TheSchilk/psMCU/README.md

# psMCU
### Philipp Schilk, 2020-2021

An 8-bit, 1MHz processor built from individual logic gates, featuring a
custom ISA and assembler.
