TheSchilk/psMCU/DevUtils/SyntaxHighlighting/Notepad++/INSTALLATION.md

# Installation
In Notepad++: Language->Define your own language...->Import
