TheSchilk/psMCU/DevUtils/SyntaxHighlighting/vim/INSTALLATION.md

# Installation
Place 'psasm.vim' from syntax/ in ~/.vim/syntax/
Place 'psasm.vim' from ftdetect/ in ~/.vim/ftdetect
