TheSchilk/psMCU/Doc/InstructionSet.ods

Mnm. | Brief | 15 | 14 | 13 | 12 | 11 | 10 | 9 | 8 | 7 | 6 | 5 | 4 | 3 | 2 | 1 | 0
JMP | Jump to PC + Offset | 1 | 1 | Adr Ofs.
CALL | Jump PC + Offset and push return to stack | 1 | 0 | Adr Ofs.
IFS | If bit set in memory (else skip) | 0 | 1 | 1 | 1 | Bit |  |  | Adr
IFR | If bit reset in memory (else skip) | 0 | 1 | 1 | 0 | Bit |  |  | Adr
LDA | Load from memory adr to A | 0 | 1 | 0 | 1 | 1 | 1 | 1 | Adr
LDB | Load from memory adr to B | 0 | 1 | 0 | 1 | 1 | 1 | 0 | Adr
LDO | Load from memory adr + B to A | 0 | 1 | 0 | 1 | 1 | 0 | 1 | Adr
SVA | Save A to memory adr | 0 | 1 | 0 | 1 | 1 | 0 | 0 | Adr
SVB | Save B to memory adr | 0 | 1 | 0 | 1 | 0 | 1 | 1 | Adr
SVO | Save A to memory adr + B | 0 | 1 | 0 | 1 | 0 | 1 | 0 | Adr
GROW | Grow stack | 0 | 1 | 0 | 1 | 0 | 0 | 1 | Adr
SHRINK | Shrink stack | 0 | 1 | 0 | 1 | 0 | 0 | 0 | Adr
STLA | Load to A from stack with offset | 0 | 1 | 0 | 0 | 1 | 1 | 1 | Adr
STLB | Load to B from stack with offset | 0 | 1 | 0 | 0 | 1 | 1 | 0 | Adr
STLO | Load to A from stack with offset + B | 0 | 1 | 0 | 0 | 1 | 0 | 1 | Adr
STSA | Save A to stack with offset | 0 | 1 | 0 | 0 | 1 | 0 | 0 | Adr
STSB | Save B to stack with offset | 0 | 1 | 0 | 0 | 0 | 1 | 1 | Adr
STSO | Save A to stack with offset + B | 0 | 1 | 0 | 0 | 0 | 1 | 0 | Adr
SHFTL(L) | Shift A left by B/literal | 0 | 1 | 0 | 0 | 0 | 0 | 1 | L | Data
SHFTL(L)C | Shift A left by B/literal with carry | 0 | 1 | 0 | 0 | 0 | 0 | 0 | L | Data
SHFTR(L) | Shift A right by B/literal | 0 | 0 | 1 | 1 | 1 | 1 | 1 | L | Data
SHFTR(L)C | Shift A right by B/literal with carry | 0 | 0 | 1 | 1 | 1 | 1 | 0 | L | Data
ADD(L) | Add B/literal to A | 0 | 0 | 1 | 1 | 1 | 0 | 1 | L | Data
ADD(L)C | Add B/literal to A with carry | 0 | 0 | 1 | 1 | 1 | 0 | 0 | L | Data
AND(L) | AND B/literal to A | 0 | 0 | 1 | 1 | 0 | 1 | 1 | L | Data
OR(L) | OR B/literal to A | 0 | 0 | 1 | 1 | 0 | 1 | 0 | L | Data
XOR(L) | XOR B/literal to A | 0 | 0 | 1 | 1 | 0 | 0 | 1 | L | Data
ADDLA | Add literal to A | 0 | 0 | 1 | 1 | 0 | 0 | 0 | 1 | Data
ADDLAC | Add literal to A with carry | 0 | 0 | 1 | 1 | 0 | 0 | 0 | 0 | Data
ADDLB | Add literal to B | 0 | 0 | 1 | 0 | 1 | 1 | 1 | 1 | Data
ADDLBC | Add literal to B with carry | 0 | 0 | 1 | 0 | 1 | 1 | 1 | 0 | Data
SUB | Subtract B from A | 0 | 0 | 1 | 0 | 1 | 1 | 0 | 1 | Data
SUBC | Subtract B from A with carry | 0 | 0 | 1 | 0 | 1 | 1 | 0 | 0 | Data
LITA | Load literal to A | 0 | 0 | 1 | 0 | 1 | 0 | 1 | 1 | Data
LITB | Load literal to B | 0 | 0 | 1 | 0 | 1 | 0 | 1 | 0 | Data
DATA5 | Load 5 data bytes to stack | 0 | 0 | 1 | 0 | 1 | 0 | 0 | 1 | Data
DATA4 | Load 4 data bytes to stack | 0 | 0 | 1 | 0 | 1 | 0 | 0 | Adr
GROWO | Grow stack by Adr + B | 0 | 0 | 1 | 0 | 0 | 1 | 1 | Adr
SHRINKO | Shrink stack by Adr + B | 0 | 0 | 1 | 0 | 0 | 1 | 0 | Adr
(Unused: NOP) |  | 0 | 0 | 1 | 0 | 0 | 0 | 1 | 1 | x | x | x | x | x | x | x | x
MULT | Calculate A*B, store in A (LSB) and B (MSB) | 0 | 0 | 1 | 0 | 0 | 0 | 1 | 0 | x | x | x | x | x | x | x | x
COMPA | Two's complement A | 0 | 0 | 1 | 0 | 0 | 0 | 0 | 1 | x | x | x | x | x | x | x | x
COMPAC | Two's complement A with carry | 0 | 0 | 1 | 0 | 0 | 0 | 0 | 0 | x | x | x | x | x | x | x | x
IFSA | If bit set in A (else skip) | 0 | 0 | 0 | 1 | Bit |  |  | 1 | x | x | x | x | x | x | x | x
IFRA | If bit reset in A (else skip) | 0 | 0 | 0 | 1 | Bit |  |  | 0 | x | x | x | x | x | x | x | x
COMPB | Two's complement B | 0 | 0 | 0 | 0 | 1 | 1 | 1 | 1 | x | x | x | x | x | x | x | x
COMPBC | Two's complement B with carry | 0 | 0 | 0 | 0 | 1 | 1 | 1 | 0 | x | x | x | x | x | x | x | x
NOTA | Invert A | 0 | 0 | 0 | 0 | 1 | 1 | 0 | 1 | x | x | x | x | x | x | x | x
NOTB | Invert B | 0 | 0 | 0 | 0 | 1 | 1 | 0 | 0 | x | x | x | x | x | x | x | x
POPA | Pop from stack to A | 0 | 0 | 0 | 0 | 1 | 0 | 1 | 1 | x | x | x | x | x | x | x | x
POPB | Pop from stack to B | 0 | 0 | 0 | 0 | 1 | 0 | 1 | 0 | x | x | x | x | x | x | x | x
PUSHA | Push A to stack | 0 | 0 | 0 | 0 | 1 | 0 | 0 | 1 | x | x | x | x | x | x | x | x
PUSHB | Push B to stack | 0 | 0 | 0 | 0 | 1 | 0 | 0 | 0 | x | x | x | x | x | x | x | x
SWP | Swap A and B | 0 | 0 | 0 | 0 | 0 | 1 | 1 | 1 | x | x | x | x | x | x | x | x
CPYA | Copy A to B | 0 | 0 | 0 | 0 | 0 | 1 | 1 | 0 | x | x | x | x | x | x | x | x
CPYB | Copy B to A | 0 | 0 | 0 | 0 | 0 | 1 | 0 | 1 | x | x | x | x | x | x | x | x
INTRPT | Trigger an interrupt | 0 | 0 | 0 | 0 | 0 | 1 | 0 | 0 | x | x | x | x | x | x | x | x
RTRNI | Return from interrupt | 0 | 0 | 0 | 0 | 0 | 0 | 1 | 1 | x | x | x | x | x | x | x | x
RTRN | Return from call | 0 | 0 | 0 | 0 | 0 | 0 | 1 | 0 | x | x | x | x | x | x | x | x
HALT | Halt exectuion | 0 | 0 | 0 | 0 | 0 | 0 | 0 | 1 | x | x | x | x | x | x | x | x
NOP | No operation | 0 | 0 | 0 | 0 | 0 | 0 | 0 | 0 | x | x | x | x | x | x | x | x
Fixed Connections:
ROM Adr. Offset |  |  |  | Adr
RAM Adr |  |  |  |  |  |  |  |  | Adr
Literal |  |  |  |  |  |  |  |  |  | Data
ROM Data |  | Data |  |  |  |  |  |  |  | Data
Conditional |  |  |  |  |  | Bit
