TheSchilk/psMCU/ECAD/periph_8x8leds/schematic_periph_8x8leds.pdf

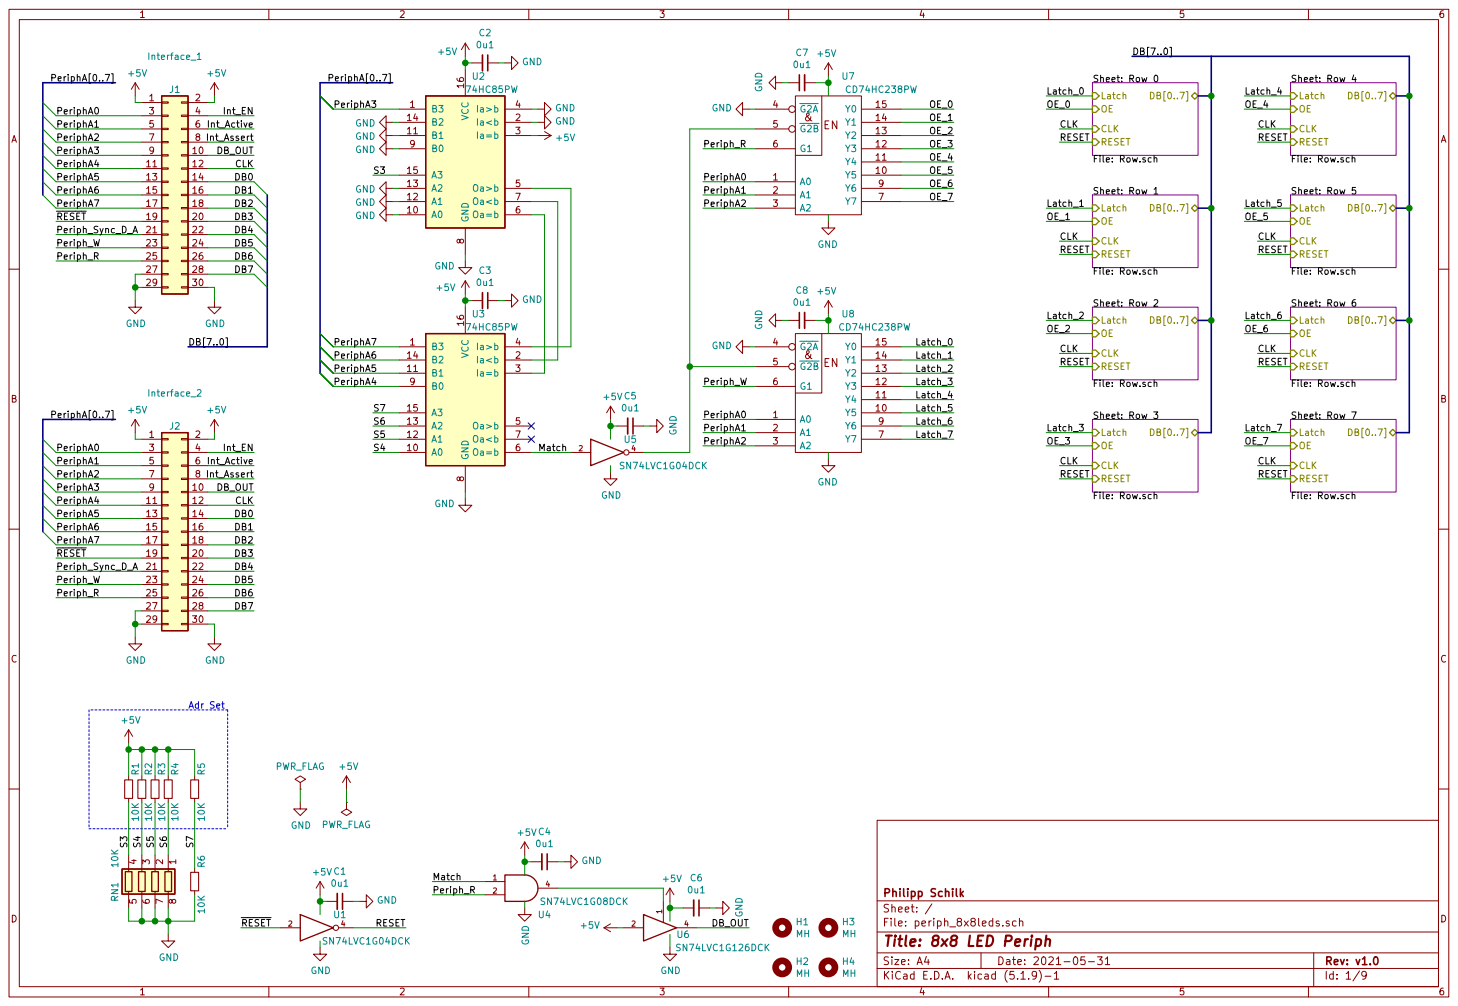
[picture p1: page 1]

Sheet: Row 0 File: Row.sch OE

Sheet: Row 4 File: Row.sch OE

Sheet: Row 1 File: Row.sch OE

Sheet: Row 5 File: Row.sch OE

Sheet: Row 2 File: Row.sch OE

Sheet: Row 6 File: Row.sch OE

Sheet: Row 3 File: Row.sch OE

Sheet: Row 7 File: Row.sch OE

File: periph_8x8leds.sch Sheet: / Philipp Schilk

Id: 1/9 Title: 8x8 LED Periph

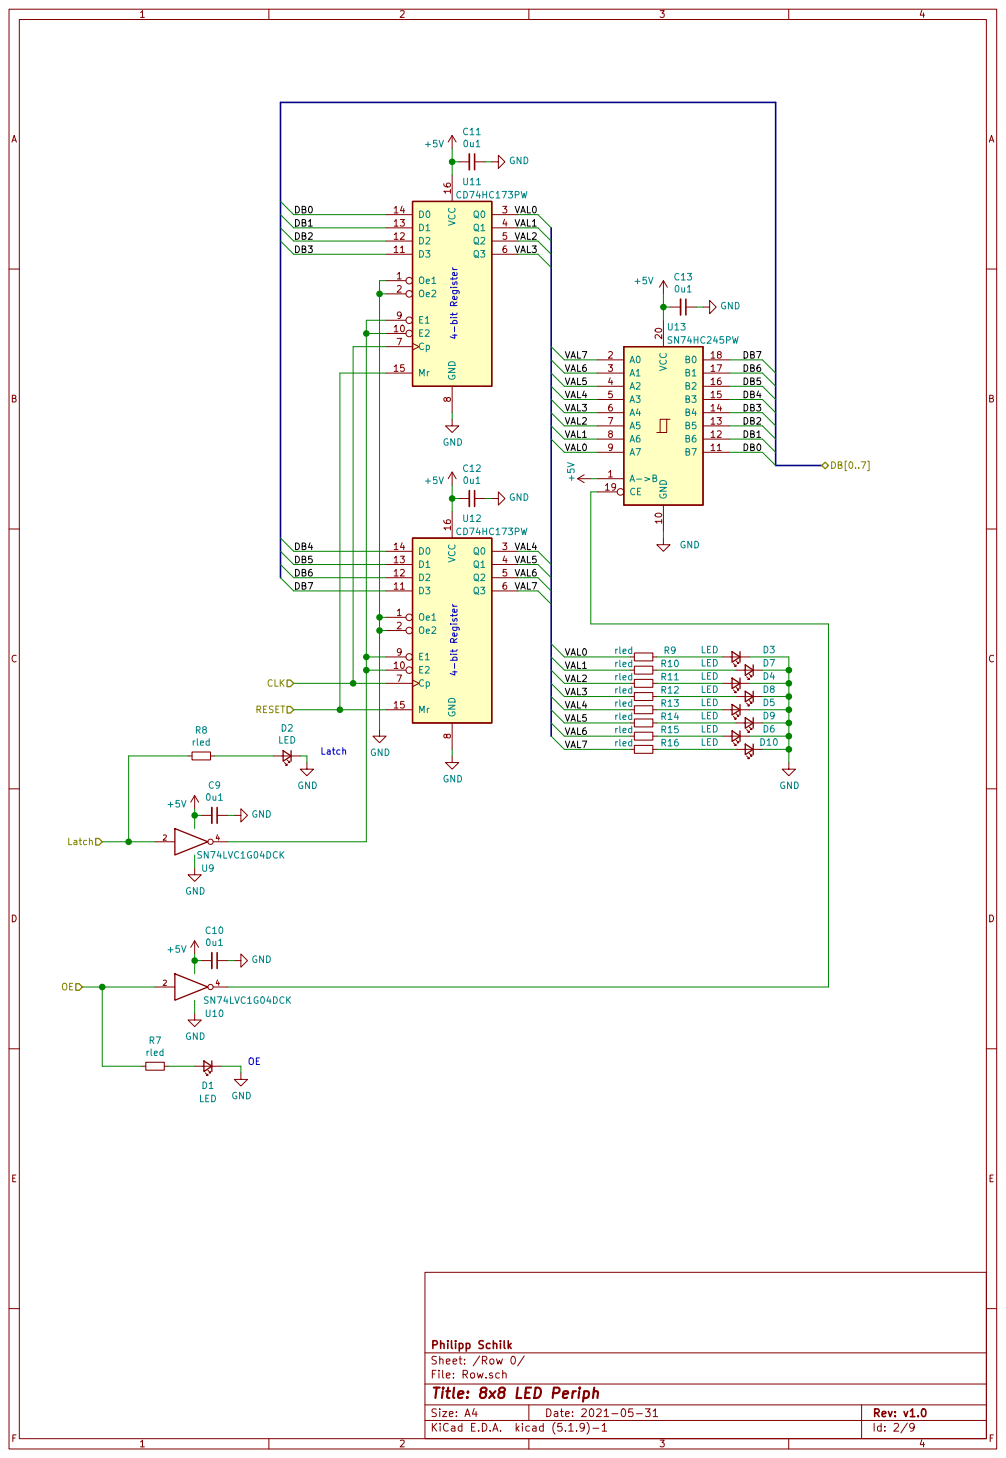
[picture p2: page 2]

File: Row.sch Sheet: /Row 0/ Philipp Schilk

Id: 2/9 Title: 8x8 LED Periph

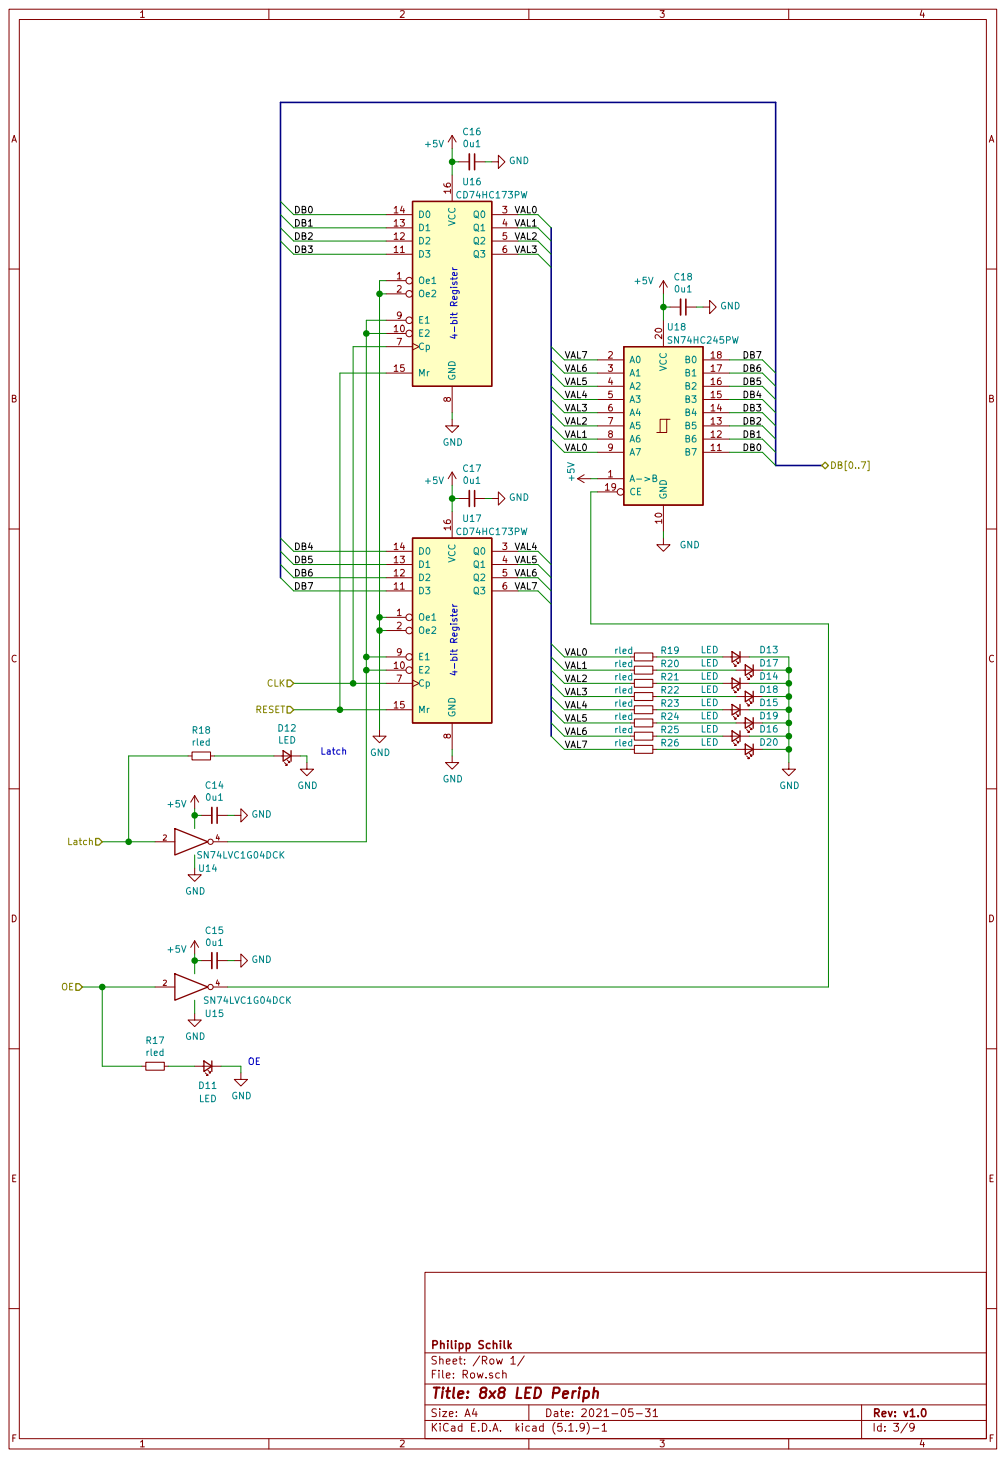
[picture p3: page 3]

File: Row.sch Sheet: /Row 1/ Philipp Schilk

Id: 3/9 Title: 8x8 LED Periph

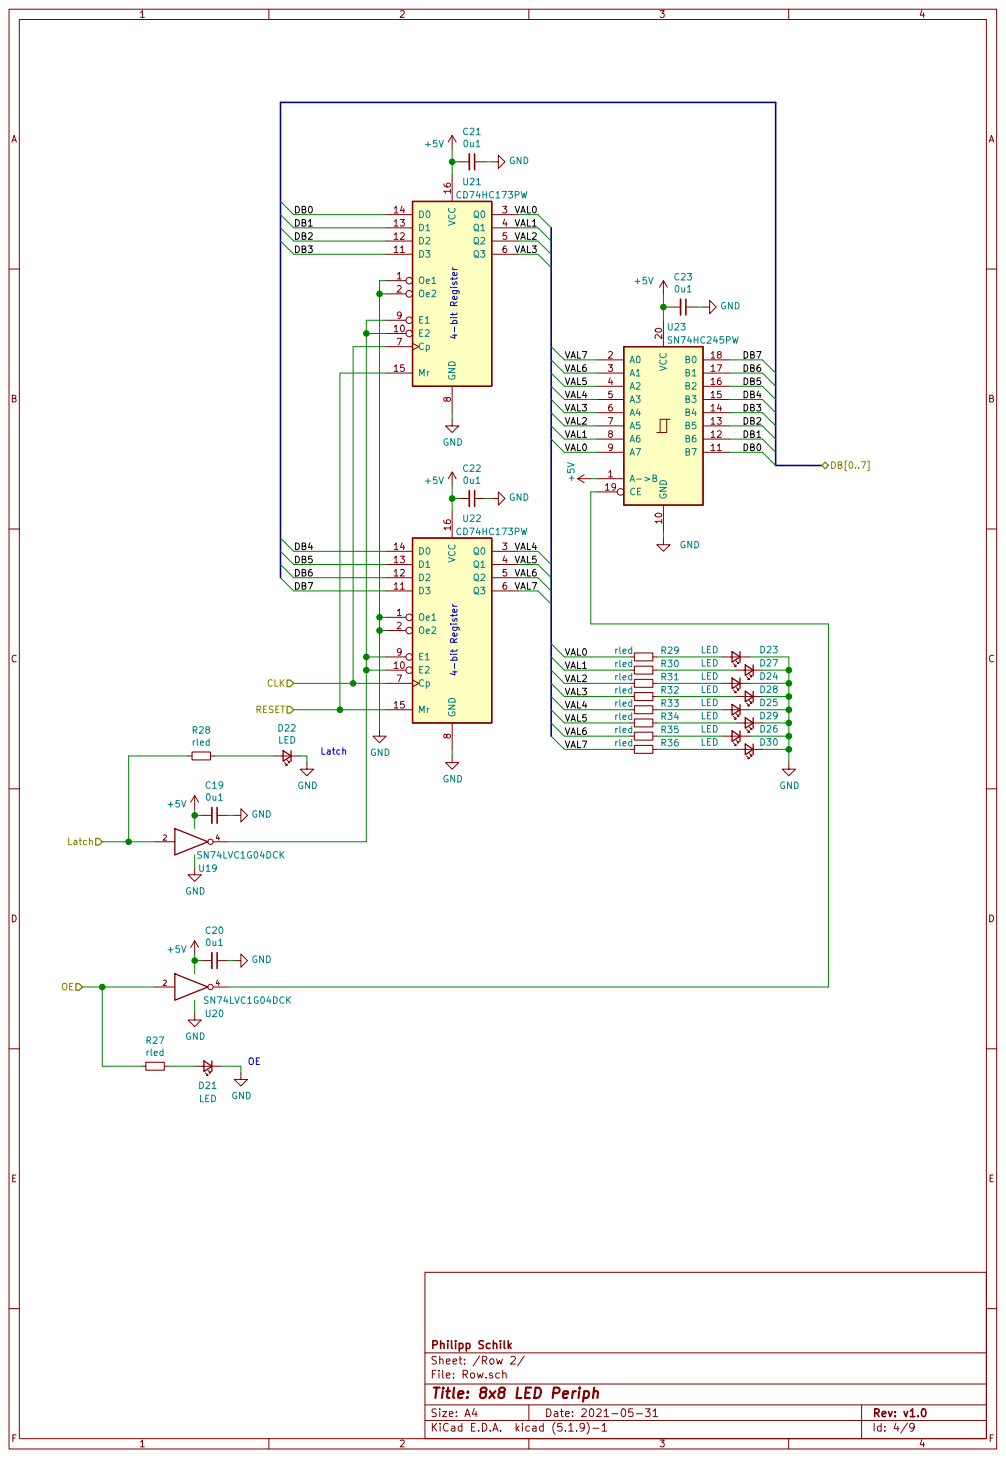
[picture p4: page 4]

File: Row.sch Sheet: /Row 2/ Philipp Schilk

Id: 4/9 Title: 8x8 LED Periph

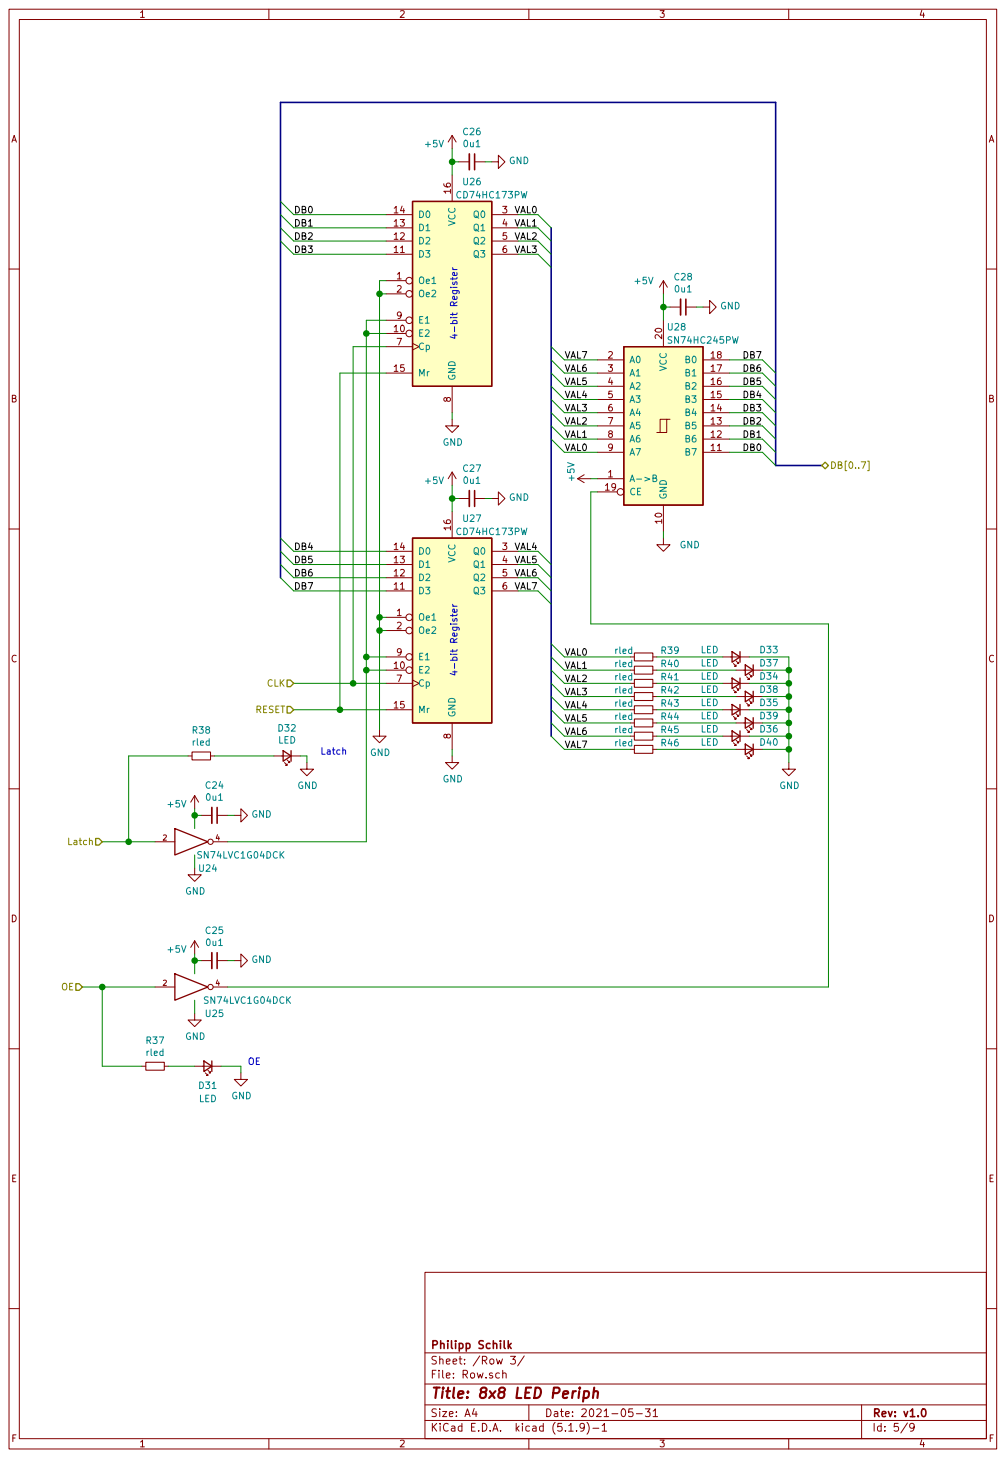
[picture p5: page 5]

File: Row.sch Sheet: /Row 3/ Philipp Schilk

Id: 5/9 Title: 8x8 LED Periph

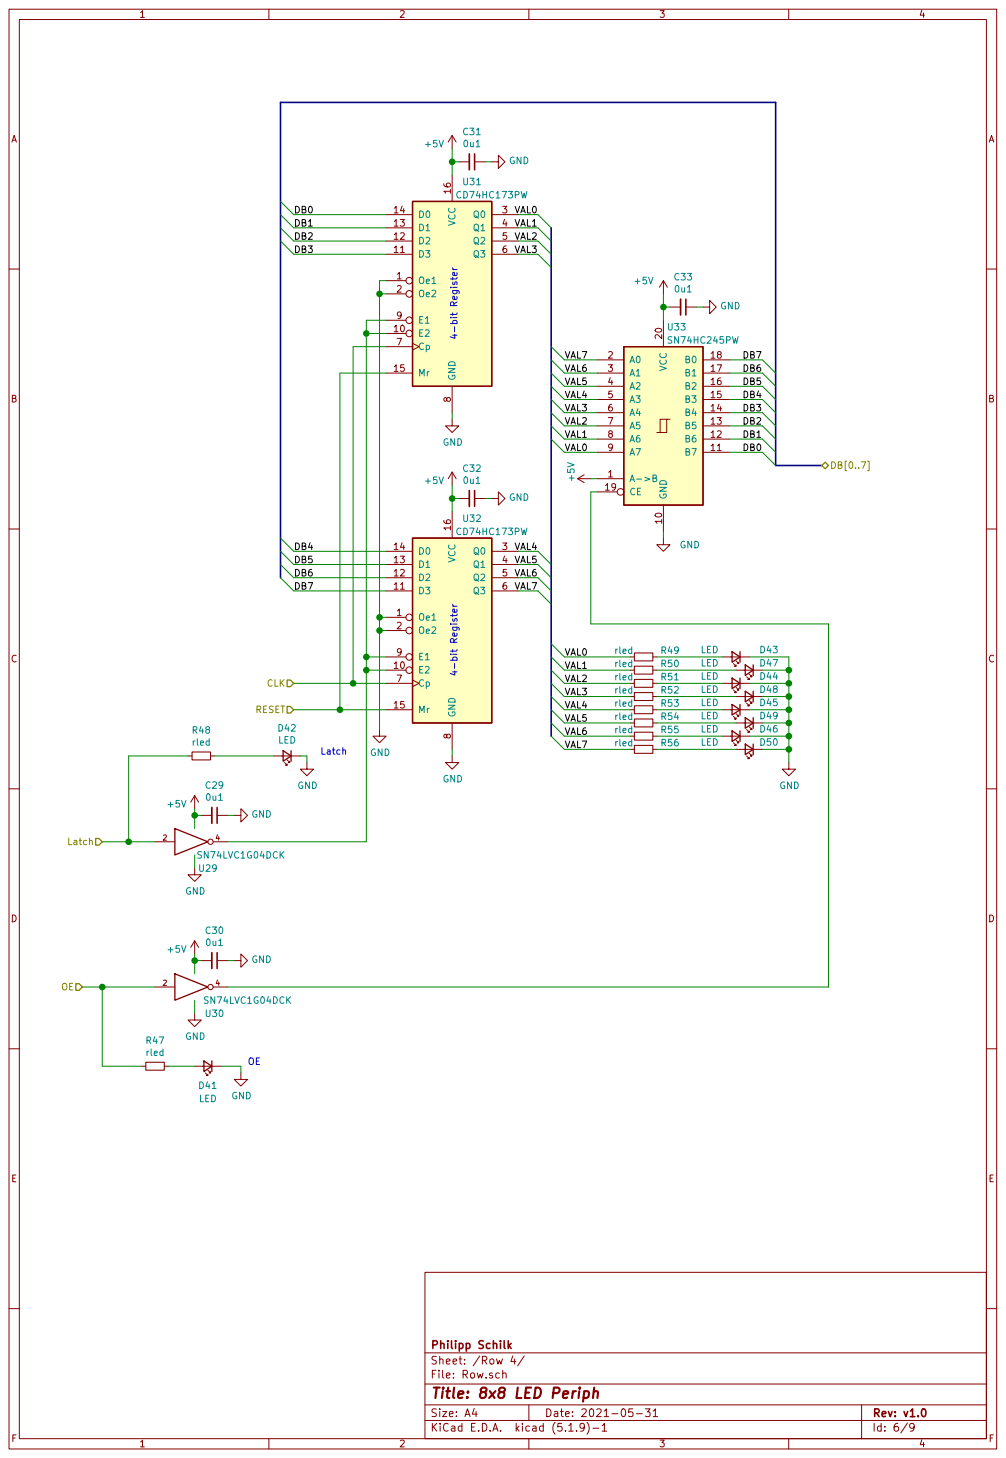
[picture p6: page 6]

File: Row.sch Sheet: /Row 4/ Philipp Schilk

Id: 6/9 Title: 8x8 LED Periph

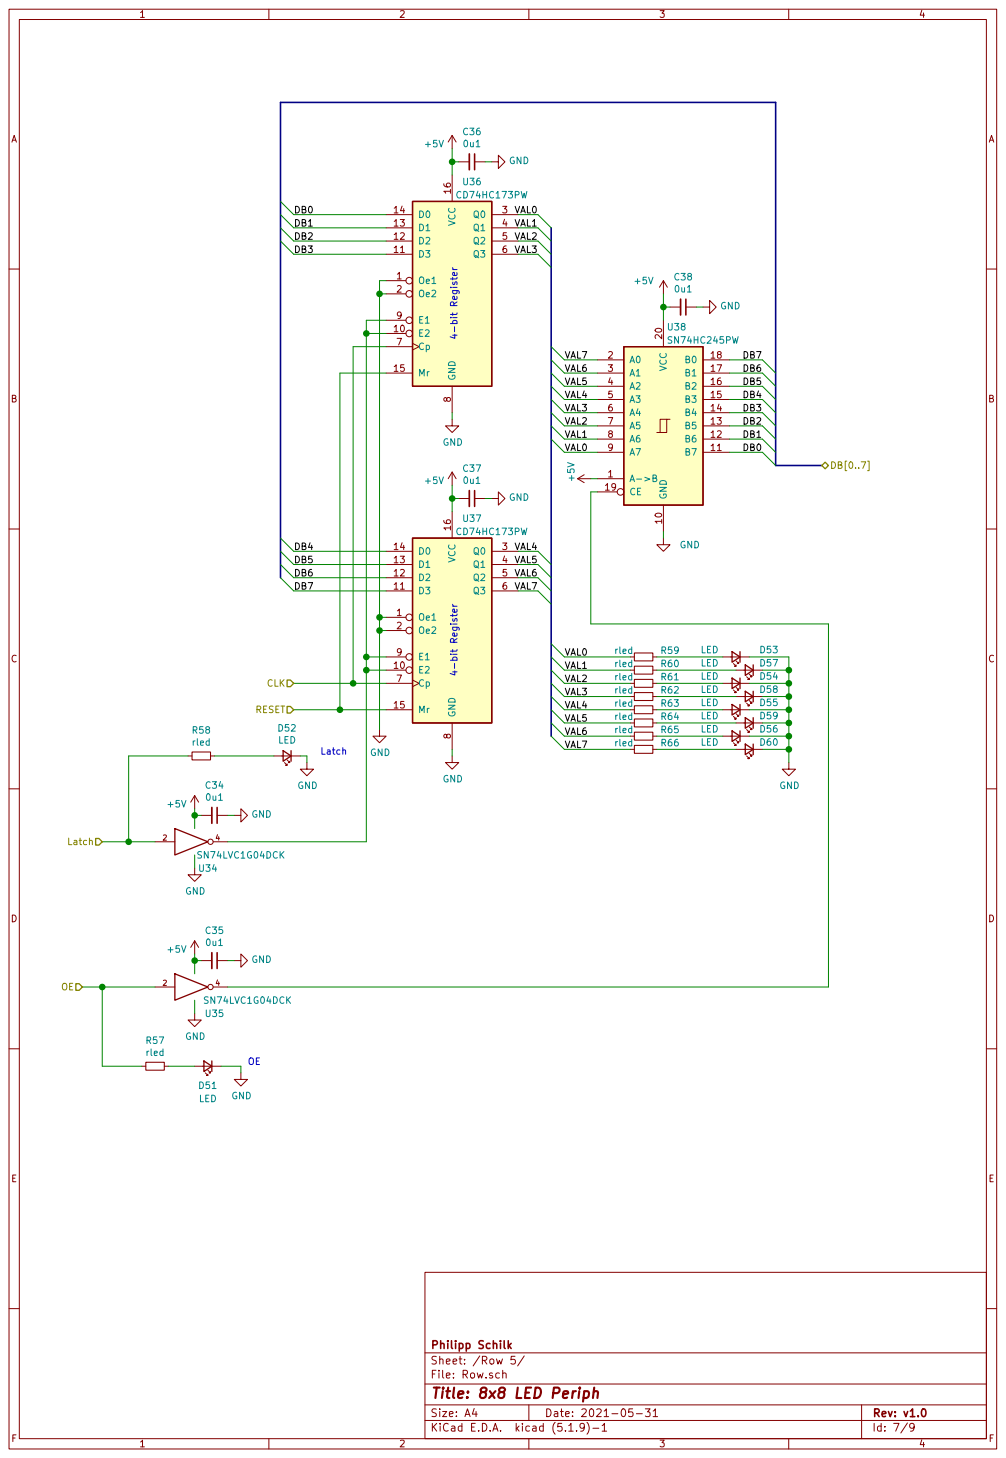
[picture p7: page 7]

File: Row.sch Sheet: /Row 5/ Philipp Schilk

Id: 7/9 Title: 8x8 LED Periph

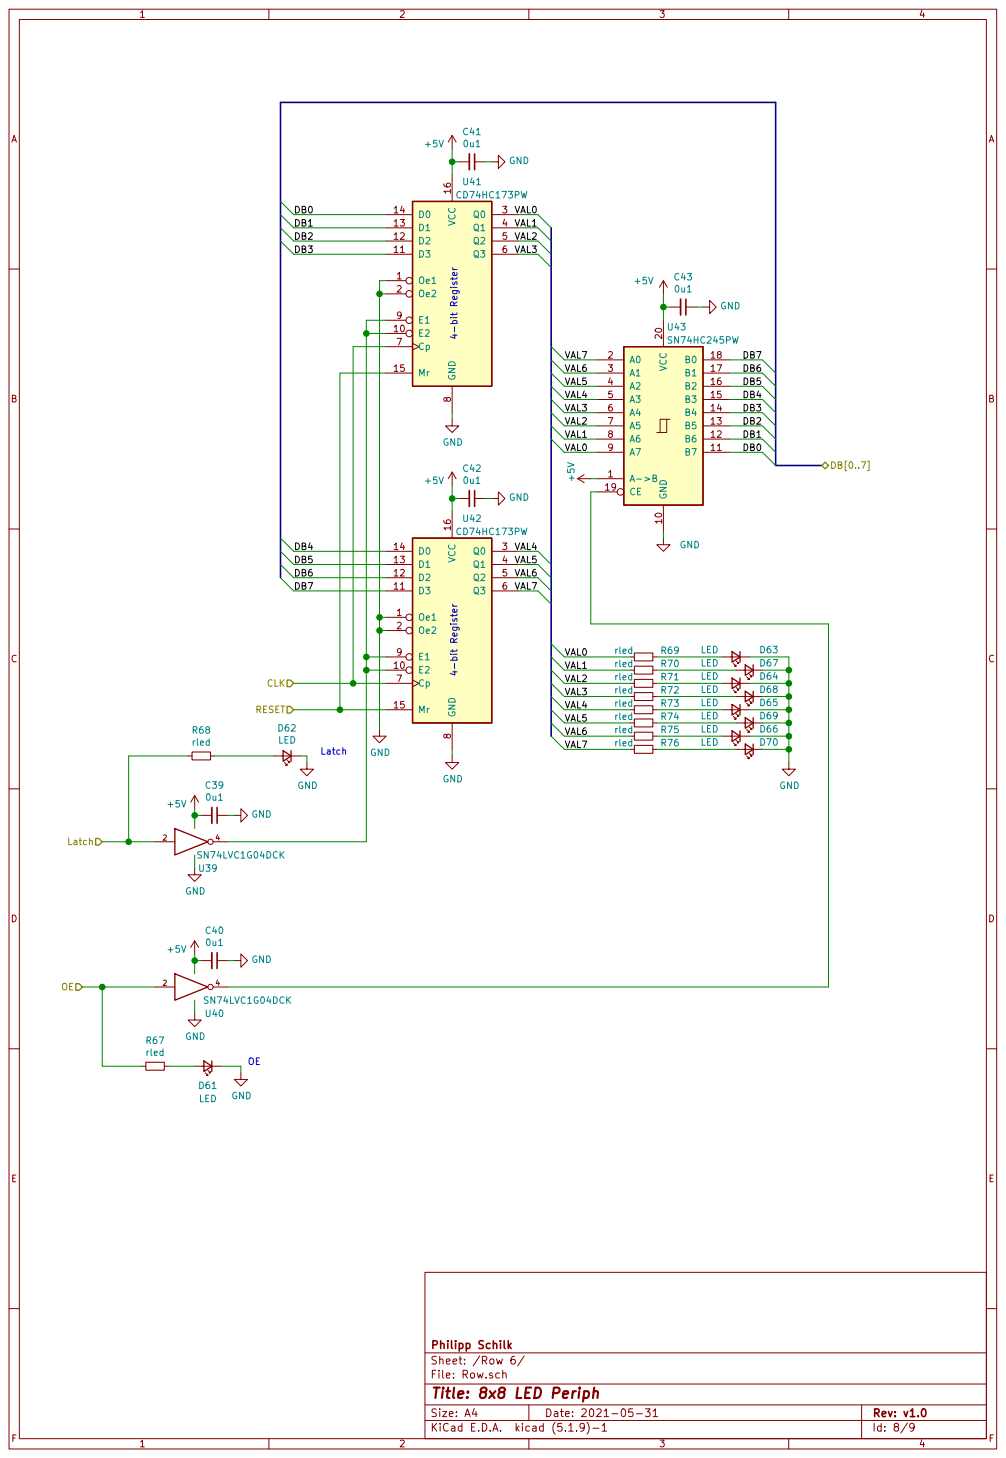
[picture p8: page 8]

File: Row.sch Sheet: /Row 6/ Philipp Schilk

Id: 8/9 Title: 8x8 LED Periph

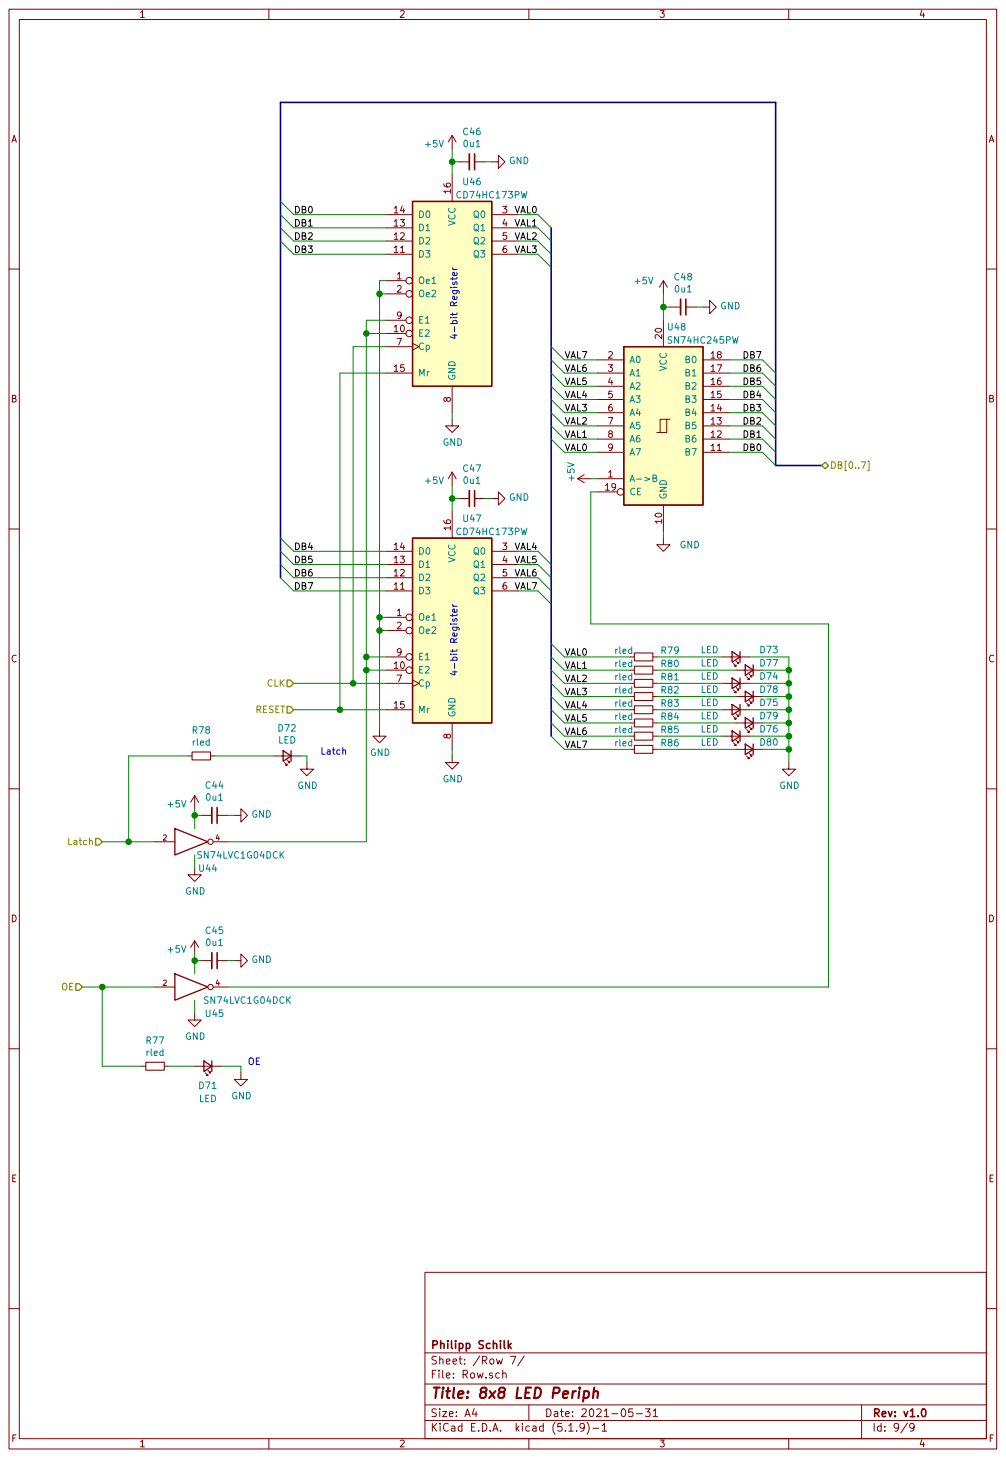
[picture p9: page 9]

File: Row.sch Sheet: /Row 7/ Philipp Schilk

Id: 9/9 Title: 8x8 LED Periph
