TheSchilk/psMCU/ECAD/Programmer/schematic_Programmer.pdf

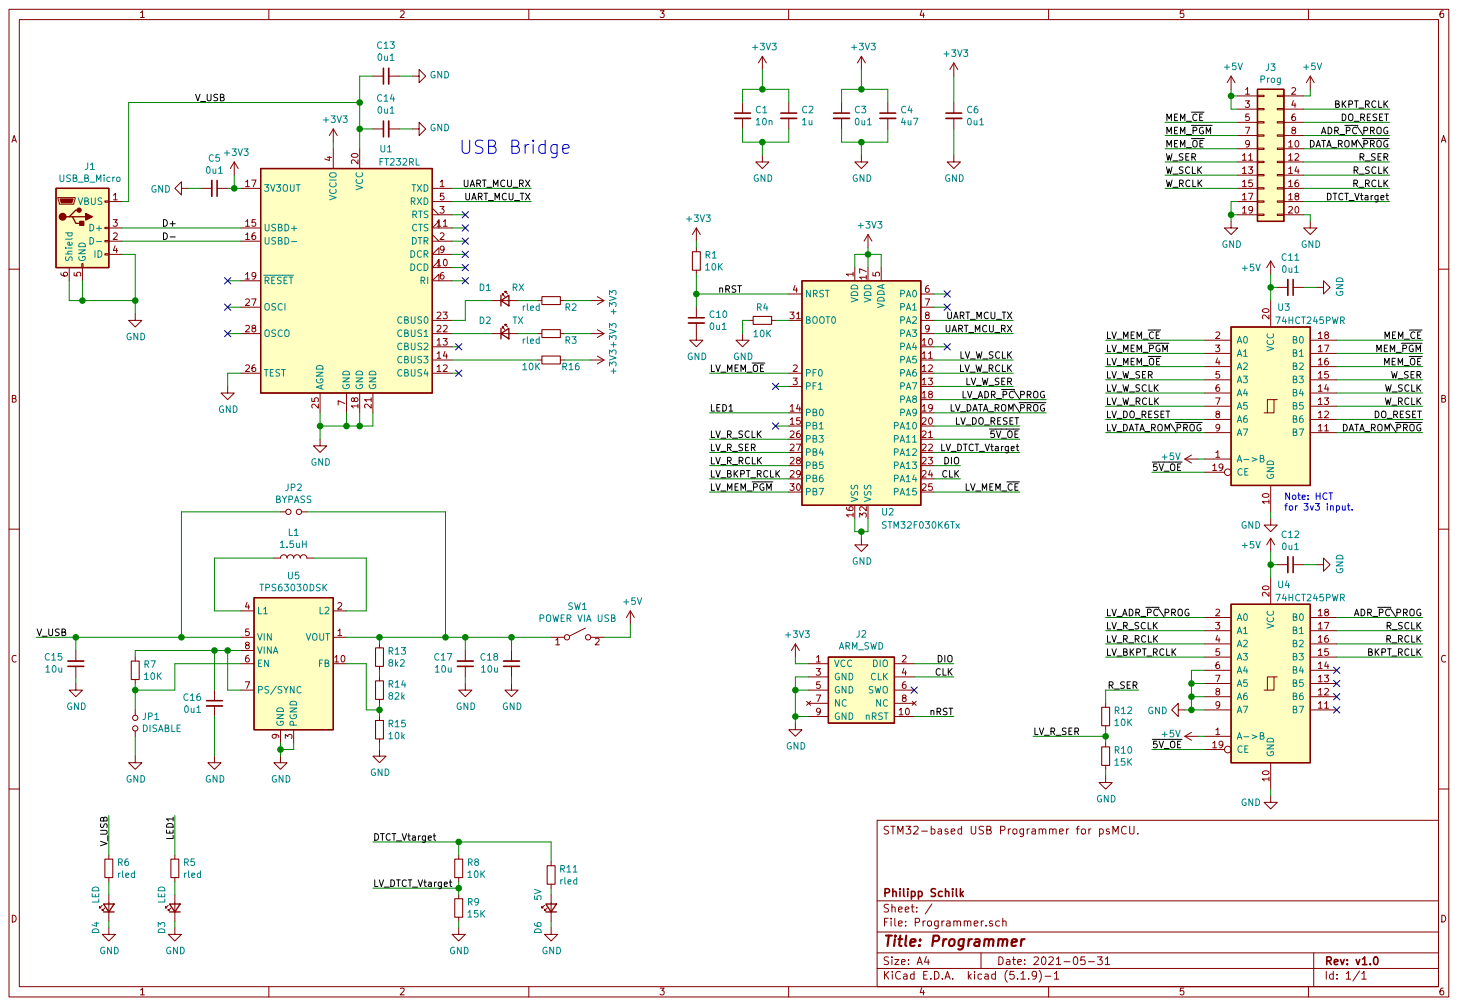
[picture p10: page 1]

1 PA4 10 PA5 11 PA6 12 PA7 13 PB0 14 PB1 15 VSS 16 VDD 17 PA8 18 PA9 19 PF0 2 PA10 20 PA11 21 PA12 22 PA13 23 PA14 24 PA15 25 PB3 26 PB4 27 PB5 28 PB6 29 PF1 3 PB7 30 BOOT0 31 VSS 32 NRST 4 VDDA
CLK UART_MCU_TX UART_MCU_RX

STM32-based USB Programmer for psMCU.

File: Programmer.sch Sheet: / Philipp Schilk
