TheSchilk/psMCU/ECAD/psMCU/schematic_psMCU.pdf

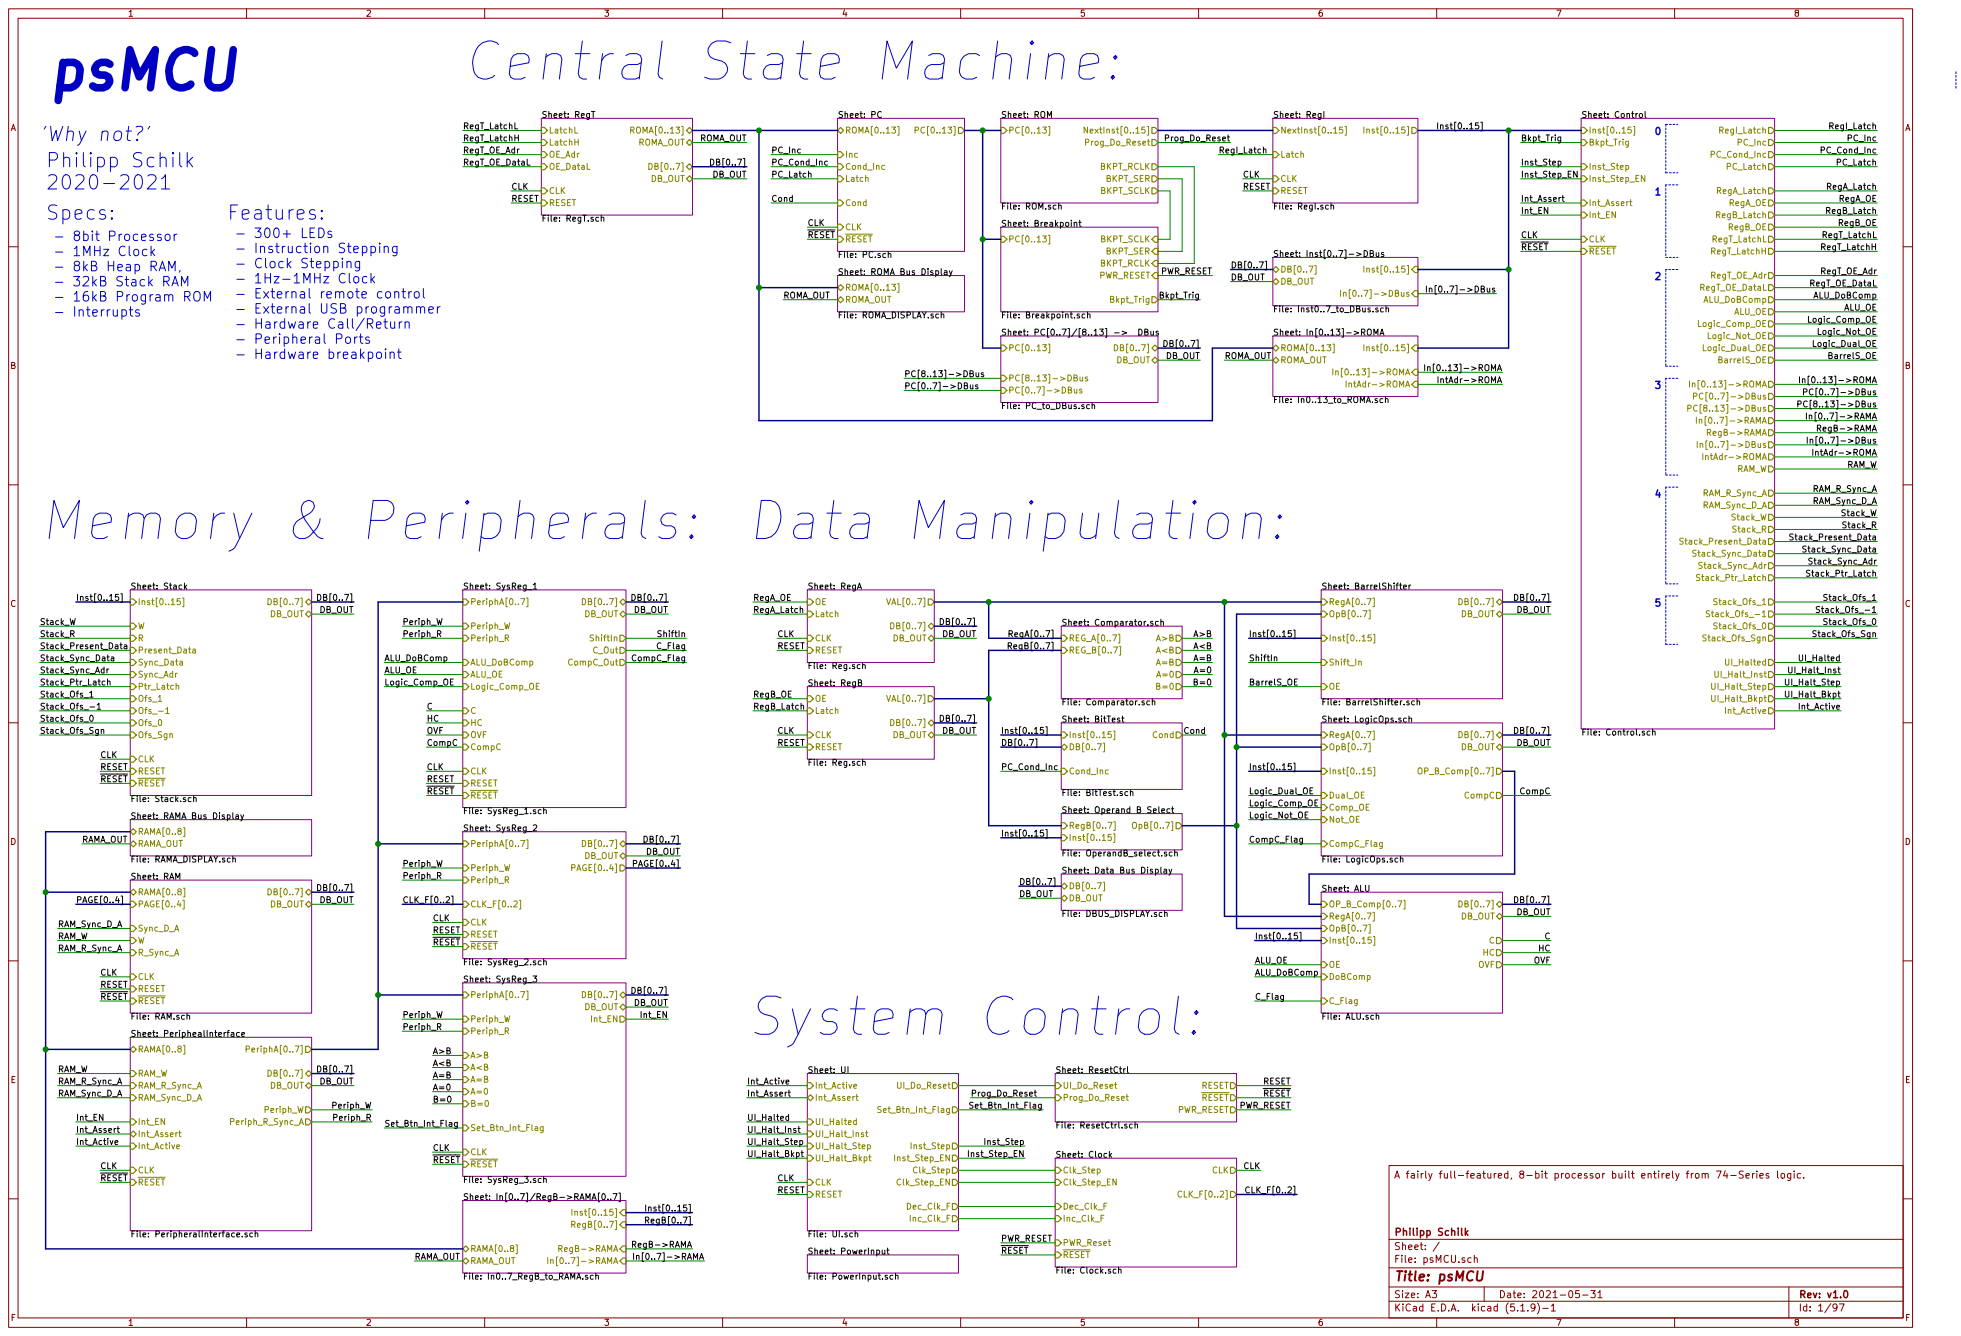
[picture p11: page 1]

Sheet: ROMA Bus Display File: ROMA_DISPLAY.sch ROMA_OUT ROMA[0..13]

File: Breakpoint.sch
Sheet: PC[0..7]/[8..13] -> DBus File: PC_to_DBus.sch PC[0..7]->DBus

PAGE[0..4] RESET PeriphA[0..7] Sheet: RAM

CompC_Flag Sheet: UI File: UI.sch RESET CLK

Inst[0..15]
File: OperandB_select.sch
Sheet: Data Bus Display File: DBUS_DISPLAY.sch DB_OUT DB[0..7]

A fairly full-featured, 8-bit processor built entirely from 74-Series logic.

Sheet: In[0..7]/RegB->RAMA[0..7]

File: psMCU.sch Sheet: / Philipp Schilk

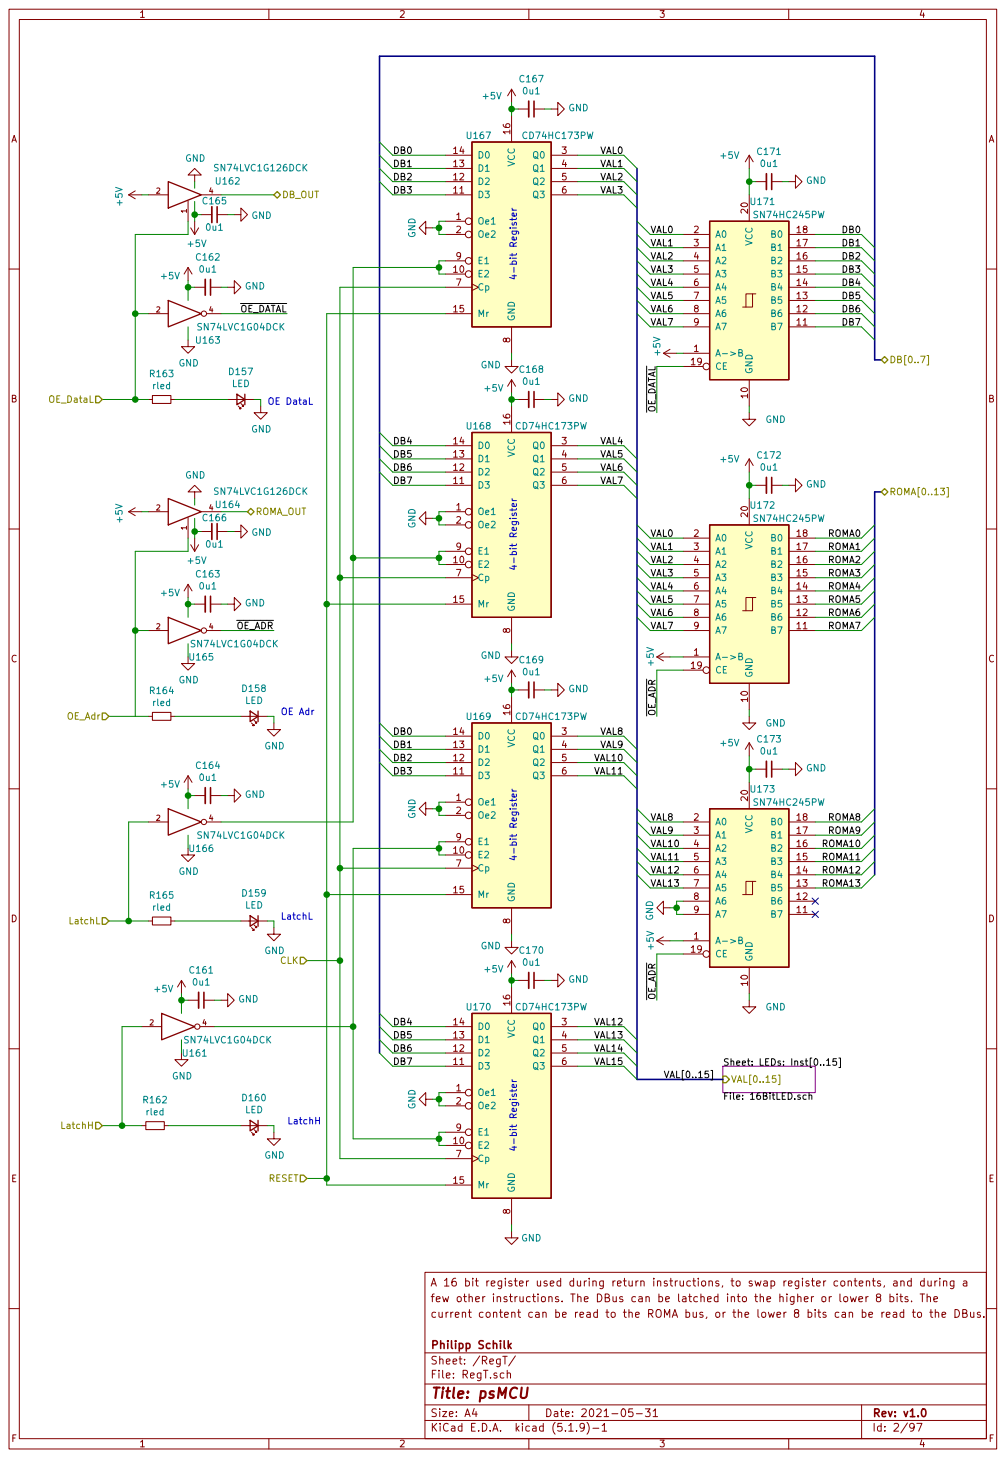
[picture p12: page 2]

Sheet: LEDs: Inst[0..15] File: 16BitLED.sch VAL[0..15] GND

A 16 bit register used during return instructions, to swap register contents, and during a
few other instructions. The DBus can be latched into the higher or lower 8 bits. The
current content can be read to the ROMA bus, or the lower 8 bits can be read to the DBus.

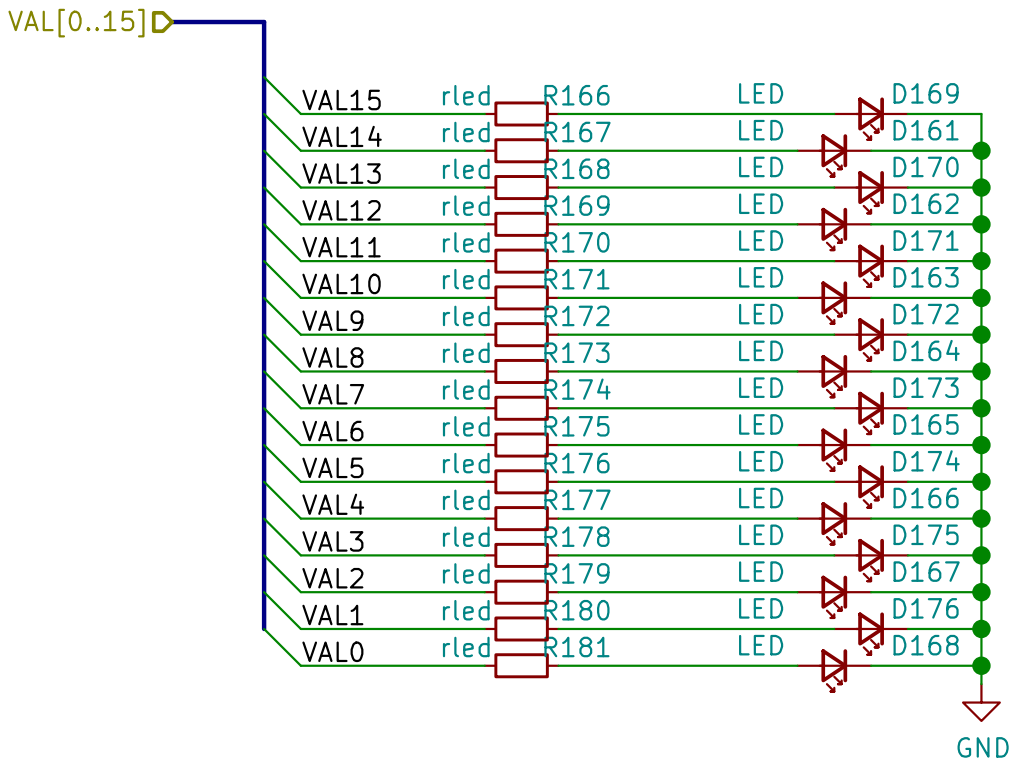
[picture p13: page 3]

Philipp Schilk
File: 16BitLED.sch Sheet: /RegT/LEDs: Inst[0..15]/
Id: 3/97 Title: psMCU

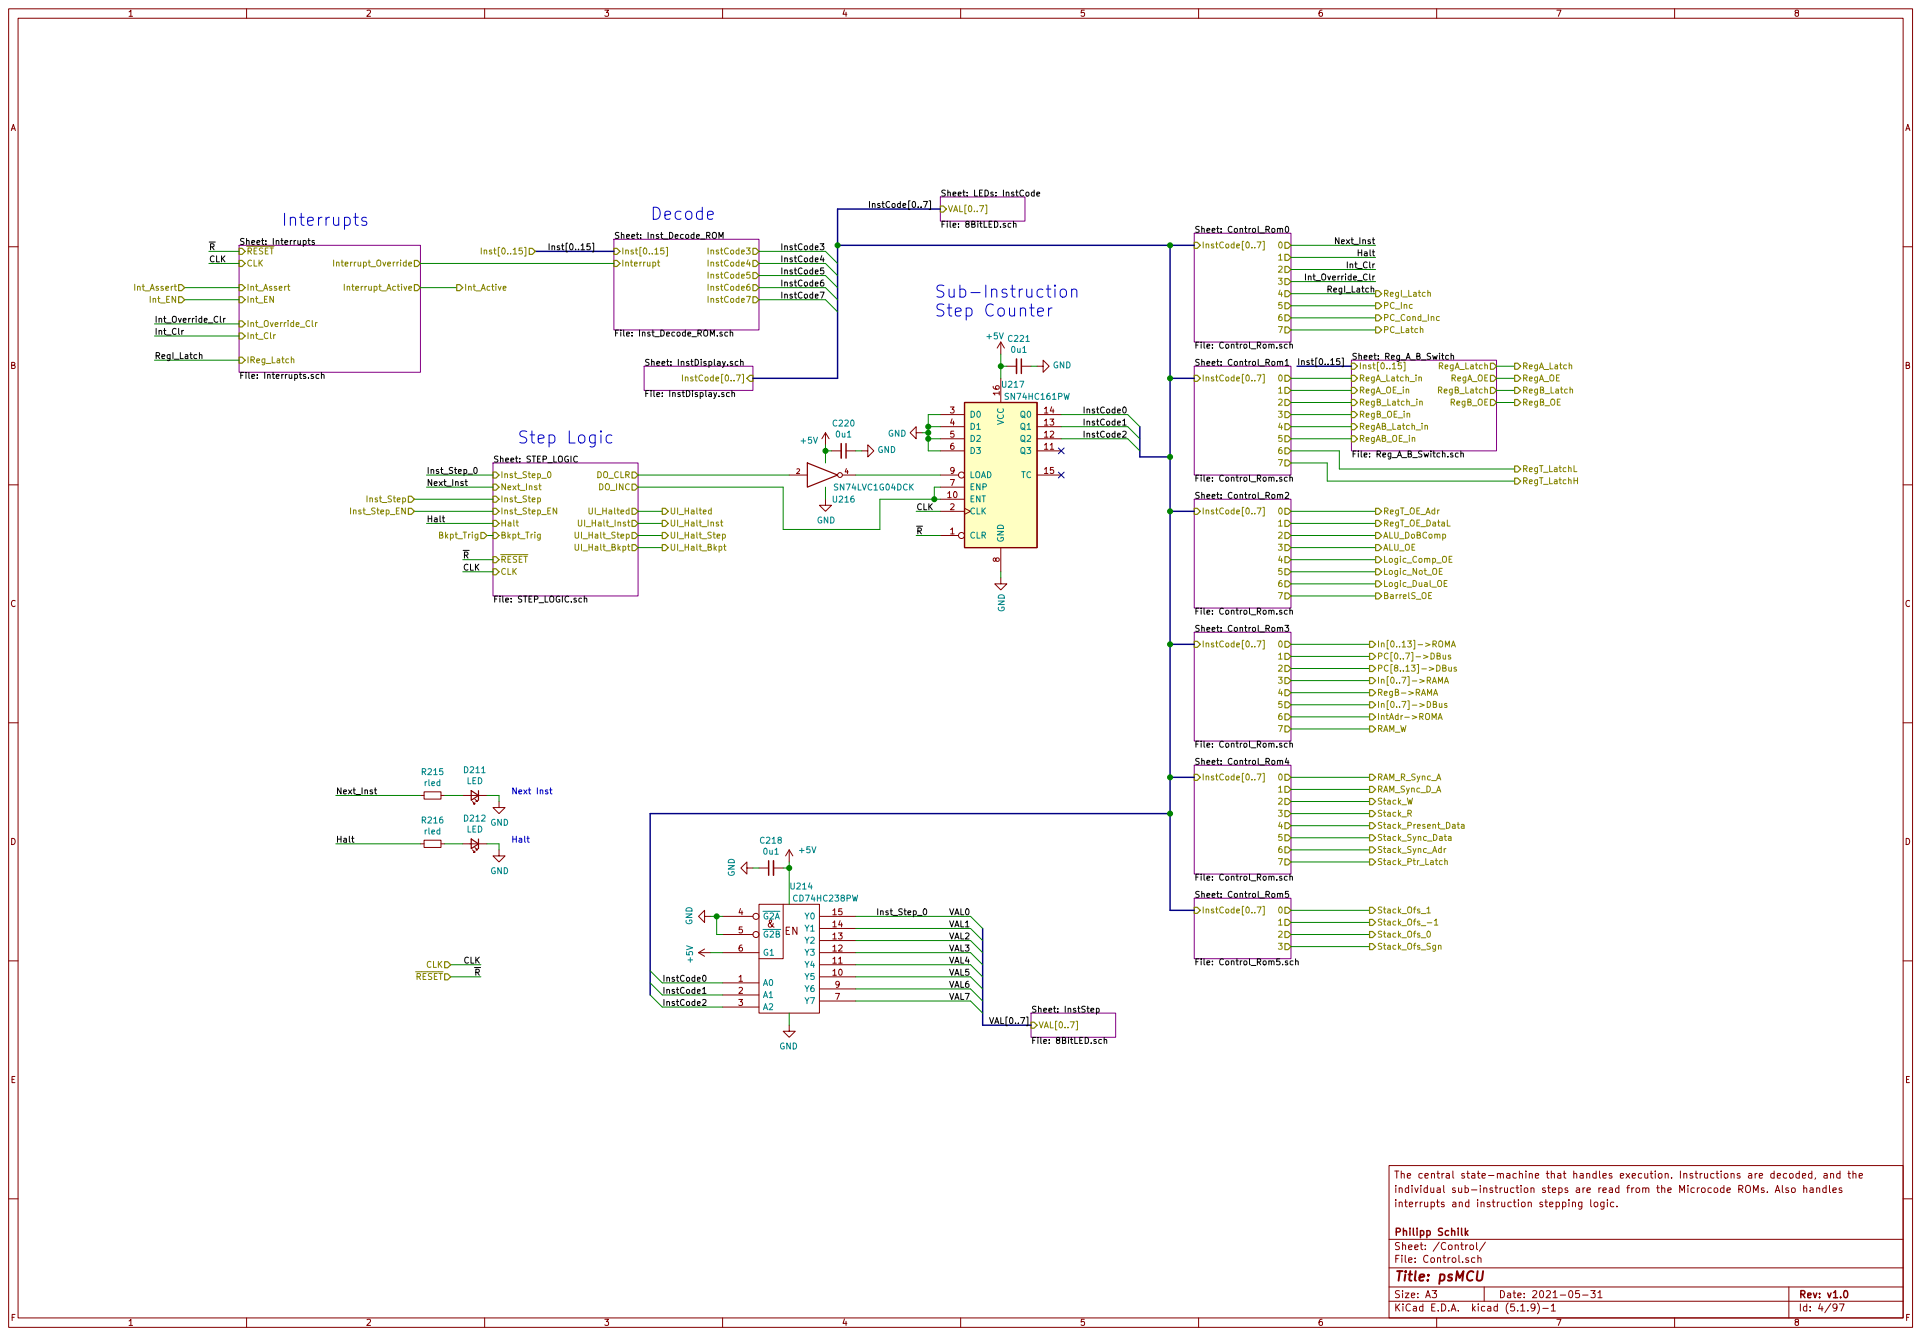
[picture p14: page 4]

In[0..13]->ROMA
PC[0..7]->DBus
PC[8..13]->DBus
In[0..7]->RAMA
IntAdr->ROMA RegB->RAMA
In[0..7]->DBus

Sheet: InstStep File: 8BitLED.sch VAL[0..7]

The central state-machine that handles execution. Instructions are decoded, and the
individual sub-instruction steps are read from the Microcode ROMs. Also handles
interrupts and instruction stepping logic.

File: Control.sch Sheet: /Control/ Philipp Schilk

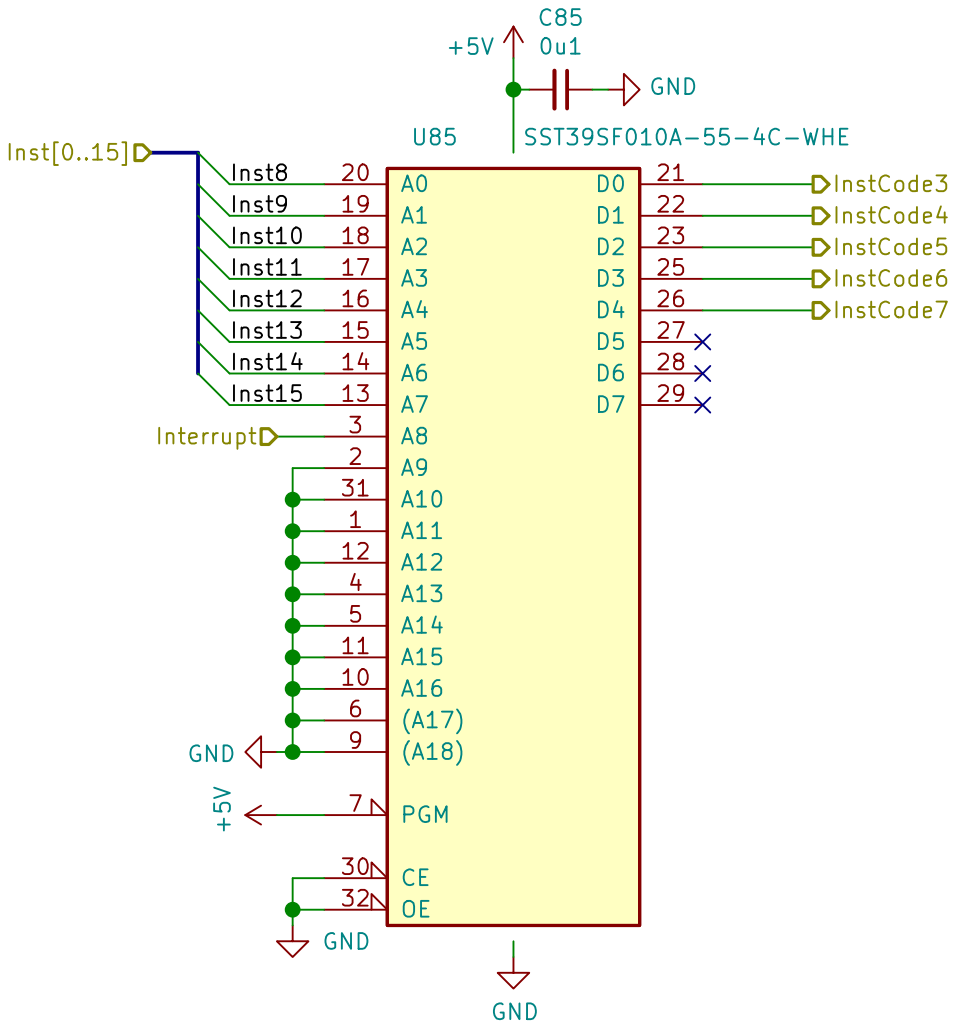
[picture p15: page 5]

Decodes the MSBs of an instruction into the actual instruction code for microcode lookup.

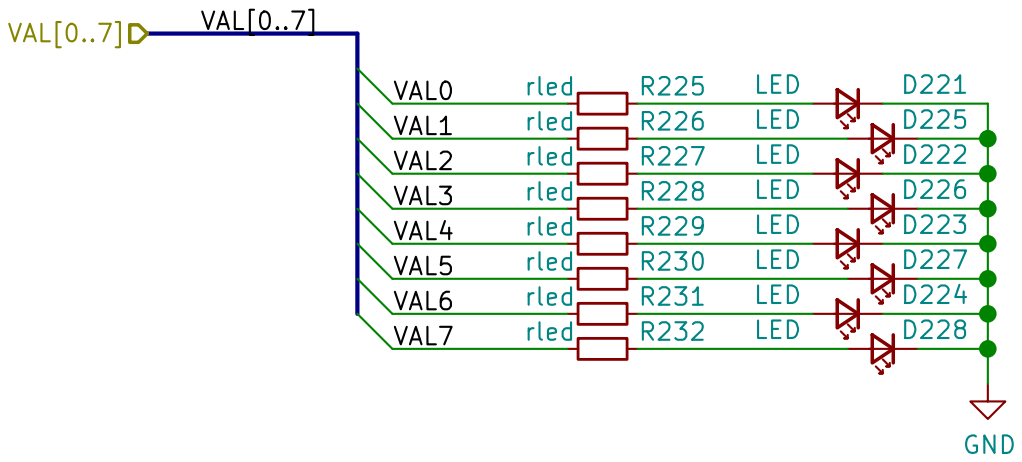
[picture p16: page 6]

File: 8BitLED.sch Sheet: /Control/LEDs: InstCode/ Philipp Schilk

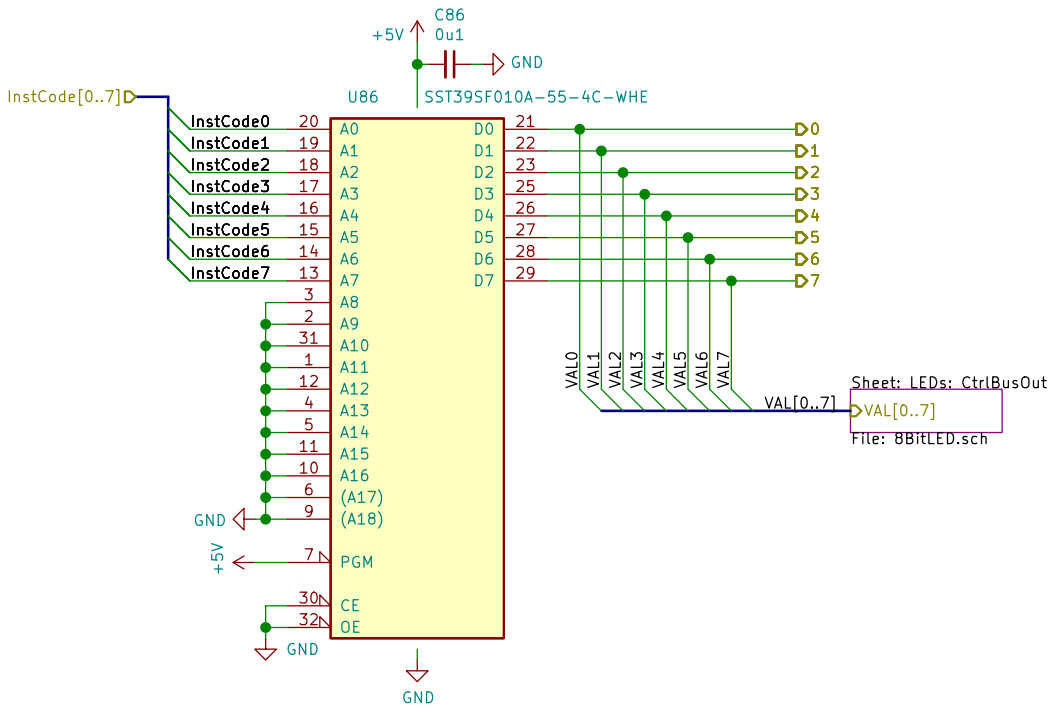
[picture p17: page 7]

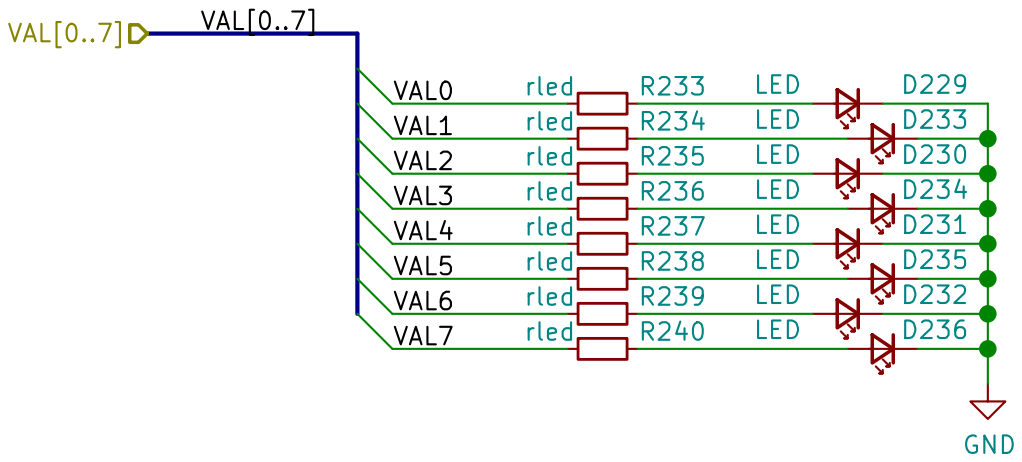
[picture p18: page 8]

Philipp Schilk
File: 8BitLED.sch Sheet: /Control/Control_Rom0/LEDs: CtrlBusOut/
Id: 8/97 Title: psMCU

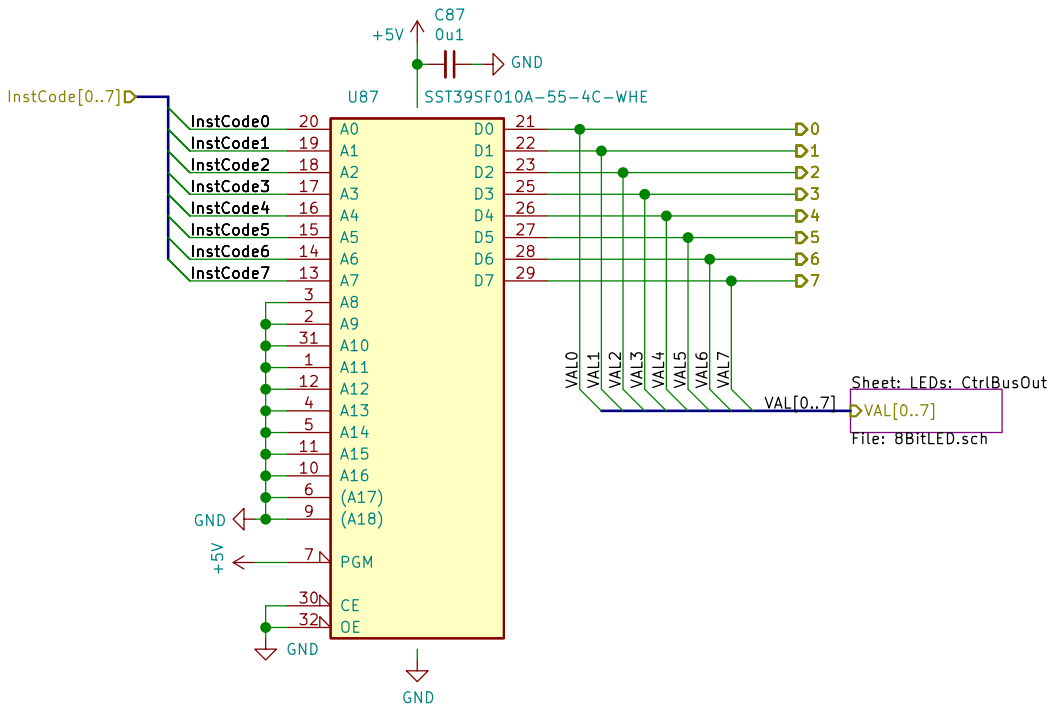
[picture p19: page 9]

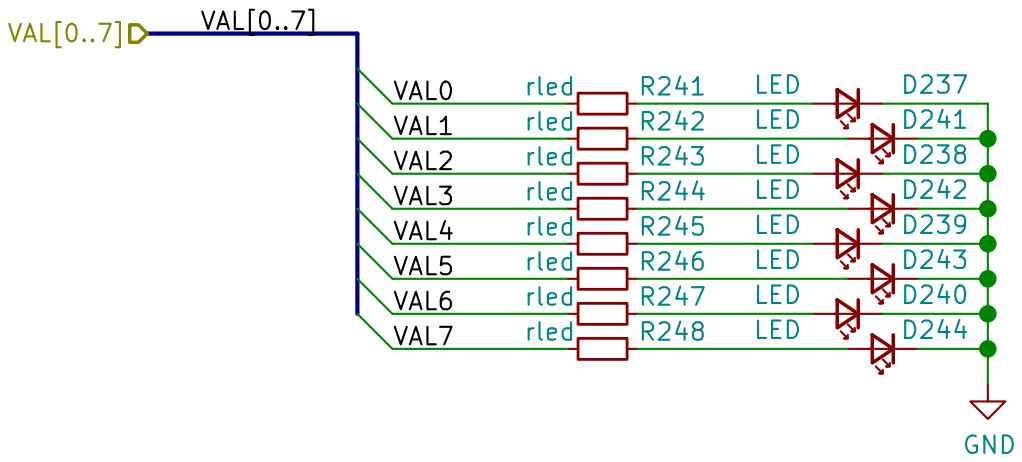
[picture p20: page 10]

Philipp Schilk
File: 8BitLED.sch Sheet: /Control/Control_Rom1/LEDs: CtrlBusOut/
Id: 10/97 Title: psMCU

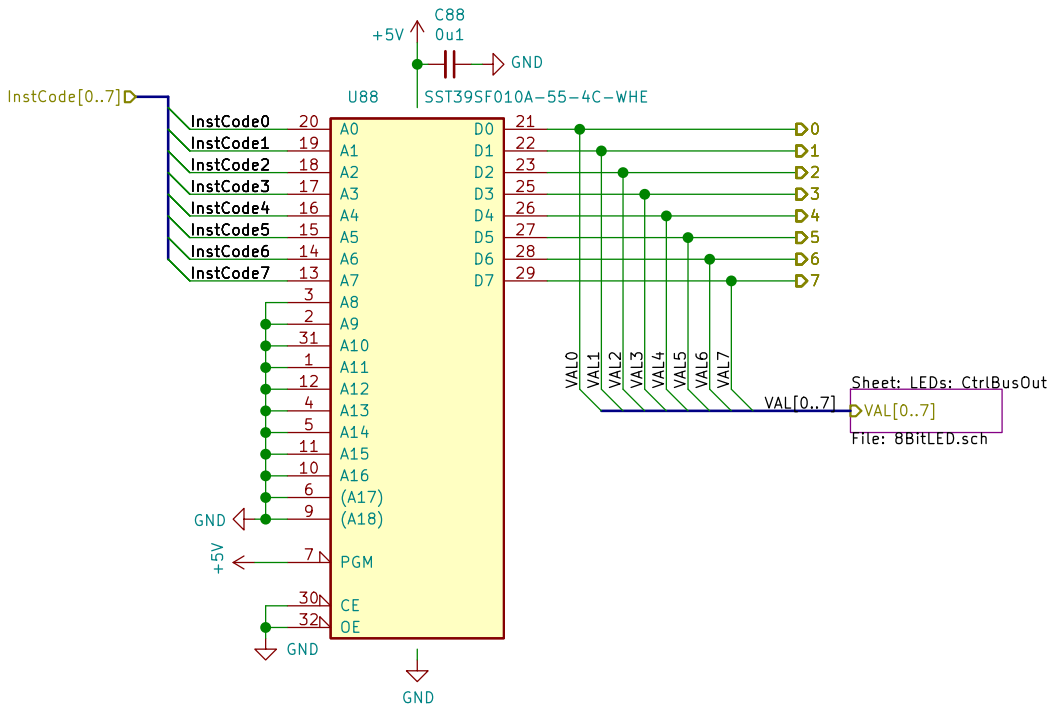
[picture p21: page 11]

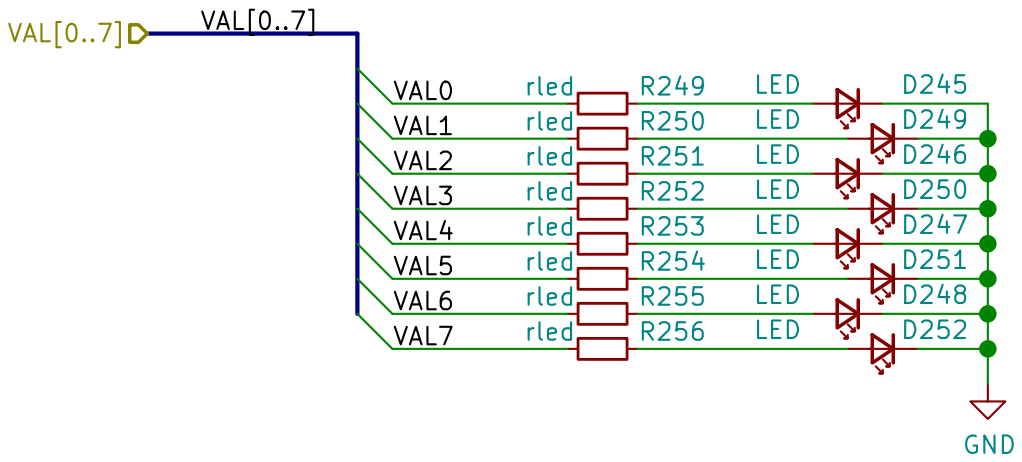
[picture p22: page 12]

Philipp Schilk
File: 8BitLED.sch Sheet: /Control/Control_Rom3/LEDs: CtrlBusOut/
Id: 12/97 Title: psMCU

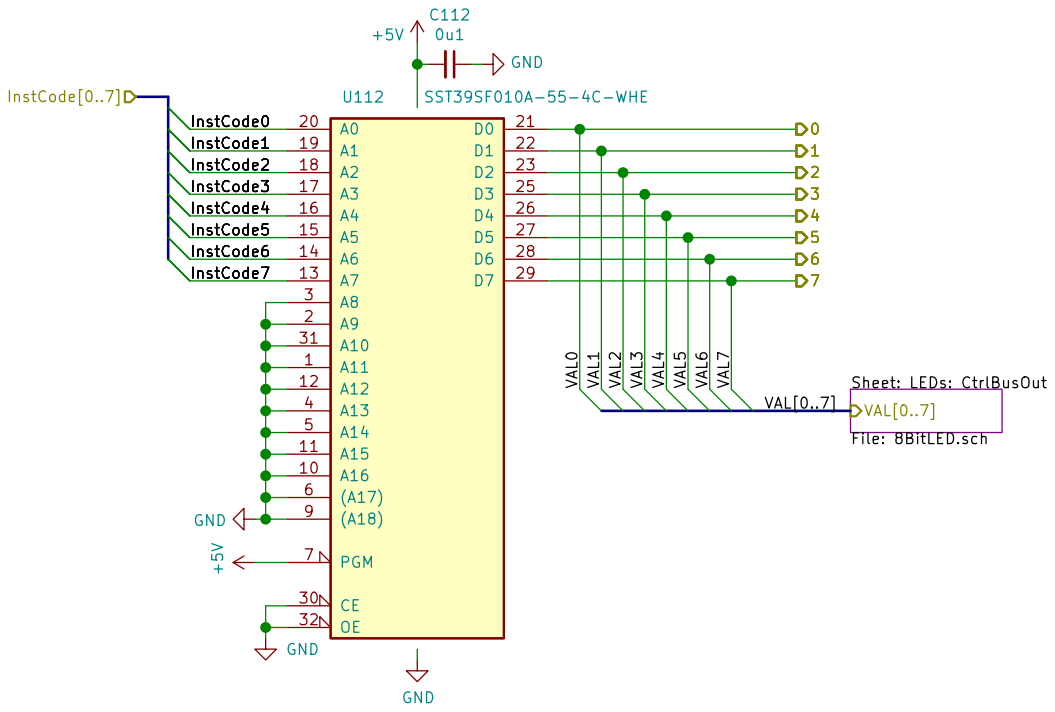
[picture p23: page 13]

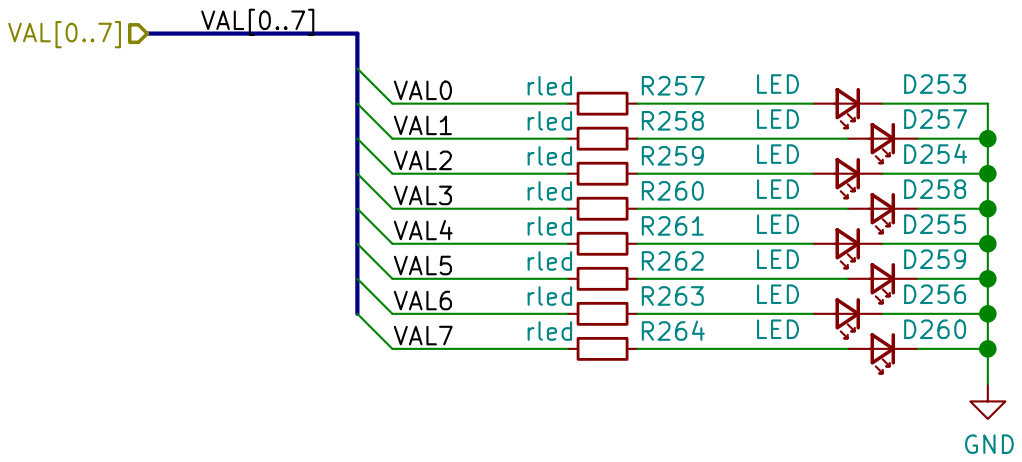
[picture p24: page 14]

Philipp Schilk
File: 8BitLED.sch Sheet: /Control/Control_Rom4/LEDs: CtrlBusOut/
Id: 14/97 Title: psMCU

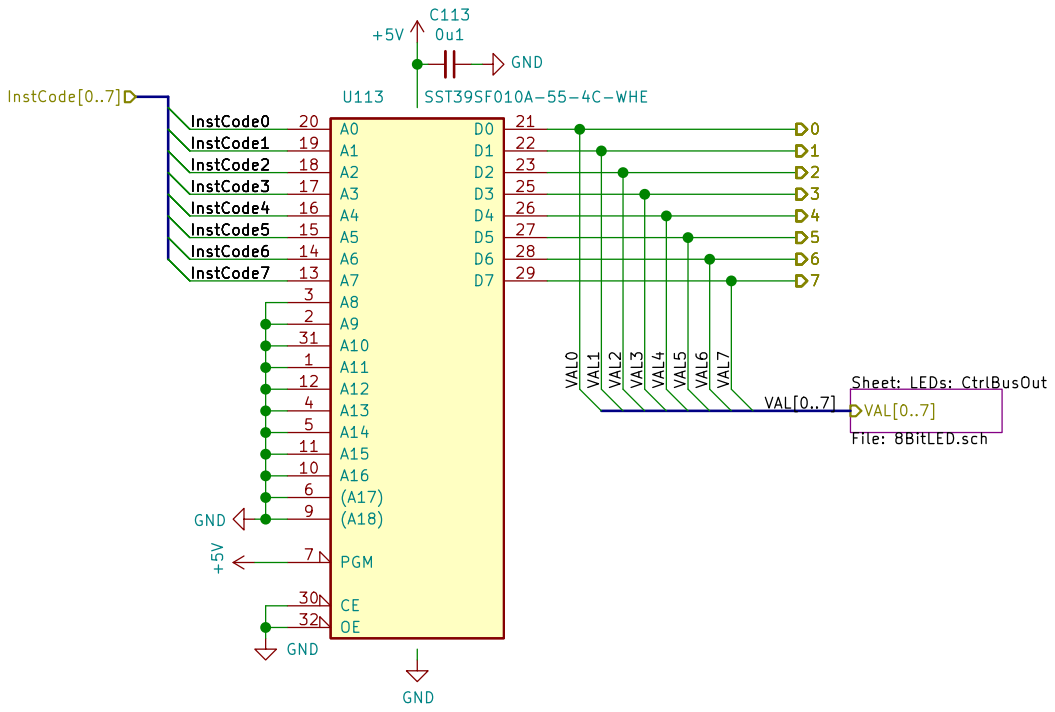
[picture p25: page 15]

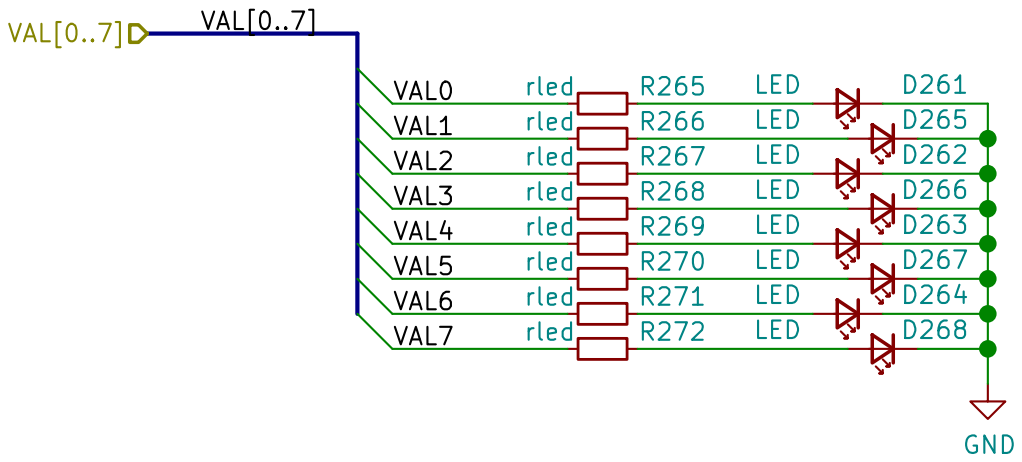
[picture p26: page 16]

Philipp Schilk
File: 8BitLED.sch Sheet: /Control/Control_Rom2/LEDs: CtrlBusOut/
Id: 16/97 Title: psMCU

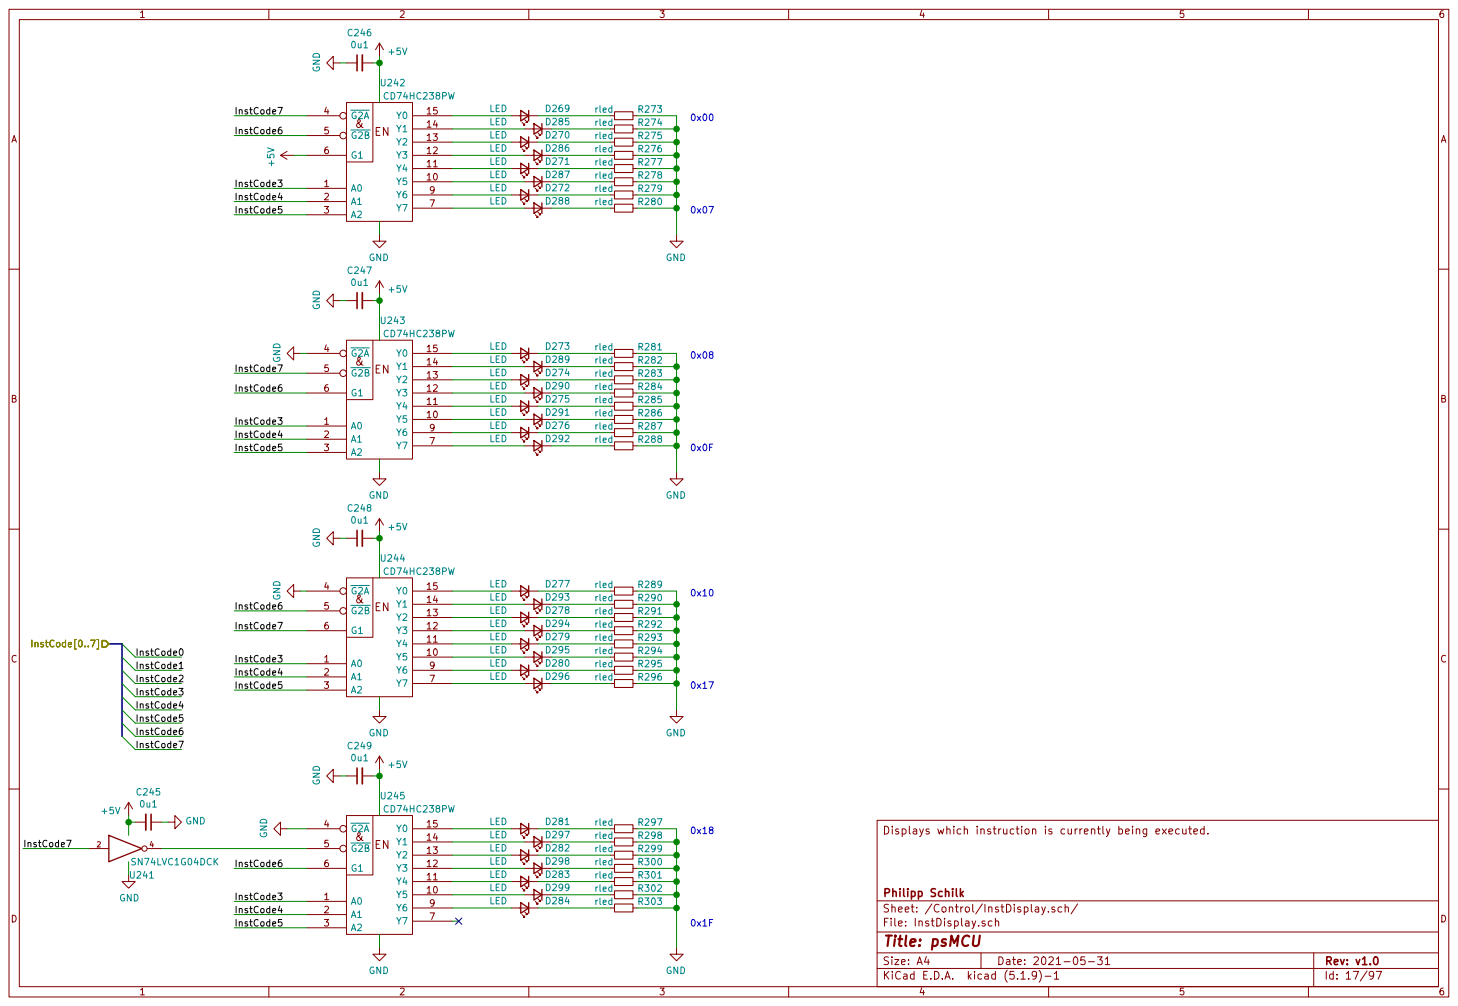
[picture p27: page 17]

Philipp Schilk
Sheet: /Control/InstDisplay.sch/
File: InstDisplay.sch
Id: 17/97 Title: psMCU

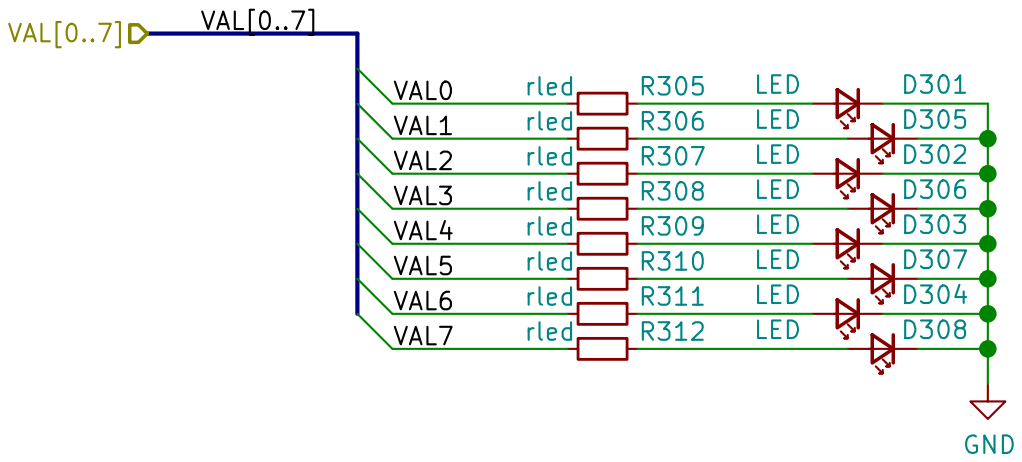
[picture p28: page 18]

Philipp Schilk
File: 8BitLED.sch Sheet: /Control/InstStep/
Id: 18/97 Title: psMCU

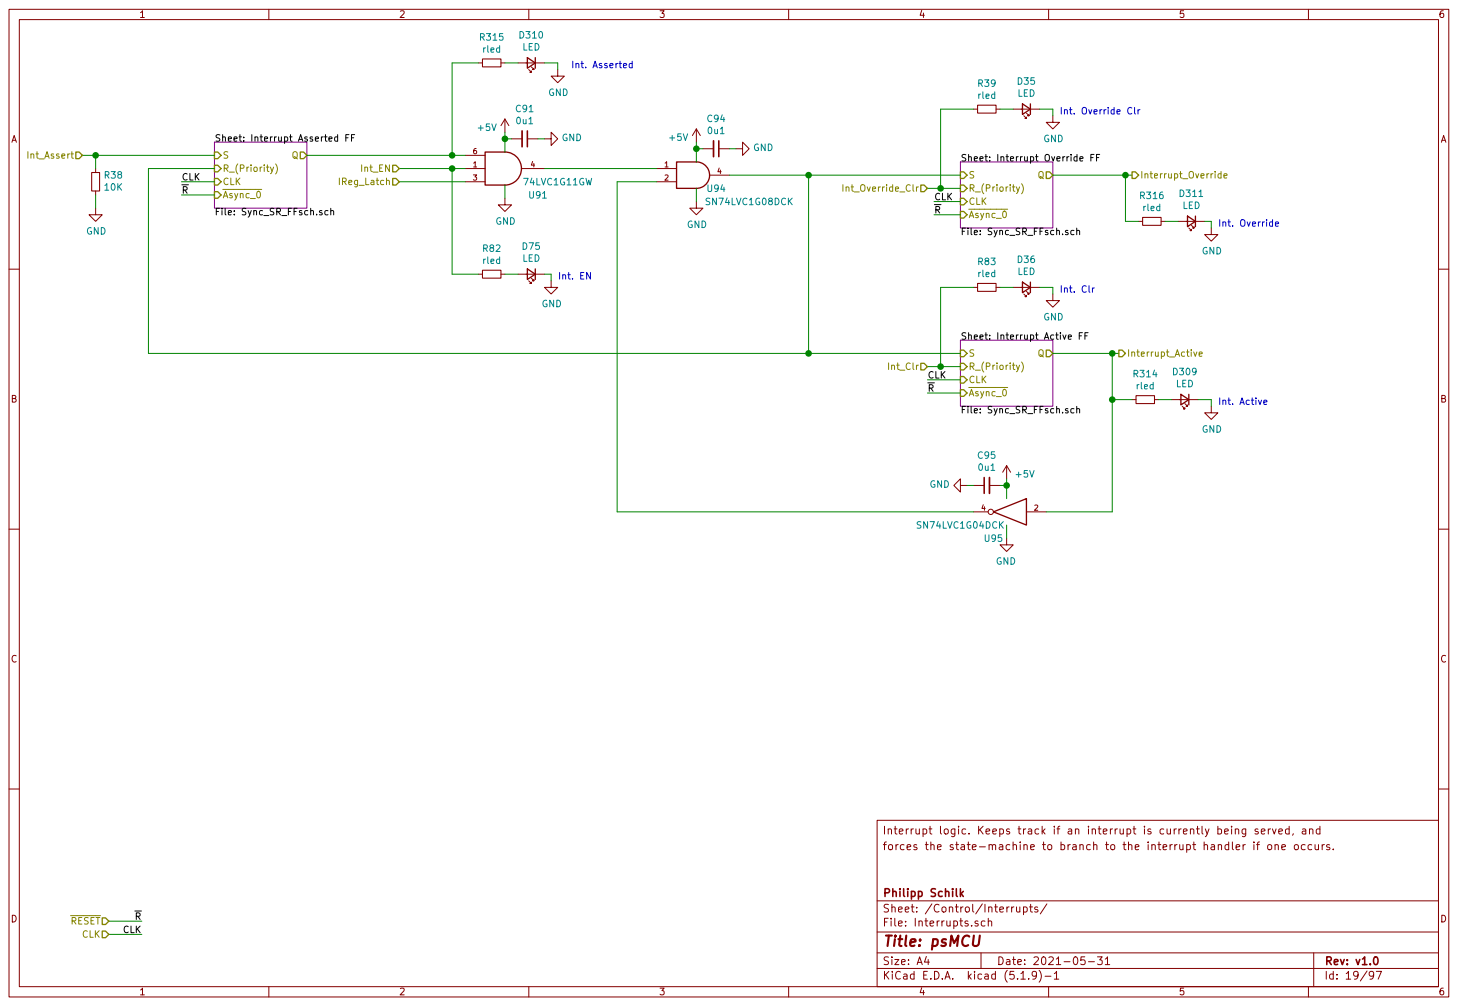
[picture p29: page 19]

Sheet: Interrupt Asserted FF

Sheet: Interrupt Override FF

Sheet: Interrupt Active FF

Interrupt logic. Keeps track if an interrupt is currently being served, and
forces the state-machine to branch to the interrupt handler if one occurs.

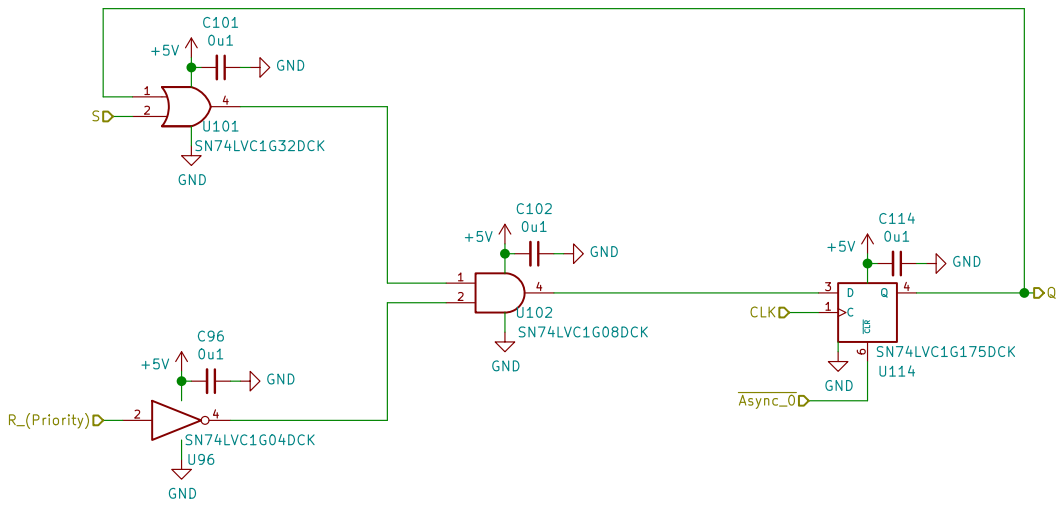
[picture p30: page 20]

A synchronous RS Flip Flop with async. clear. The reset line has priority: If both R & S
are asserted on a rising clock edge, the Flip Flop will be cleared.

Philipp Schilk
Sheet: /Control/Interrupts/Interrupt Asserted FF/
File: Sync_SR_FFsch.sch
Id: 20/97 Title: psMCU

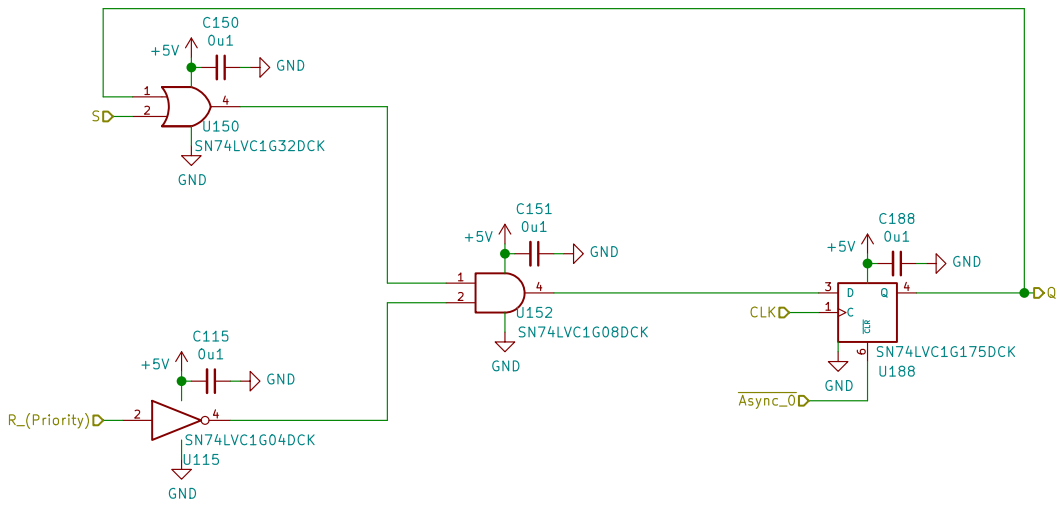
[picture p31: page 21]
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

Philipp Schilk
Sheet: /Control/Interrupts/Interrupt Override FF/
File: Sync_SR_FFsch.sch
Id: 21/97 Title: psMCU

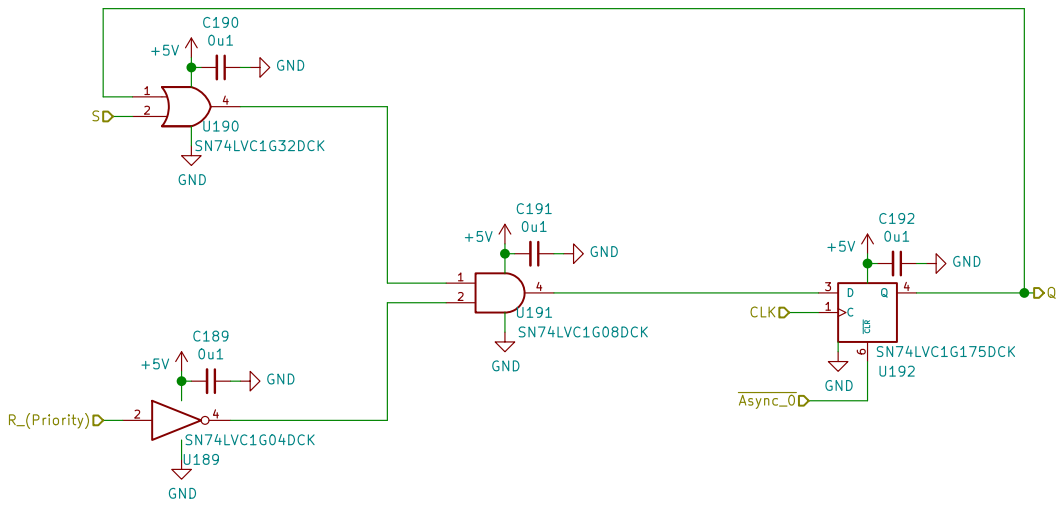
[picture p32: page 22]
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

Philipp Schilk
Sheet: /Control/Interrupts/Interrupt Active FF/
File: Sync_SR_FFsch.sch
Id: 22/97 Title: psMCU

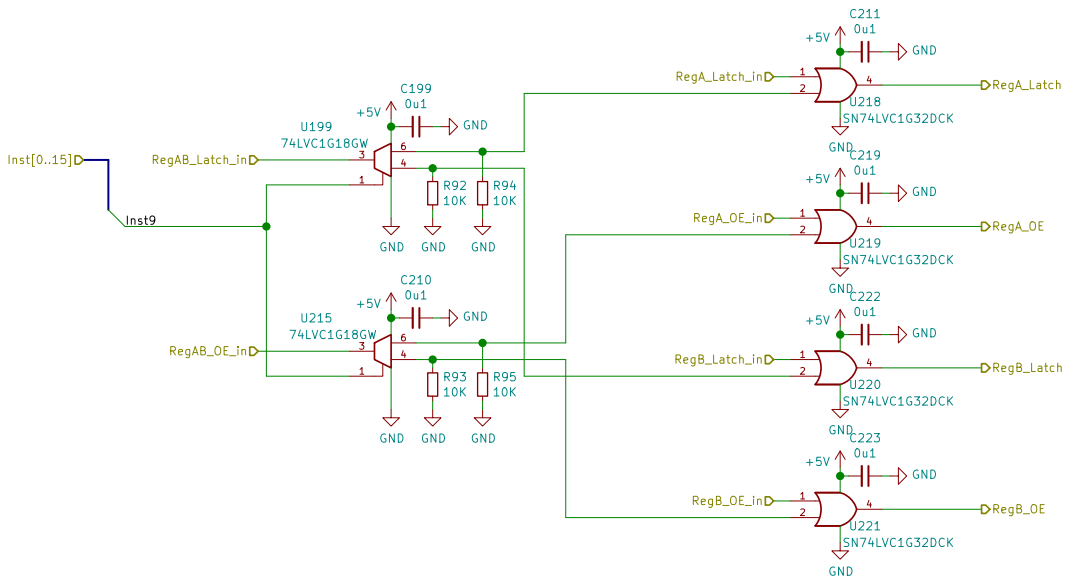
[picture p33: page 23]

Reroutes Latch/OE signals depending on which register instruciton selects. GND GND

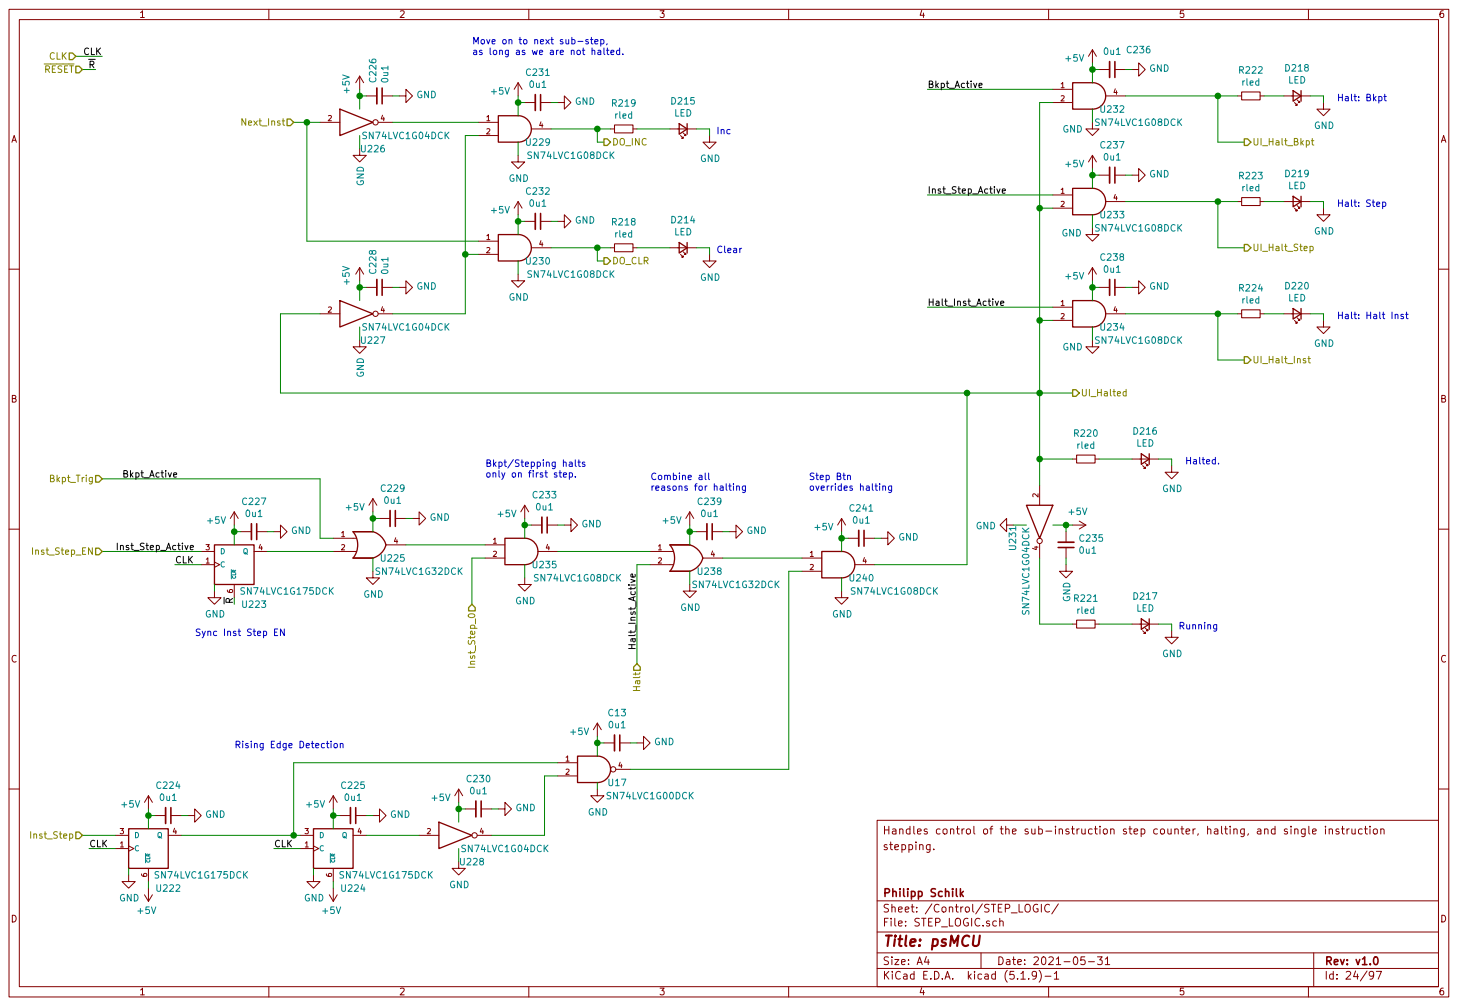
[picture p34: page 24]

Inc Move on to next sub-step,
as long as we are not halted.
+5VGND
GND

Halt: Step Halt: Halt Inst Combine all reasons for halting

Handles control of the sub-instruction step counter, halting, and single instruction
stepping.

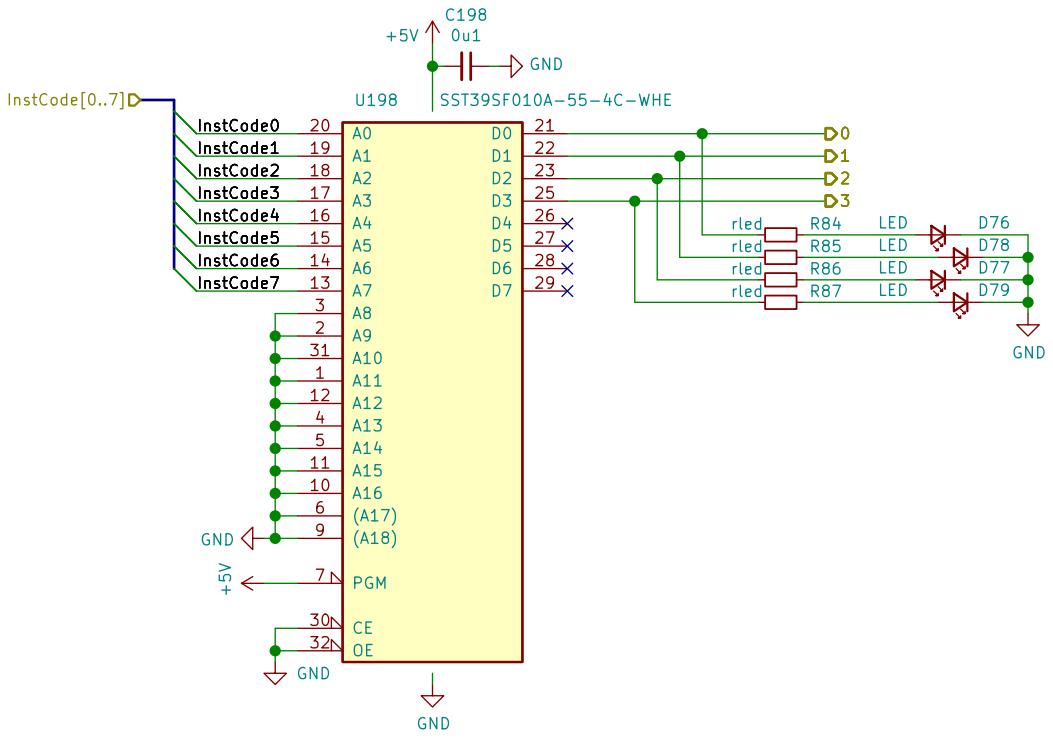
[picture p35: page 25]

Microcode ROM, stores control signals needed for each sub-step of each instruction. GND

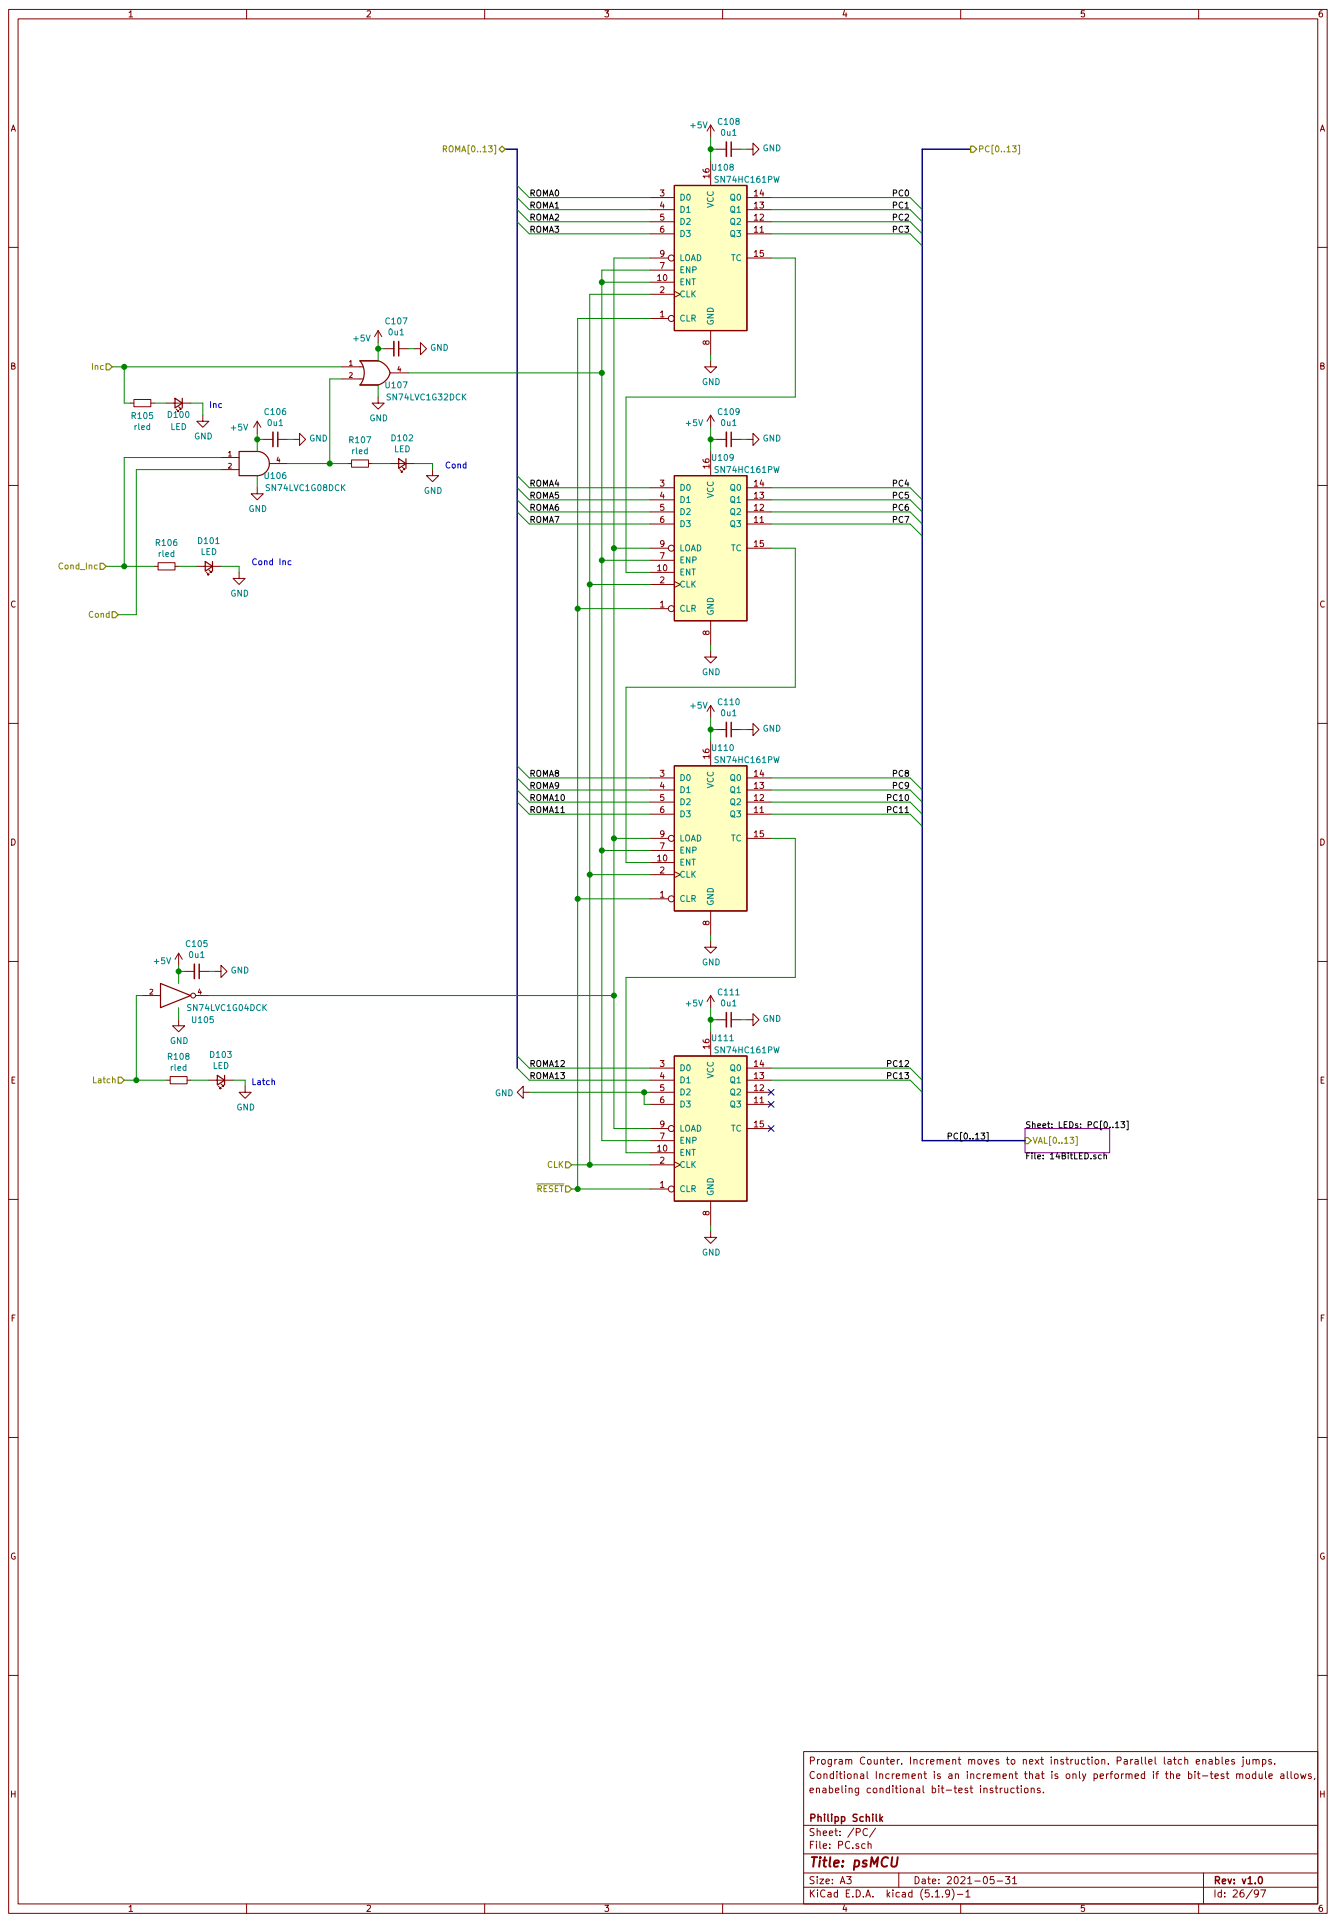
[picture p36: page 26]

Sheet: LEDs: PC[0..13] File: 14BitLED.sch VAL[0..13]

Program Counter. Increment moves to next instruction. Parallel latch enables jumps.
Conditional Increment is an increment that is only performed if the bit-test module allows,
enabeling conditional bit-test instructions.

File: PC.sch Sheet: /PC/ Philipp Schilk

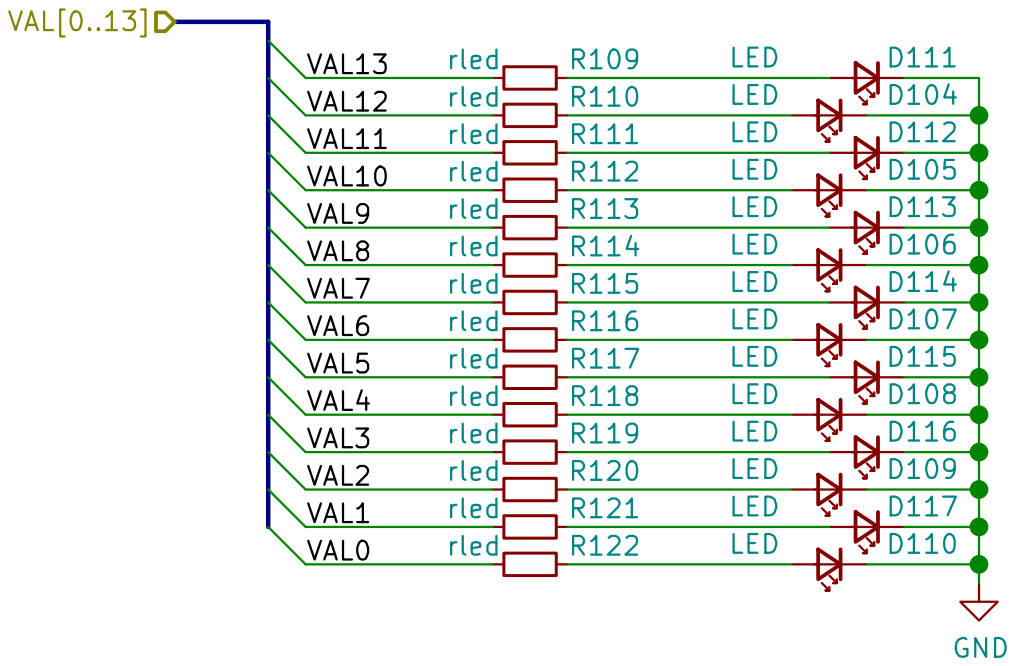
[picture p37: page 27]

Philipp Schilk
File: 14BitLED.sch Sheet: /PC/LEDs: PC[0..13]/
Id: 27/97 Title: psMCU

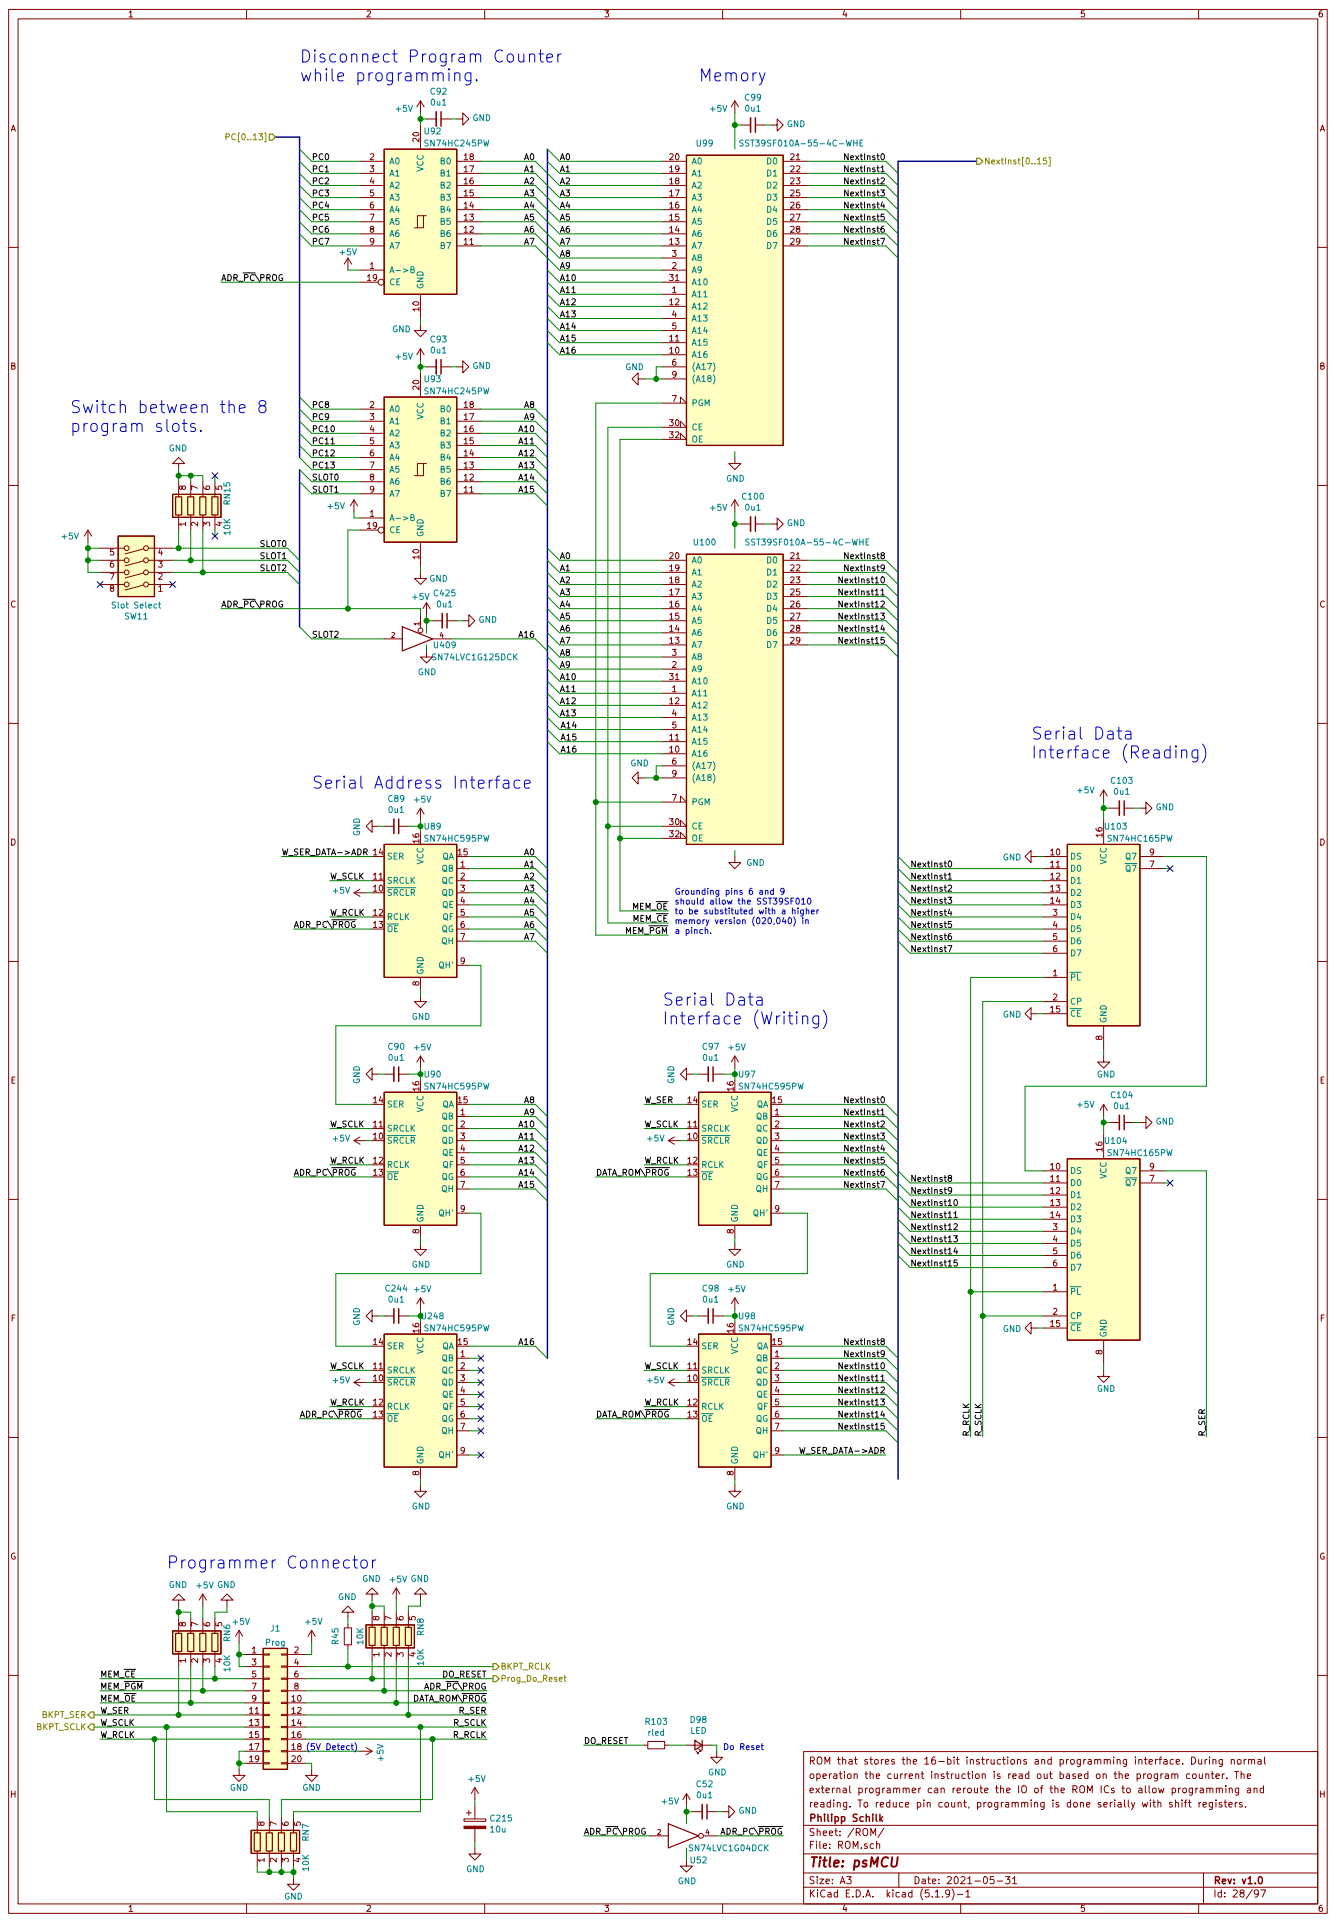
[picture p38: page 28]

W_SER_DATA->ADR Serial Address Interface

Grounding pins 6 and 9 should allow the SST39SF010

to be substituted with a higher
memory version (020,040) in
a pinch.

8 QH' 9 U98 SN74HC595PW GND QB 1 SRCLR 10 SRCLK 11 RCLK 12 OE 13 SER 14 QA 15 VCC 16 QC 2 QD 3 QE 4 QF 5 QG 6 QH 7 GND

ROM that stores the 16-bit instructions and programming interface. During normal GND

9 | | 10
11 | | | 12

15 | | 16
17 | | 18 (5V Detect)

operation the current instruction is read out based on the program counter. The
external programmer can reroute the IO of the ROM ICs to allow programming and
reading. To reduce pin count, programming is done serially with shift registers.
File: ROM.sch Sheet: /ROM/ Philipp Schilk

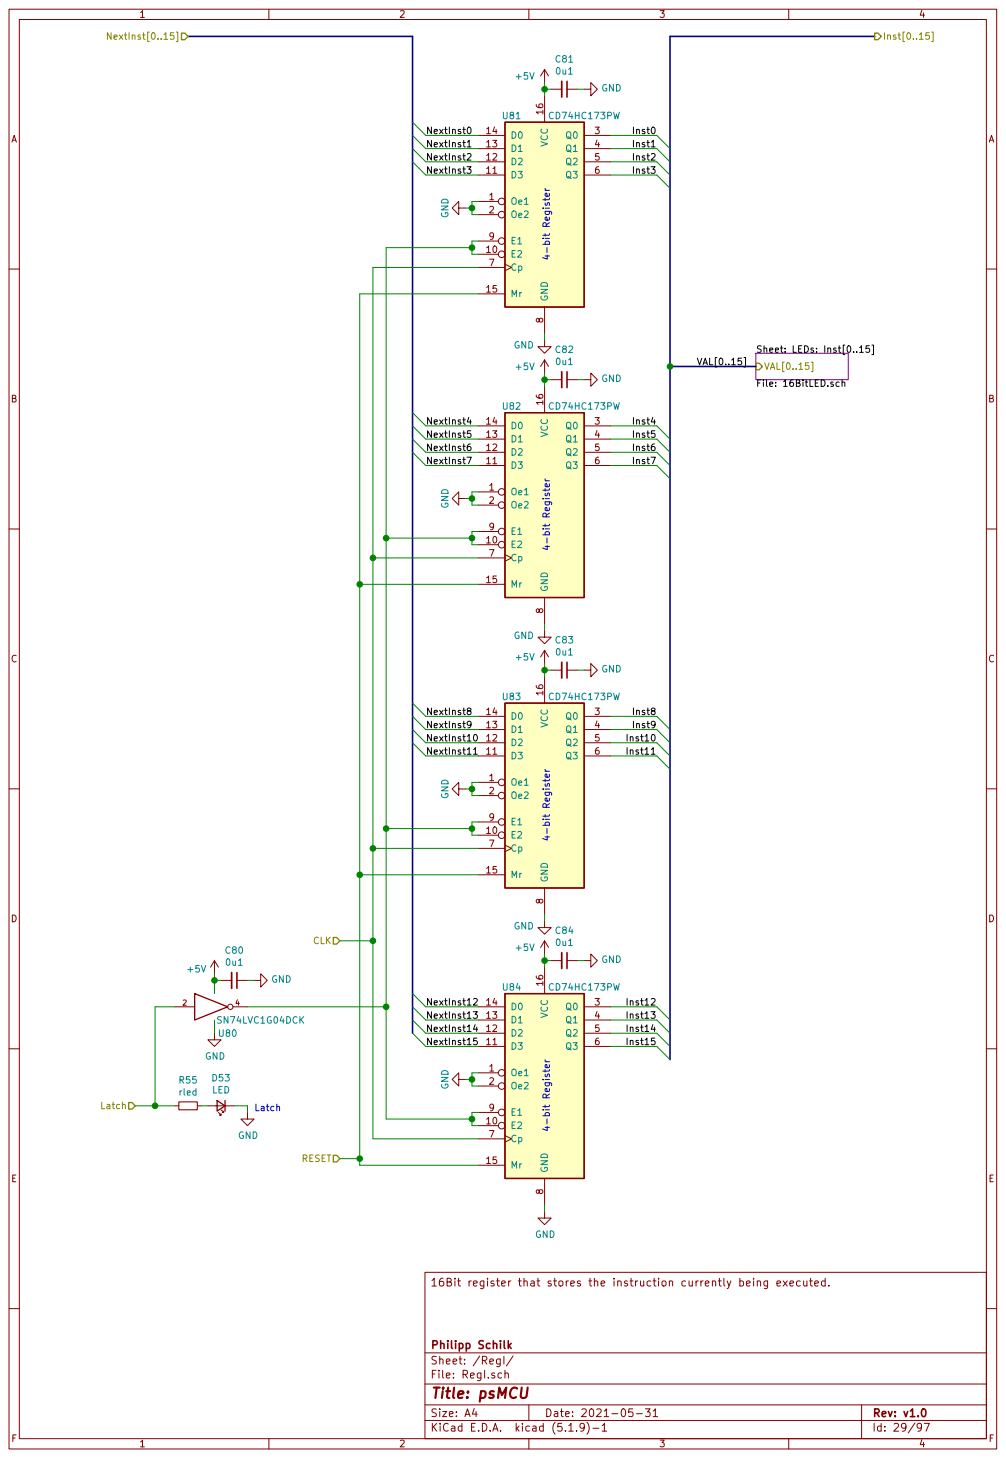
[picture p39: page 29]

Sheet: LEDs: Inst[0..15] File: 16BitLED.sch VAL[0..15] GND

16Bit register that stores the instruction currently being executed.

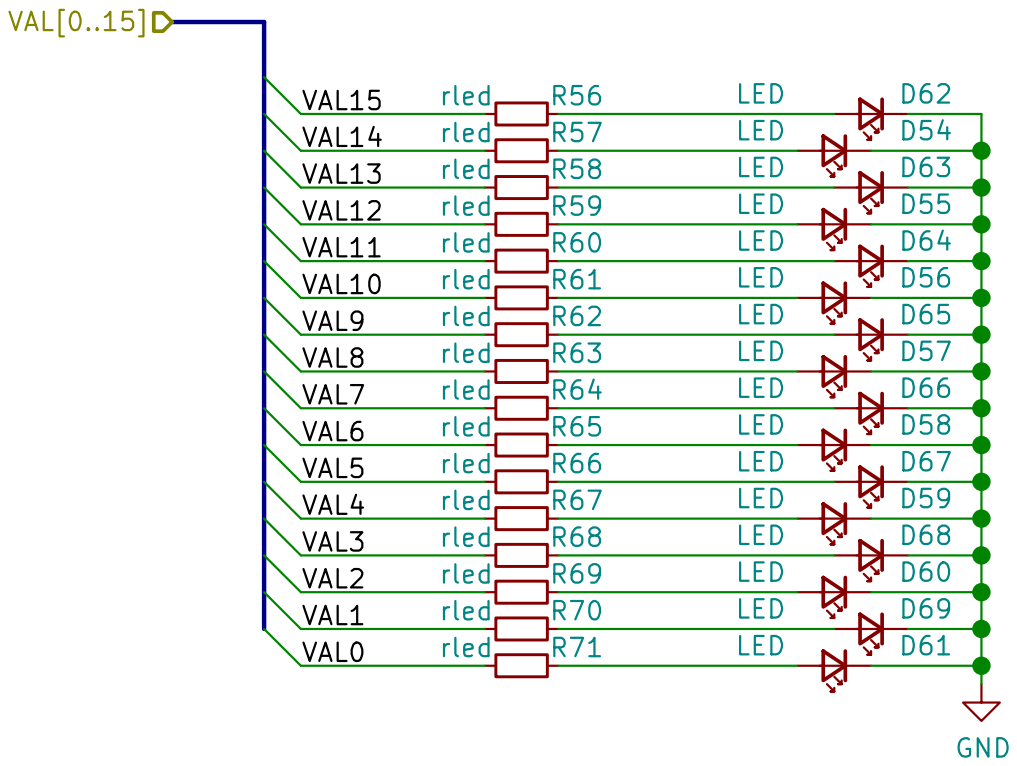
[picture p40: page 30]

Philipp Schilk
File: 16BitLED.sch Sheet: /RegI/LEDs: Inst[0..15]/
Id: 30/97 Title: psMCU

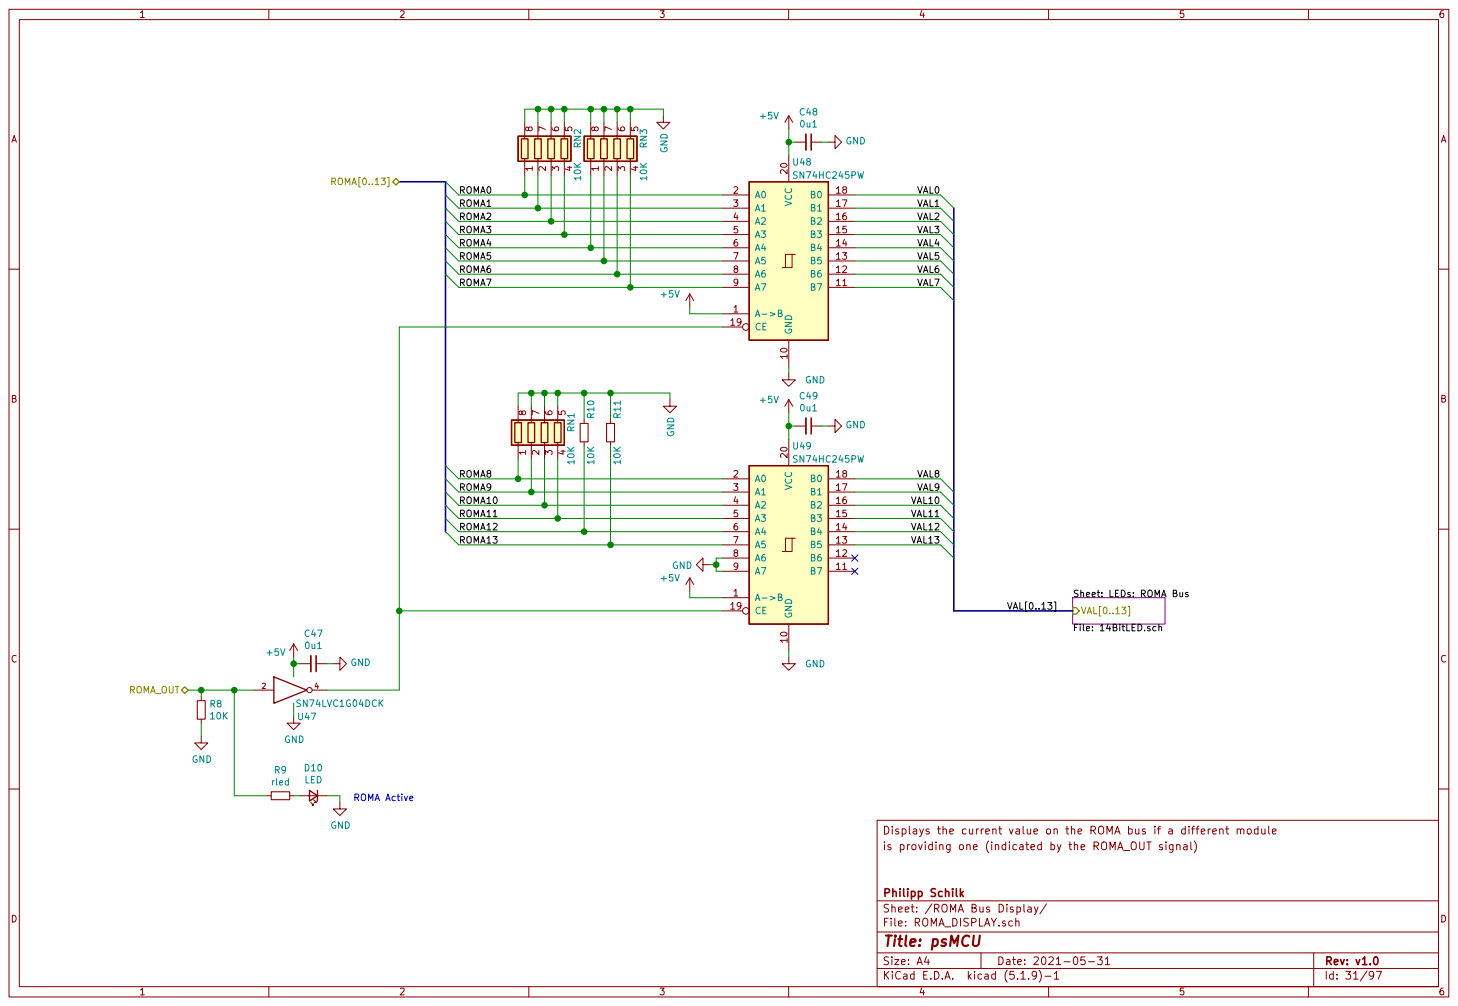
[picture p41: page 31]

Displays the current value on the ROMA bus if a different module Sheet: LEDs: ROMA Bus File: 14BitLED.sch VAL[0..13] GND GND

is providing one (indicated by the ROMA_OUT signal)

Philipp Schilk
Sheet: /ROMA Bus Display/
File: ROMA_DISPLAY.sch
Id: 31/97 Title: psMCU

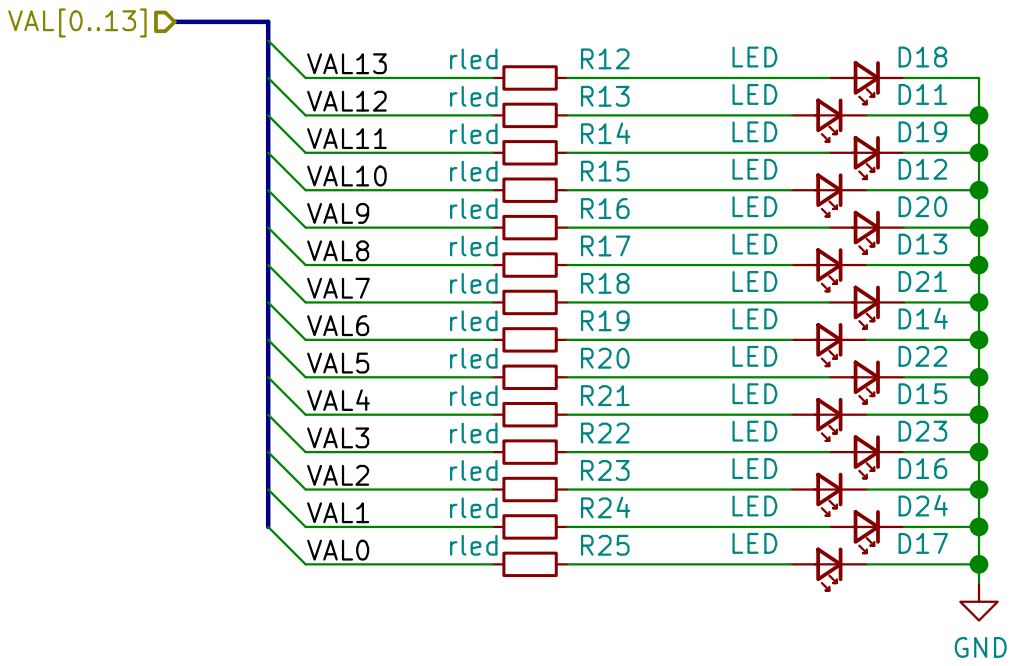
[picture p42: page 32]

Philipp Schilk
File: 14BitLED.sch Sheet: /ROMA Bus Display/LEDs: ROMA Bus/
Id: 32/97 Title: psMCU

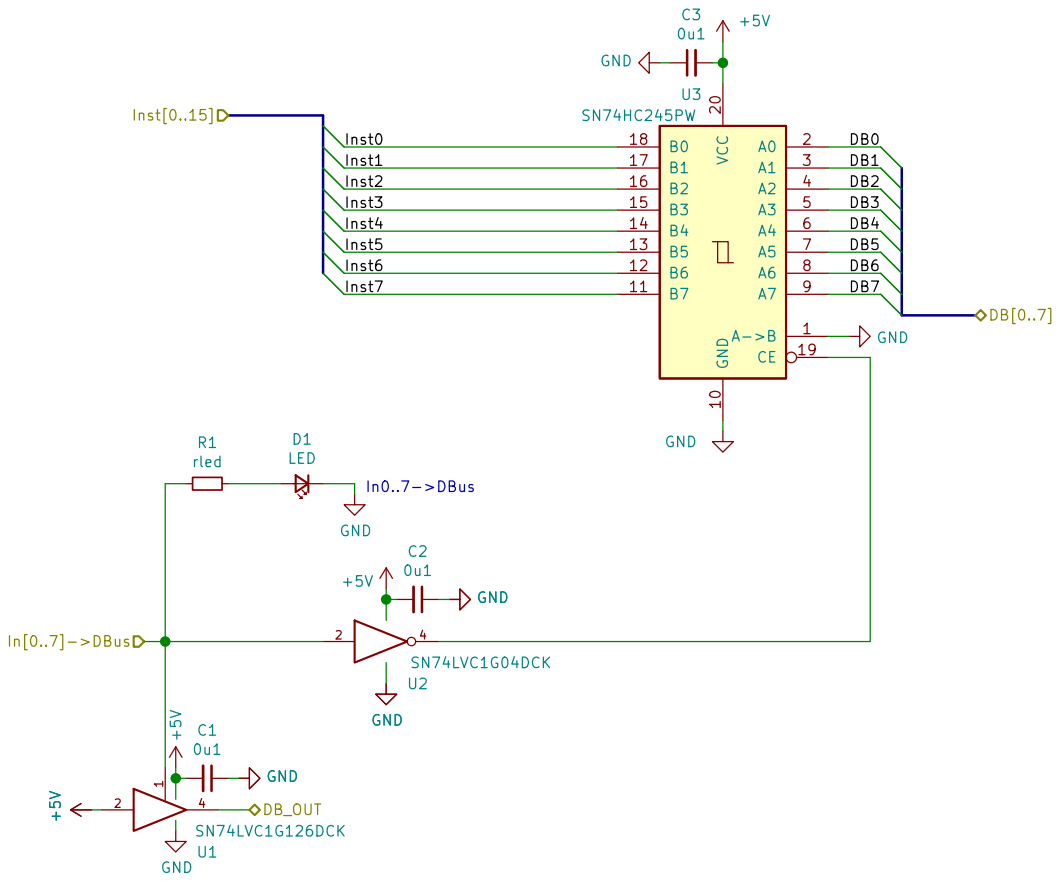
[picture p43: page 33]

In0..7->DBus
0u1 GND
Puts the lowest byte of the current instruction onto the DBus. Used to load literals into GND GND

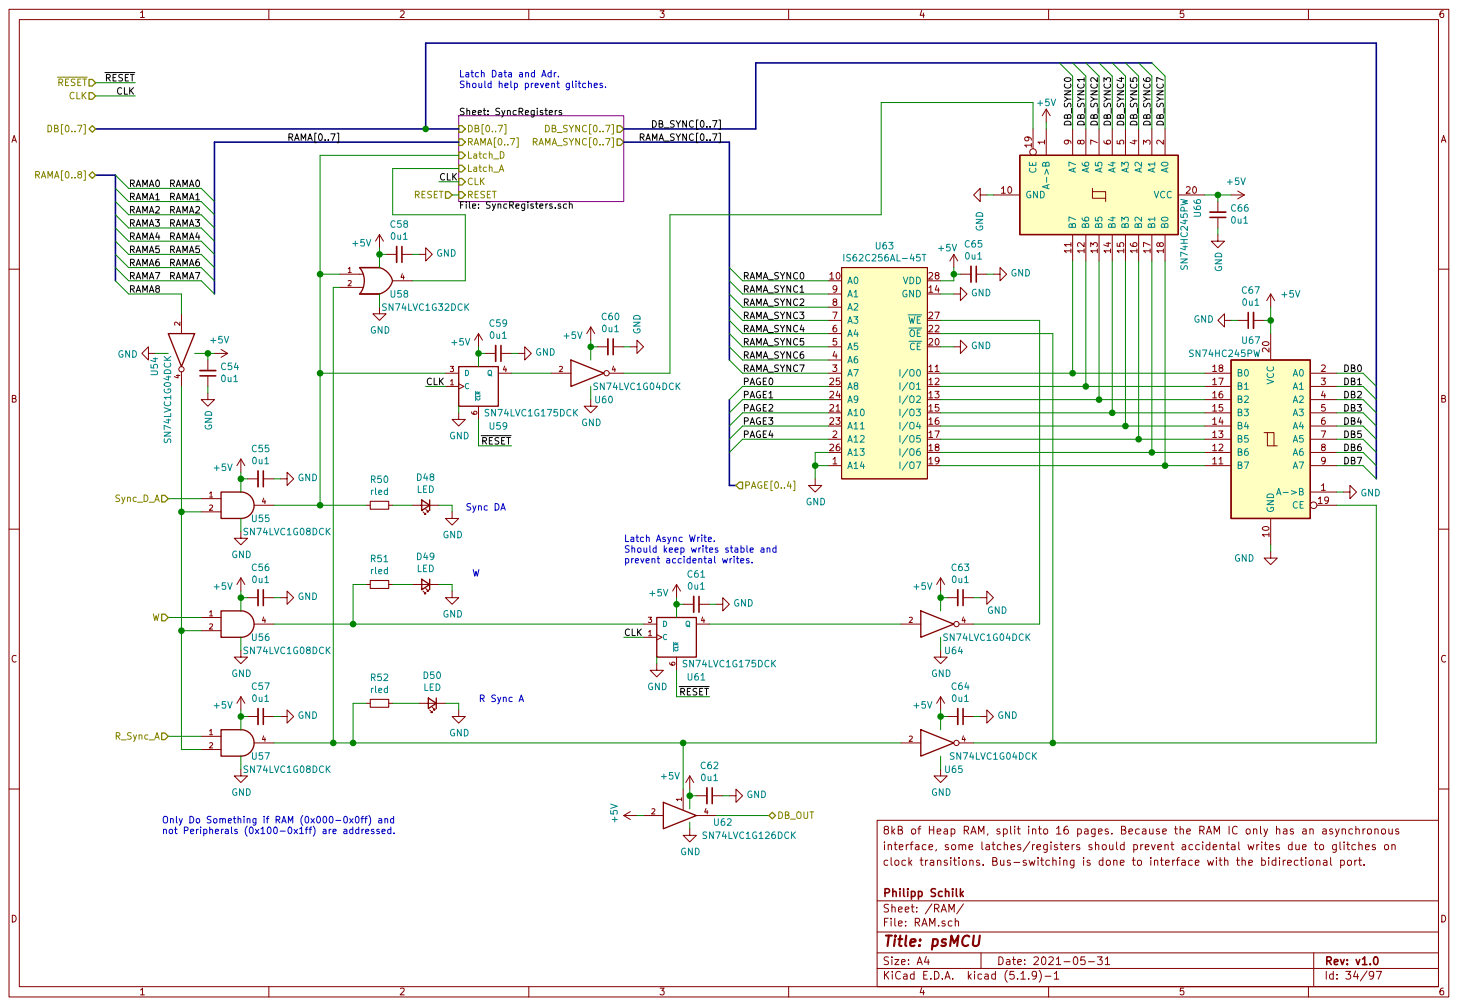
[picture p44: page 34]

Latch Data and Adr. Should help prevent glitches.

Latch Async Write.
Should keep writes stable and
prevent accidental writes.

Only Do Something if RAM (0x000-0x0ff) and

8kB of Heap RAM, split into 16 pages. Because the RAM IC only has an asynchronous
interface, some latches/registers should prevent accidental writes due to glitches on
clock transitions. Bus-switching is done to interface with the bidirectional port.

File: RAM.sch Sheet: /RAM/ Philipp Schilk

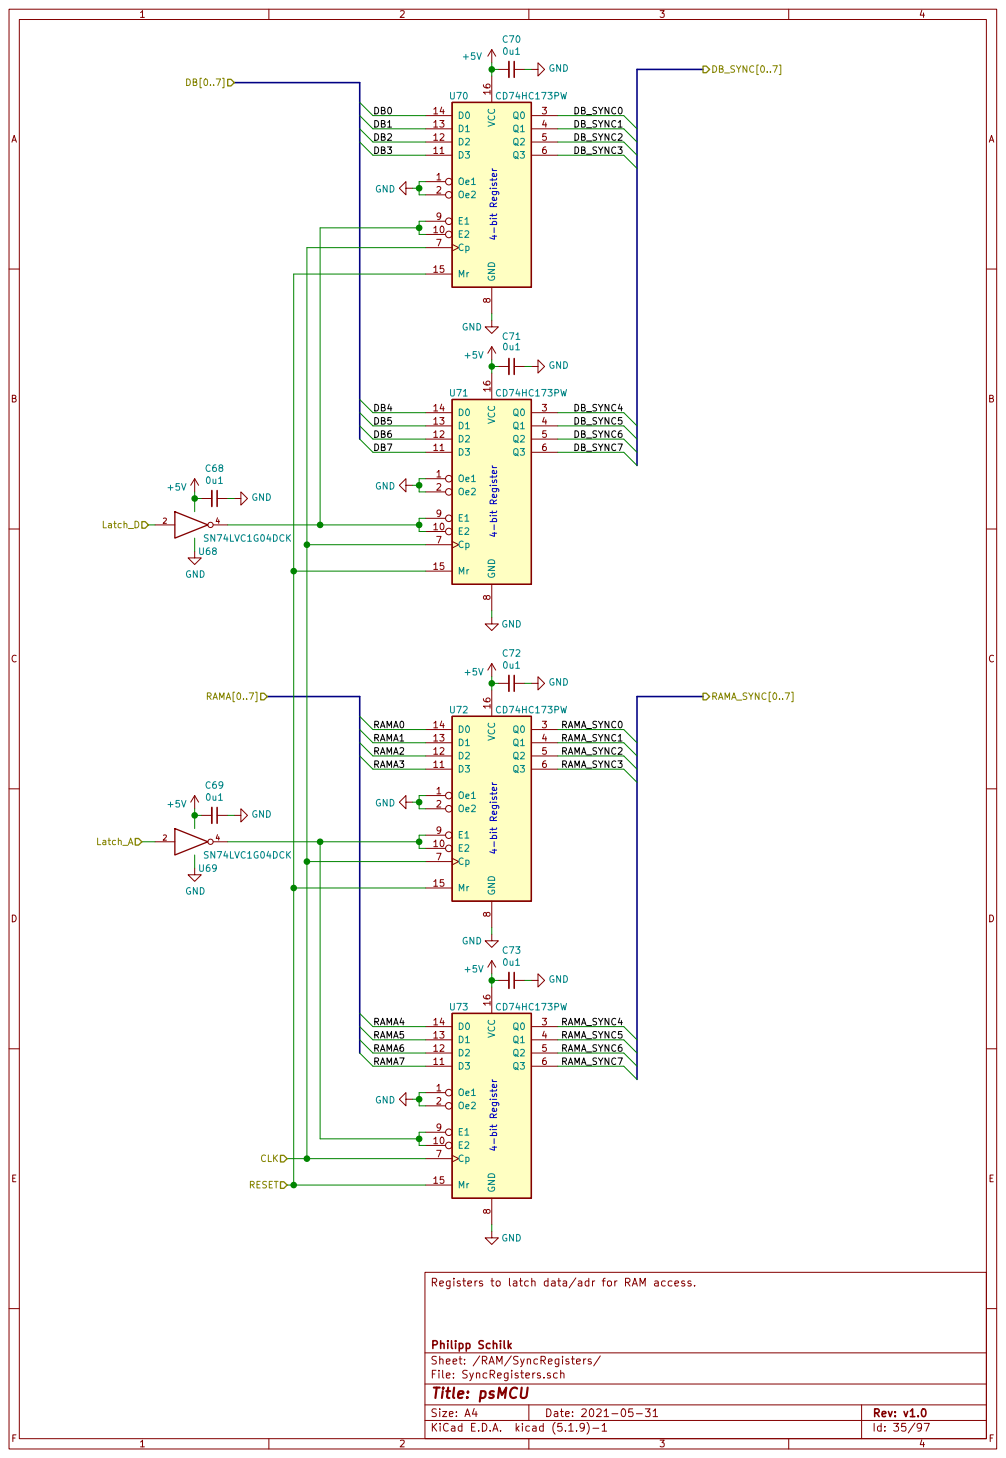
[picture p45: page 35]

DB_SYNC0 DB_SYNC3 DB_SYNC4 DB_SYNC2 DB_SYNC5 DB_SYNC6 DB_SYNC7 RAMA_SYNC0 RAMA_SYNC1 RAMA_SYNC2 RAMA_SYNC3 RAMA_SYNC4 RAMA_SYNC5 4-bit Register 4-bit Register 4-bit Register 4-bit Register

Registers to latch data/adr for RAM access. GND GND GND
RAMA[0..7]

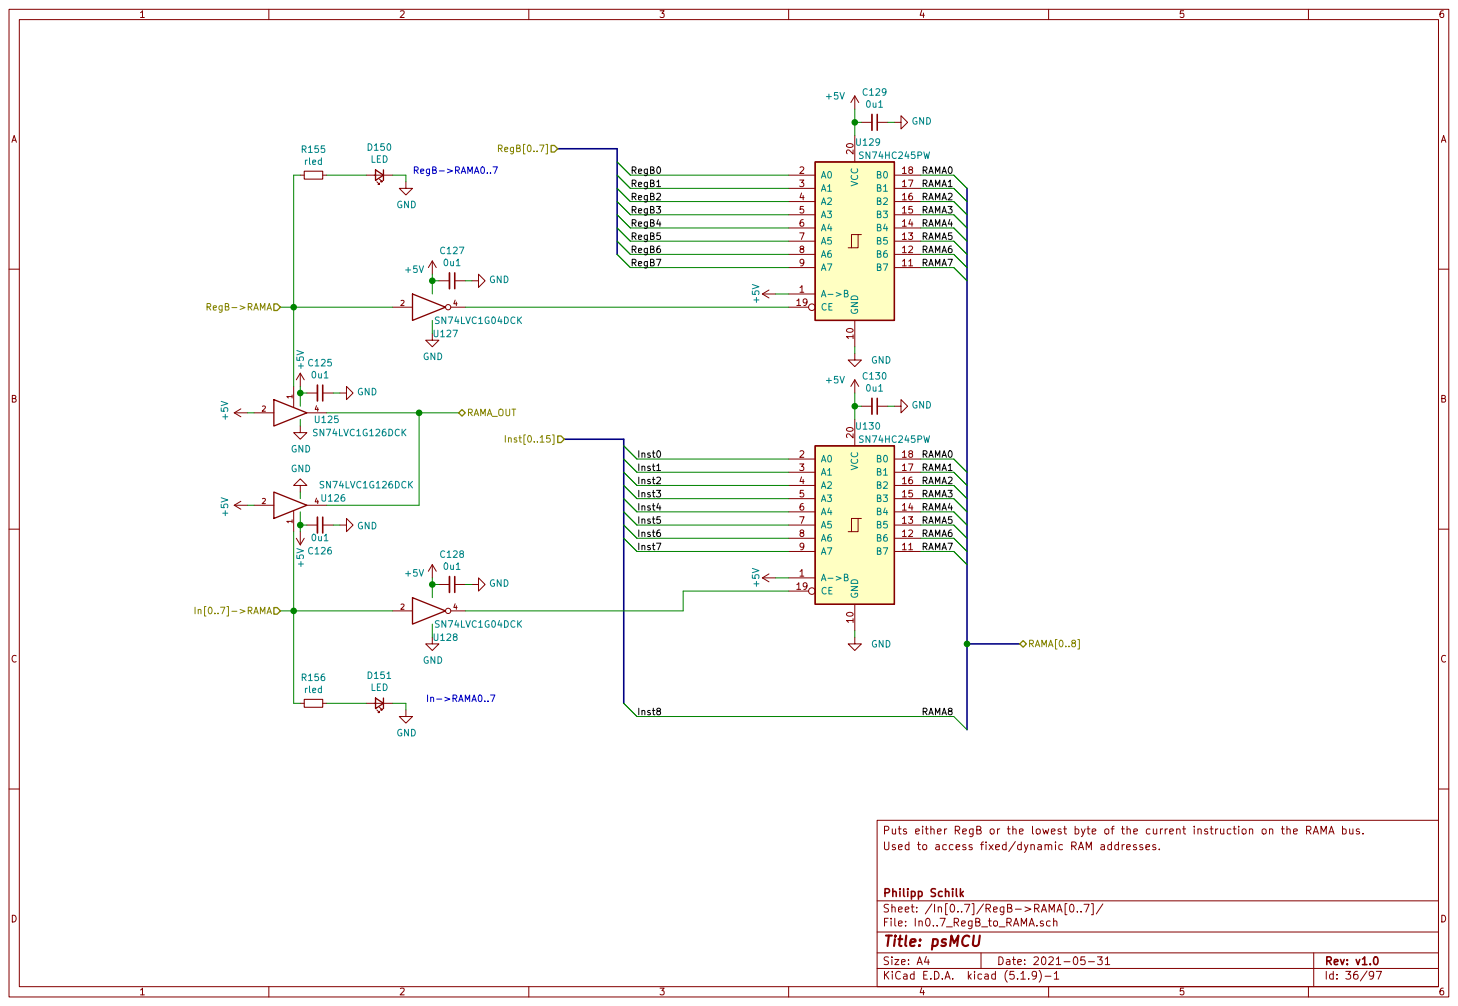
[picture p46: page 36]

Puts either RegB or the lowest byte of the current instruction on the RAMA bus. GND

Used to access fixed/dynamic RAM addresses.

Philipp Schilk
Sheet: /In[0..7]/RegB->RAMA[0..7]/
File: In0..7_RegB_to_RAMA.sch
Id: 36/97 Title: psMCU

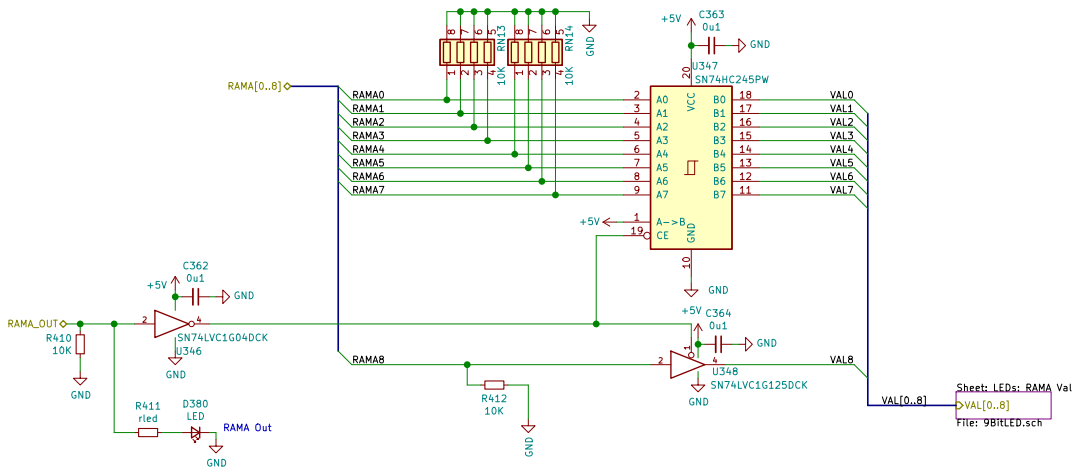
[picture p47: page 37]

Displays the current value on the RAMA bus if a different module is providing one Sheet: LEDs: RAMA Val File: 9BitLED.sch VAL[0..8]

(indicated by the RAMA_OUT signal)

Philipp Schilk
Sheet: /RAMA Bus Display/
File: RAMA_DISPLAY.sch
Id: 37/97 Title: psMCU

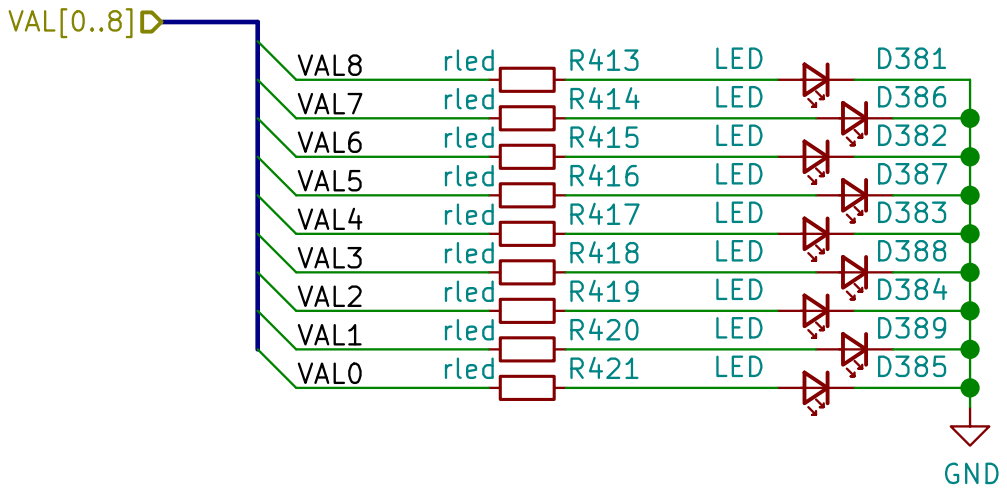
[picture p48: page 38]

Philipp Schilk
File: 9BitLED.sch Sheet: /RAMA Bus Display/LEDs: RAMA Val/
Id: 38/97 Title: psMCU

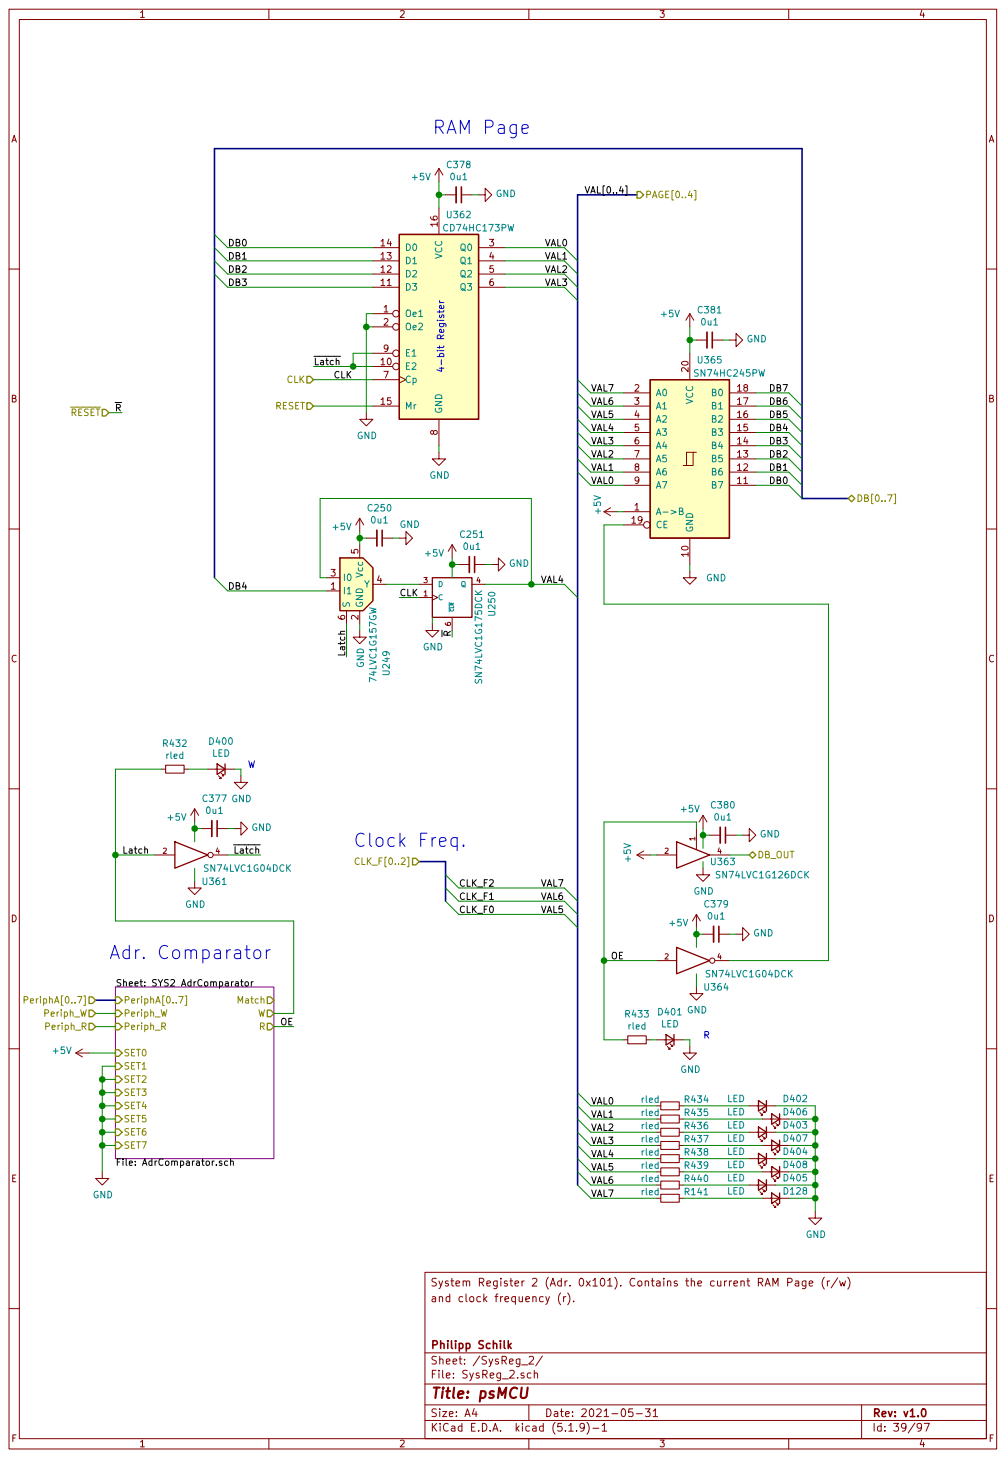
[picture p49: page 39]

System Register 2 (Adr. 0x101). Contains the current RAM Page (r/w)
and clock frequency (r).

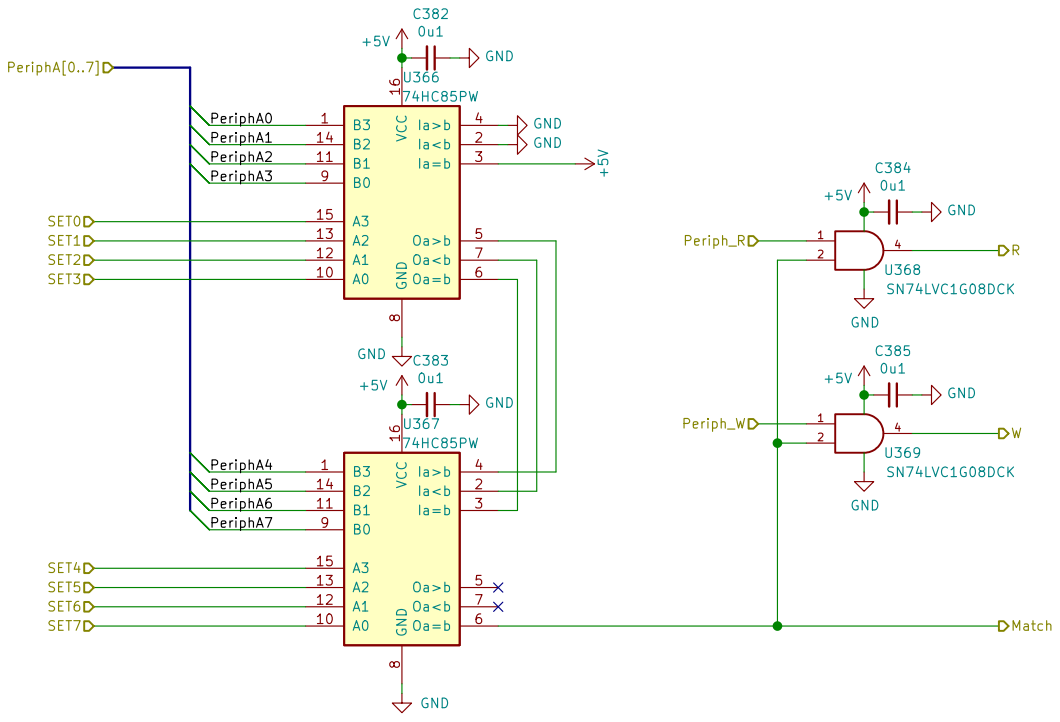
[picture p50: page 40]

An adr. comparator. Used to check if the address currently on the RAMA bus corresponds
to a specific address.

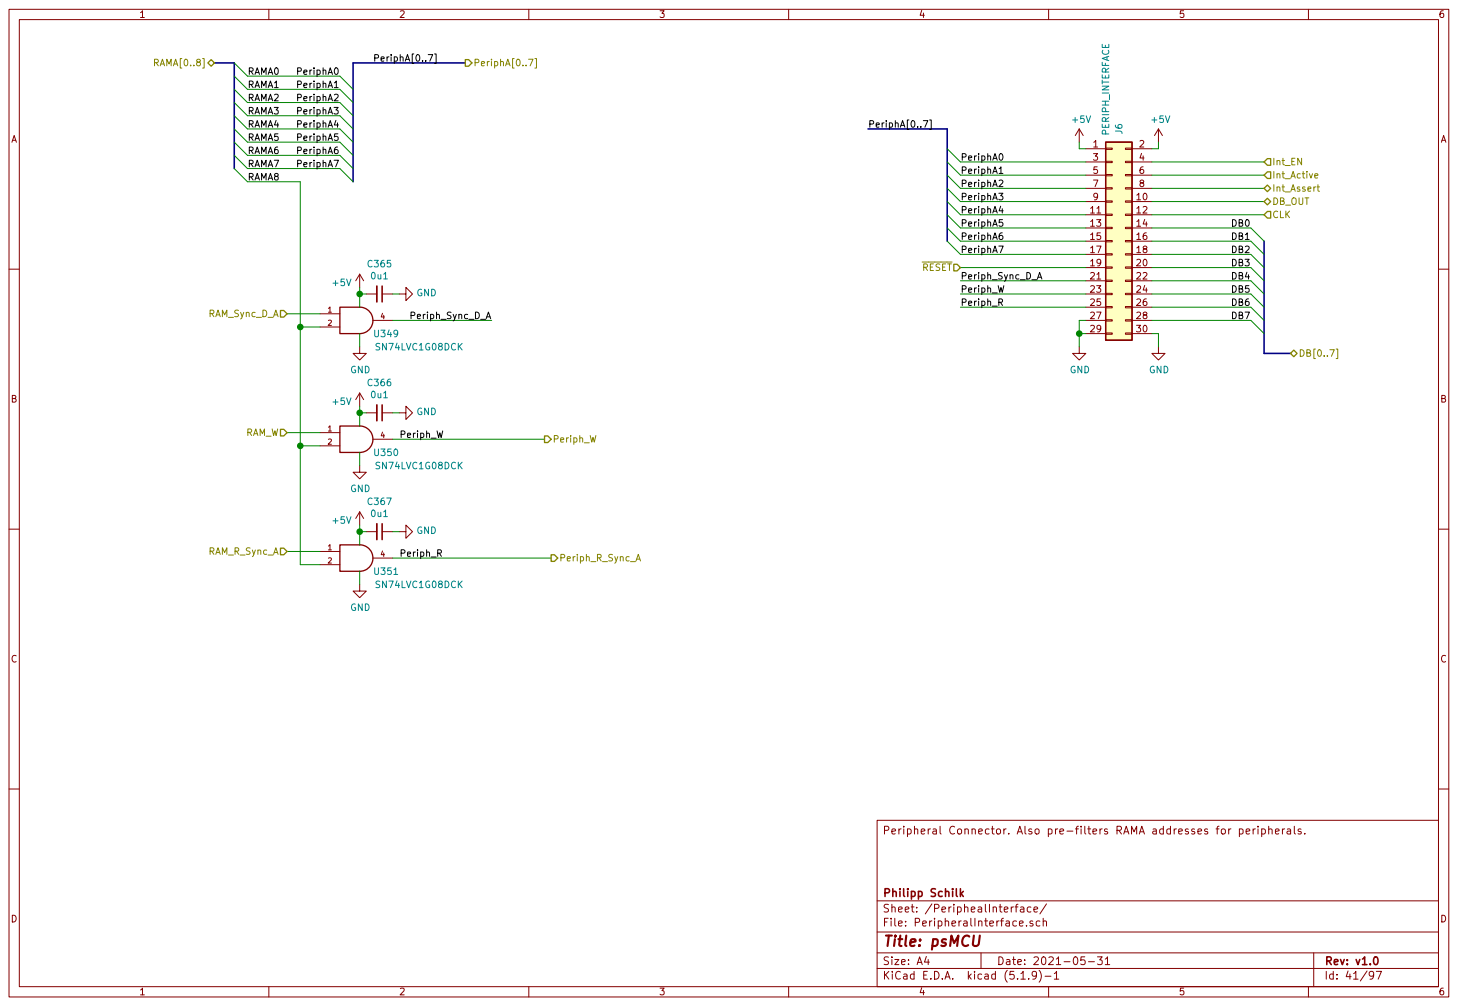
[picture p51: page 41]

Peripheral Connector. Also pre-filters RAMA addresses for peripherals.

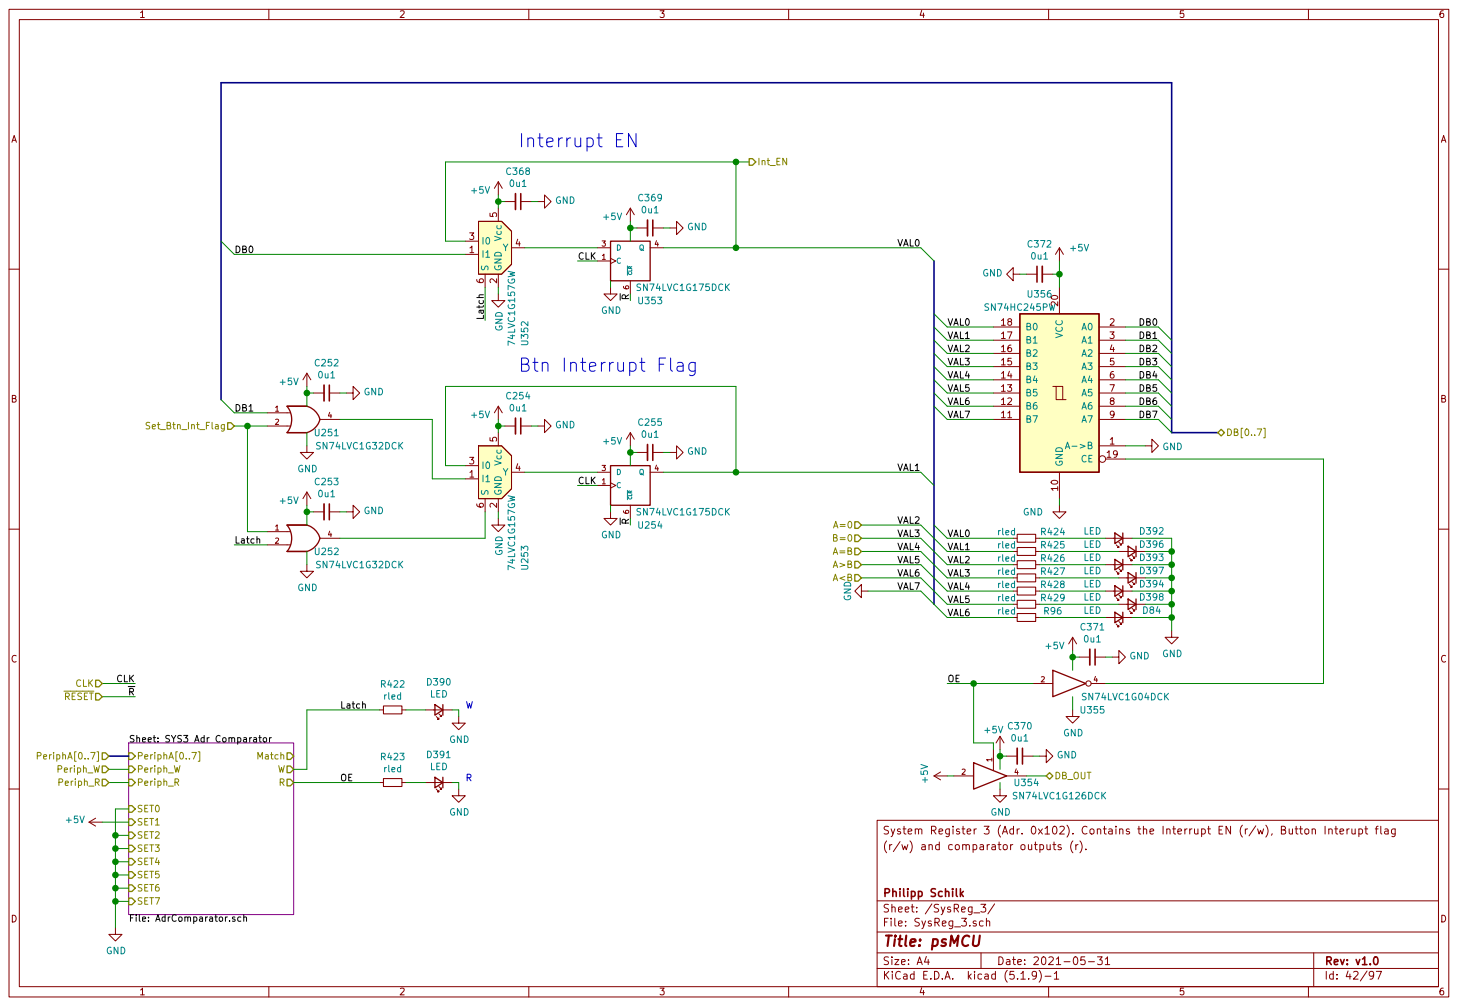
[picture p52: page 42]

System Register 3 (Adr. 0x102). Contains the Interrupt EN (r/w), Button Interupt flag
(r/w) and comparator outputs (r).

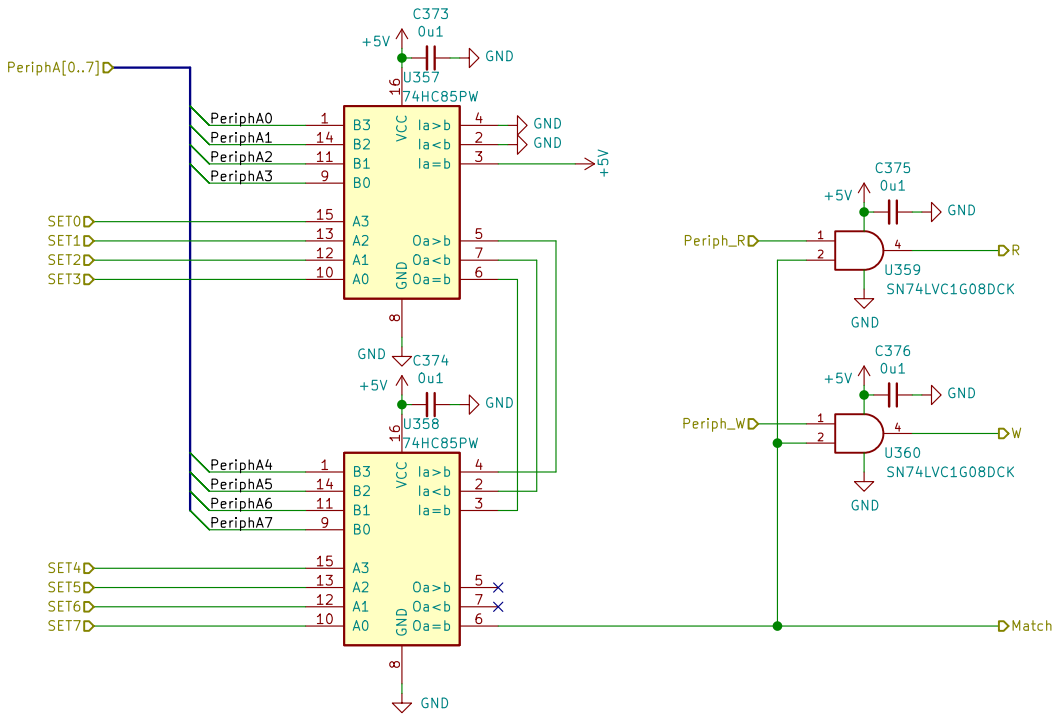
[picture p53: page 43]
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

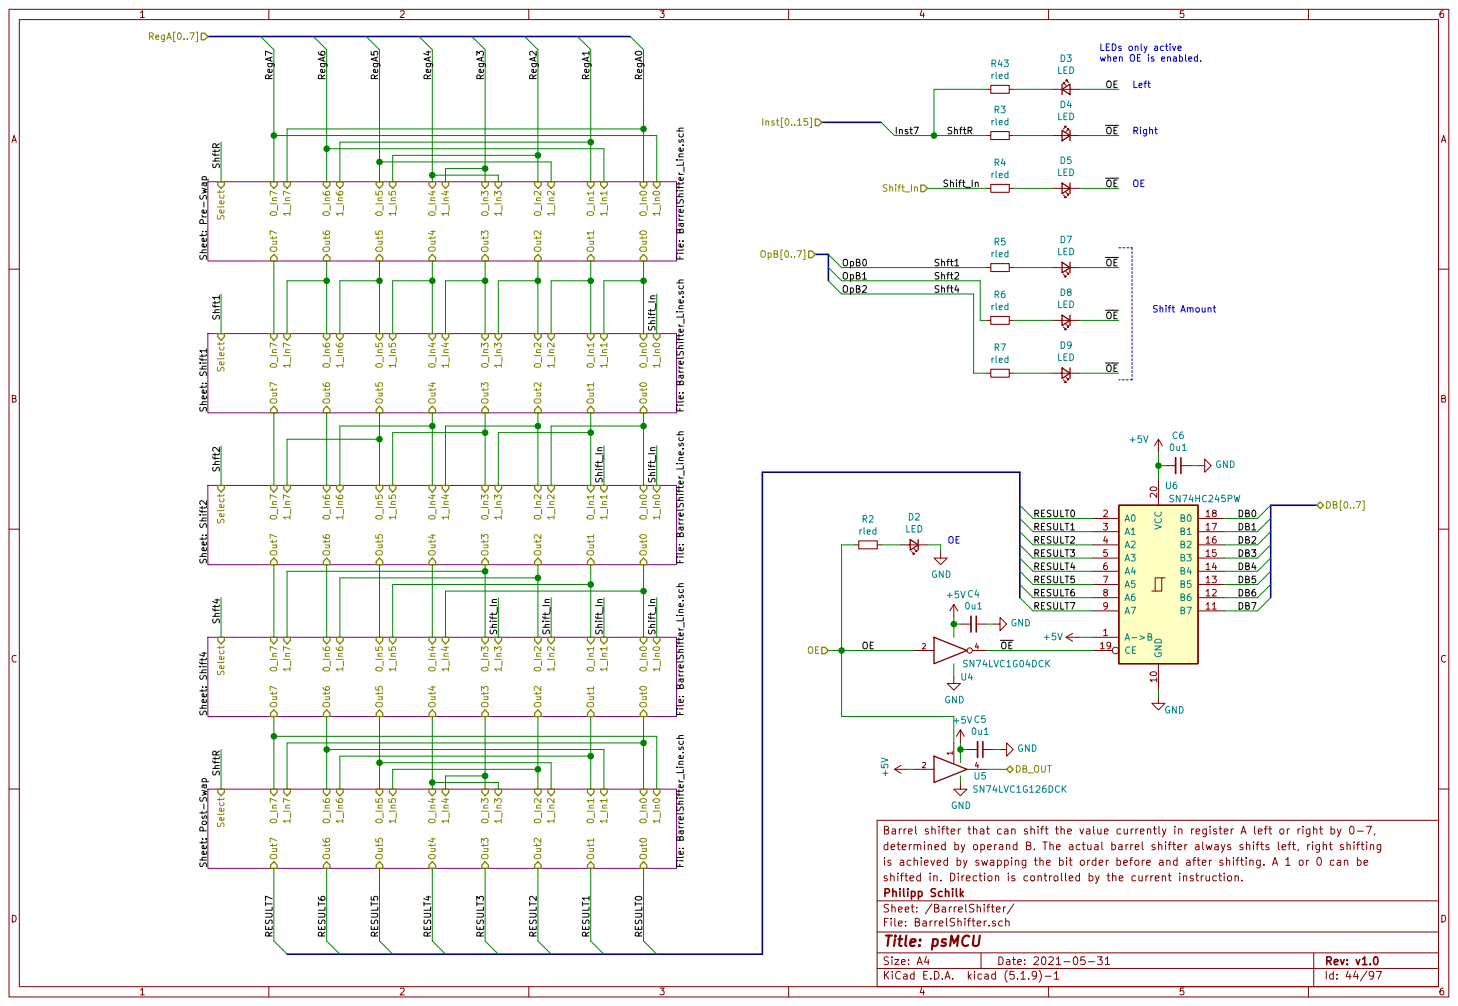
[picture p54: page 44]

determined by operand B. The actual barrel shifter always shifts left, right shifting
is achieved by swapping the bit order before and after shifting. A 1 or 0 can be
shifted in. Direction is controlled by the current instruction.
File: BarrelShifter.sch Sheet: /BarrelShifter/ Philipp Schilk

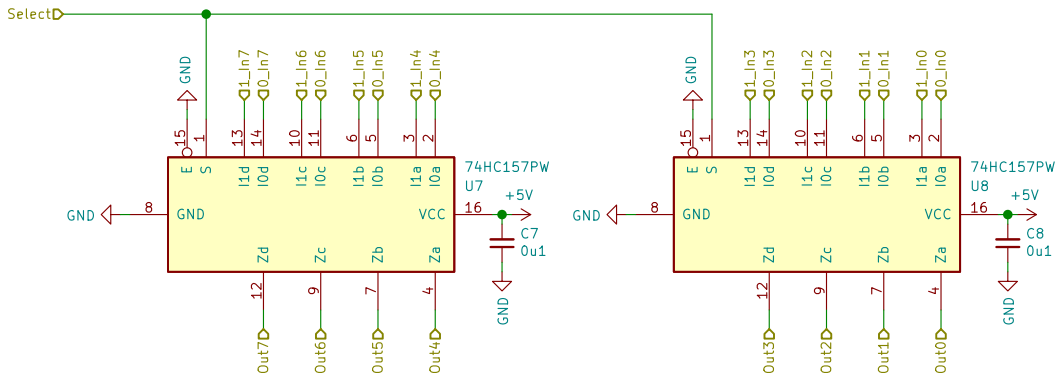
[picture p55: page 45]

A line of 8 2in-1out multiplexers used multiple times in the barrel shifter.

File: BarrelShifter_Line.sch Sheet: /BarrelShifter/Shift2/ Philipp Schilk

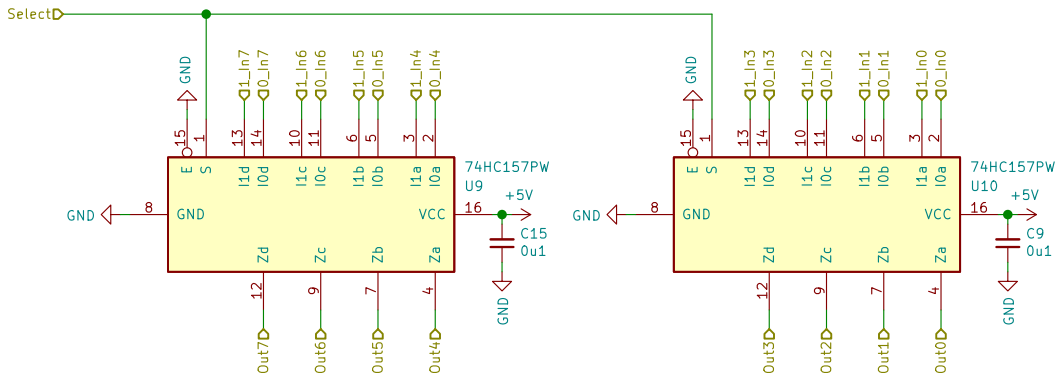
[picture p56: page 46]

A line of 8 2in-1out multiplexers used multiple times in the barrel shifter.

File: BarrelShifter_Line.sch Sheet: /BarrelShifter/Shift4/ Philipp Schilk

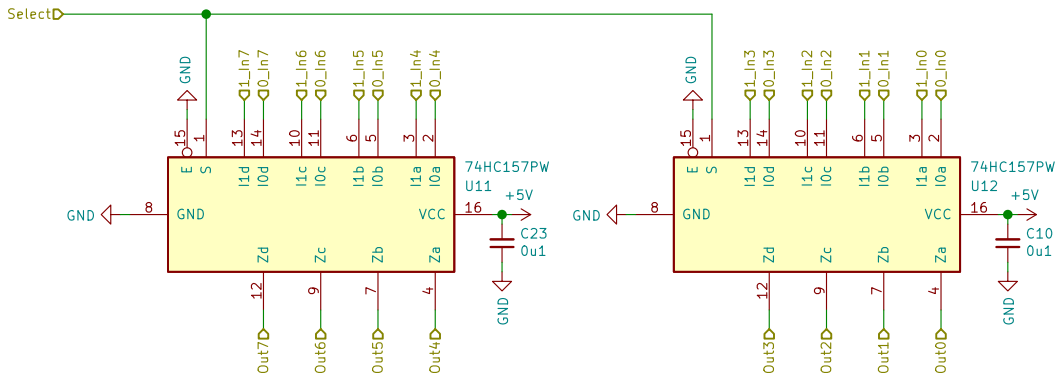
[picture p57: page 47]

A line of 8 2in-1out multiplexers used multiple times in the barrel shifter.

Philipp Schilk
Sheet: /BarrelShifter/Post-Swap/
File: BarrelShifter_Line.sch
Id: 47/97 Title: psMCU

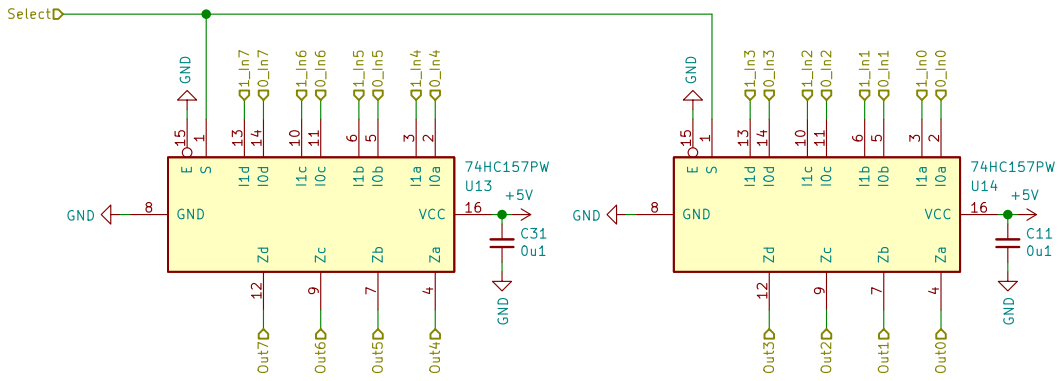
[picture p58: page 48]

A line of 8 2in-1out multiplexers used multiple times in the barrel shifter.

Philipp Schilk
Sheet: /BarrelShifter/Pre-Swap/
File: BarrelShifter_Line.sch
Id: 48/97 Title: psMCU

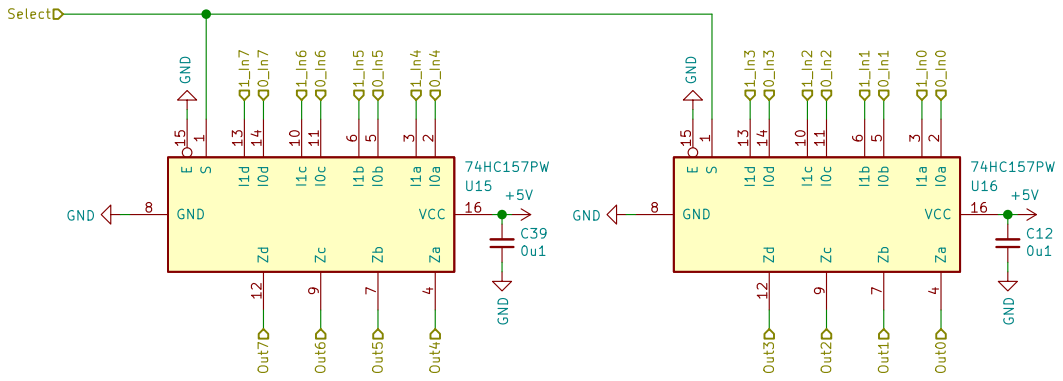
[picture p59: page 49]

A line of 8 2in-1out multiplexers used multiple times in the barrel shifter.

File: BarrelShifter_Line.sch Sheet: /BarrelShifter/Shift1/ Philipp Schilk

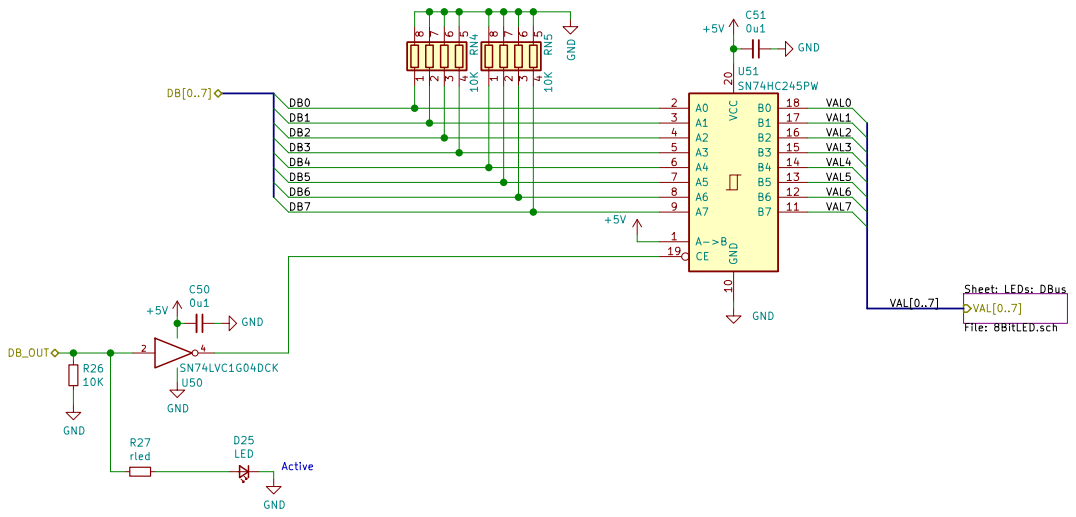
[picture p60: page 50]

Displays the current value on the DBus if a different module is providing one (indicated Sheet: LEDs: DBus File: 8BitLED.sch VAL[0..7] GND

Philipp Schilk
Sheet: /Data Bus Display/
File: DBUS_DISPLAY.sch
Id: 50/97 Title: psMCU

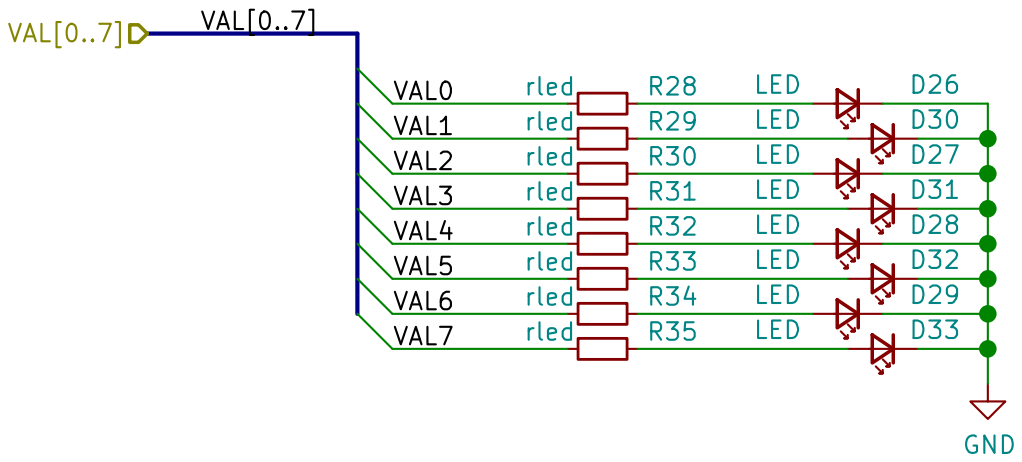
[picture p61: page 51]

Philipp Schilk
File: 8BitLED.sch Sheet: /Data Bus Display/LEDs: DBus /
Id: 51/97 Title: psMCU

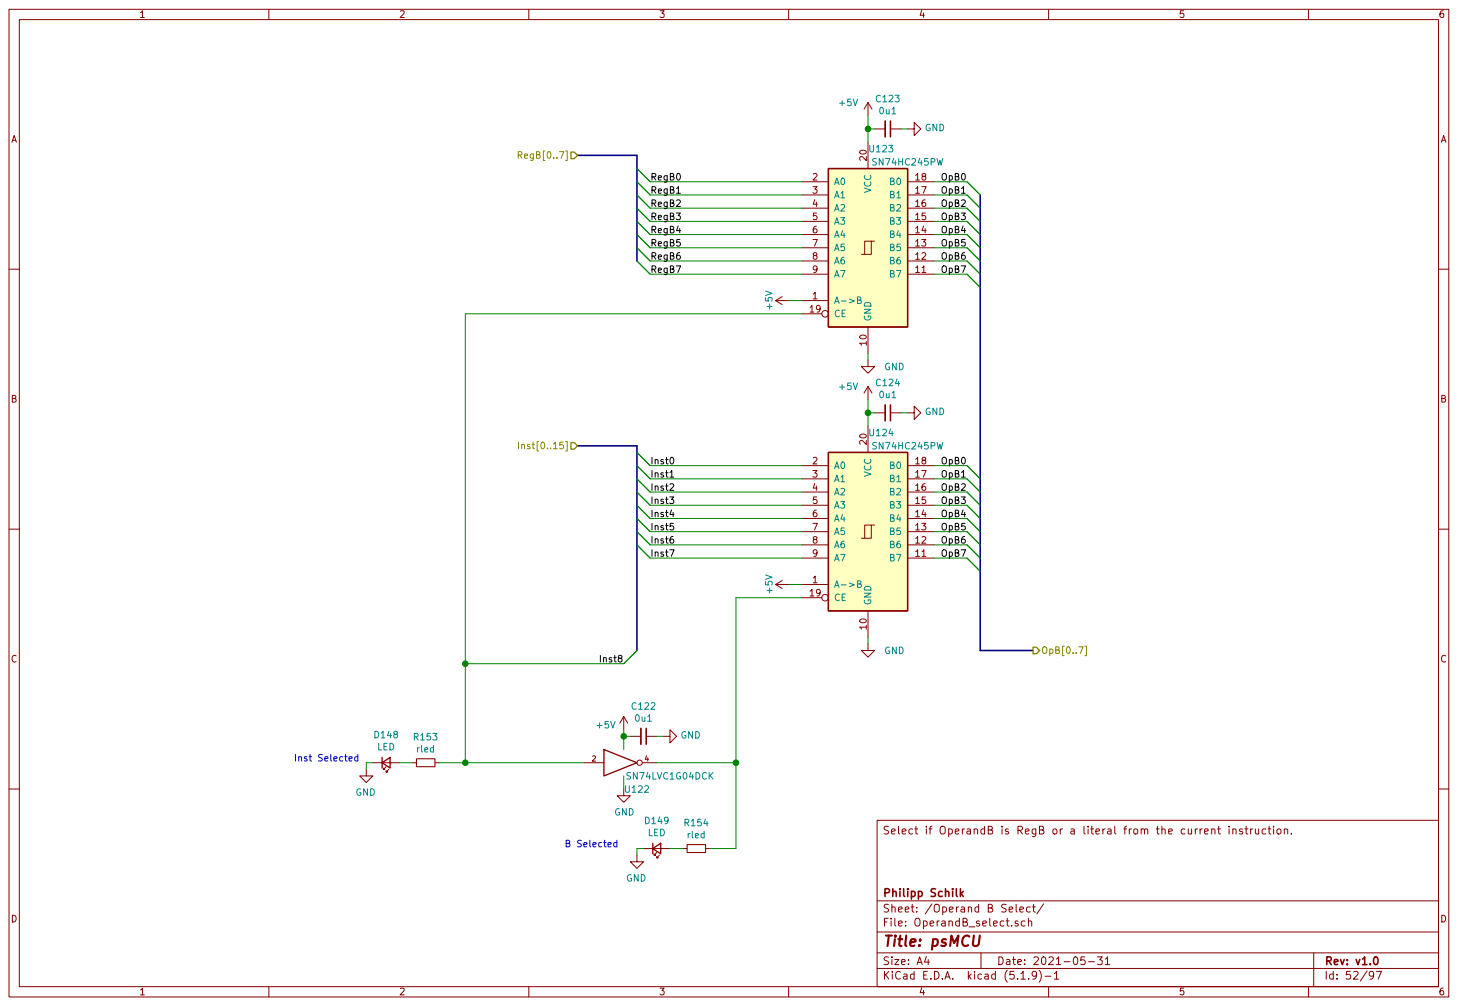
[picture p62: page 52]

Select if OperandB is RegB or a literal from the current instruction. GND

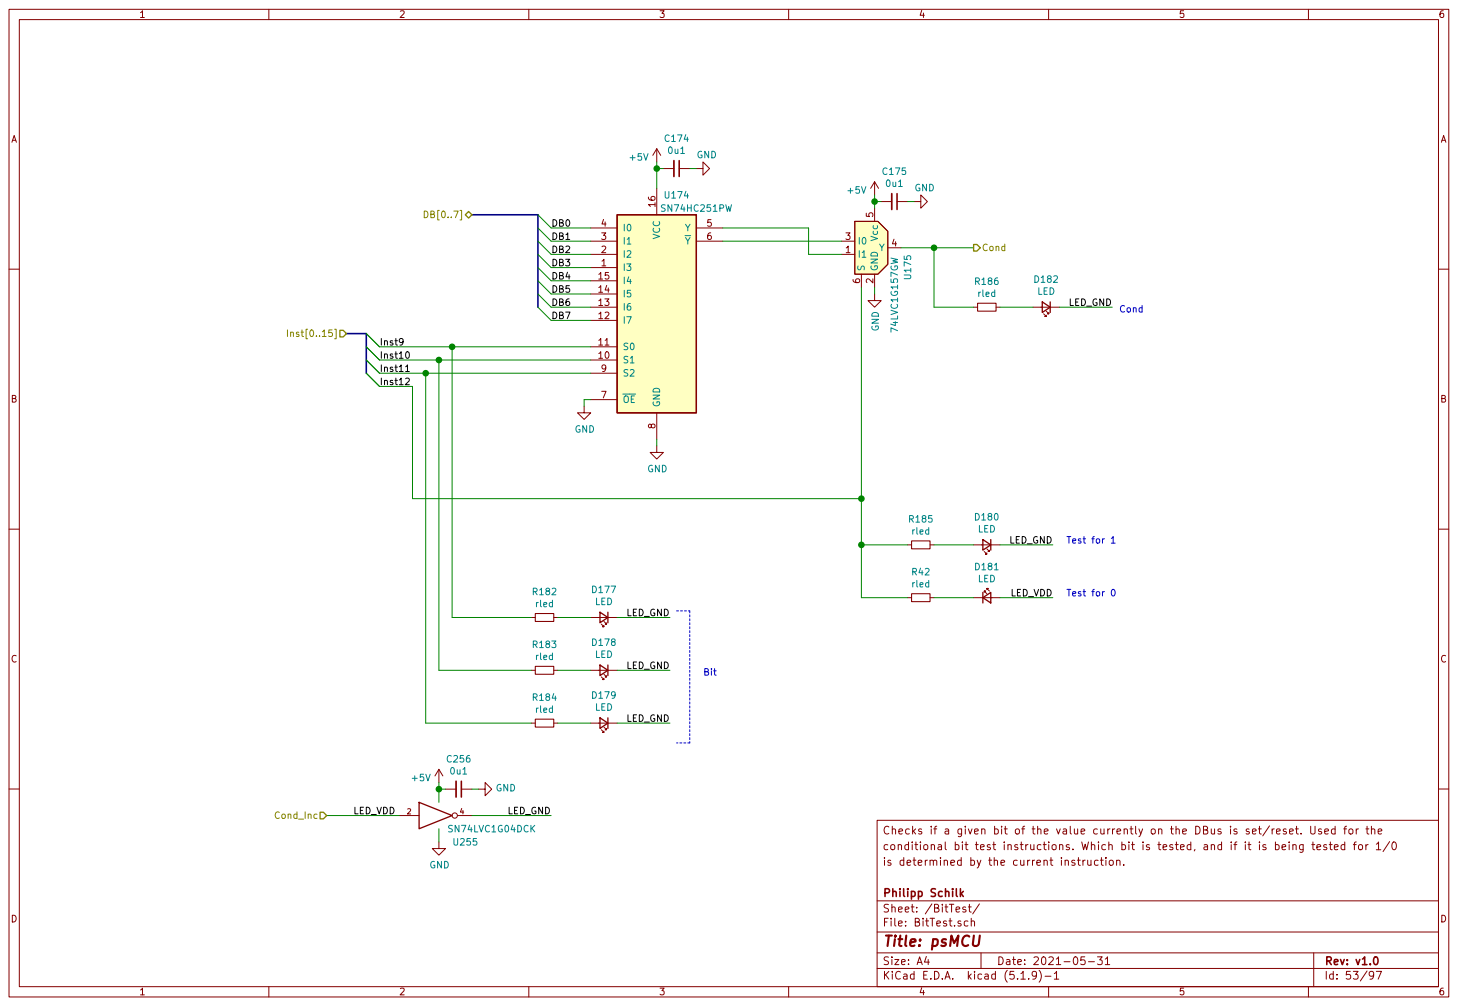
[picture p63: page 53]

Checks if a given bit of the value currently on the DBus is set/reset. Used for the GND

conditional bit test instructions. Which bit is tested, and if it is being tested for 1/0
is determined by the current instruction.

File: BitTest.sch Sheet: /BitTest/ Philipp Schilk

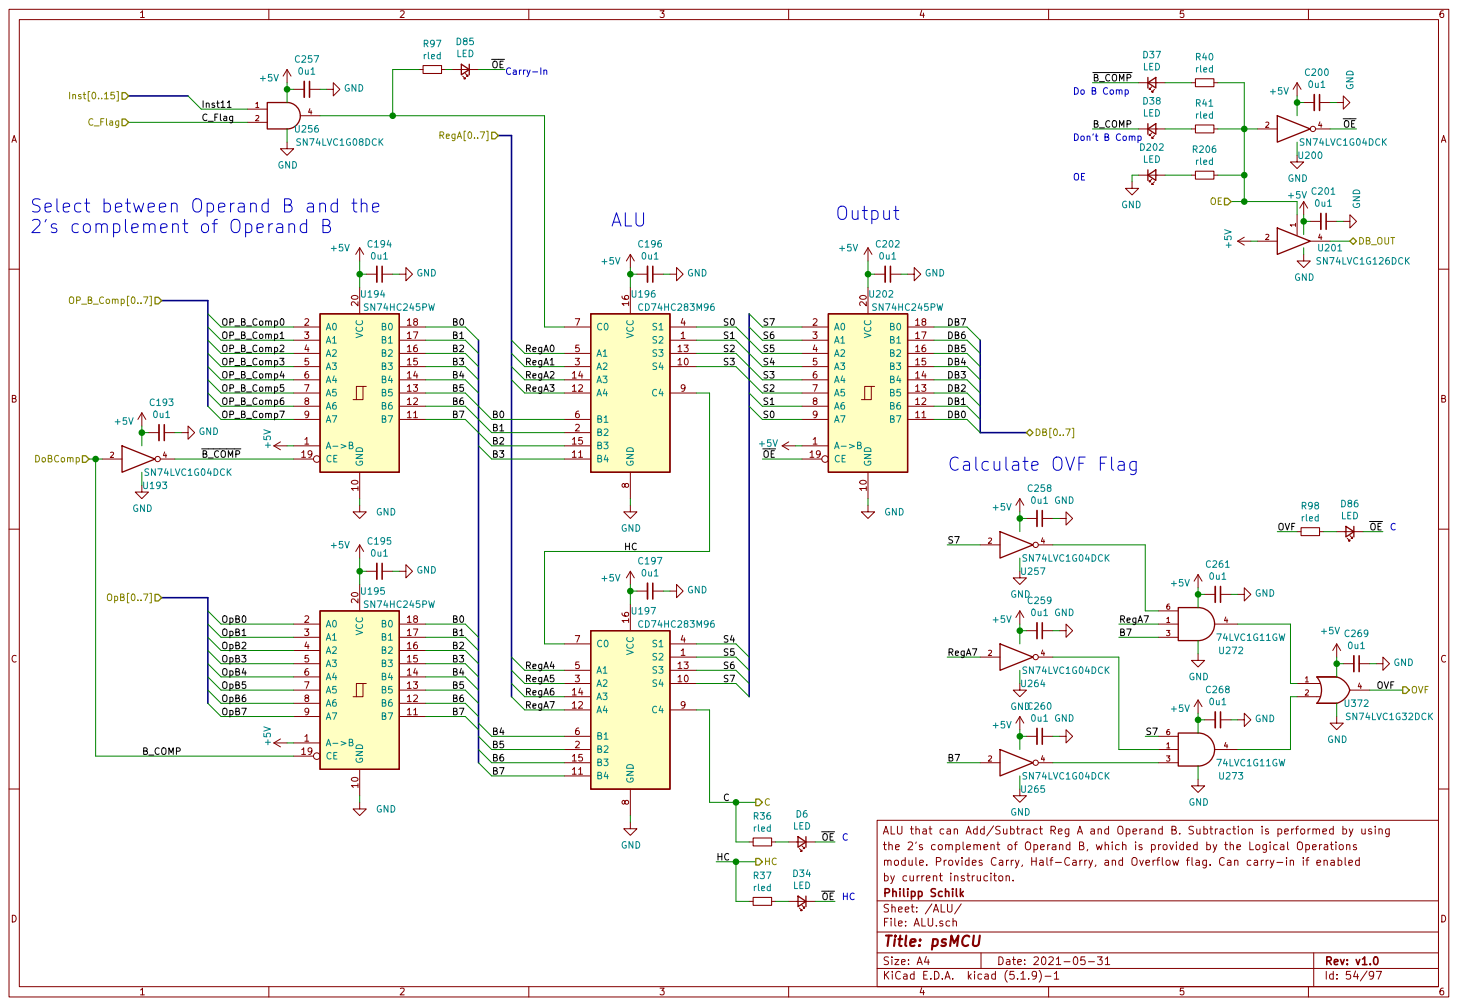
[picture p64: page 54]

Select between Operand B and the

ALU that can Add/Subtract Reg A and Operand B. Subtraction is performed by using
the 2's complement of Operand B, which is provided by the Logical Operations
module. Provides Carry, Half-Carry, and Overflow flag. Can carry-in if enabled
by current instruciton.
File: ALU.sch Sheet: /ALU/ Philipp Schilk

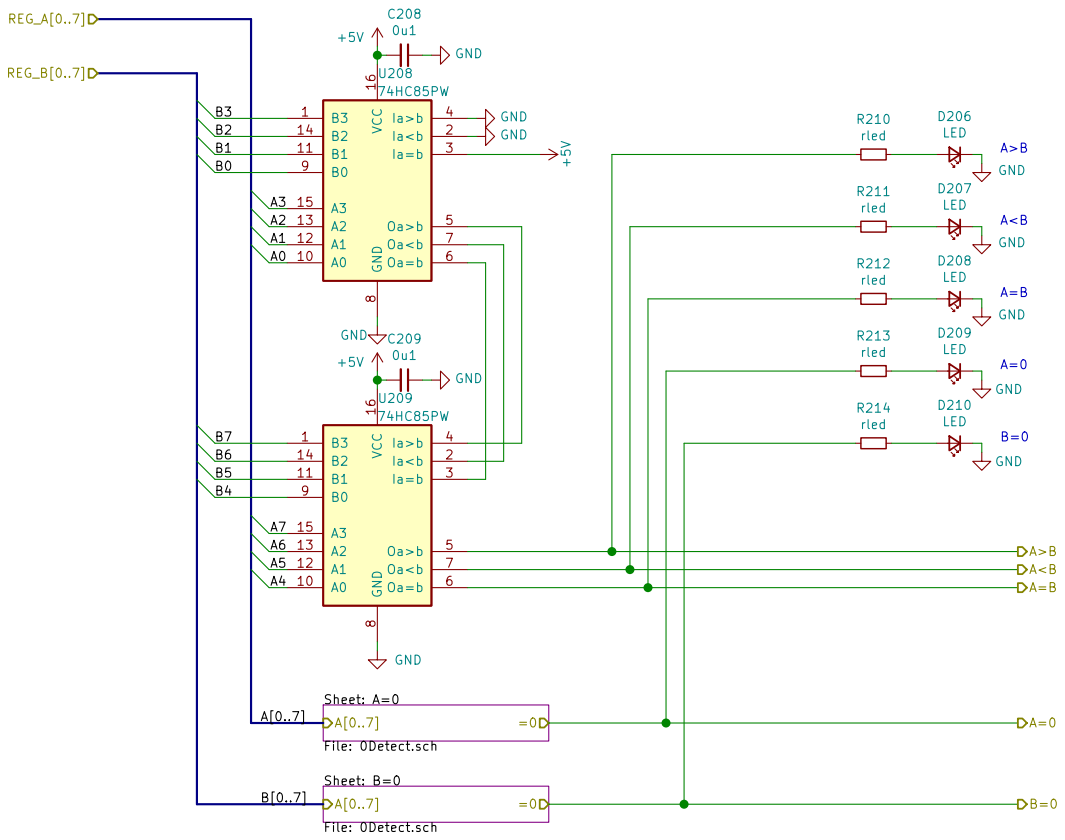
[picture p65: page 55]

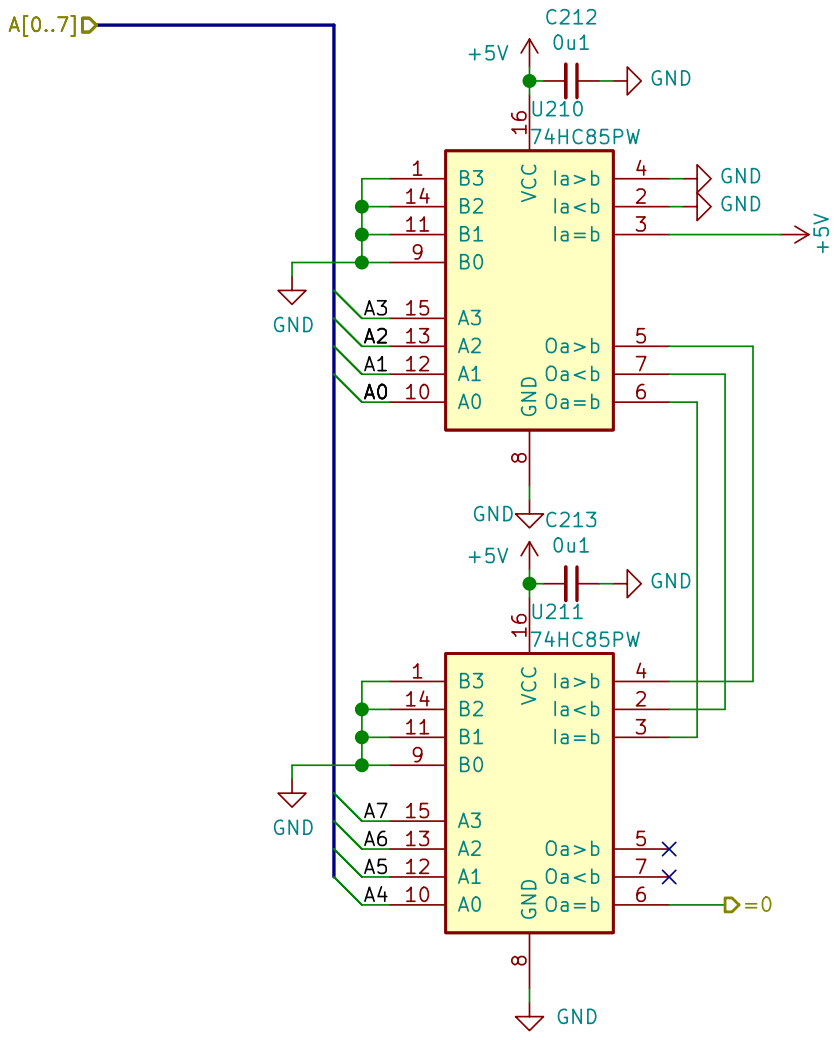
[picture p66: page 56]

Test if the input value is equal to 0. +5V GND
0u1 GND GND GND

Philipp Schilk
File: 0Detect.sch Sheet: /Comparator.sch/A=0/
Id: 56/97 Title: psMCU

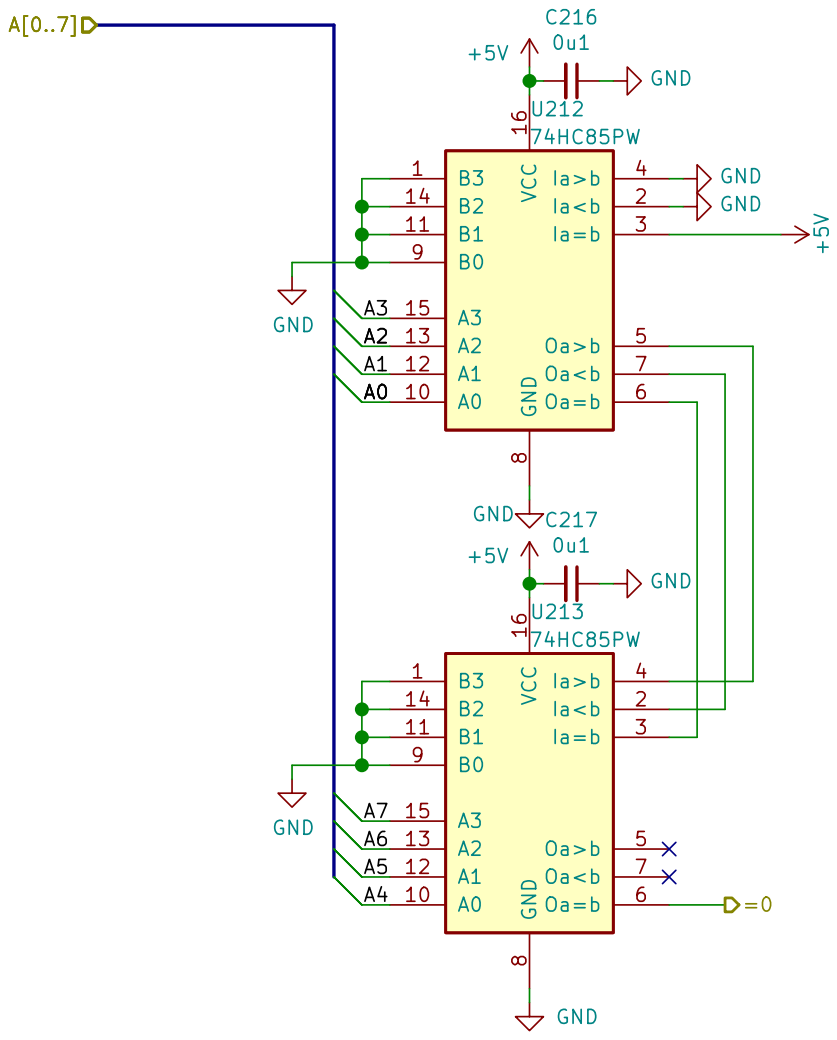
[picture p67: page 57]

Test if the input value is equal to 0. +5V GND
0u1 GND GND GND

Philipp Schilk
File: 0Detect.sch Sheet: /Comparator.sch/B=0/
Id: 57/97 Title: psMCU

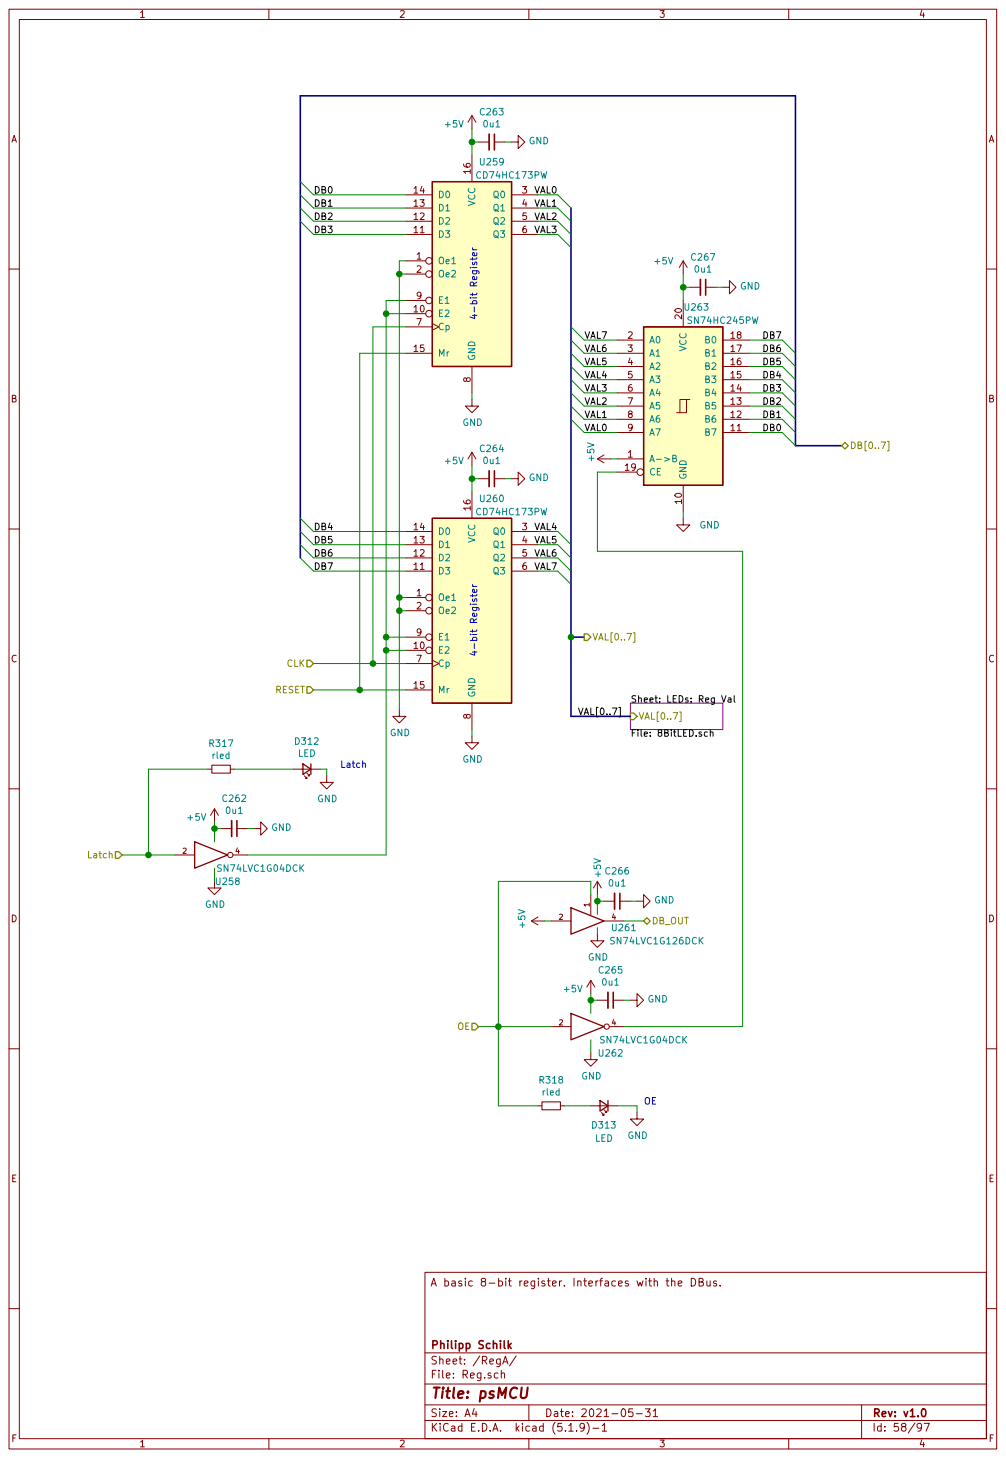
[picture p68: page 58]

Sheet: LEDs: Reg Val File: 8BitLED.sch VAL[0..7] C262

A basic 8-bit register. Interfaces with the DBus.

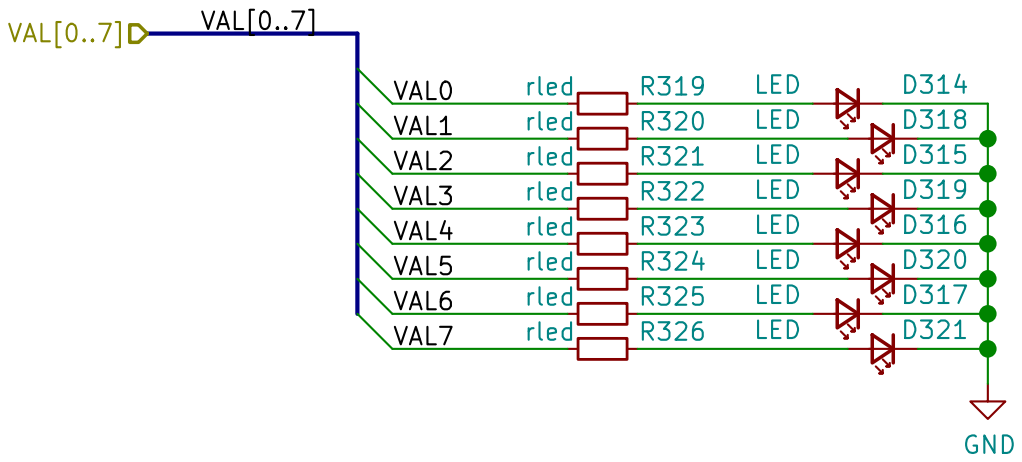
[picture p69: page 59]

Philipp Schilk
File: 8BitLED.sch Sheet: /RegA/LEDs: Reg Val/
Id: 59/97 Title: psMCU

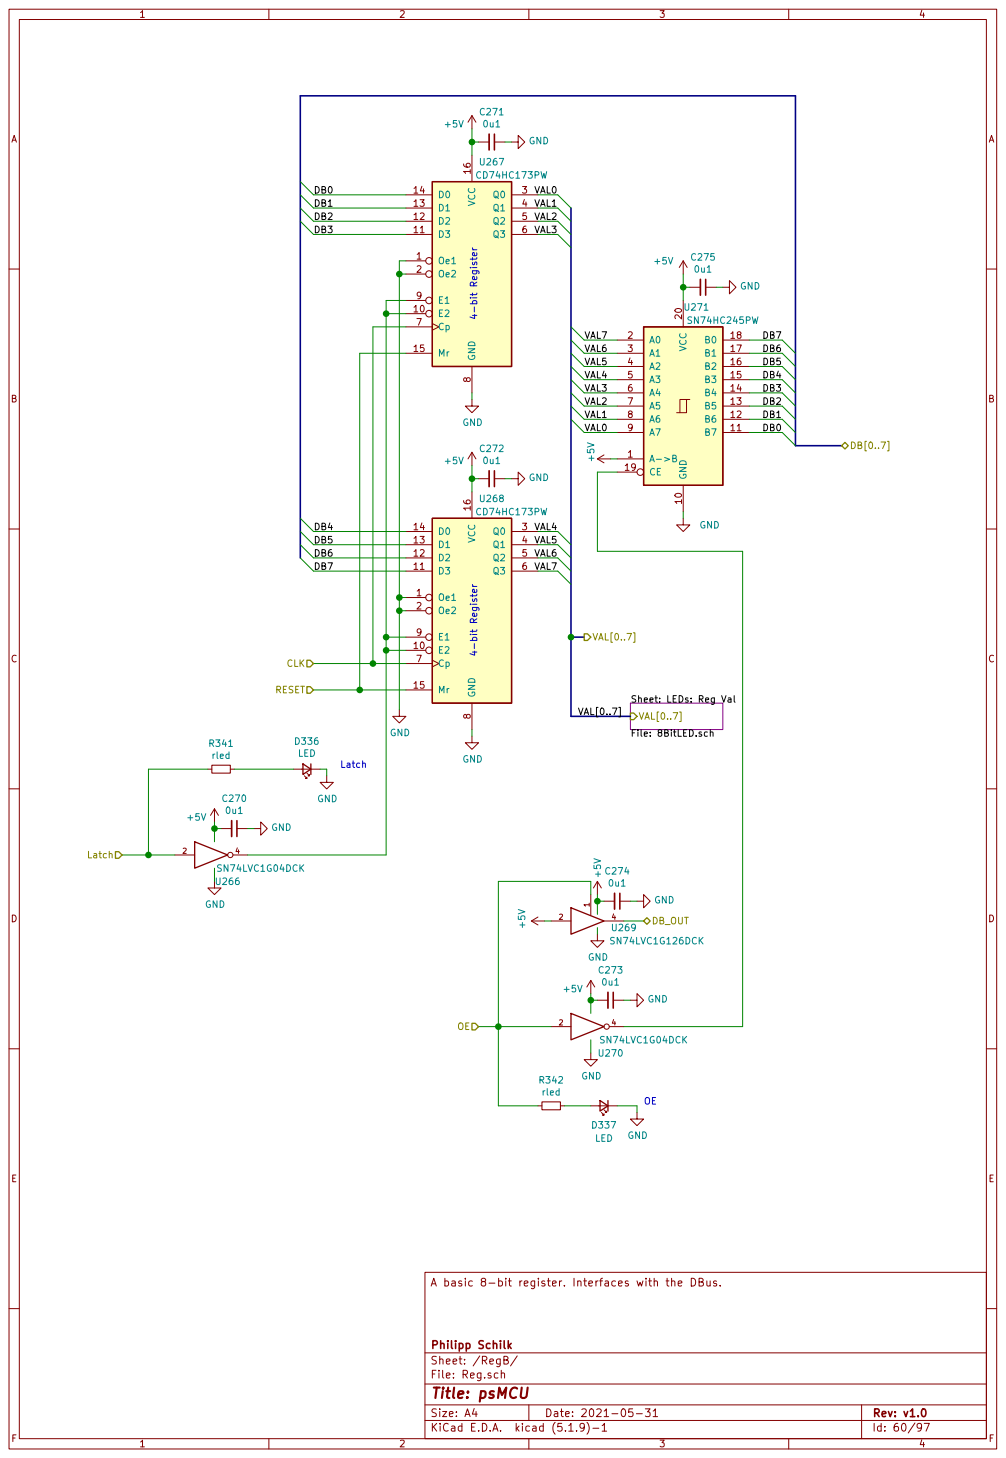
[picture p70: page 60]

Sheet: LEDs: Reg Val File: 8BitLED.sch VAL[0..7] C270

A basic 8-bit register. Interfaces with the DBus.

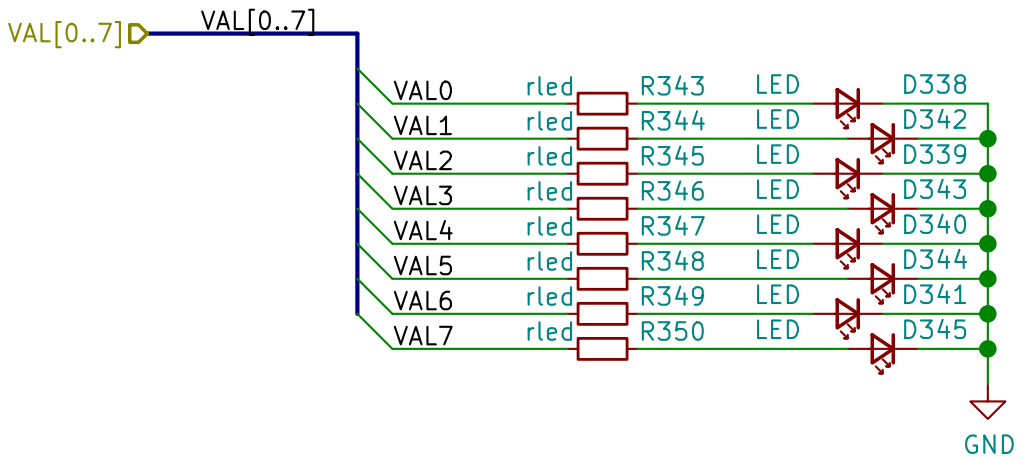
[picture p71: page 61]

Philipp Schilk
File: 8BitLED.sch Sheet: /RegB/LEDs: Reg Val/
Id: 61/97 Title: psMCU

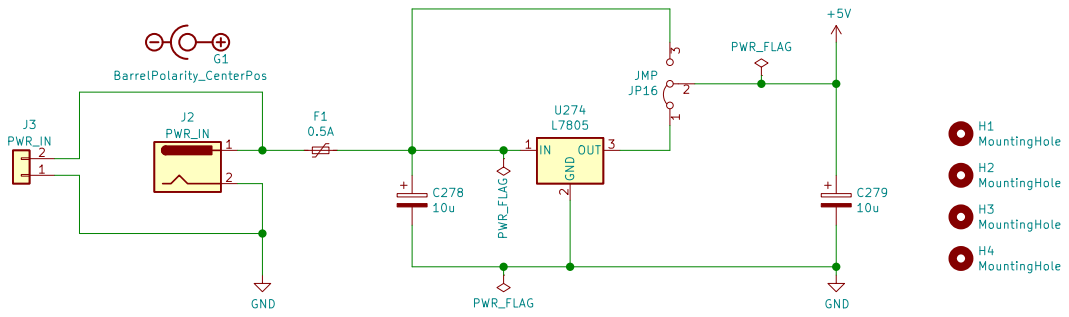
[picture p72: page 62]

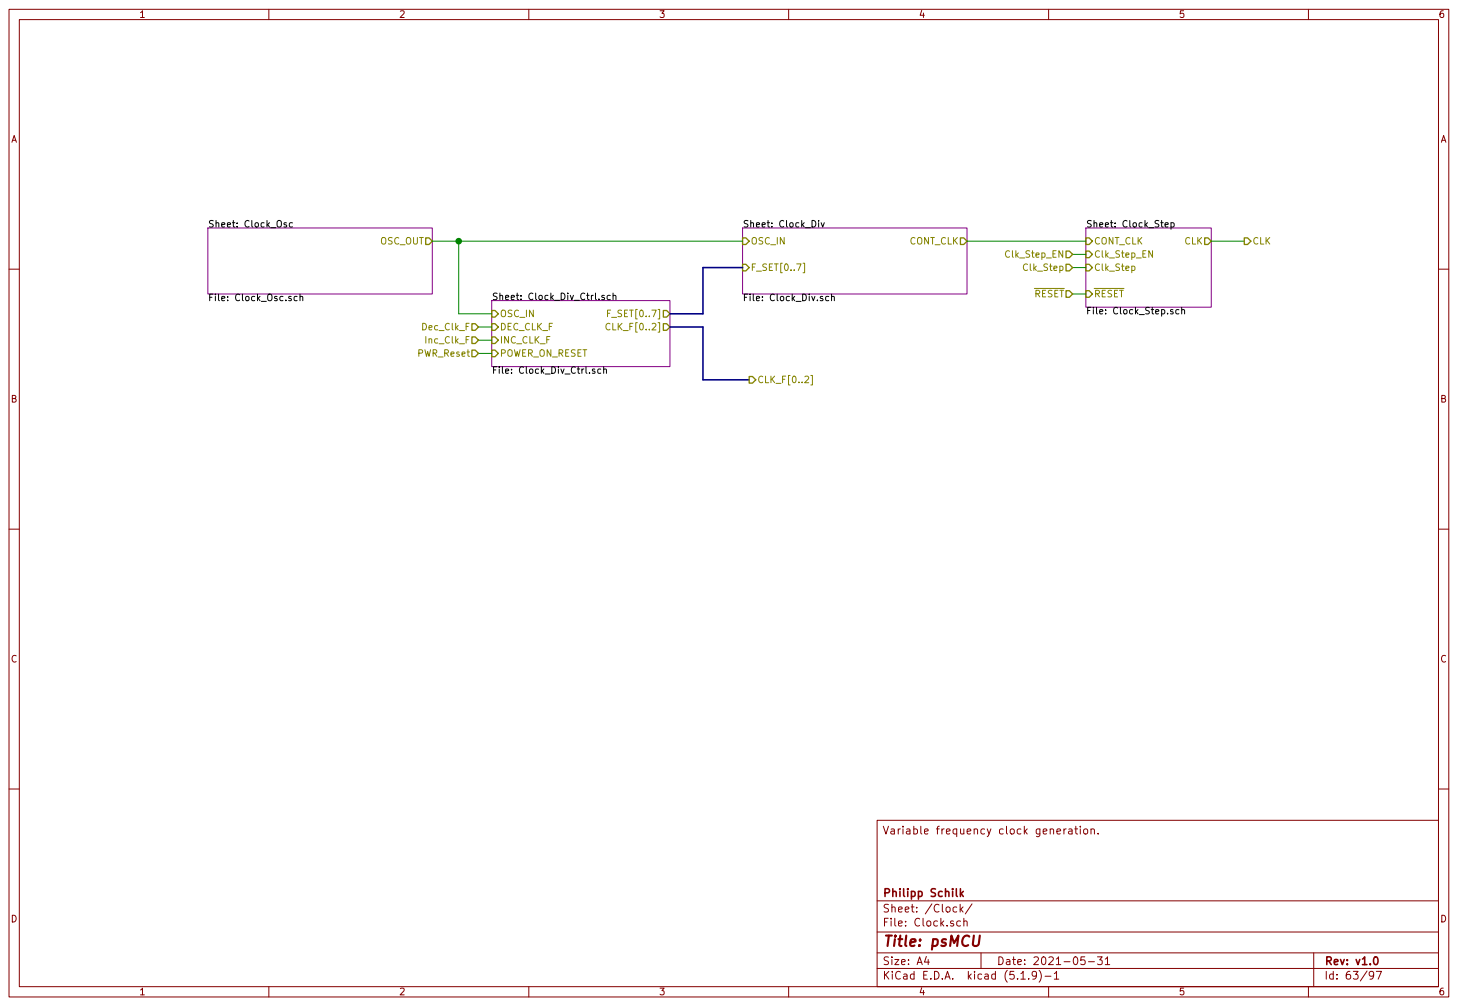
[picture p73: page 63]

Variable frequency clock generation.

File: Clock.sch Sheet: /Clock/ Philipp Schilk

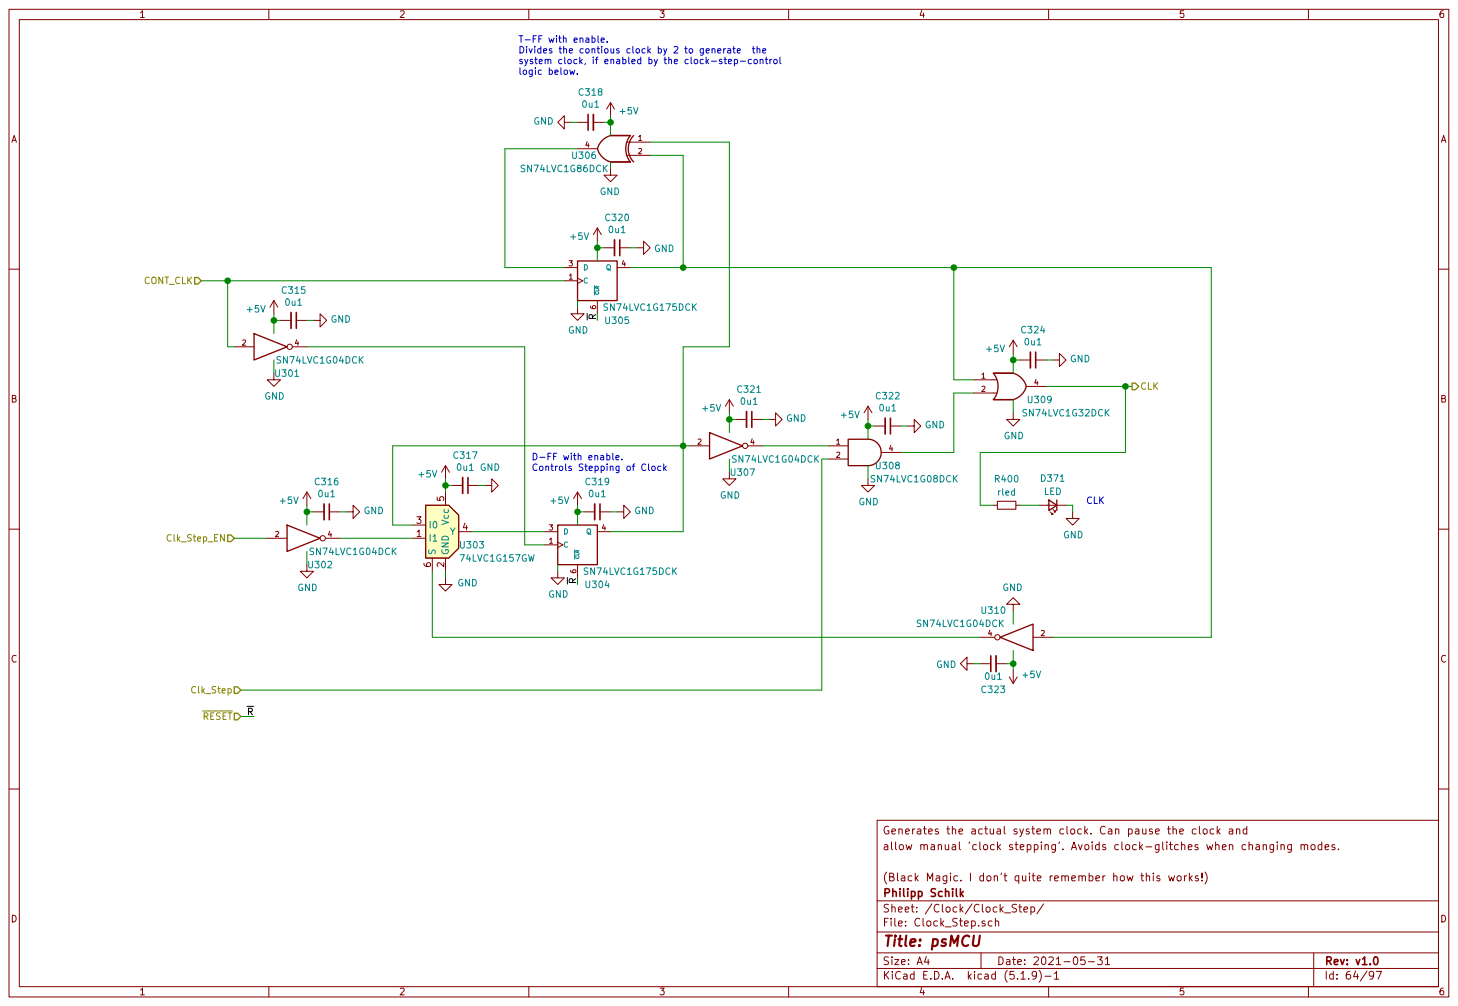
[picture p74: page 64]

T-FF with enable. Divides the contious clock by 2 to generate the

system clock, if enabled by the clock-step-control
logic below.

CLK D-FF with enable. Controls Stepping of Clock

Generates the actual system clock. Can pause the clock and GND

allow manual 'clock stepping'. Avoids clock-glitches when changing modes.

(Black Magic. I don't quite remember how this works!)
Philipp Schilk
Sheet: /Clock/Clock_Step/
File: Clock_Step.sch
Id: 64/97 Title: psMCU

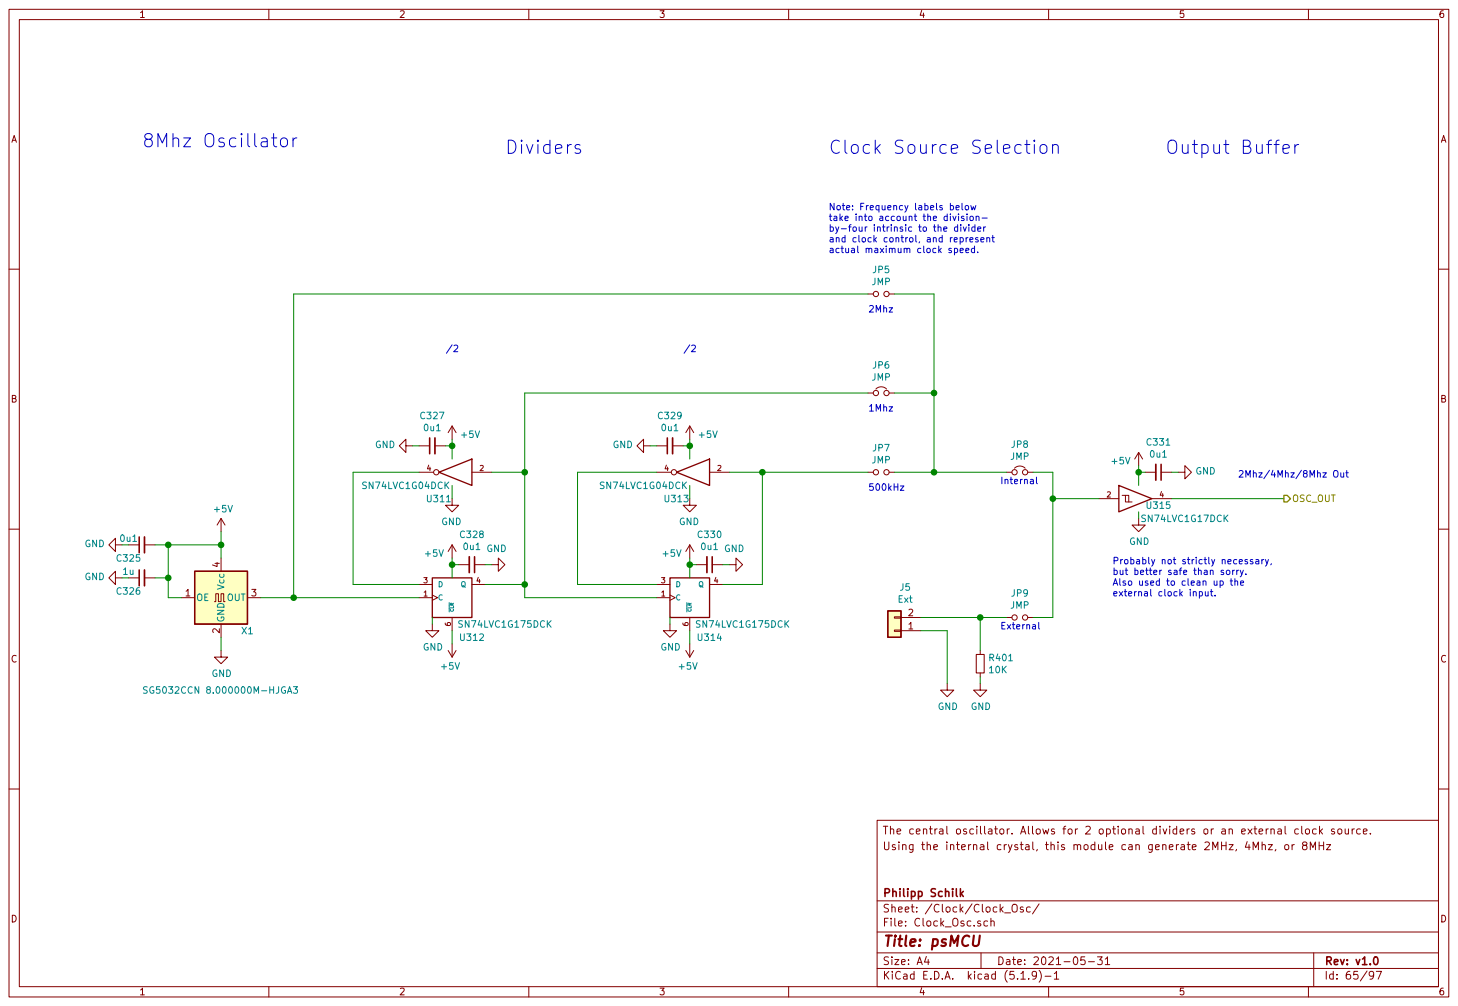
[picture p75: page 65]

take into account the division- by-four intrinsic to the divider

and clock control, and represent
actual maximum clock speed.

The central oscillator. Allows for 2 optional dividers or an external clock source. GND

but better safe than sorry.
Also used to clean up the
external clock input.

Using the internal crystal, this module can generate 2MHz, 4Mhz, or 8MHz

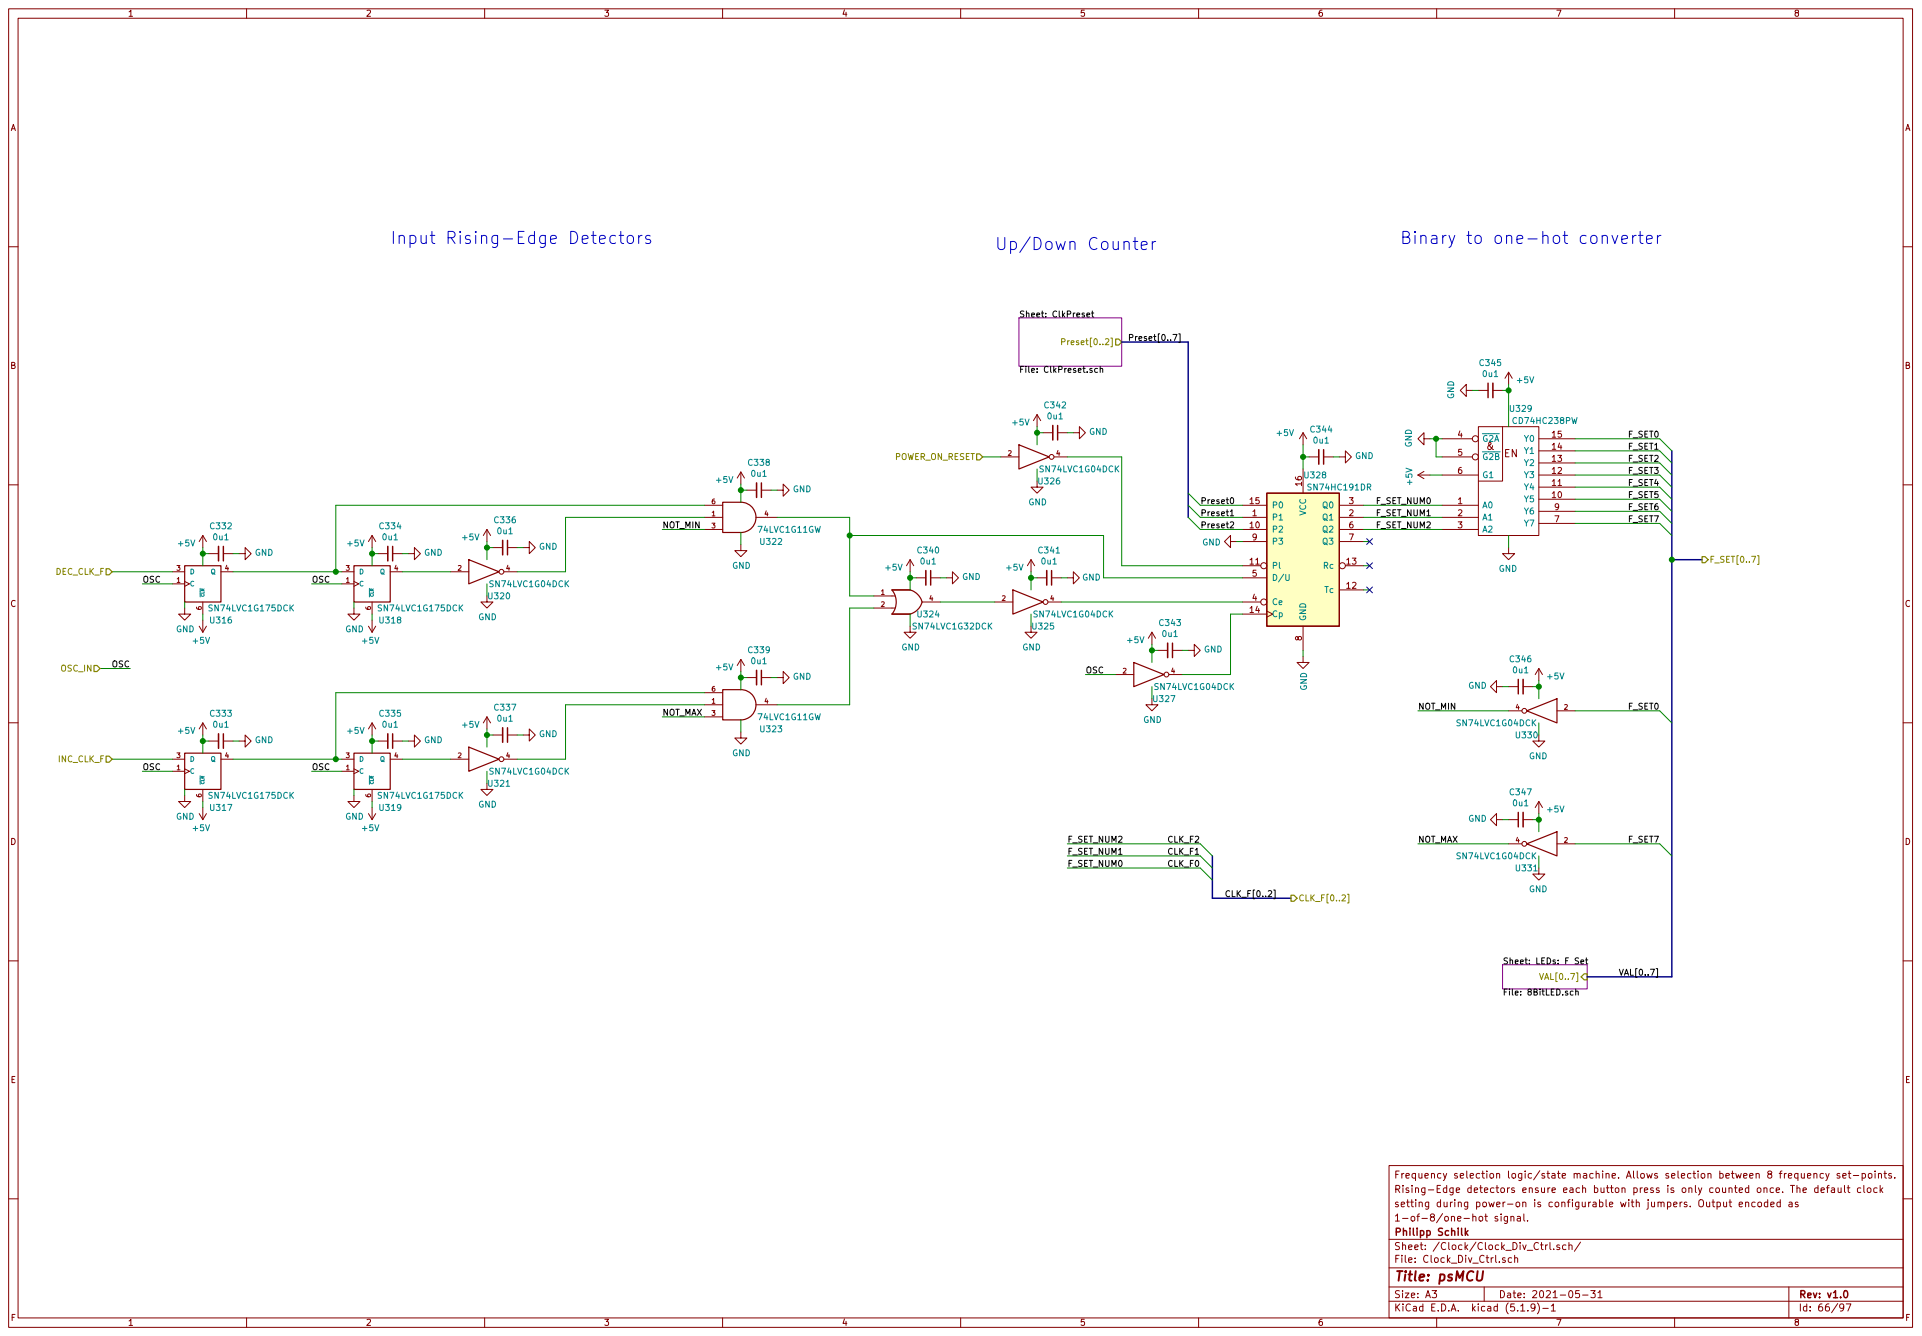
[picture p76: page 66]

Sheet: ClkPreset File: ClkPreset.sch Preset[0..2]

Sheet: LEDs: F Set File: 8BitLED.sch VAL[0..7]

Frequency selection logic/state machine. Allows selection between 8 frequency set-points.
Rising-Edge detectors ensure each button press is only counted once. The default clock
setting during power-on is configurable with jumpers. Output encoded as
1-of-8/one-hot signal.
Philipp Schilk
Sheet: /Clock/Clock_Div_Ctrl.sch/
File: Clock_Div_Ctrl.sch
Id: 66/97 Title: psMCU

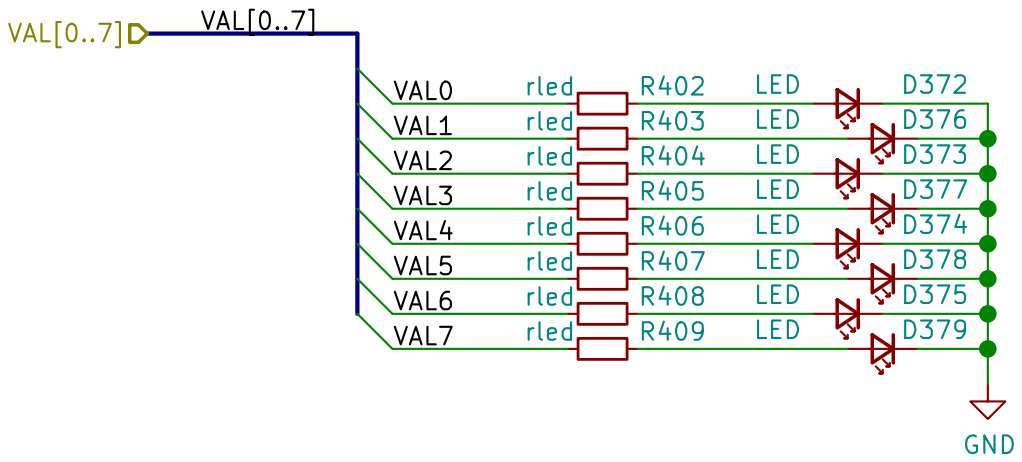
[picture p77: page 67]

Philipp Schilk
File: 8BitLED.sch Sheet: /Clock/Clock_Div_Ctrl.sch/LEDs: F Set/
Id: 67/97 Title: psMCU

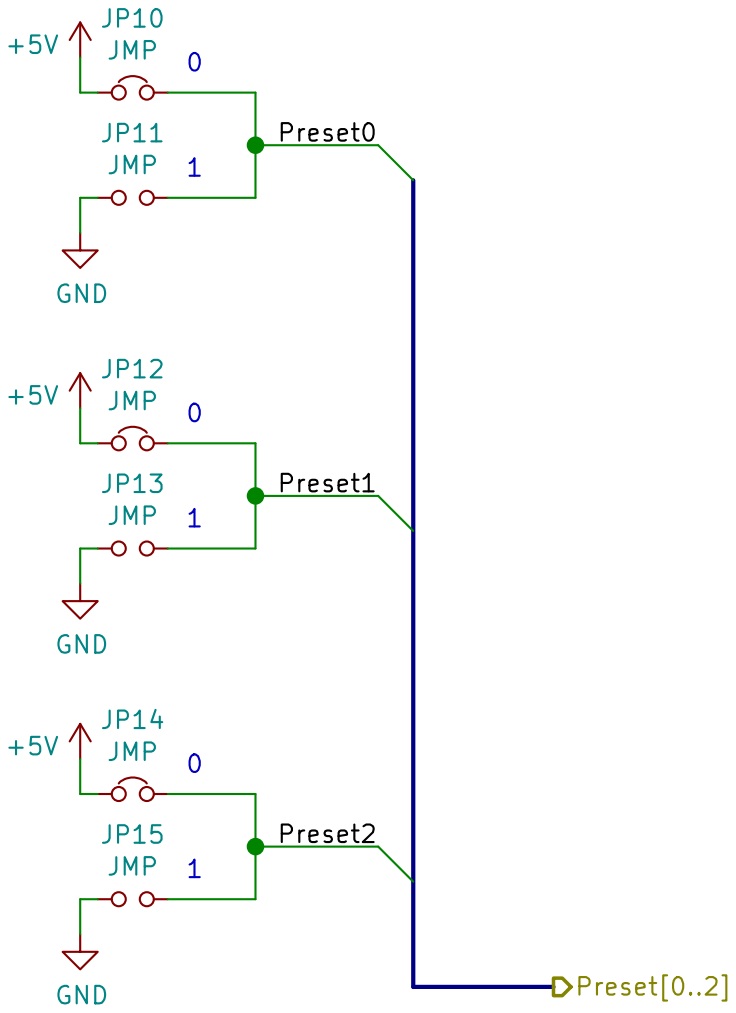
[picture p78: page 68]

Jumpers to configure default clock frequency after power-on.

Philipp Schilk
File: ClkPreset.sch Sheet: /Clock/Clock_Div_Ctrl.sch/ClkPreset/
Id: 68/97 Title: psMCU

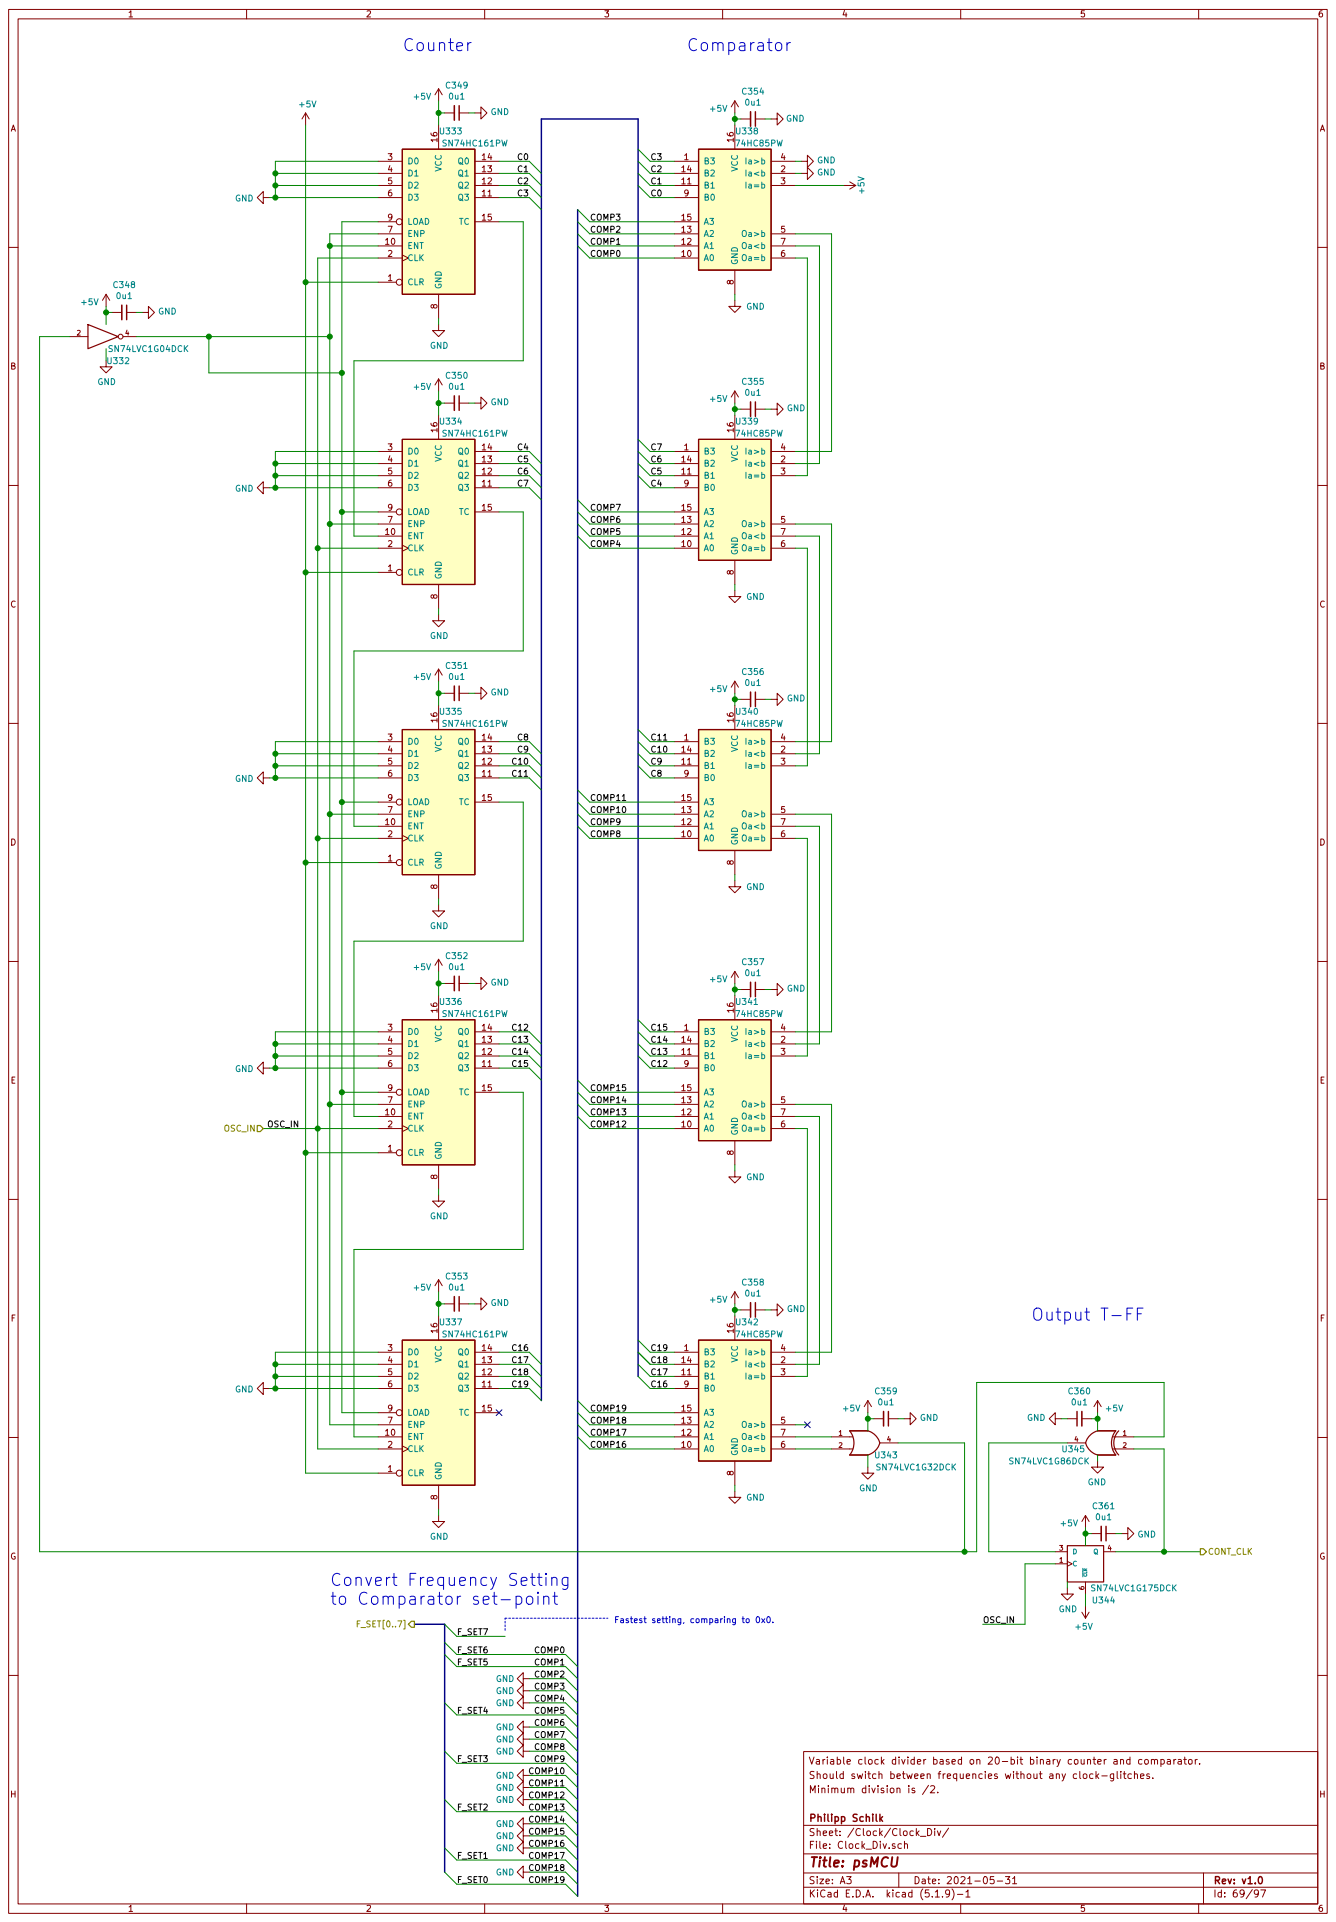
[picture p79: page 69]

Convert Frequency Setting
to Comparator set-point

Variable clock divider based on 20-bit binary counter and comparator.
Philipp Schilk Minimum division is /2. Should switch between frequencies without any clock-glitches.

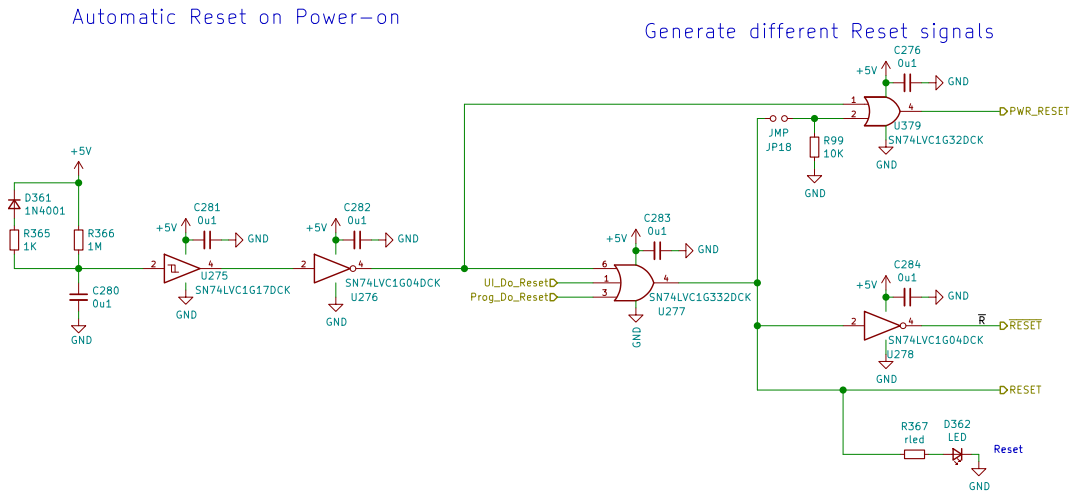
[picture p80: page 70]

Reset Generate different Reset signals Automatic Reset on Power-on

Generates reset during power-on and combines the different reset sources to
generate the RESET and RESET signals used globally.

File: ResetCtrl.sch Sheet: /ResetCtrl/ Philipp Schilk

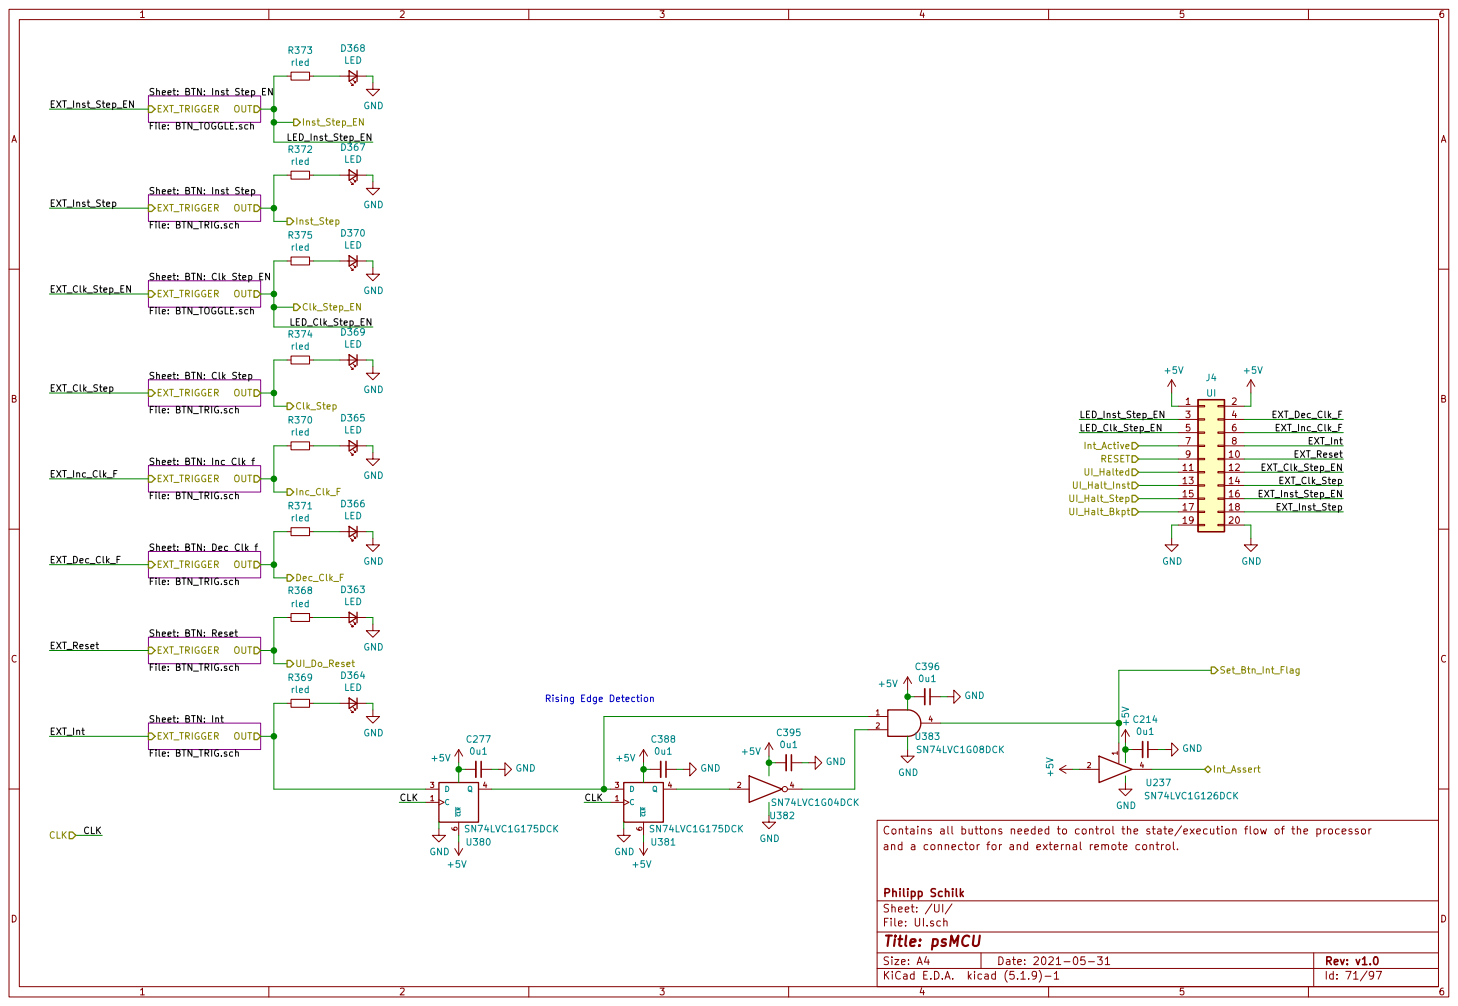
[picture p81: page 71]

LED
File: BTN_TOGGLE.sch EXT_TRIGGER OUT Sheet: BTN: Inst Step EN
File: BTN_TOGGLE.sch EXT_TRIGGER OUT Sheet: BTN: Inst Step File: BTN_TRIG.sch EXT_TRIGGER OUT Sheet: BTN: Int File: BTN_TRIG.sch EXT_TRIGGER OUT Sheet: BTN: Clk Step File: BTN_TRIG.sch EXT_TRIGGER OUT Sheet: BTN: Dec Clk f File: BTN_TRIG.sch EXT_TRIGGER OUT Sheet: BTN: Reset File: BTN_TRIG.sch EXT_TRIGGER OUT
UI_Do_Reset Clk_Step_EN
LED_Clk_Step_EN

and a connector for and external remote control. Contains all buttons needed to control the state/execution flow of the processor Sheet: BTN: Inc Clk f File: BTN_TRIG.sch EXT_TRIGGER OUT Sheet: BTN: Clk Step EN

File: UI.sch Sheet: /UI/ Philipp Schilk

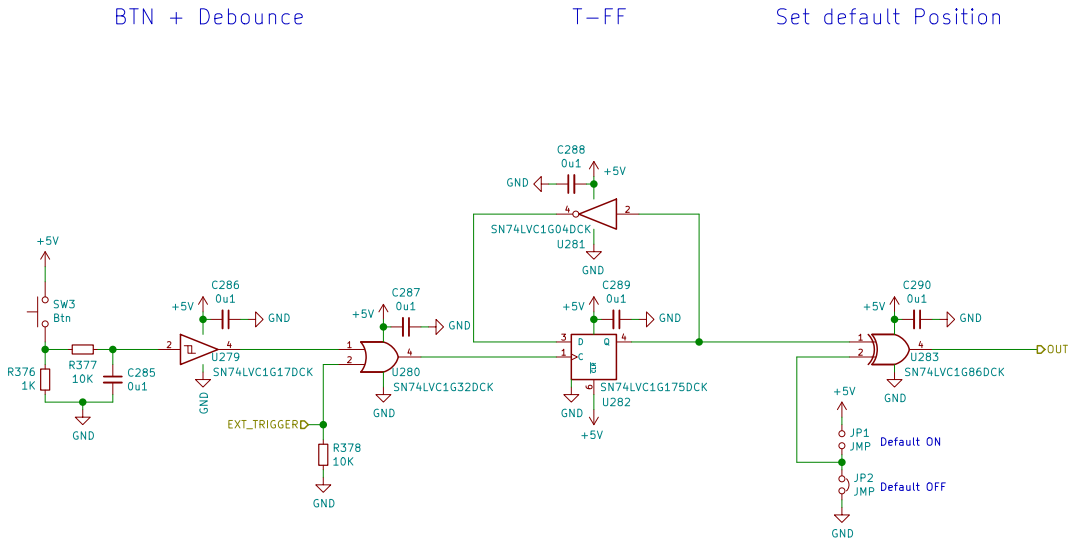
[picture p82: page 72]

A button that toggles a state on/off. Handles de-bounce and combines the signal +5V C289

from an external remote control. Allows for the default state during power-on
to be set by jumpers

Philipp Schilk
Sheet: /UI/BTN: Inst Step EN/
File: BTN_TOGGLE.sch
Id: 72/97 Title: psMCU

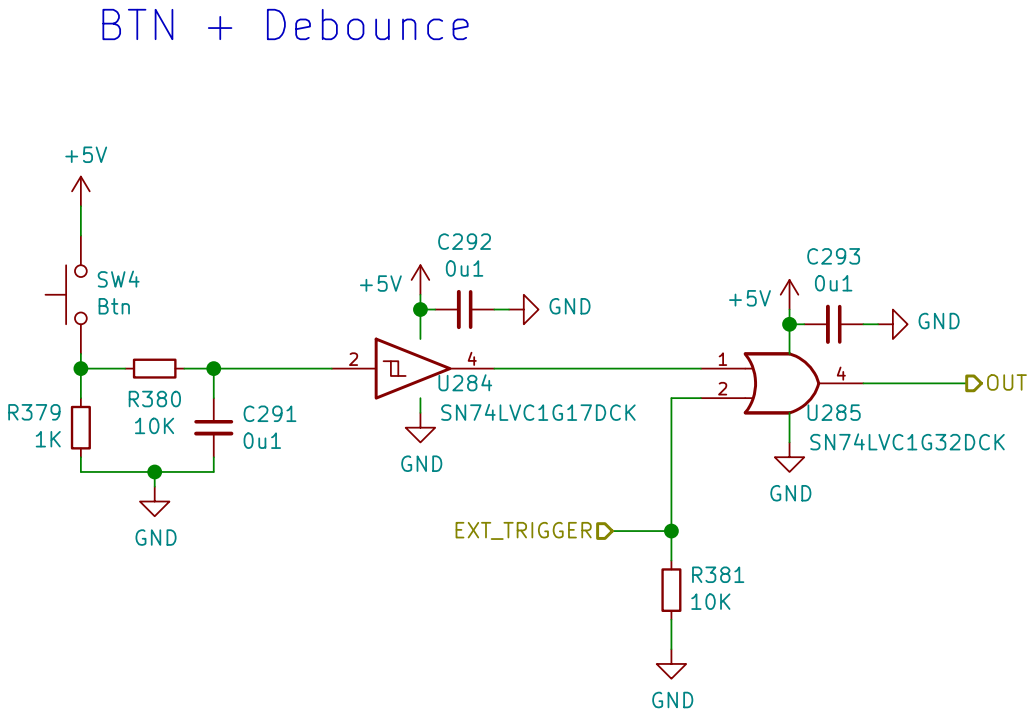
[picture p83: page 73]

from an external remote. A simple single-trigger button. Handles de-bouncing and also combines the signal C291

Philipp Schilk
Sheet: /UI/BTN: Inst Step/
File: BTN_TRIG.sch
Id: 73/97 Title: psMCU

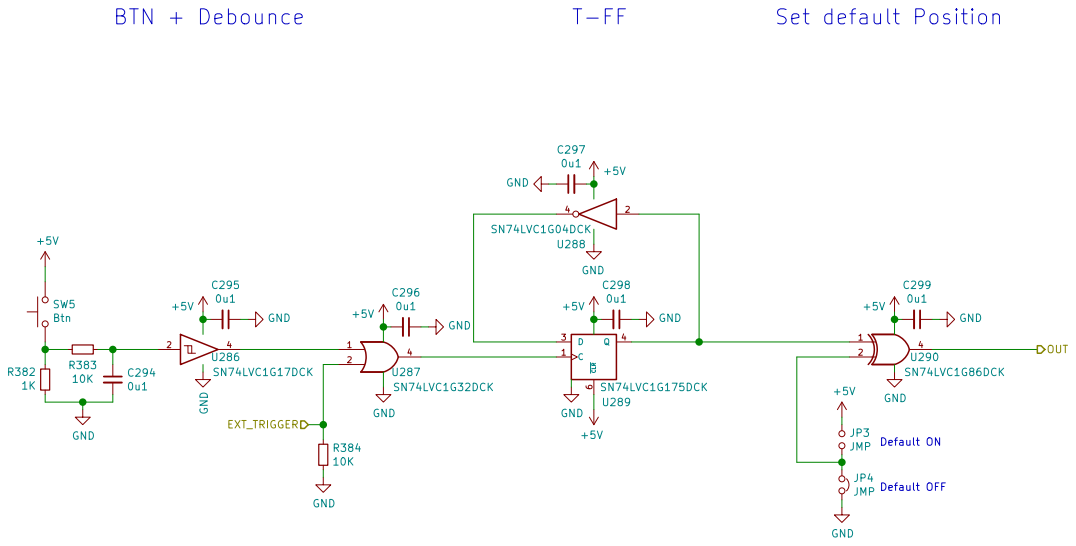
[picture p84: page 74]

A button that toggles a state on/off. Handles de-bounce and combines the signal +5V C298

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

Philipp Schilk
Sheet: /UI/BTN: Clk Step EN/
File: BTN_TOGGLE.sch
Id: 74/97 Title: psMCU

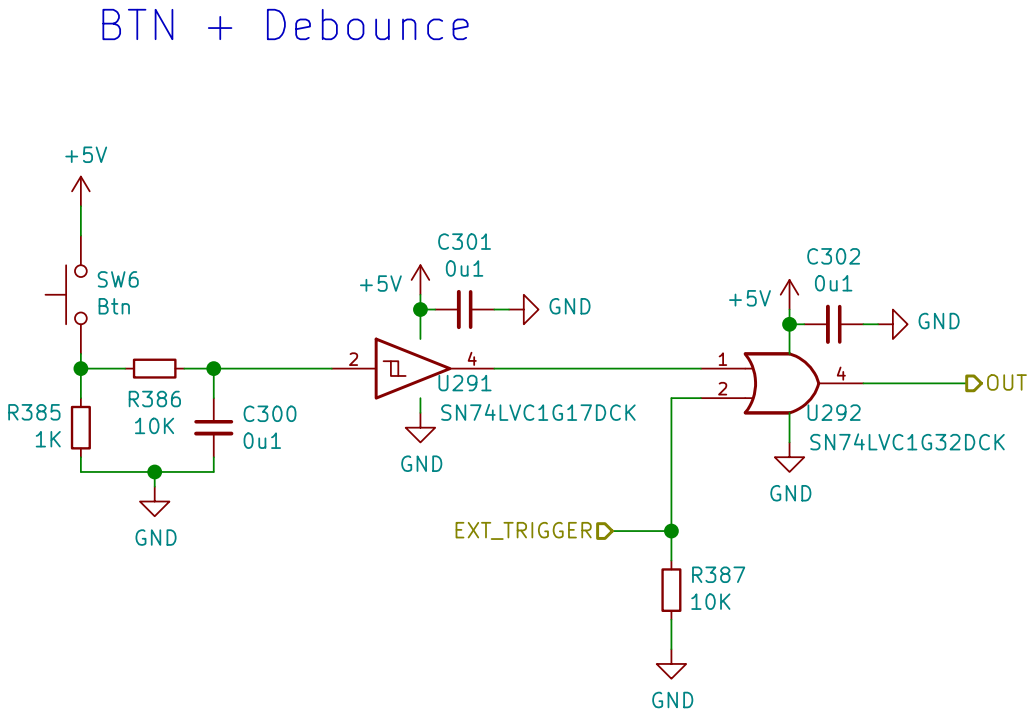
[picture p85: page 75]

from an external remote. A simple single-trigger button. Handles de-bouncing and also combines the signal C300

Philipp Schilk
Sheet: /UI/BTN: Clk Step/
File: BTN_TRIG.sch
Id: 75/97 Title: psMCU

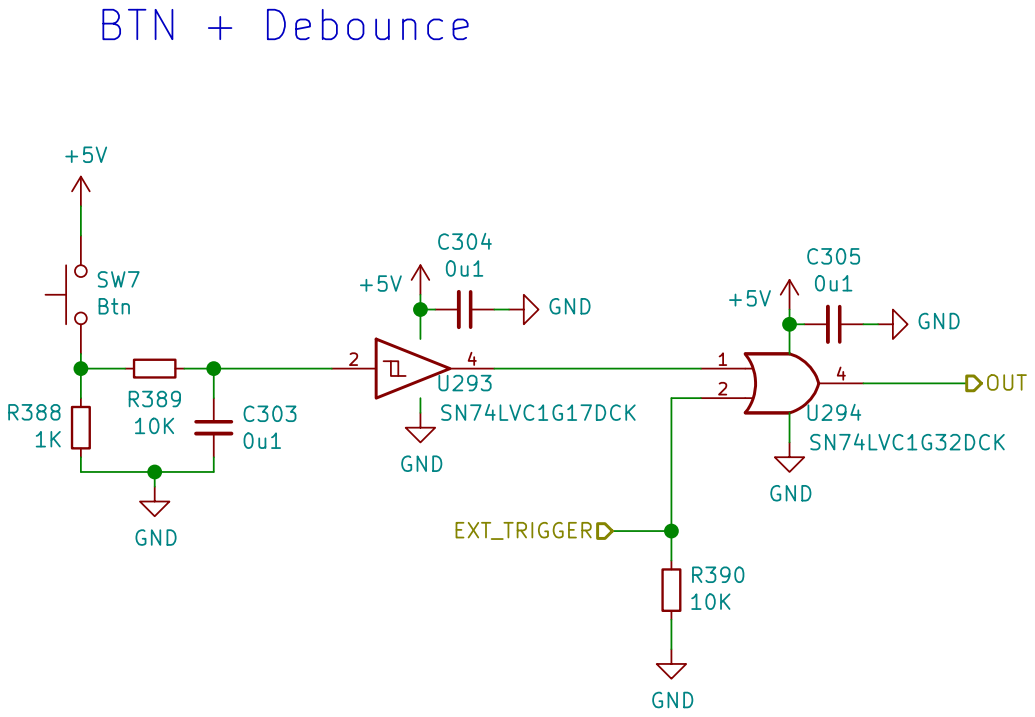
[picture p86: page 76]

from an external remote. A simple single-trigger button. Handles de-bouncing and also combines the signal C303

File: BTN_TRIG.sch Sheet: /UI/BTN: Reset/ Philipp Schilk

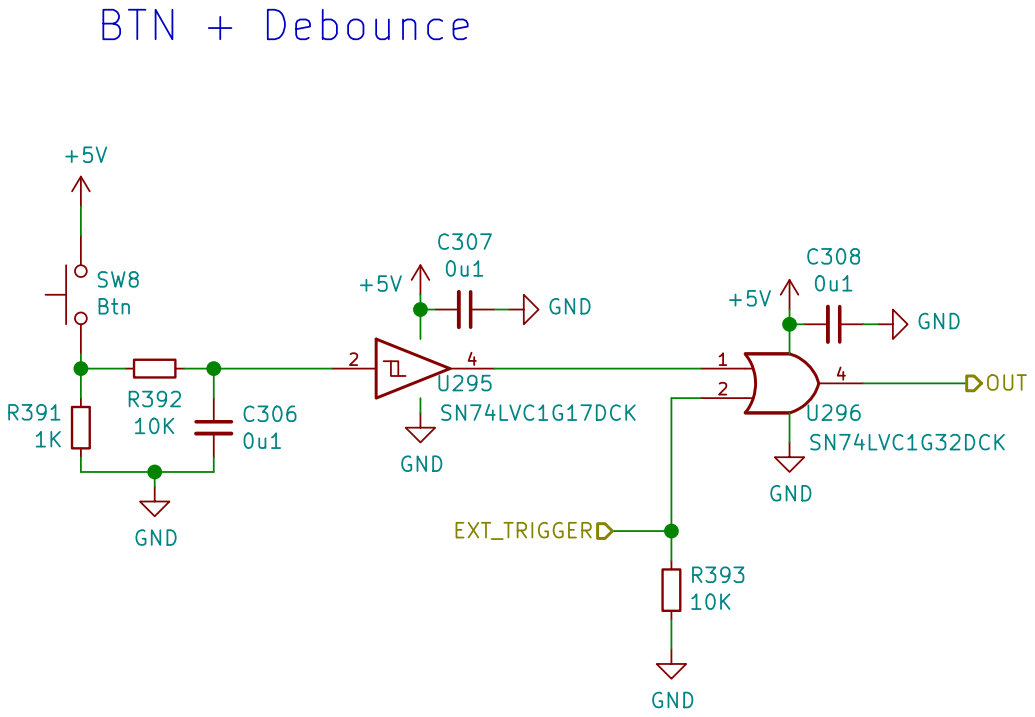
[picture p87: page 77]

from an external remote. A simple single-trigger button. Handles de-bouncing and also combines the signal C306

File: BTN_TRIG.sch Sheet: /UI/BTN: Int/ Philipp Schilk

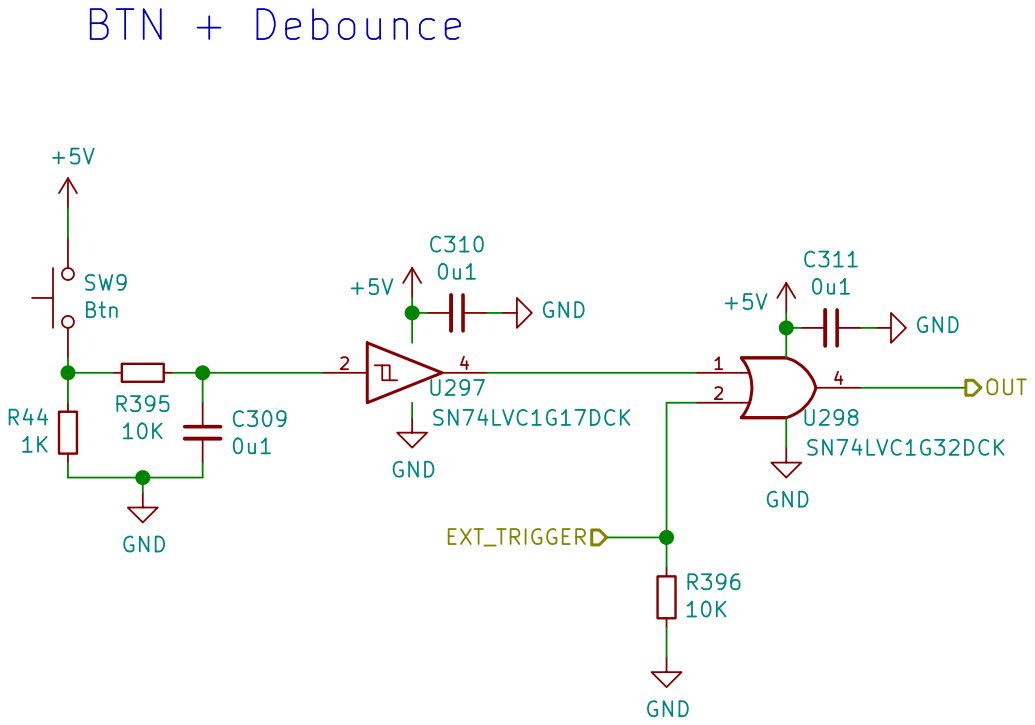
[picture p88: page 78]

from an external remote. A simple single-trigger button. Handles de-bouncing and also combines the signal C309

File: BTN_TRIG.sch Sheet: /UI/BTN: Inc Clk f/ Philipp Schilk

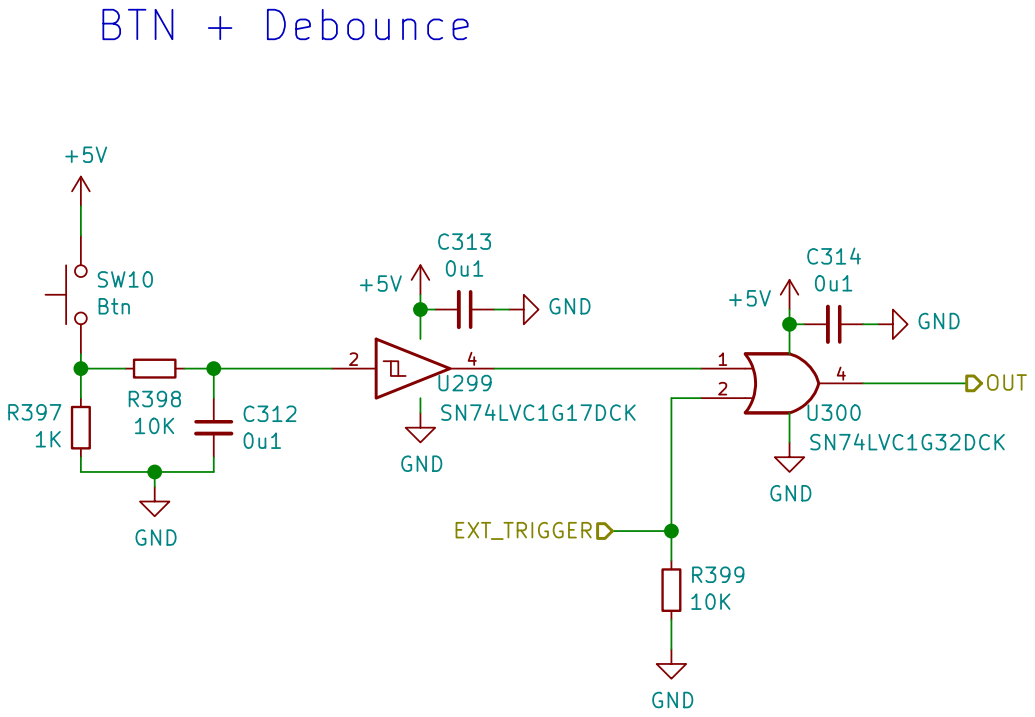
[picture p89: page 79]

from an external remote. A simple single-trigger button. Handles de-bouncing and also combines the signal C312

File: BTN_TRIG.sch Sheet: /UI/BTN: Dec Clk f/ Philipp Schilk

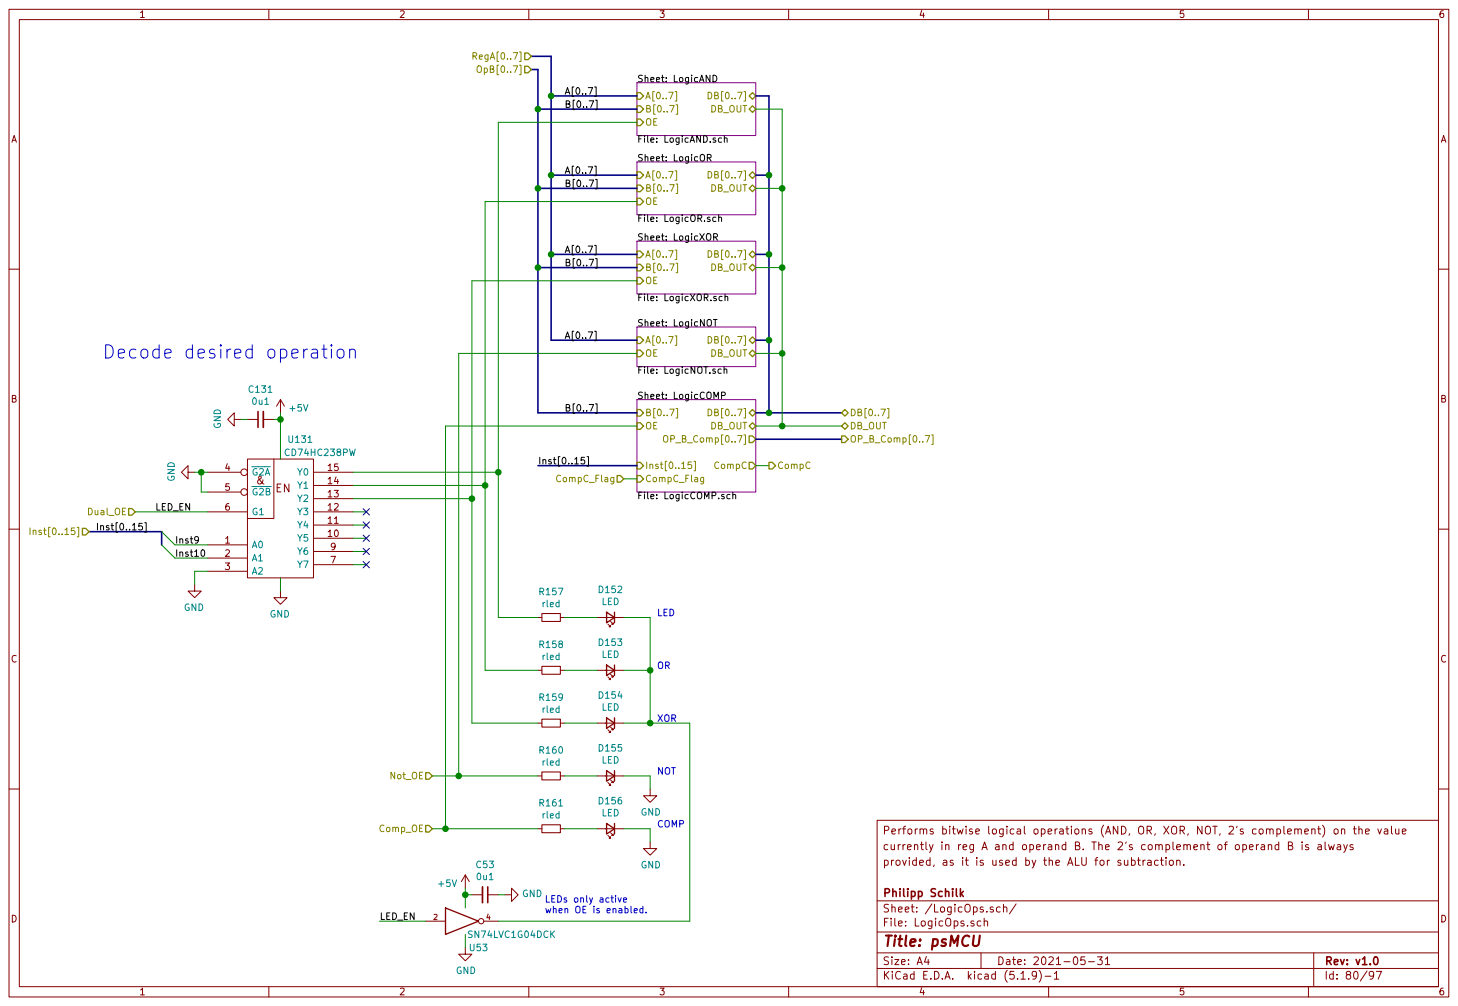
[picture p90: page 80]

LEDs only active when OE is enabled. Decode desired operation

Performs bitwise logical operations (AND, OR, XOR, NOT, 2's complement) on the value
currently in reg A and operand B. The 2's complement of operand B is always
provided, as it is used by the ALU for subtraction.

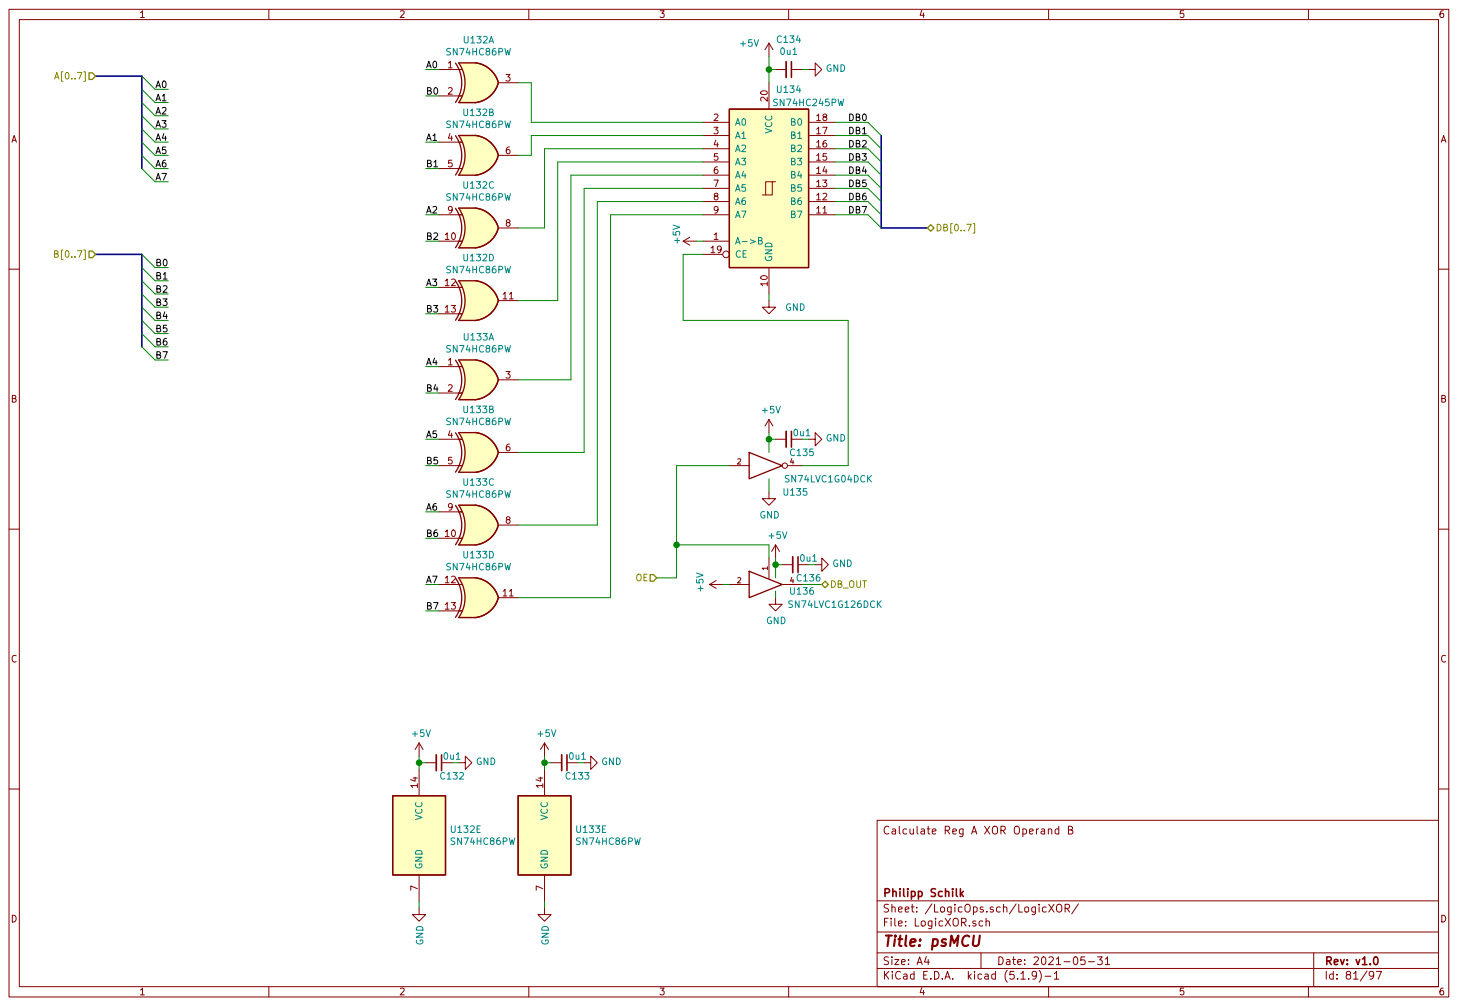
[picture p91: page 81]

Calculate Reg A XOR Operand B +5V GND

Philipp Schilk
Sheet: /LogicOps.sch/LogicXOR/
File: LogicXOR.sch
Id: 81/97 Title: psMCU

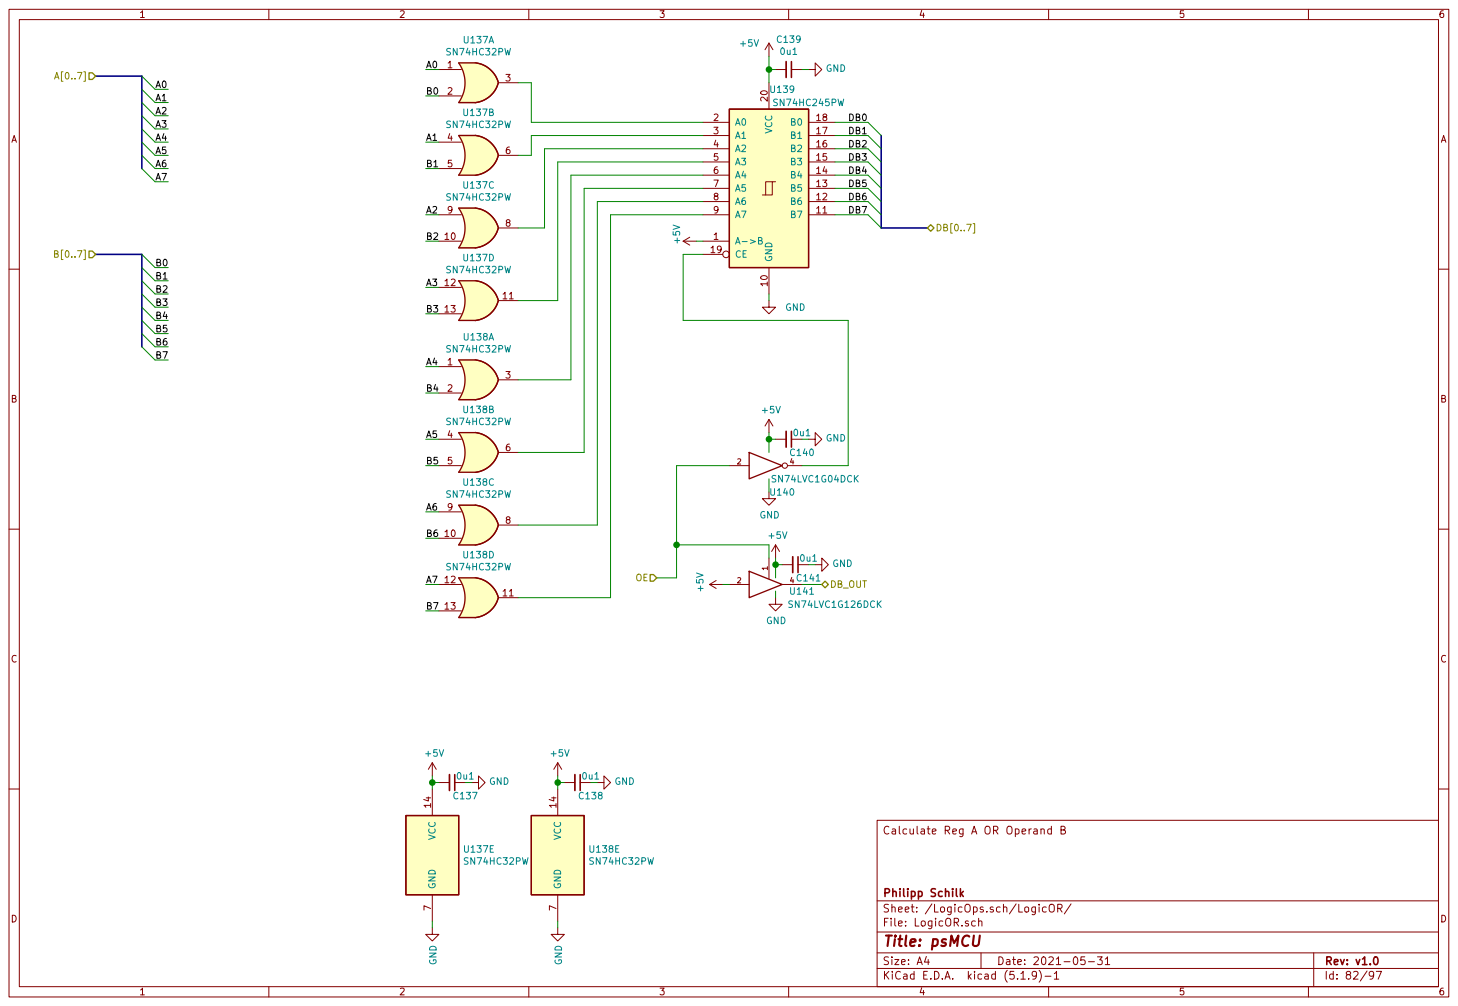
[picture p92: page 82]

Calculate Reg A OR Operand B

Philipp Schilk
Sheet: /LogicOps.sch/LogicOR/
File: LogicOR.sch
Id: 82/97 Title: psMCU

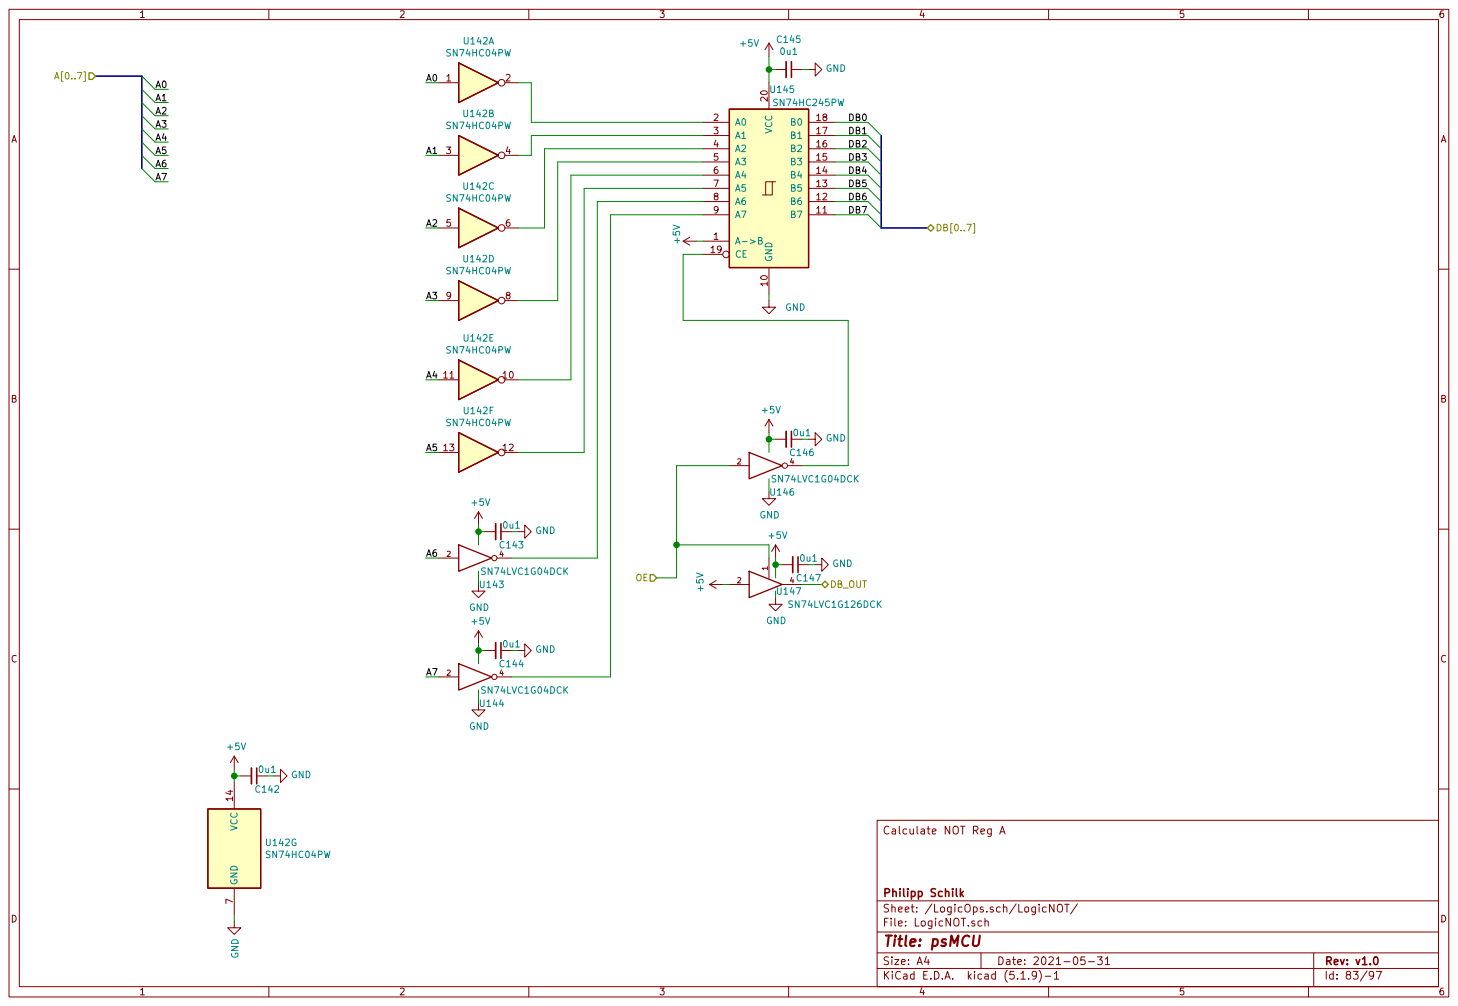
[picture p93: page 83]

Philipp Schilk
Sheet: /LogicOps.sch/LogicNOT/
File: LogicNOT.sch
Id: 83/97 Title: psMCU

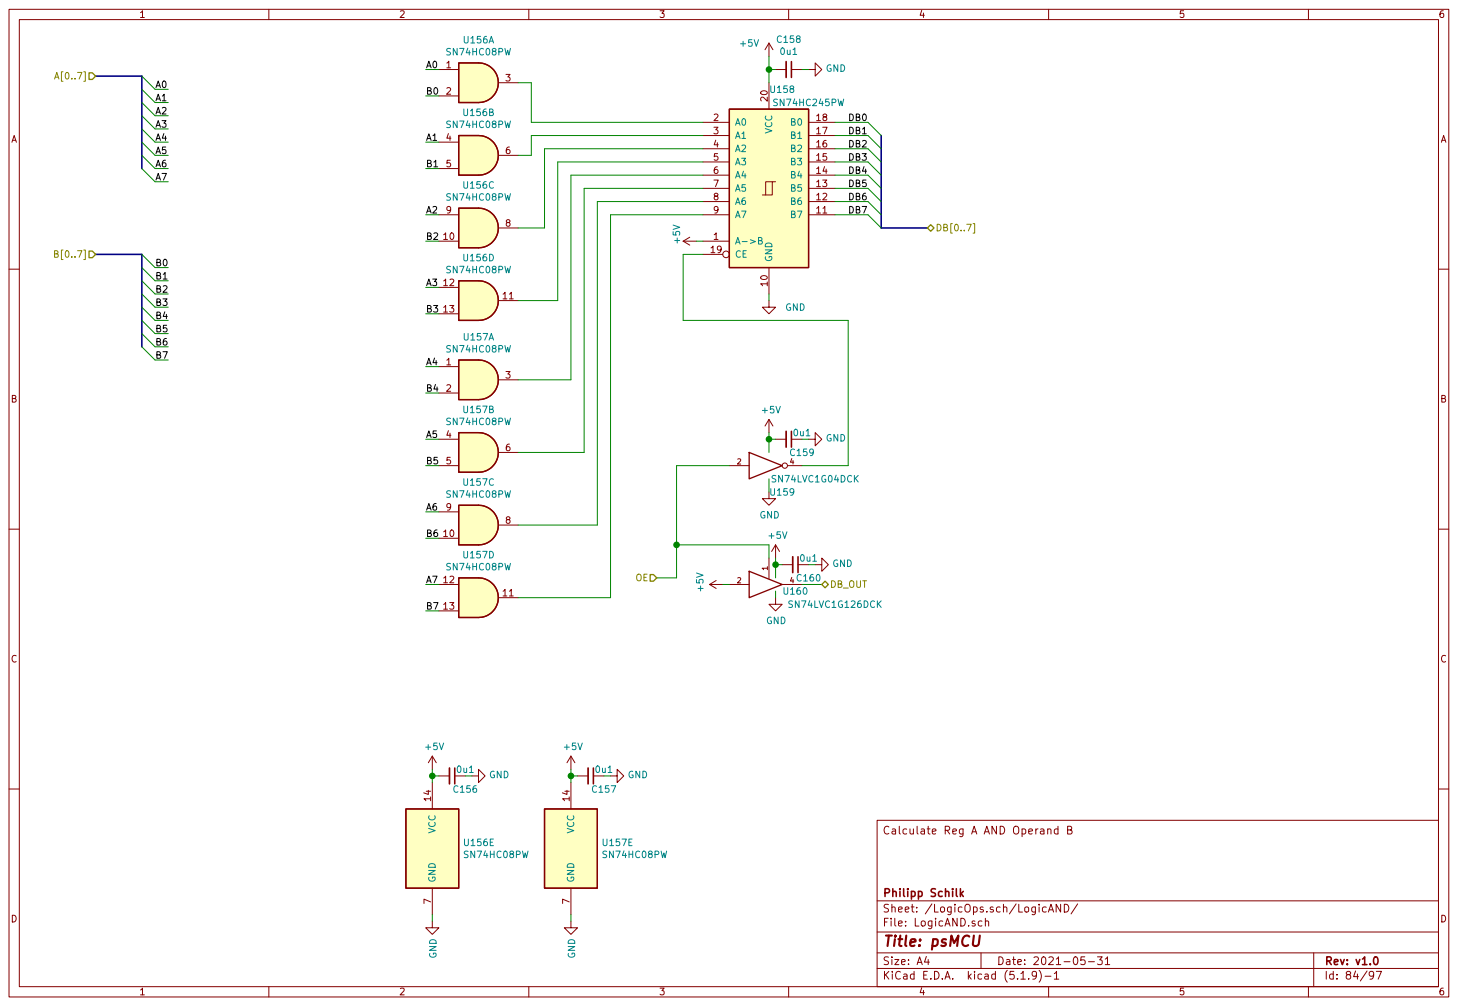
[picture p94: page 84]

Philipp Schilk
Sheet: /LogicOps.sch/LogicAND/
File: LogicAND.sch
Id: 84/97 Title: psMCU

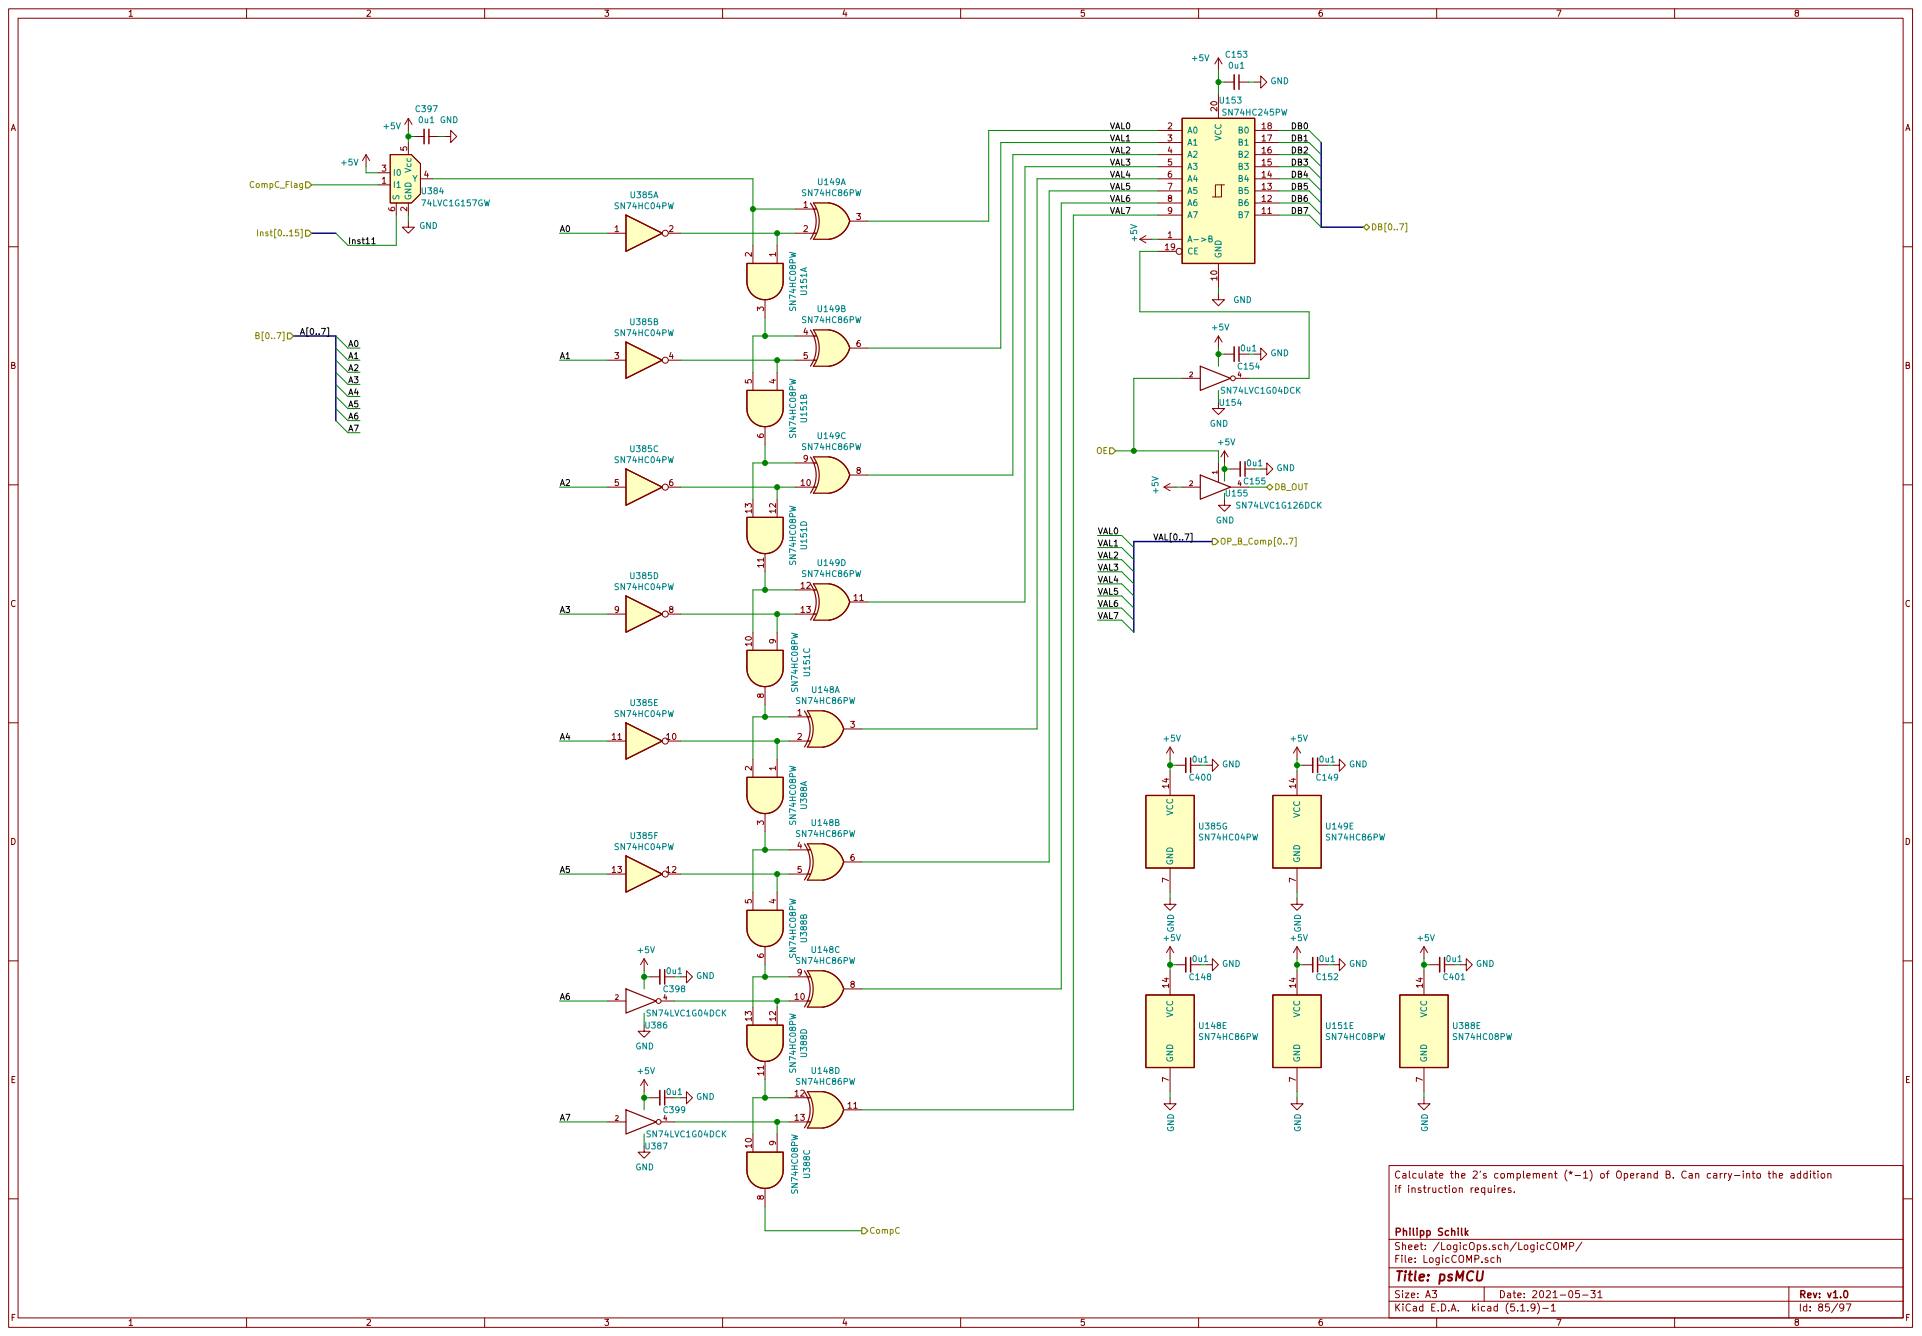
[picture p95: page 85]

Philipp Schilk
Sheet: /LogicOps.sch/LogicCOMP/
File: LogicCOMP.sch
Id: 85/97 Title: psMCU

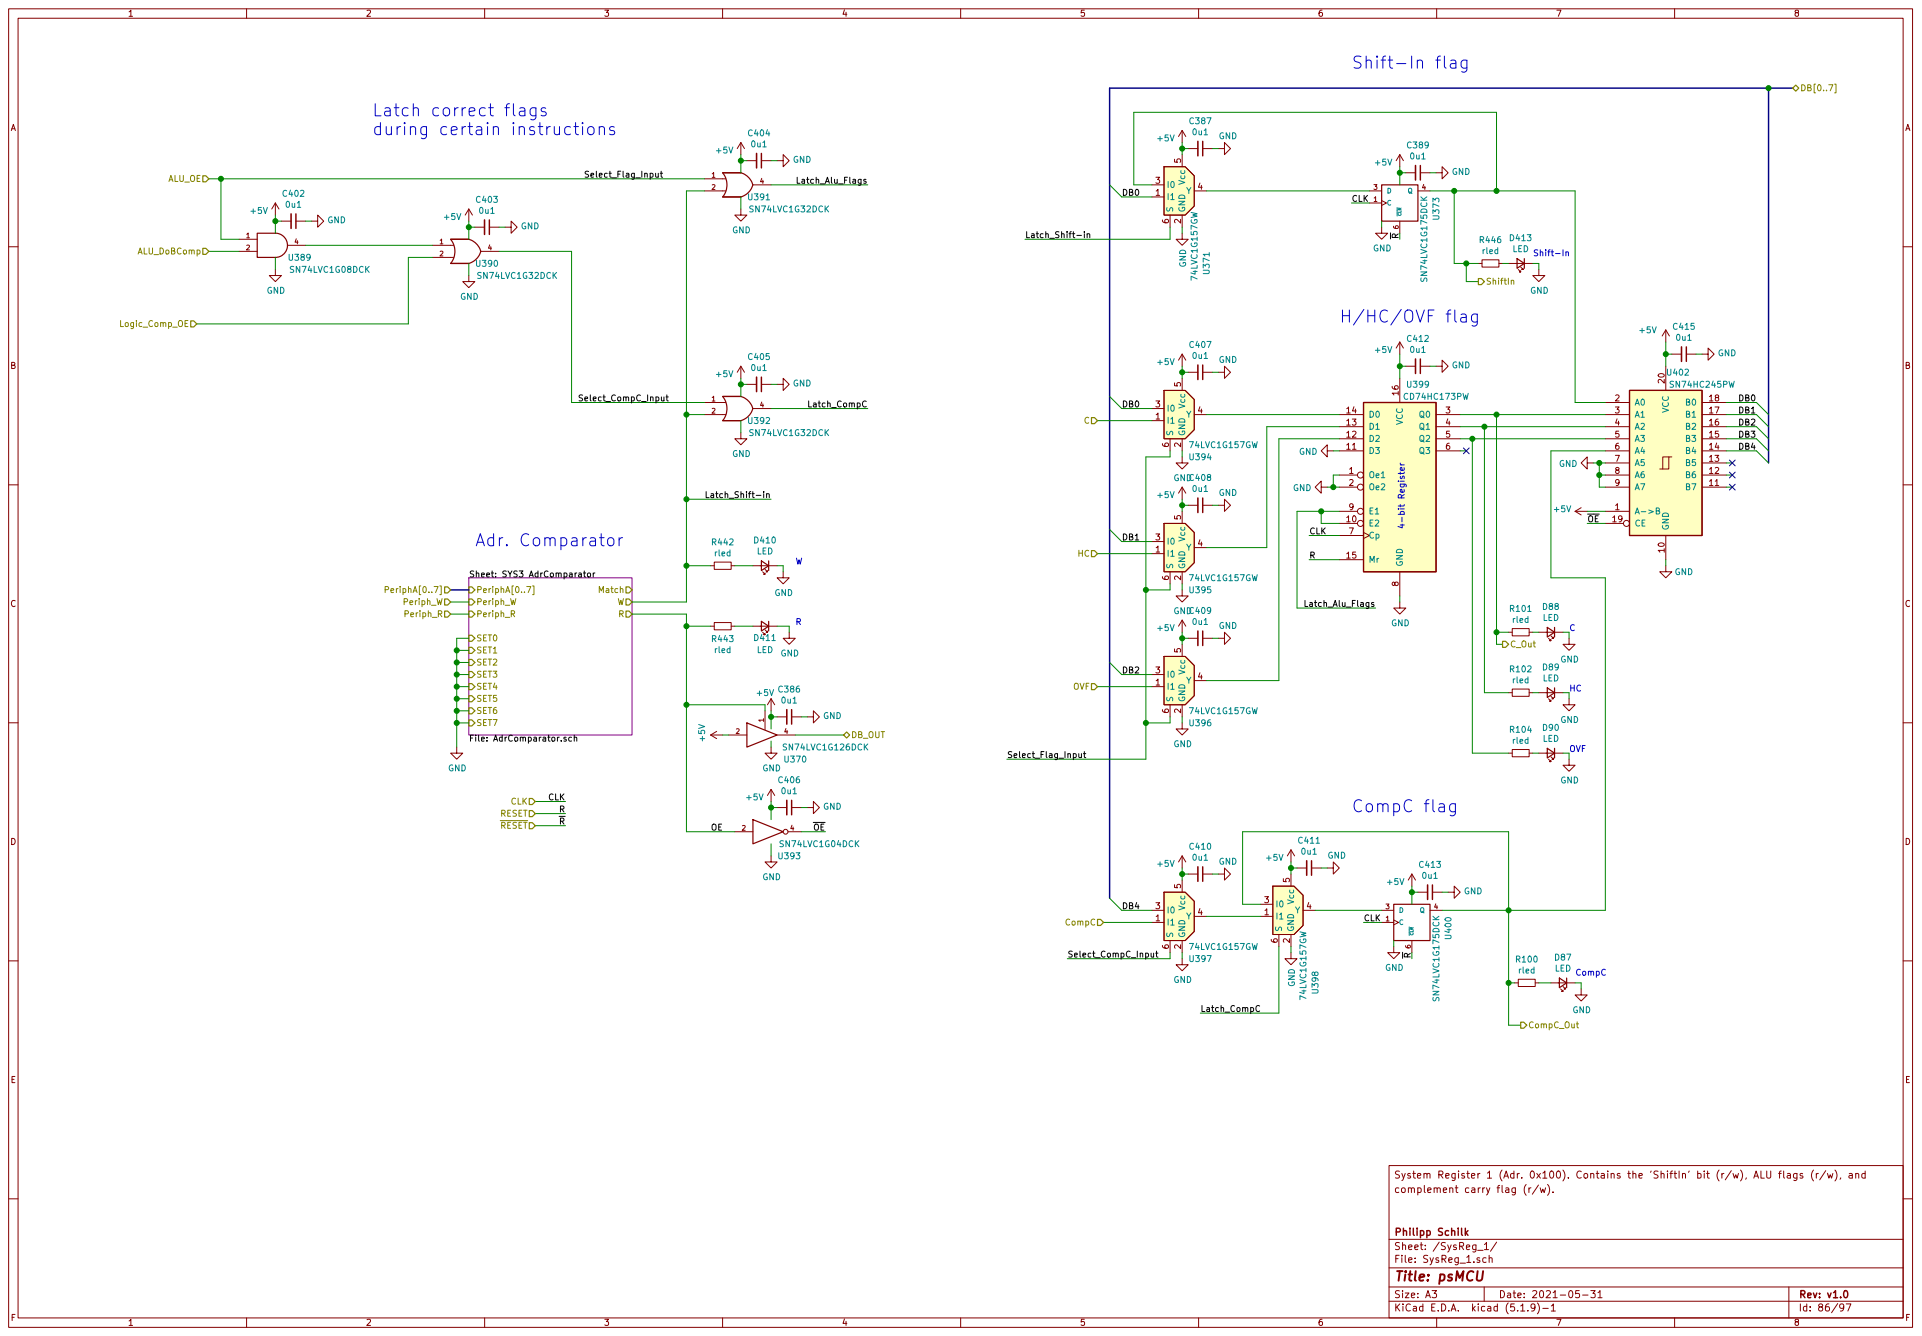
[picture p96: page 86]

COVF Latch correct flags
during certain instructions

Shift-In 4-bit Register

System Register 1 (Adr. 0x100). Contains the 'ShiftIn' bit (r/w), ALU flags (r/w), and
complement carry flag (r/w).

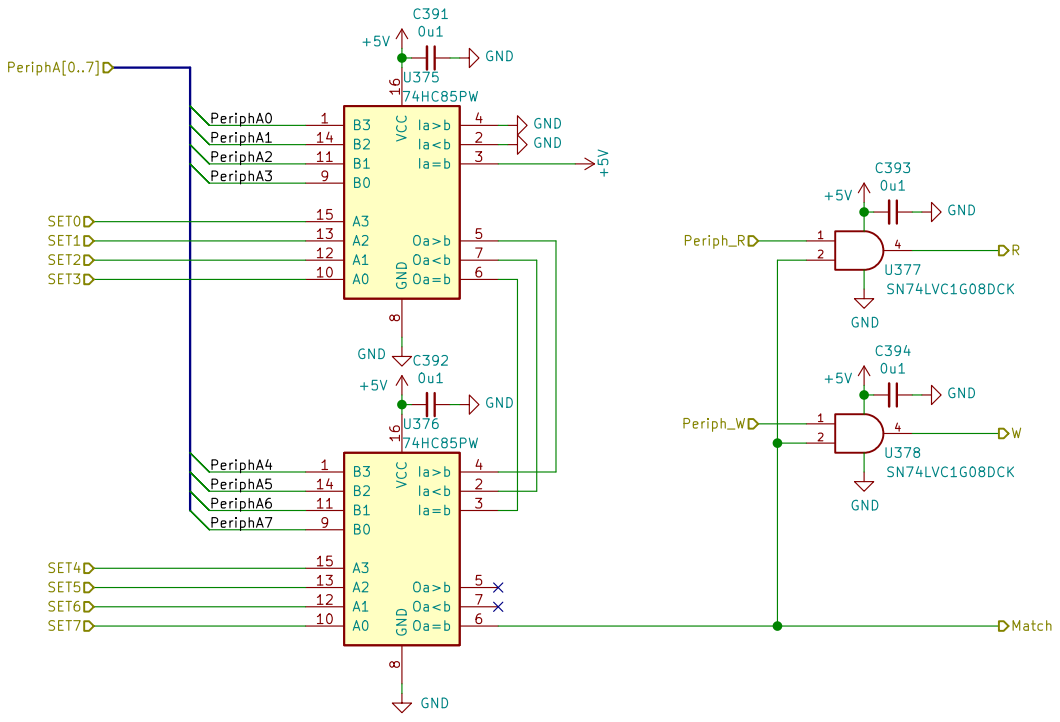
[picture p97: page 87]
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

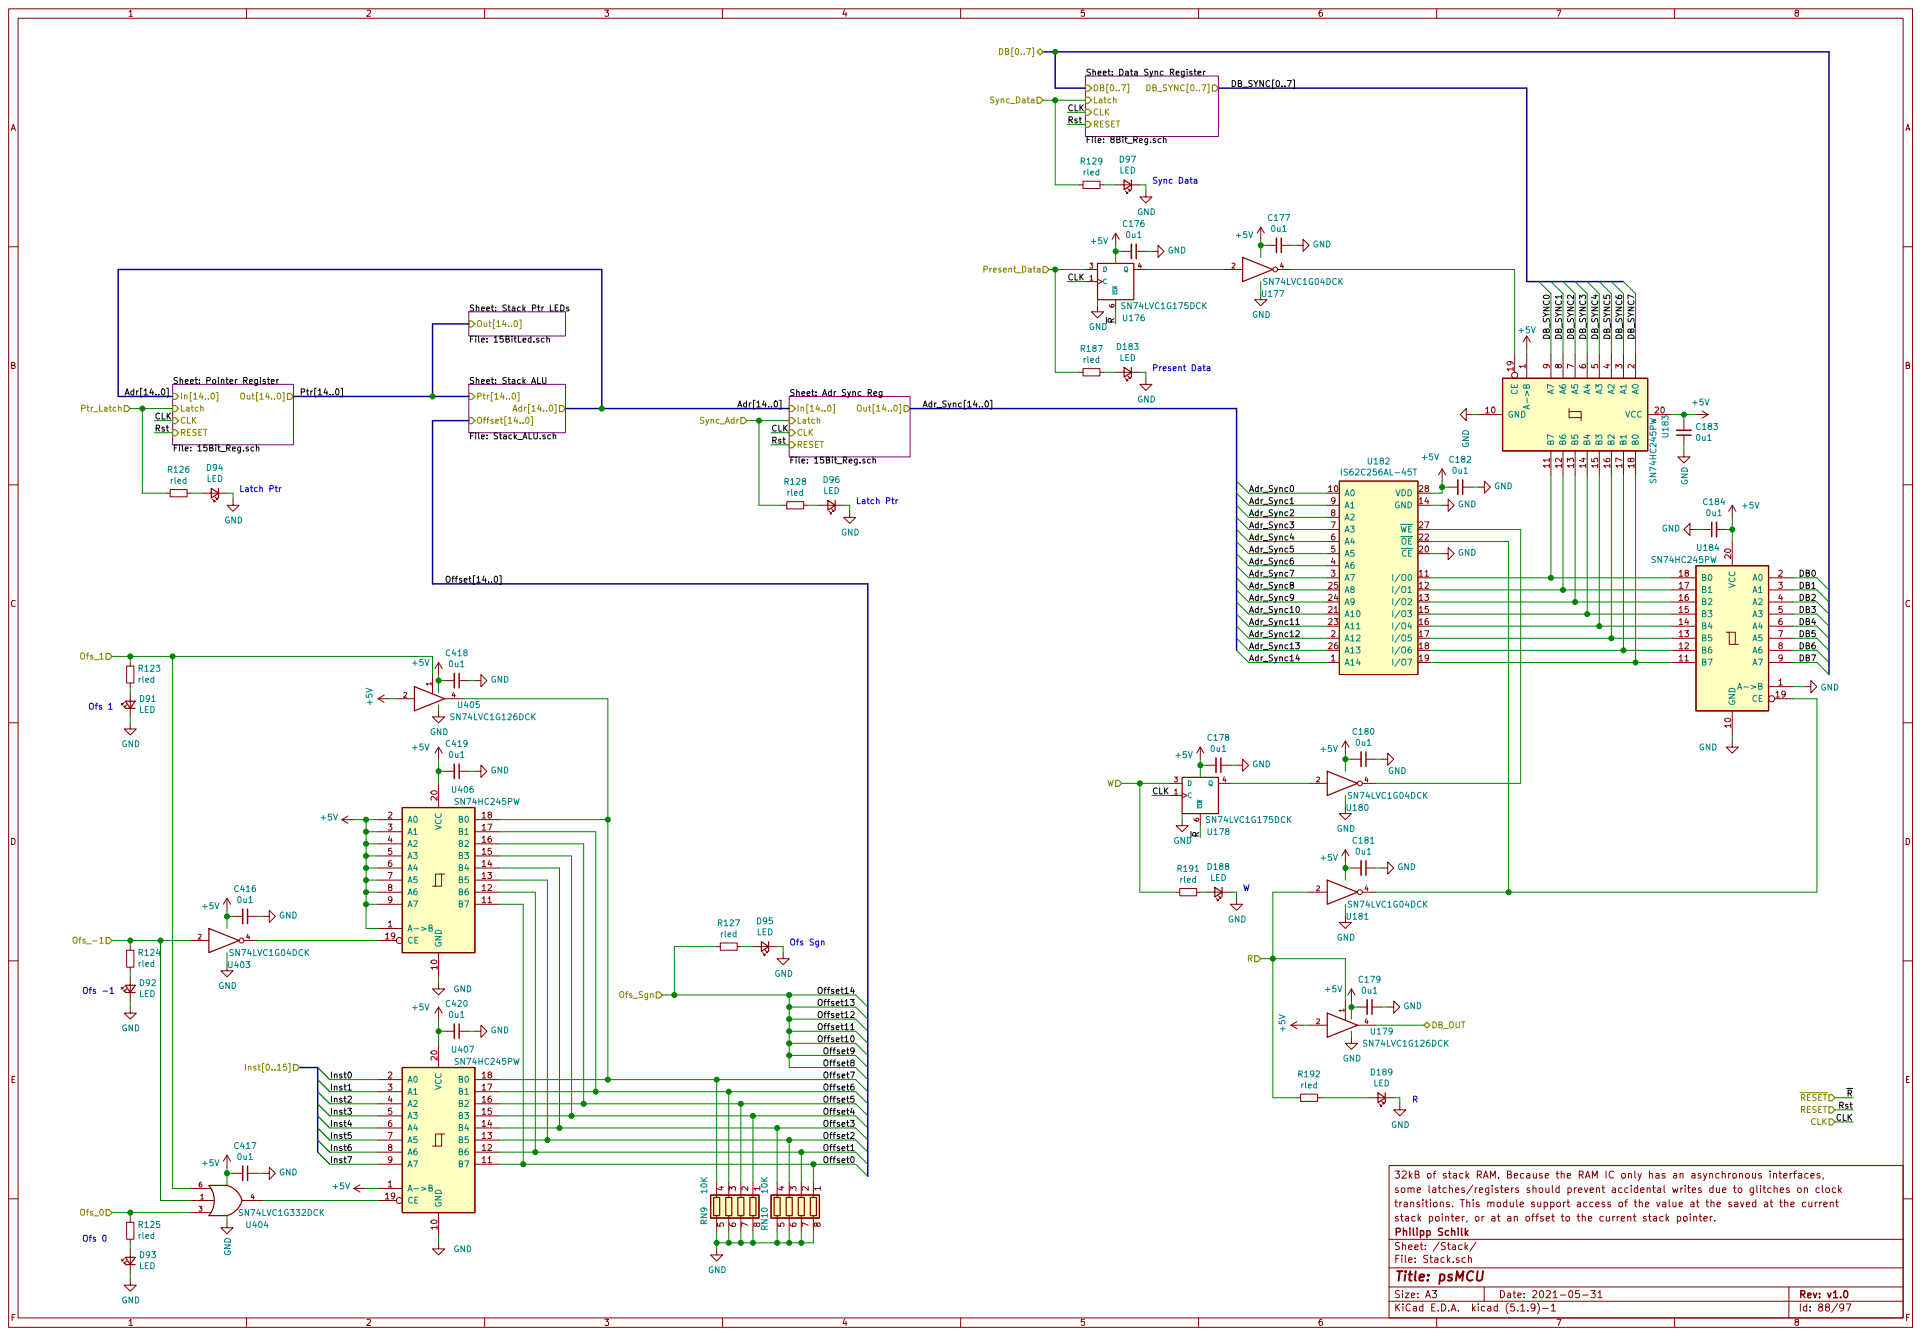
[picture p98: page 88]

Sheet: Data Sync Register
Sync_Data Present_Data

Latch Sheet: Stack ALU

32kB of stack RAM. Because the RAM IC only has an asynchronous interfaces,
some latches/registers should prevent accidental writes due to glitches on clock
transitions. This module support access of the value at the saved at the current
stack pointer, or at an offset to the current stack pointer.
File: Stack.sch Sheet: /Stack/ Philipp Schilk

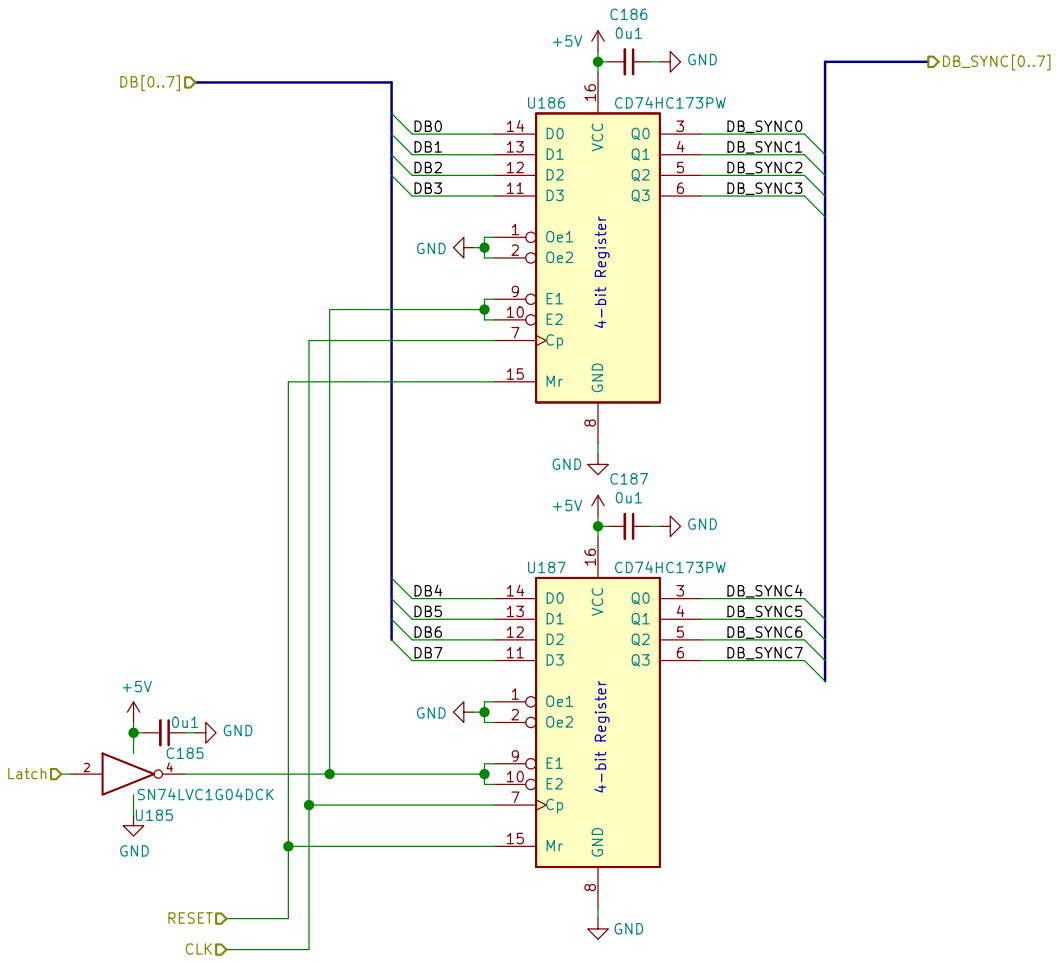
[picture p99: page 89]

Philipp Schilk
Sheet: /Stack/Data Sync Register/
File: 8Bit_Reg.sch
Id: 89/97 Title: psMCU

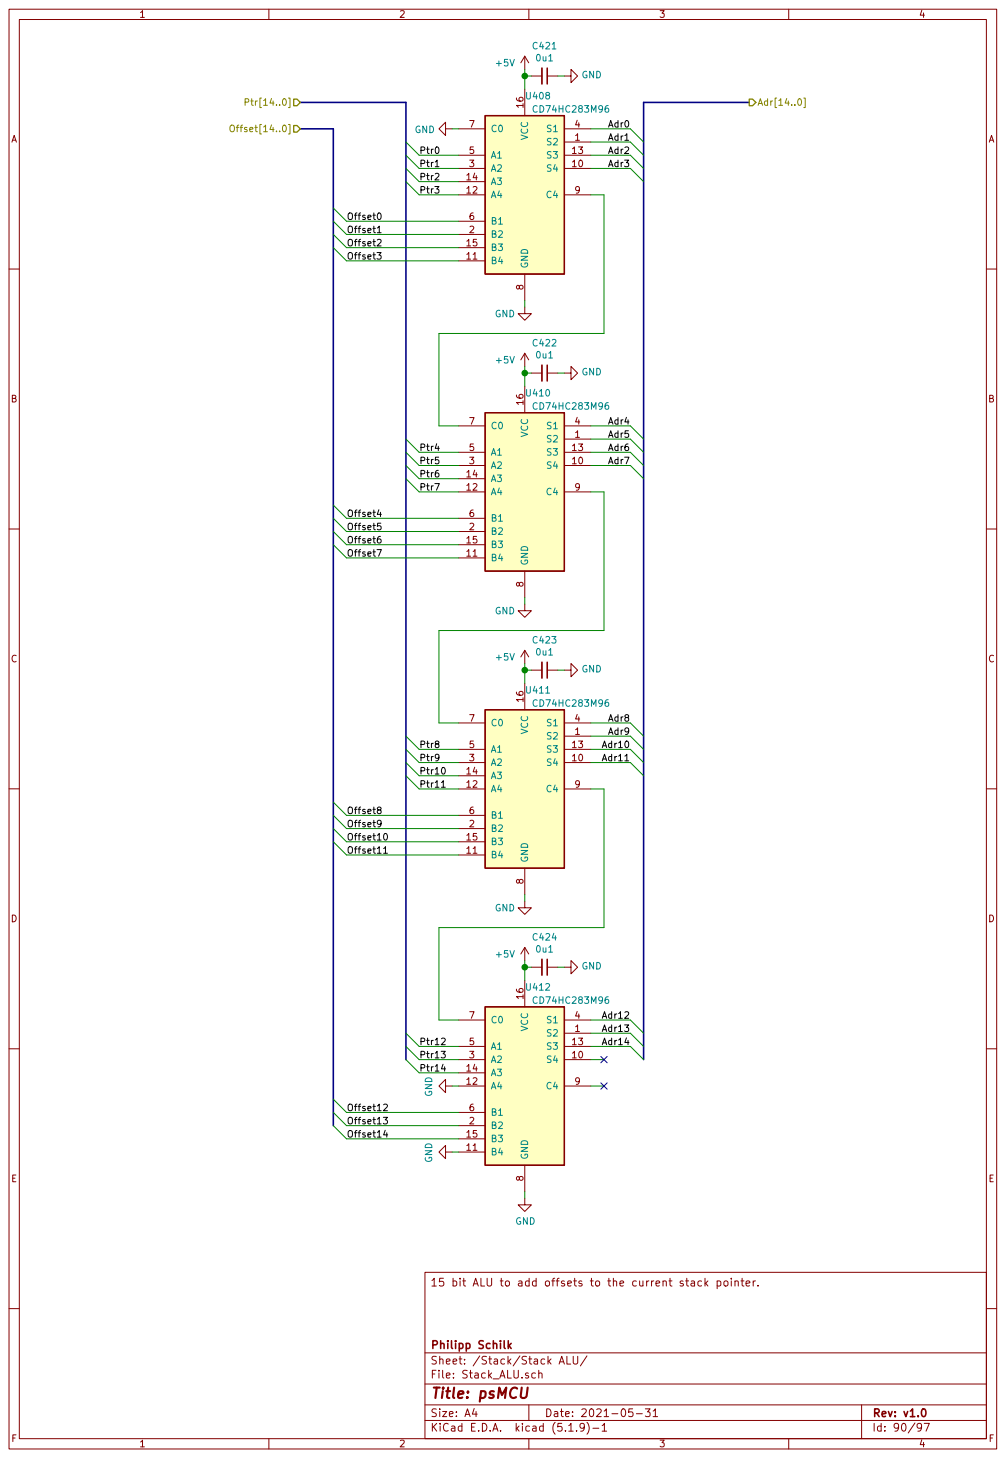
[picture p100: page 90]

15 bit ALU to add offsets to the current stack pointer. GND

File: Stack_ALU.sch Sheet: /Stack/Stack ALU/ Philipp Schilk

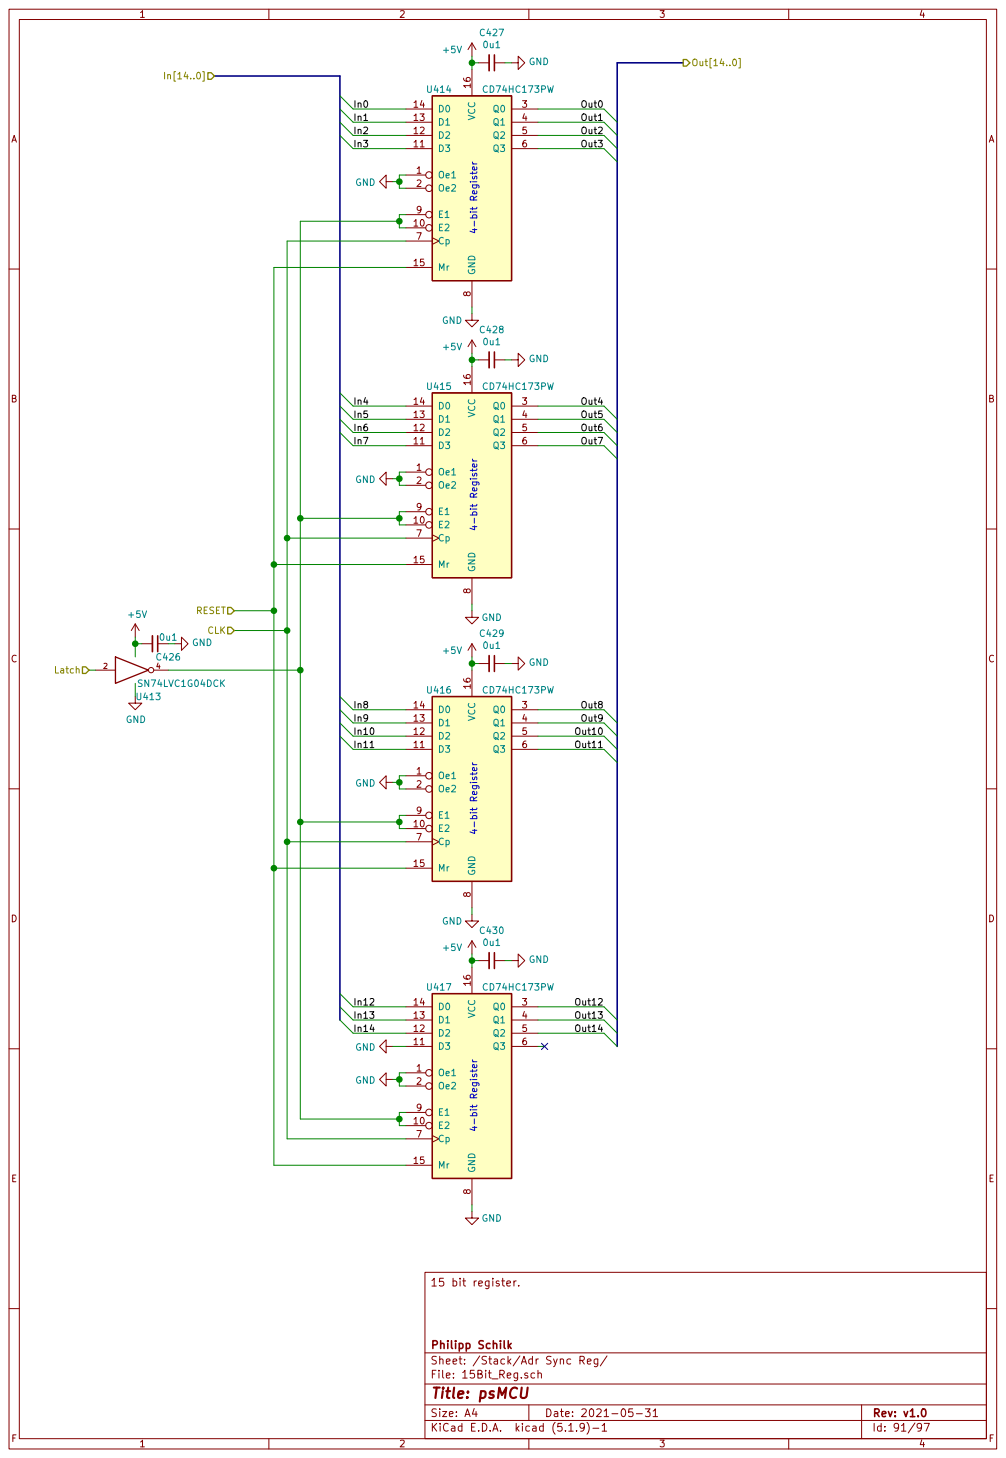
[picture p101: page 91]

Philipp Schilk
Sheet: /Stack/Adr Sync Reg/
File: 15Bit_Reg.sch
Id: 91/97 Title: psMCU

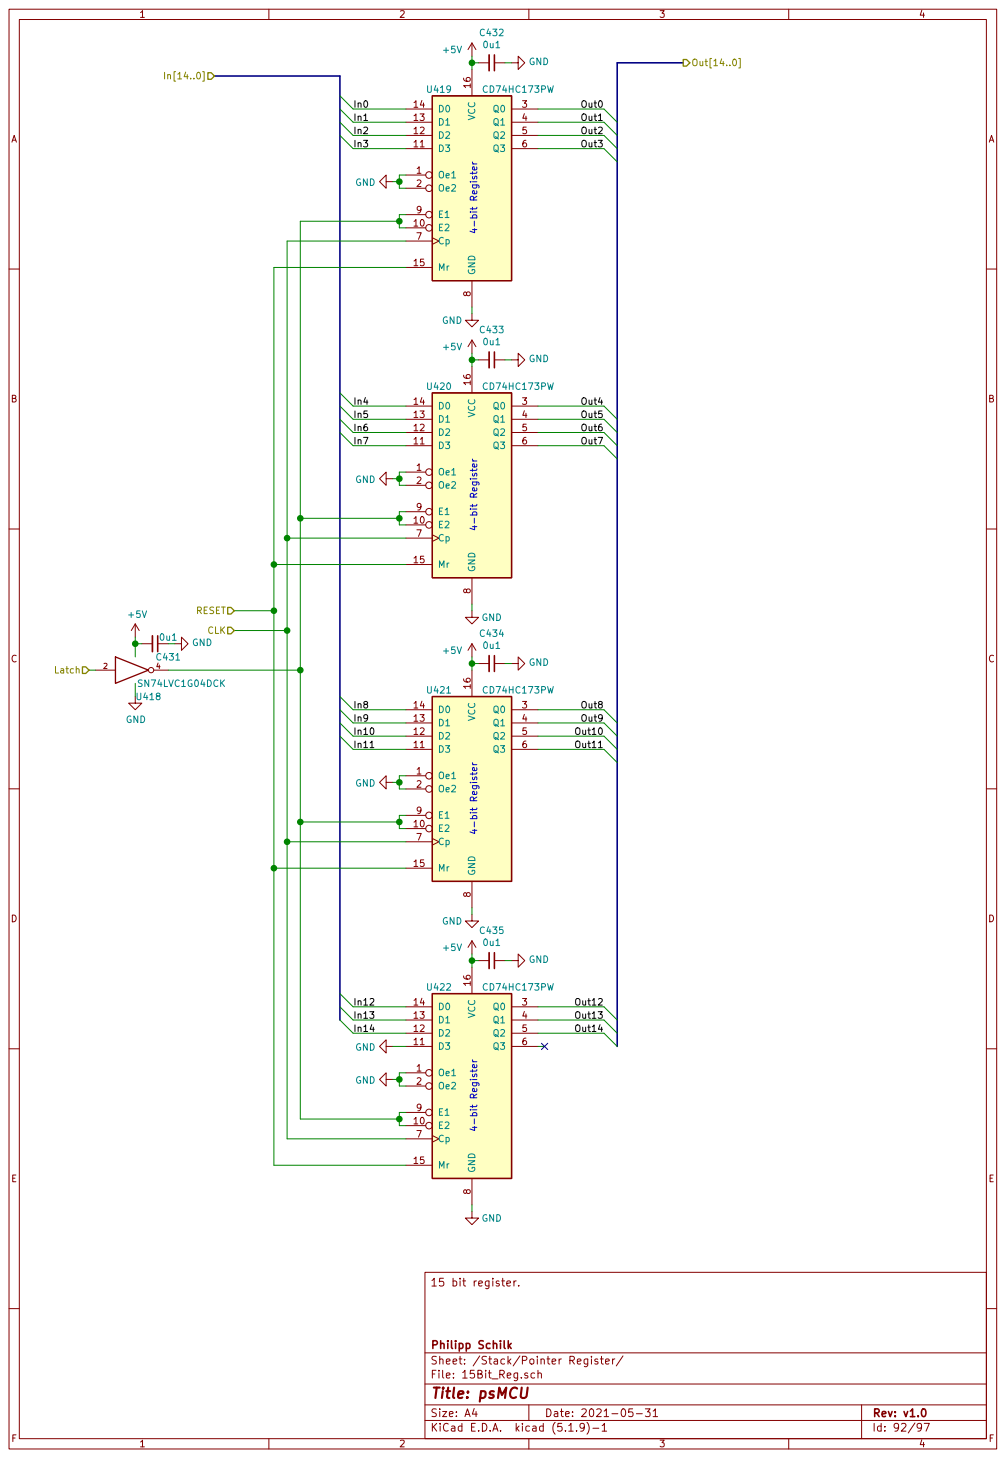
[picture p102: page 92]

Philipp Schilk
Sheet: /Stack/Pointer Register/
File: 15Bit_Reg.sch
Id: 92/97 Title: psMCU

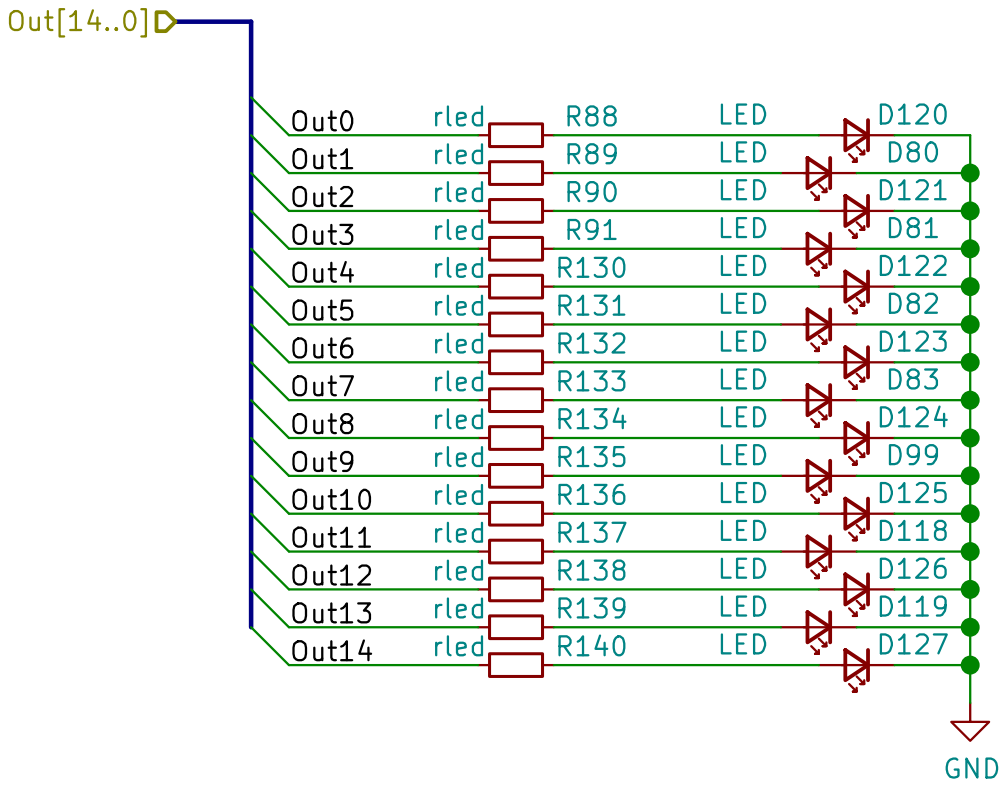
[picture p103: page 93]

File: 15BitLed.sch Sheet: /Stack/Stack Ptr LEDs/ Philipp Schilk

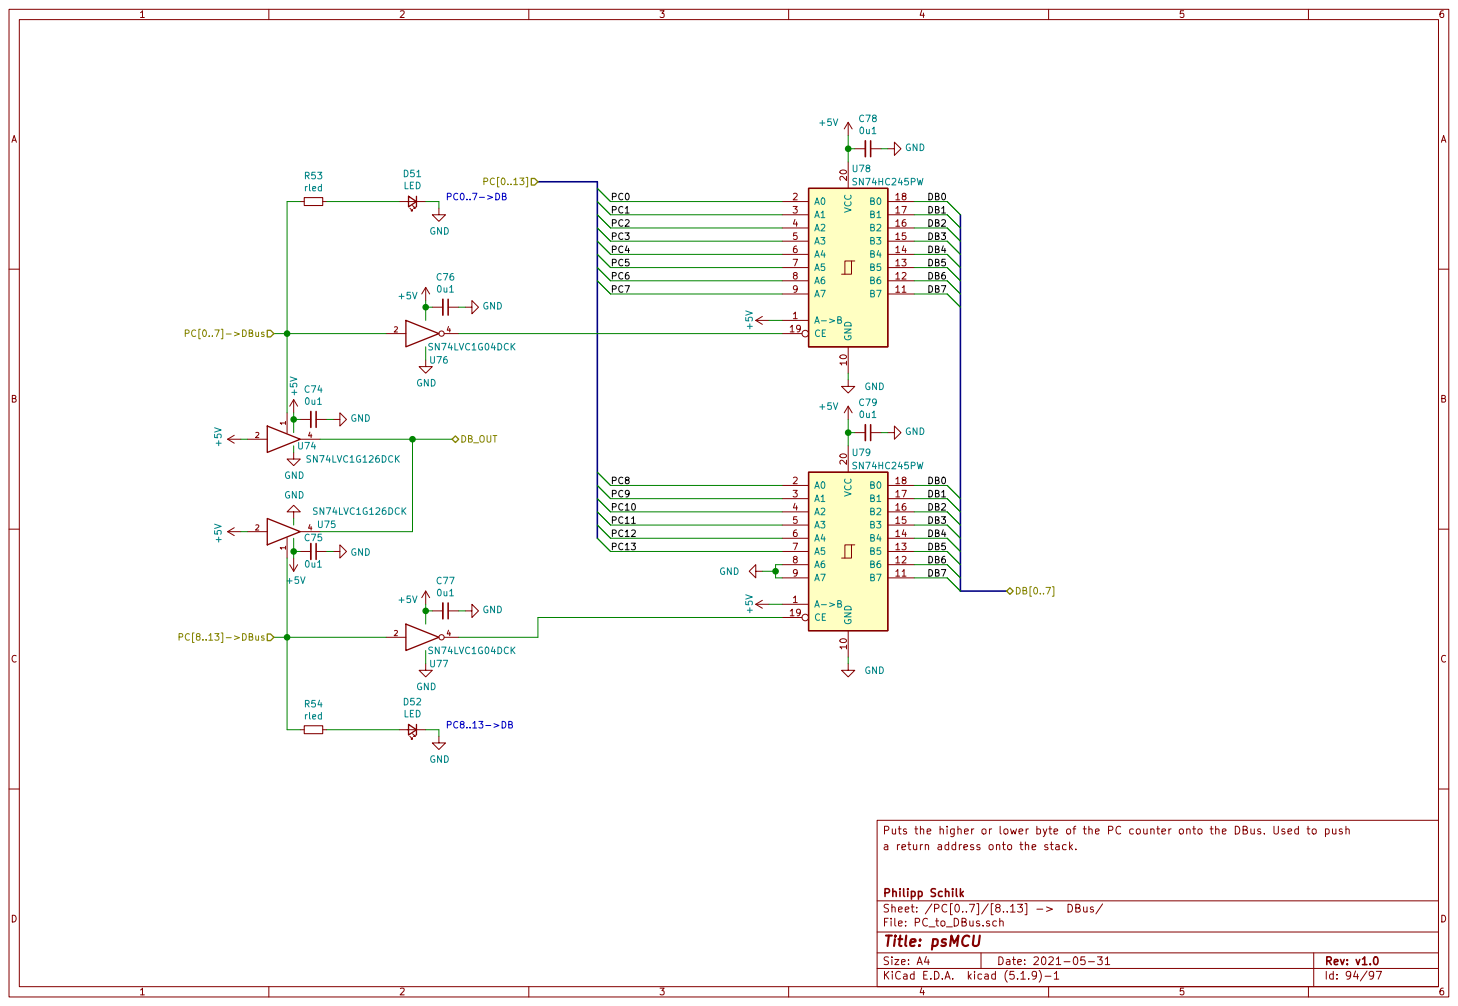
[picture p104: page 94]

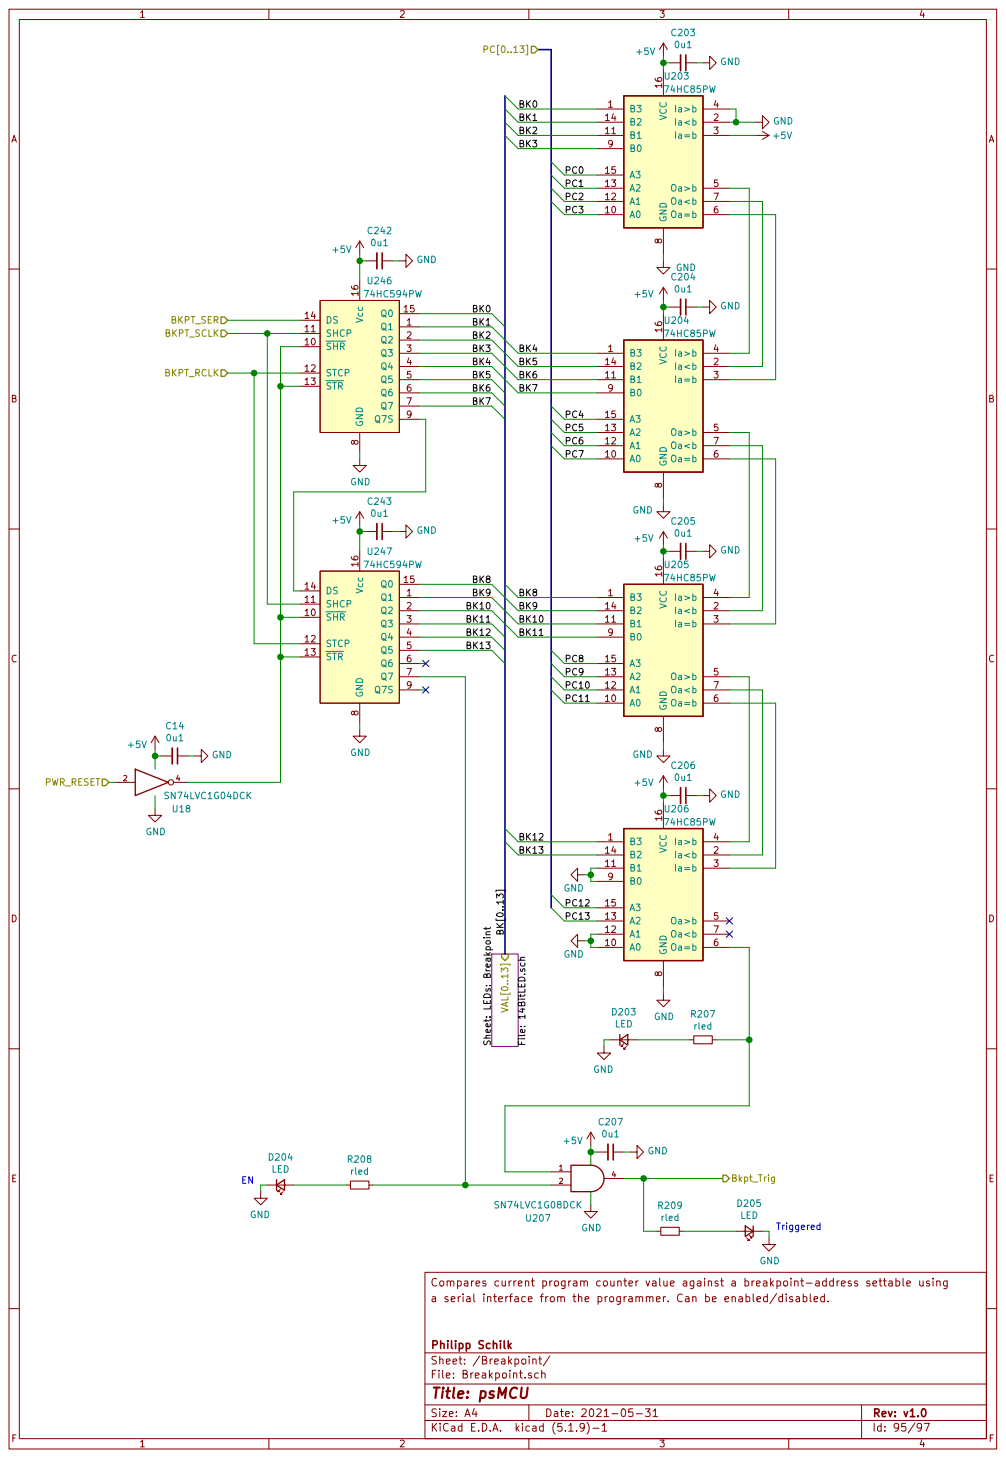
[picture p105: page 95]

a serial interface from the programmer. Can be enabled/disabled.

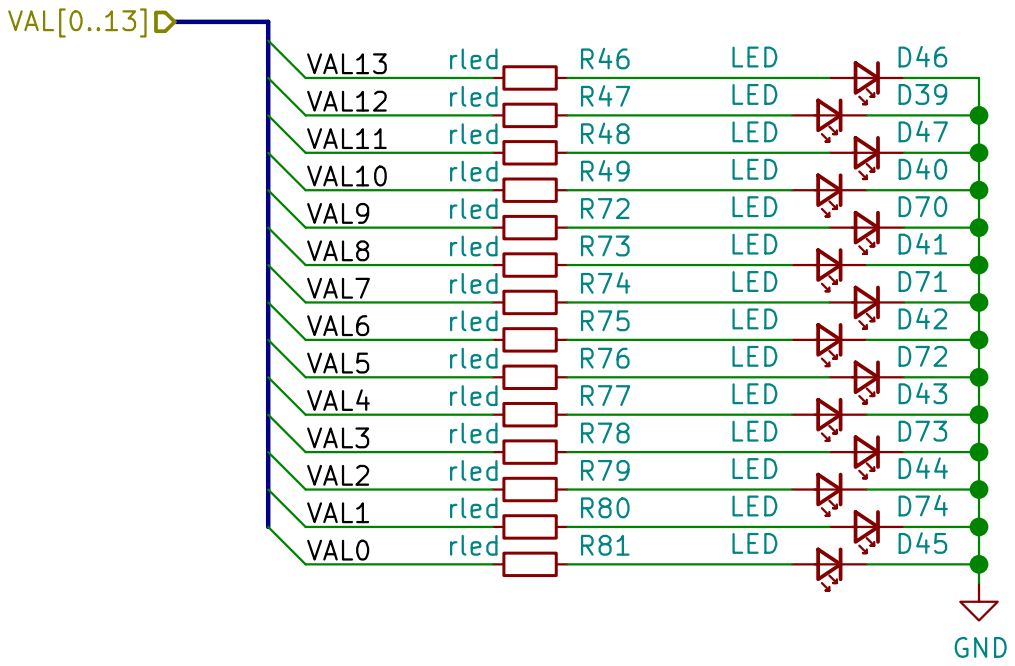
[picture p106: page 96]

Philipp Schilk
File: 14BitLED.sch Sheet: /Breakpoint/LEDs: Breakpoint/
Id: 96/97 Title: psMCU

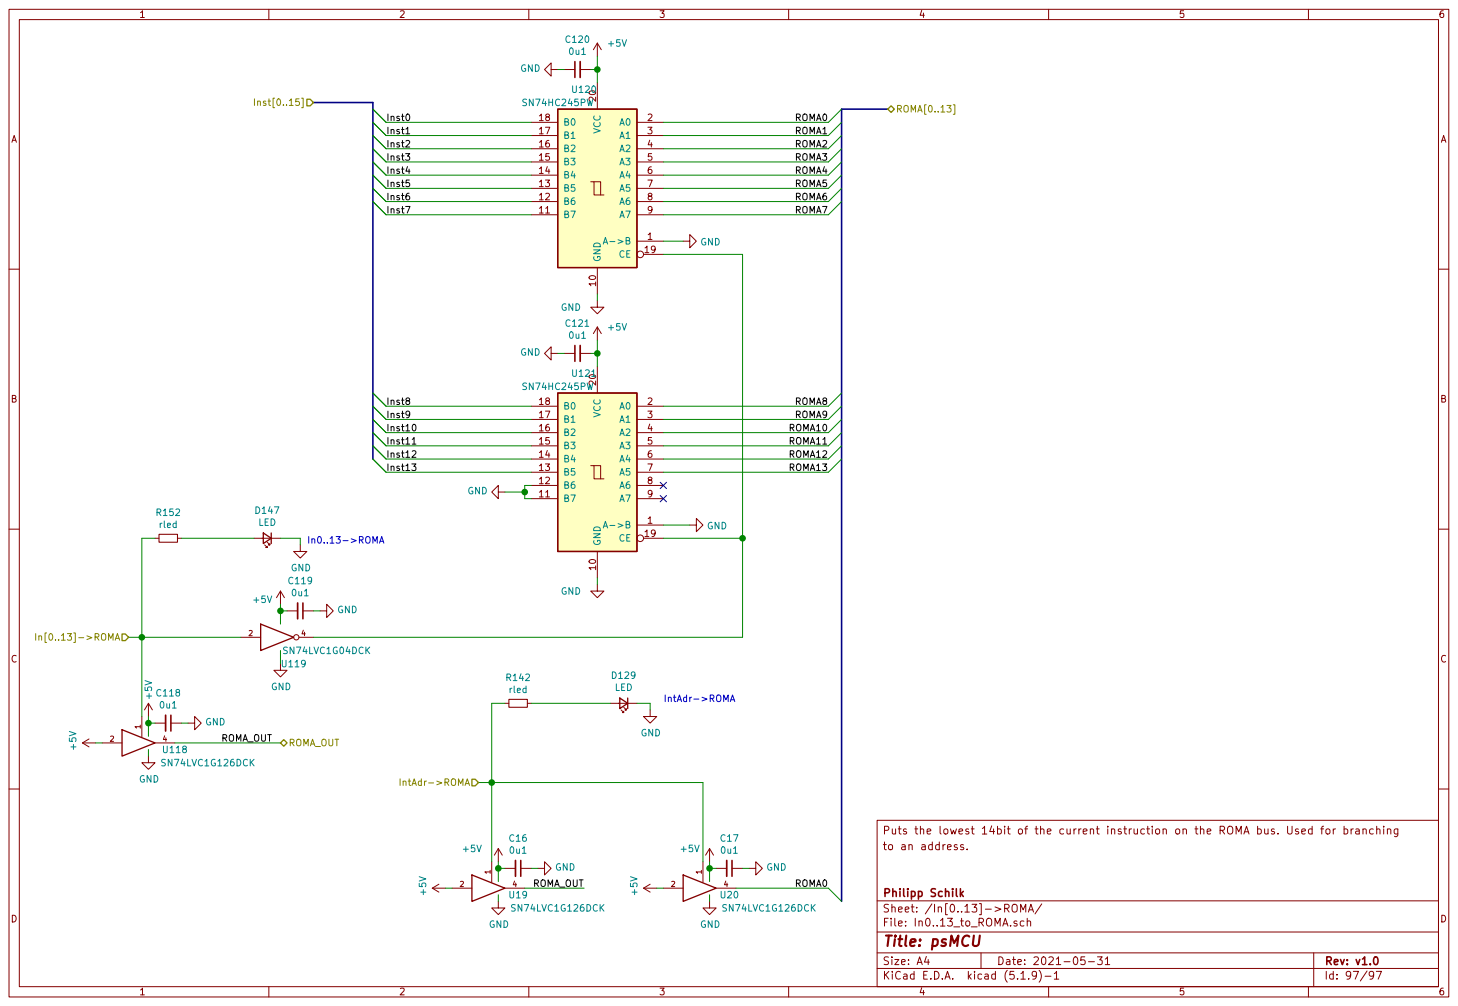
[picture p107: page 97]
