TheSchilk/psMCU/ECAD/periph_gpio/schematic_periph_gpio.pdf

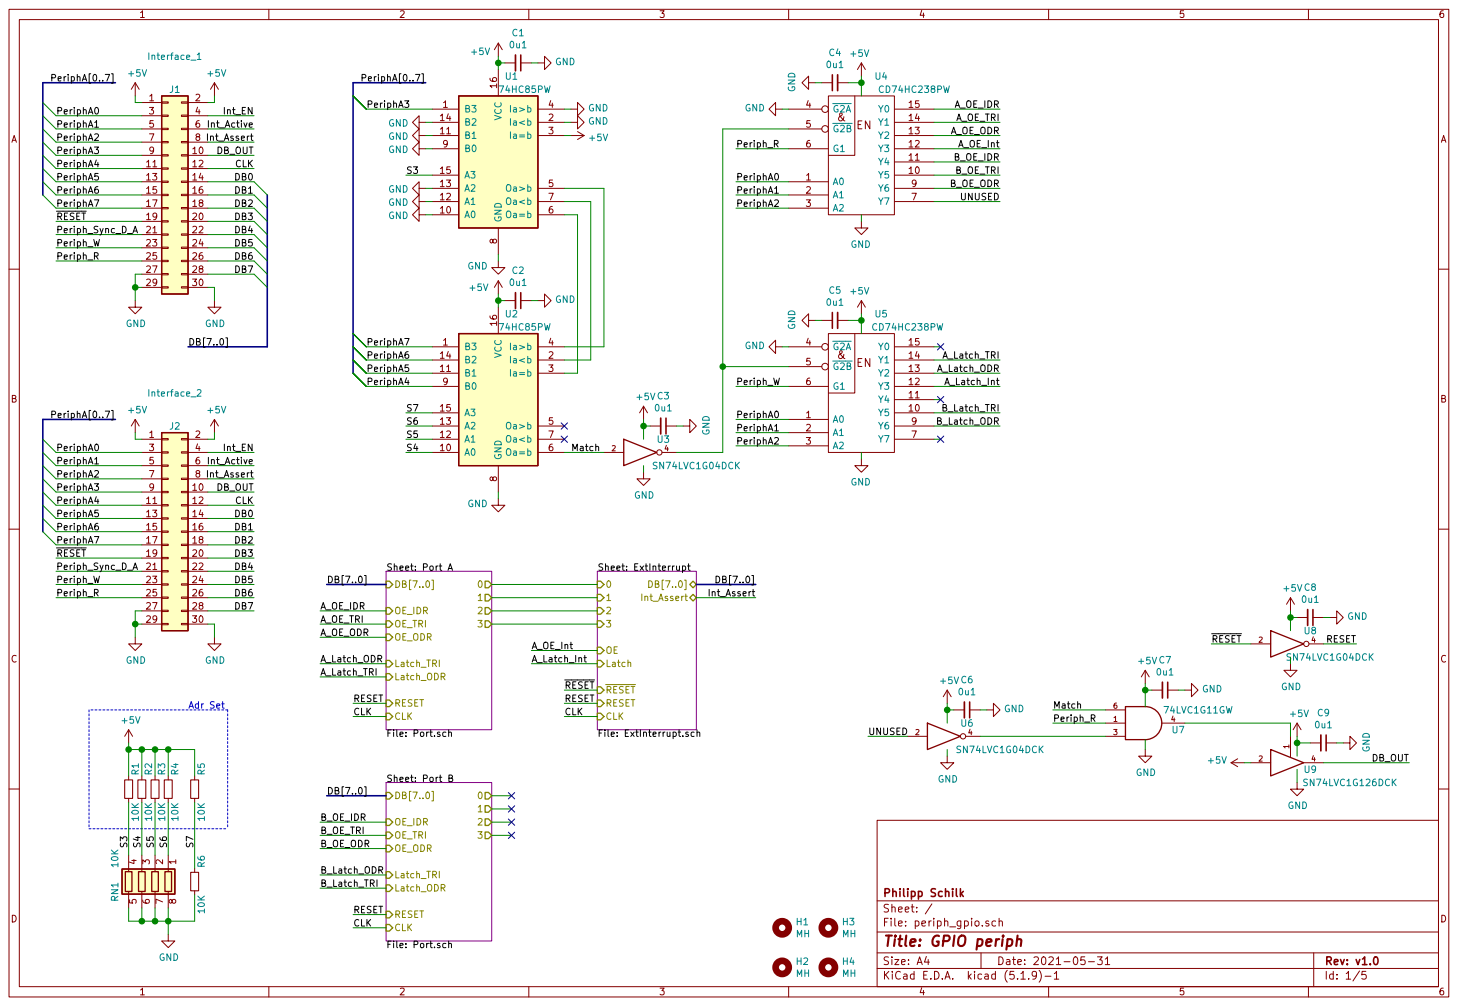
[picture p108: page 1]

File: Port.sch CLK RESET

File: periph_gpio.sch Sheet: / Philipp Schilk Sheet: Port B

Id: 1/5 Title: GPIO periph

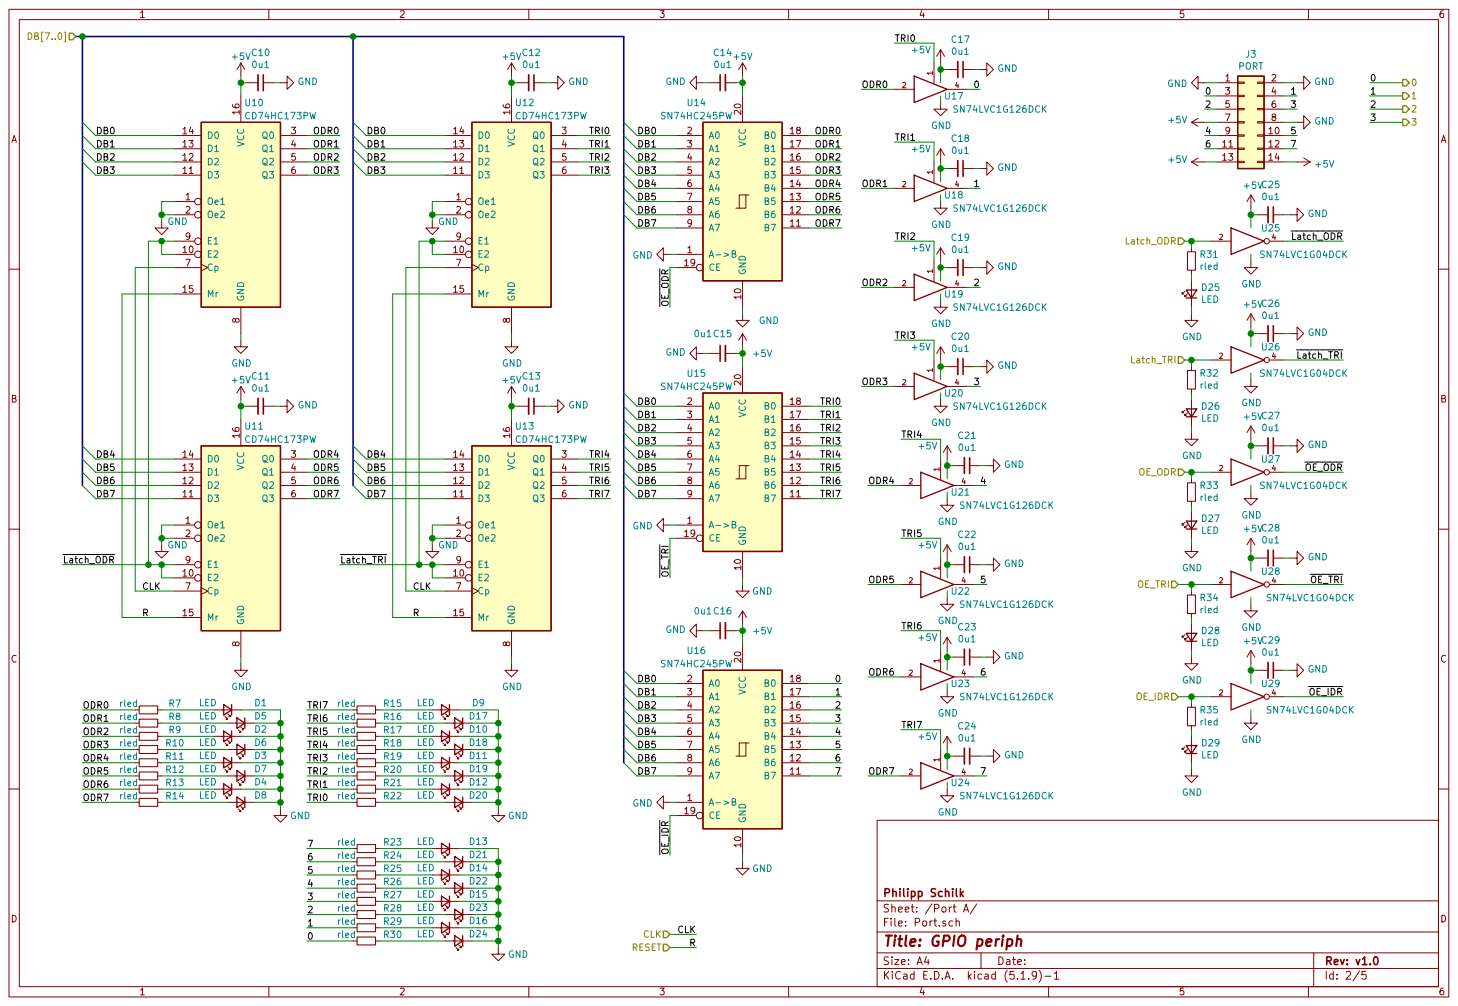
[picture p109: page 2]

File: Port.sch Sheet: /Port A/ Philipp Schilk

Id: 2/5 Title: GPIO periph

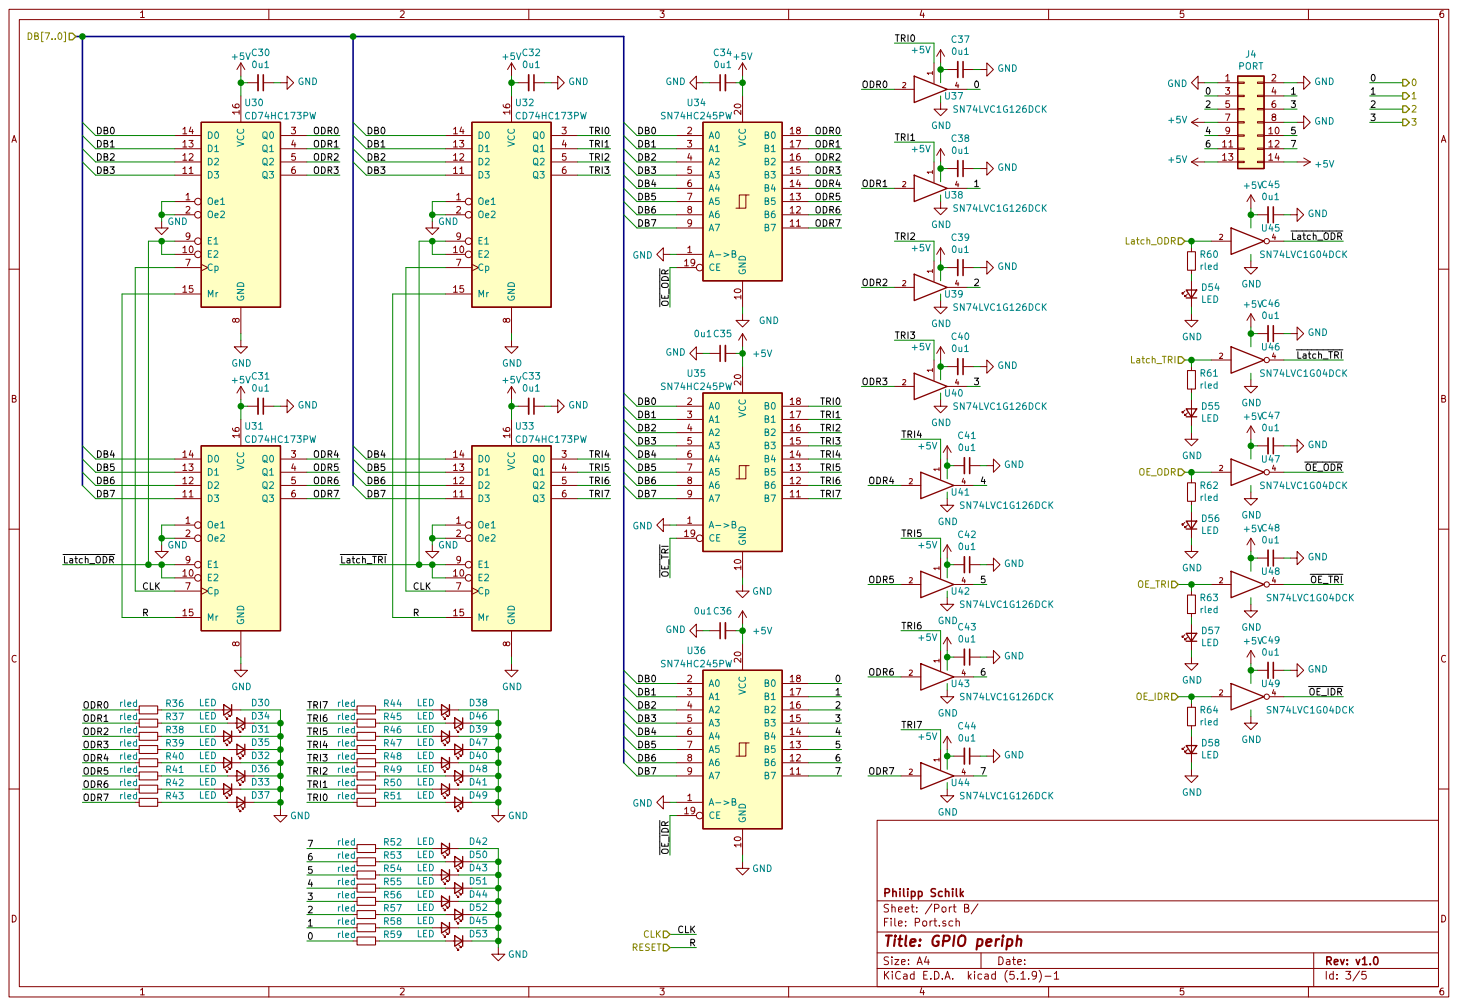
[picture p110: page 3]

File: Port.sch Sheet: /Port B/ Philipp Schilk

Id: 3/5 Title: GPIO periph

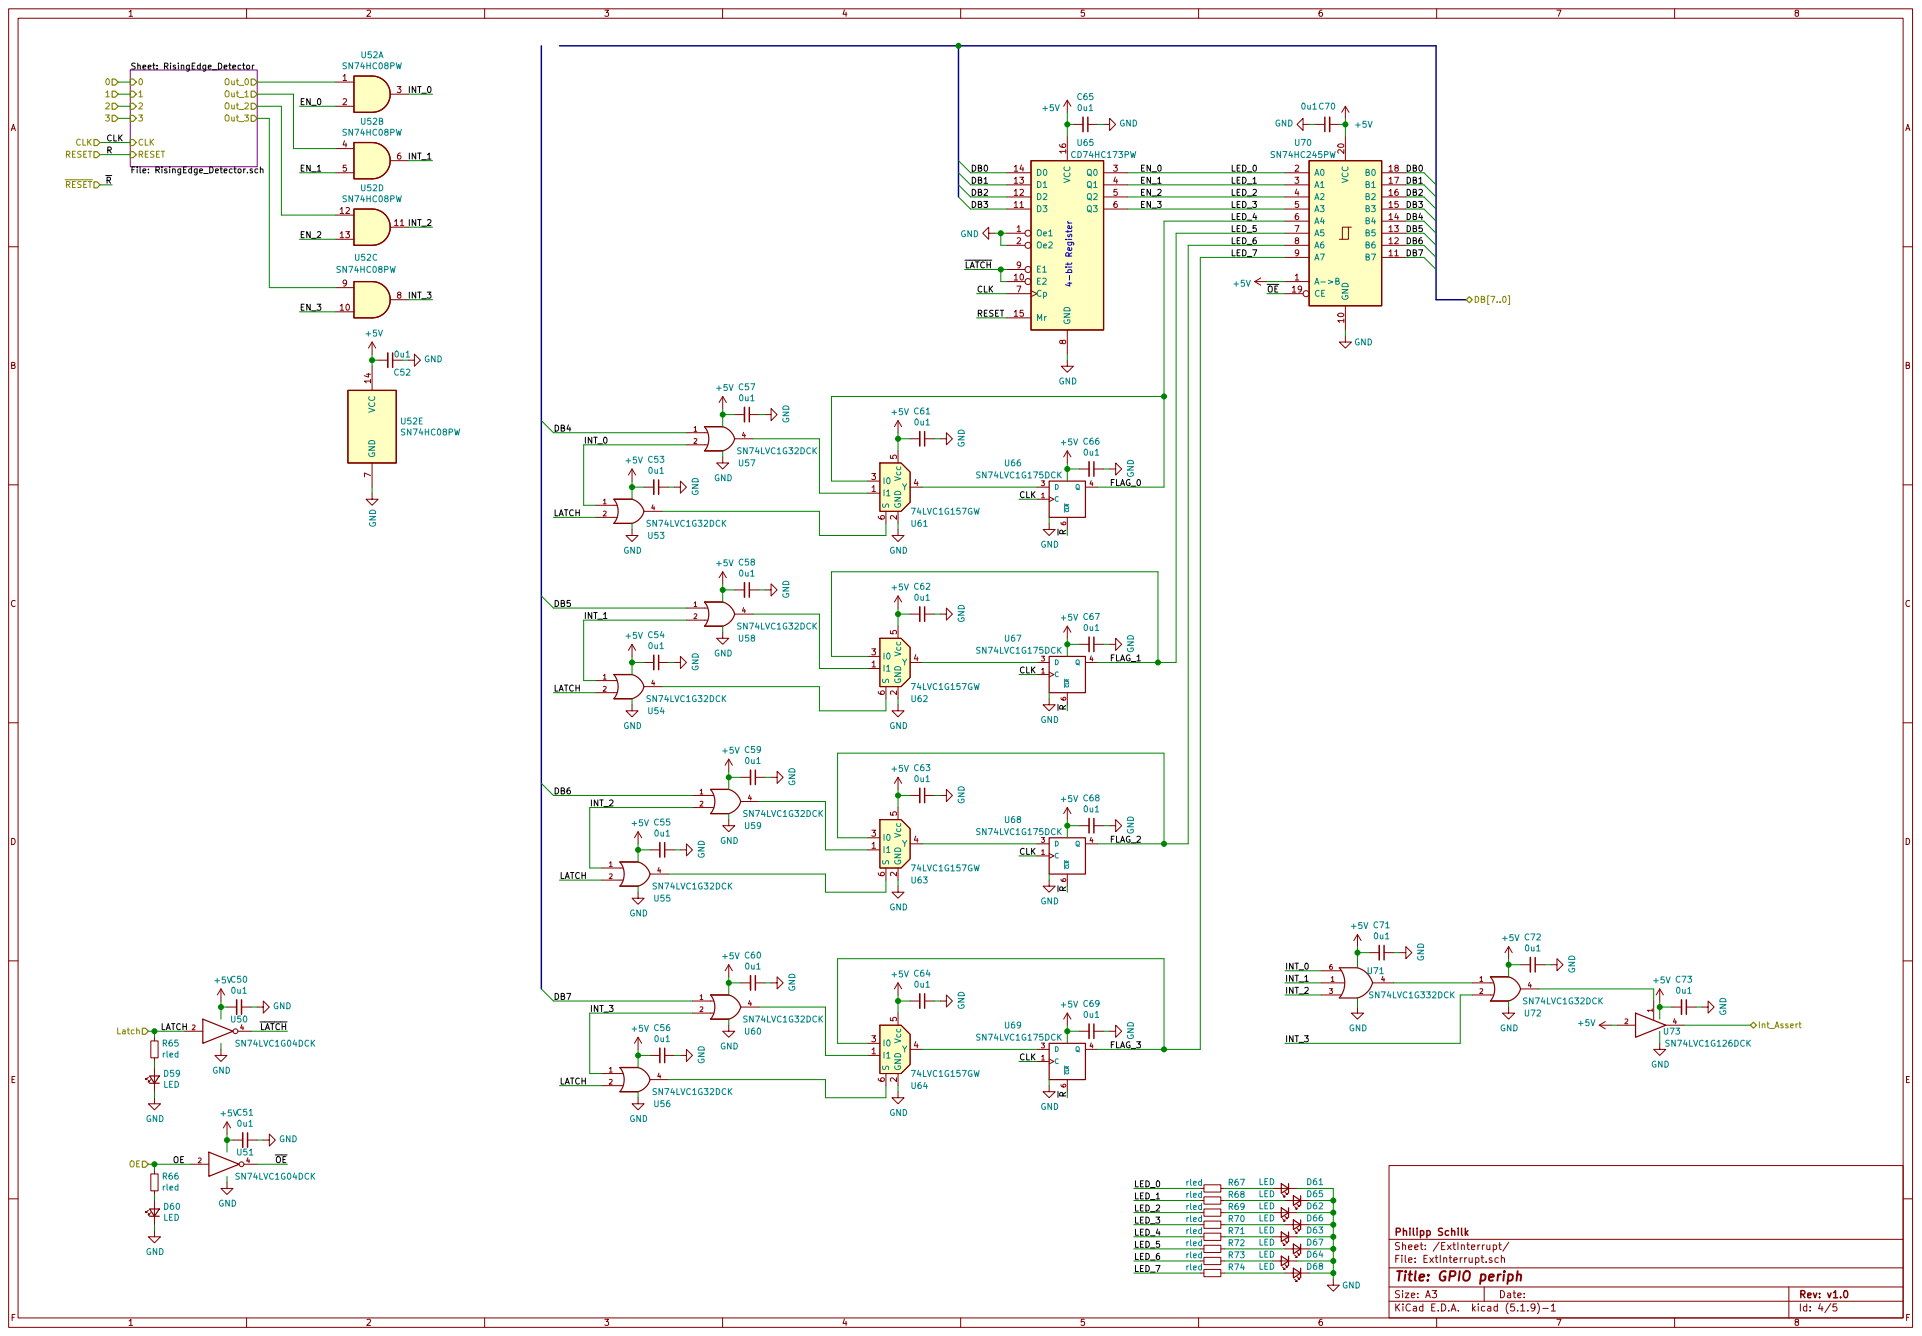
[picture p111: page 4]

Philipp Schilk
Sheet: /ExtInterrupt/
File: ExtInterrupt.sch
Id: 4/5 Title: GPIO periph

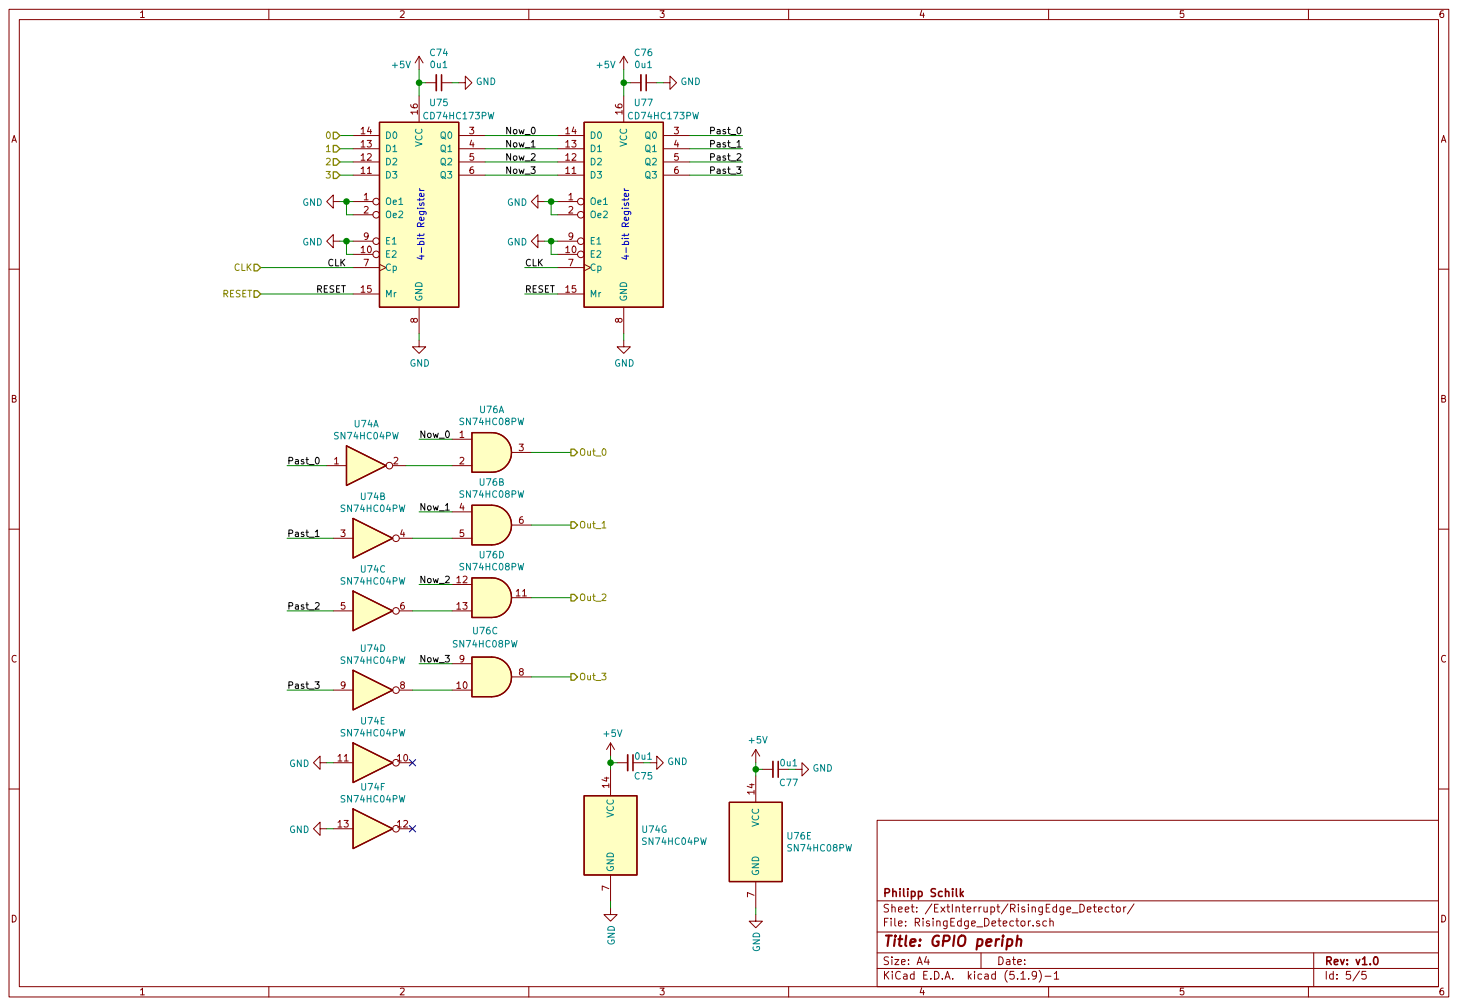
[picture p112: page 5]

Sheet: /ExtInterrupt/RisingEdge_Detector/
File: RisingEdge_Detector.sch
Id: 5/5 Title: GPIO periph
