TheSchilk/psMCU/ECAD/periph_numpad/schematic_periph_numpad.pdf

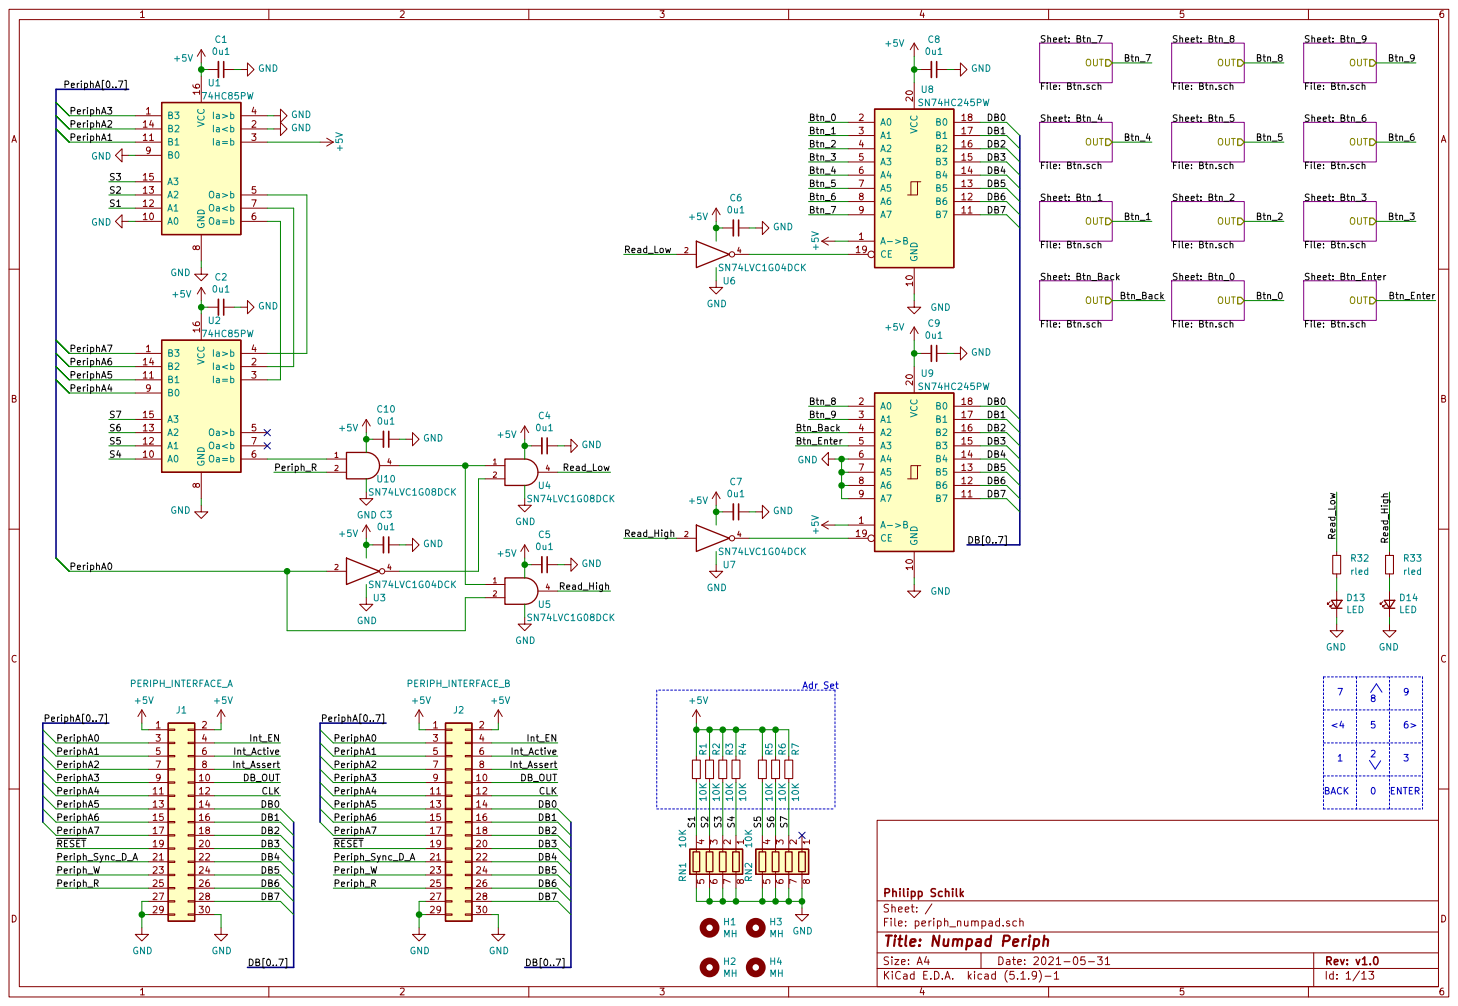
[picture p113: page 1]

File: periph_numpad.sch Sheet: / Philipp Schilk

Id: 1/13 Title: Numpad Periph

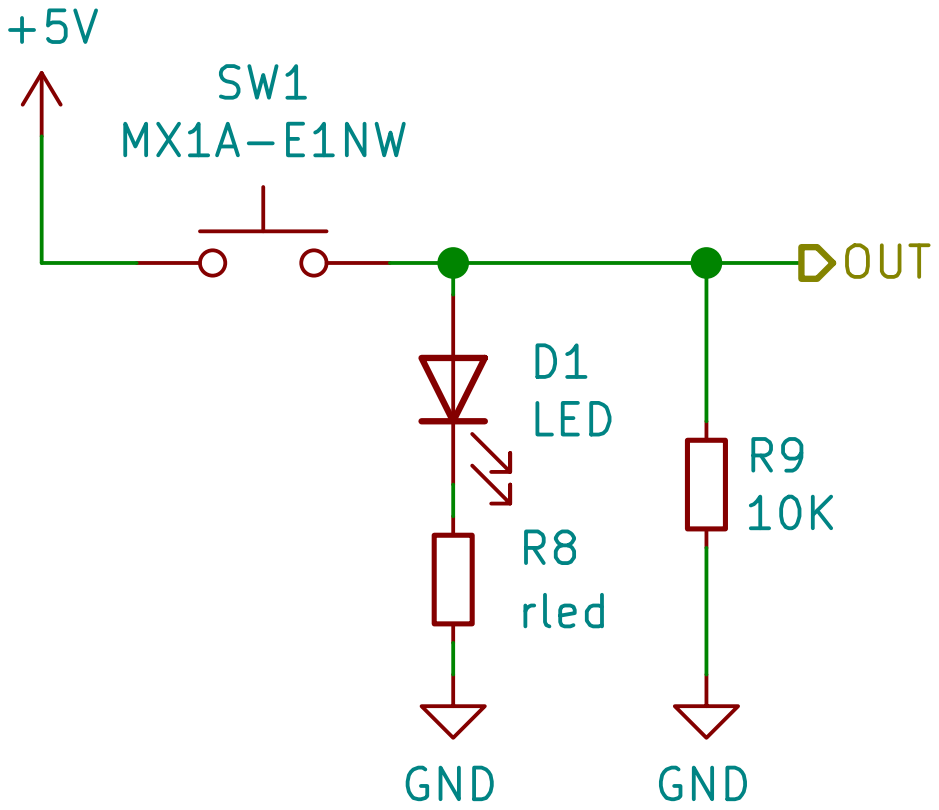
[picture p114: page 2]

Philipp Schilk
File: Btn.sch Sheet: /Btn_Back/
Id: 2/13 Title: Numpad Periph

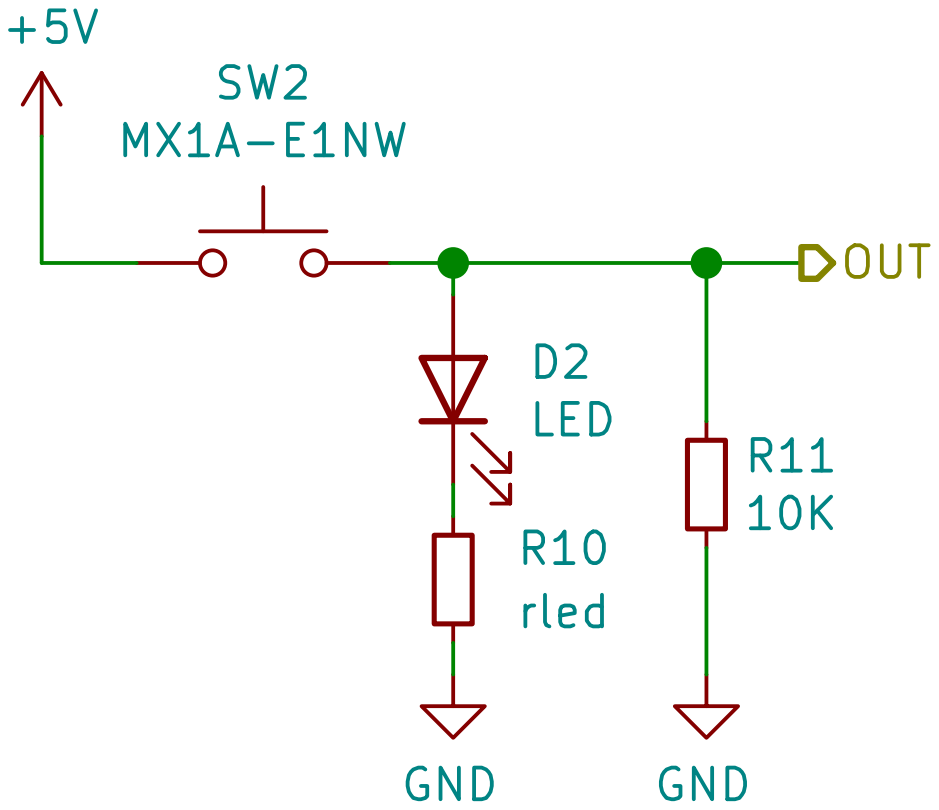
[picture p115: page 3]

Philipp Schilk
File: Btn.sch Sheet: /Btn_0/
Id: 3/13 Title: Numpad Periph

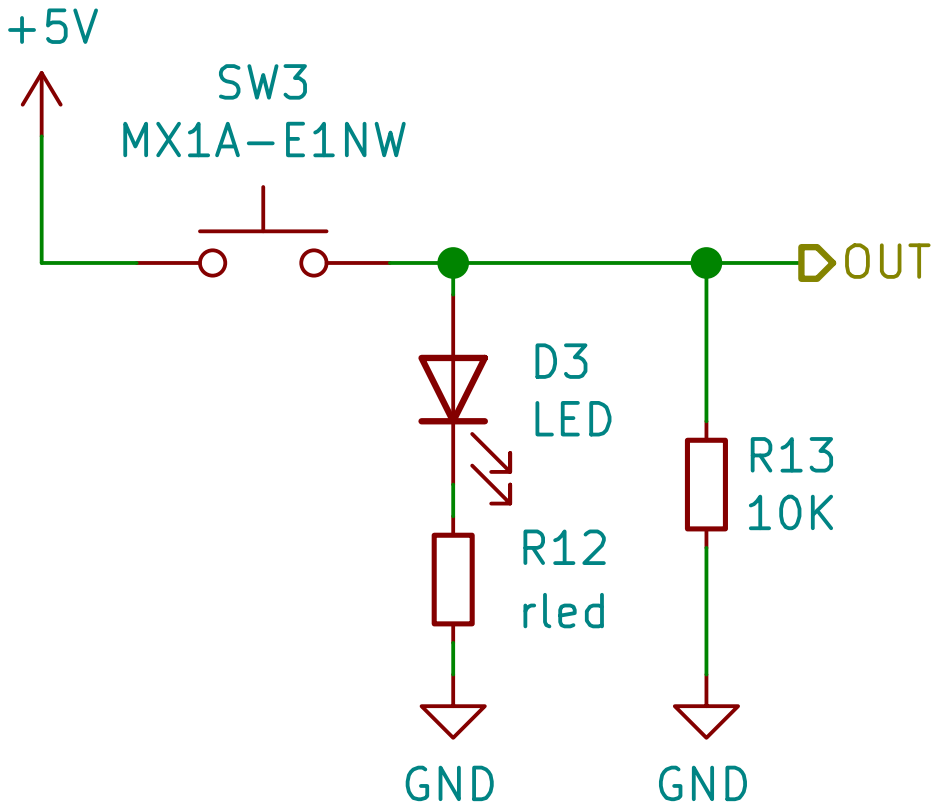
[picture p116: page 4]

Philipp Schilk
File: Btn.sch Sheet: /Btn_7/
Id: 4/13 Title: Numpad Periph

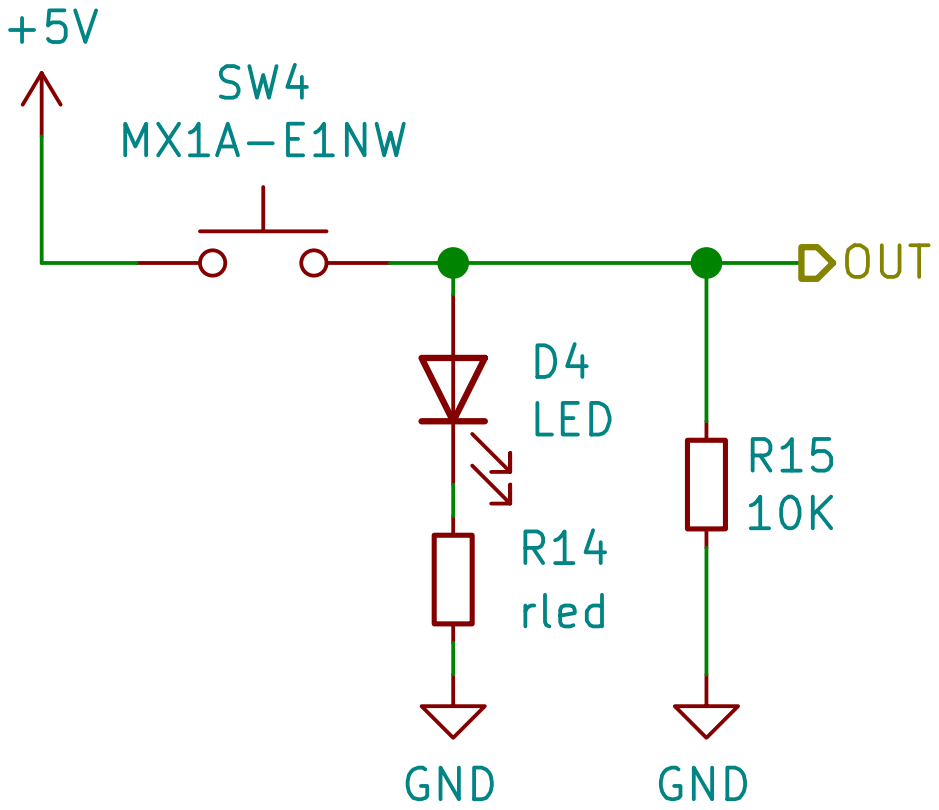
[picture p117: page 5]

Philipp Schilk
File: Btn.sch Sheet: /Btn_8/
Id: 5/13 Title: Numpad Periph

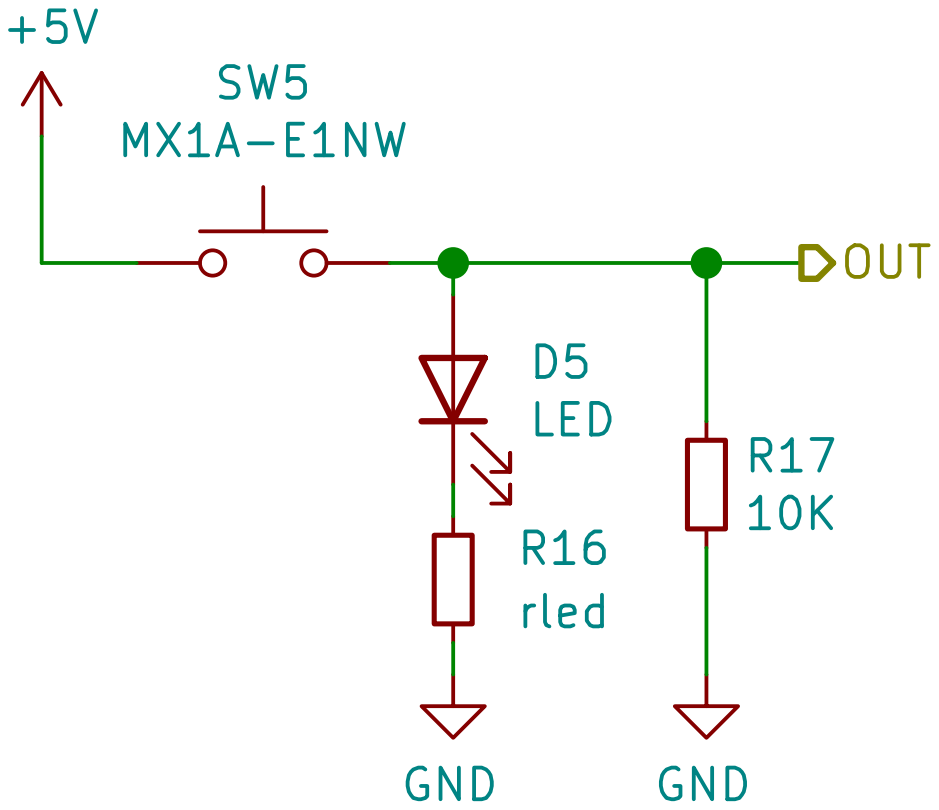
[picture p118: page 6]

Philipp Schilk
File: Btn.sch Sheet: /Btn_9/
Id: 6/13 Title: Numpad Periph

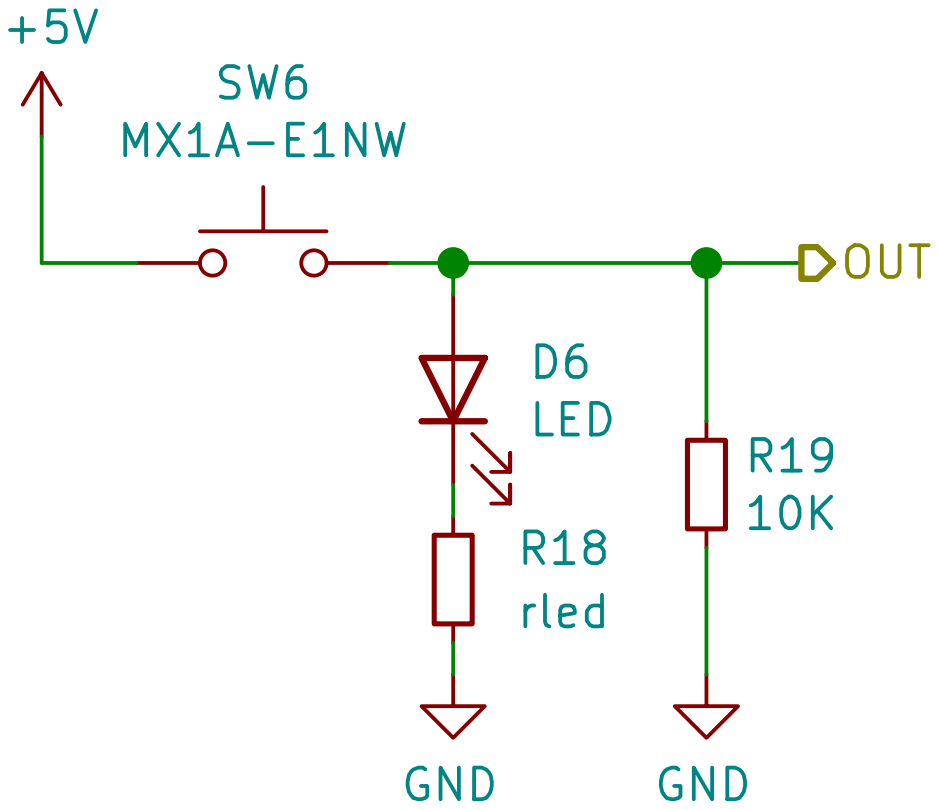
[picture p119: page 7]

Philipp Schilk
File: Btn.sch Sheet: /Btn_4/
Id: 7/13 Title: Numpad Periph

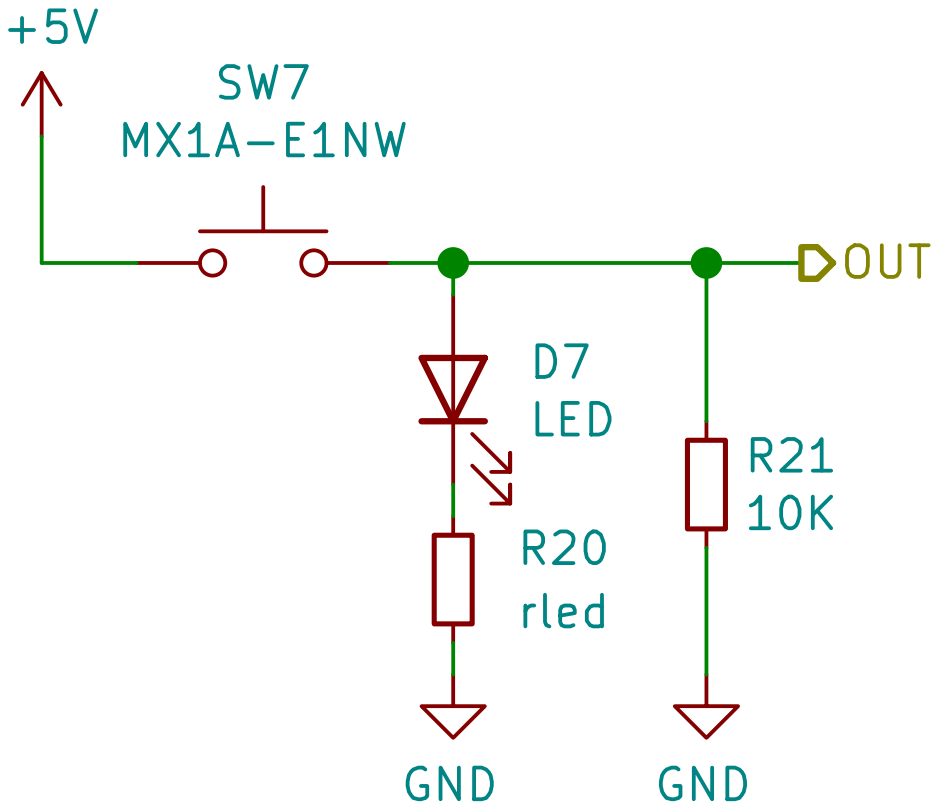
[picture p120: page 8]

Philipp Schilk
File: Btn.sch Sheet: /Btn_5/
Id: 8/13 Title: Numpad Periph

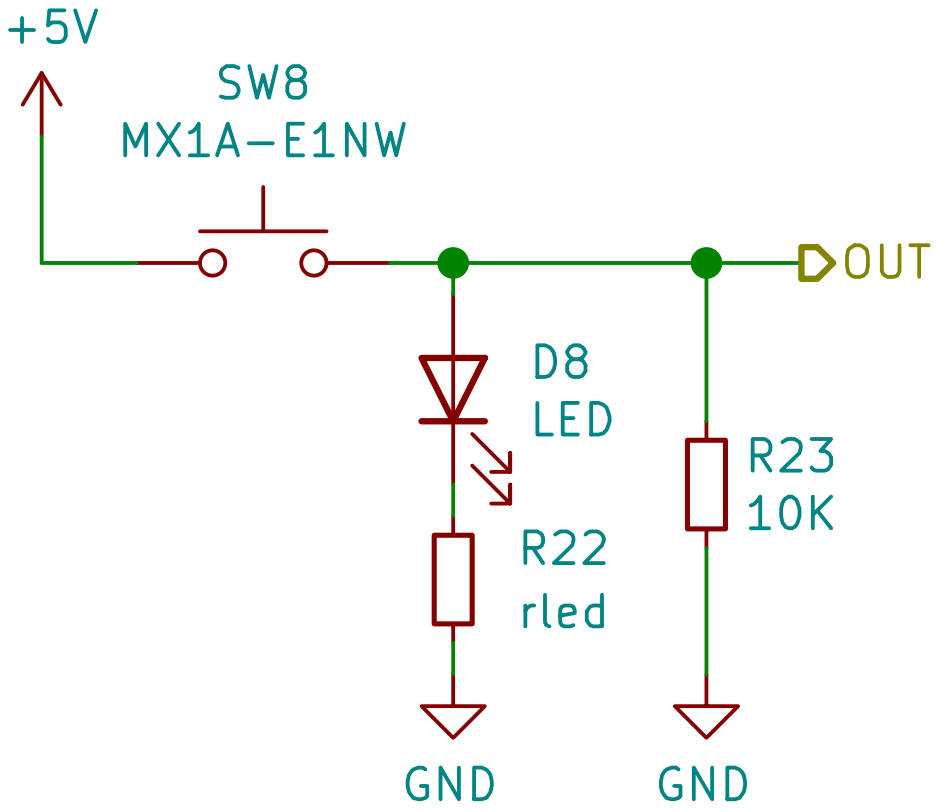
[picture p121: page 9]

Philipp Schilk
File: Btn.sch Sheet: /Btn_6/
Id: 9/13 Title: Numpad Periph

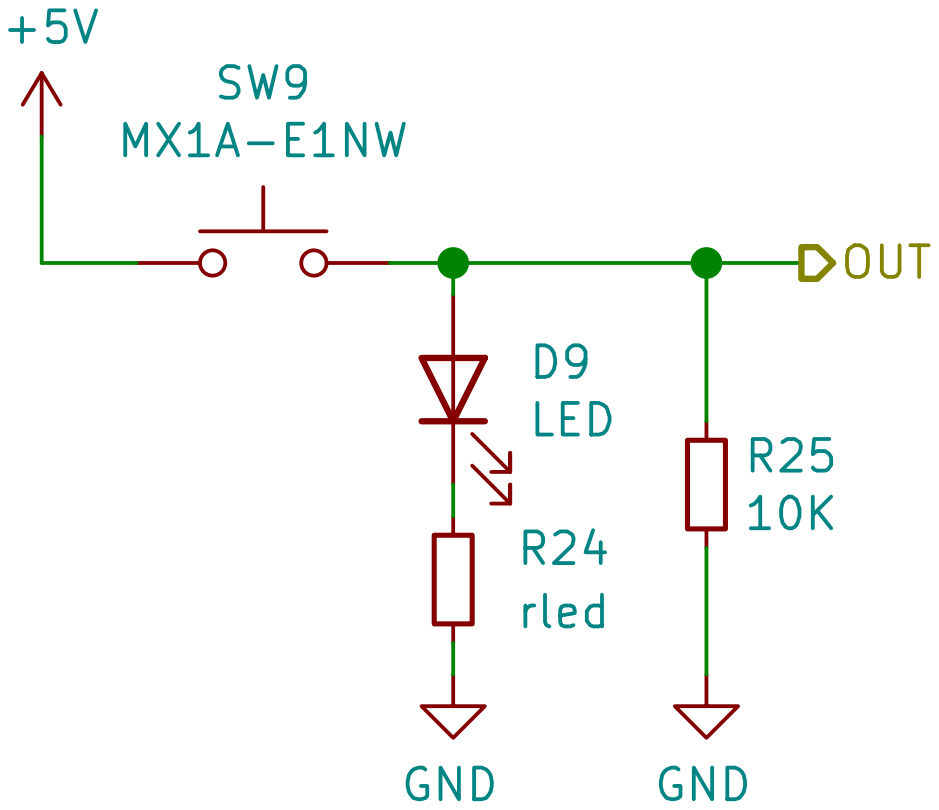
[picture p122: page 10]

Philipp Schilk
File: Btn.sch Sheet: /Btn_1/
Id: 10/13 Title: Numpad Periph

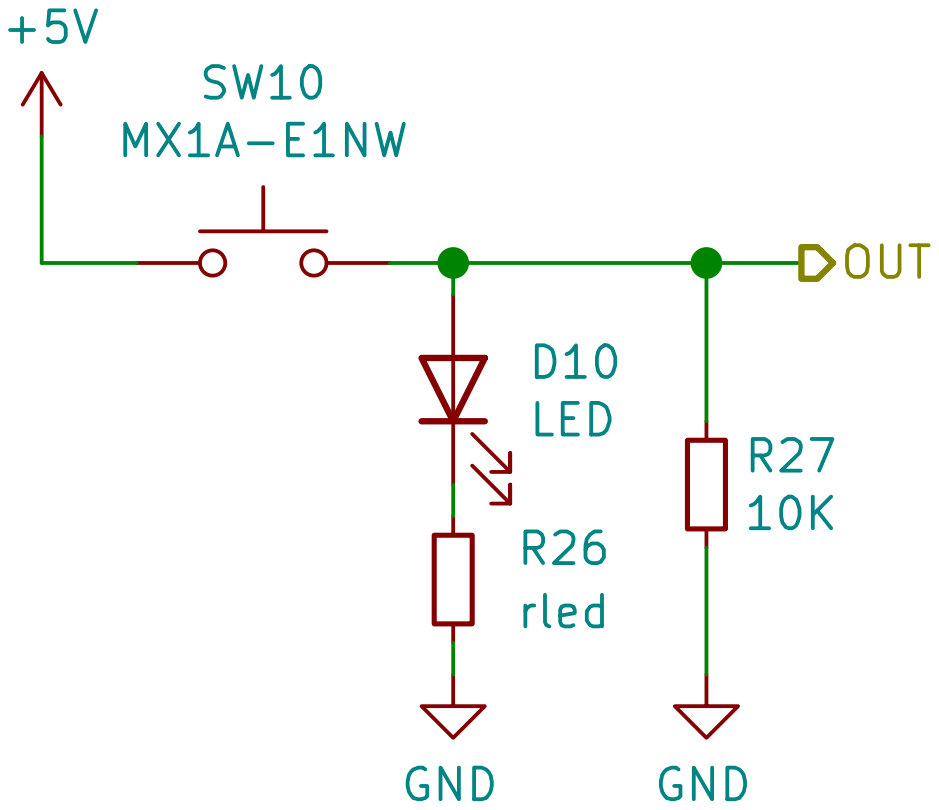
[picture p123: page 11]

Philipp Schilk
File: Btn.sch Sheet: /Btn_2/
Id: 11/13 Title: Numpad Periph

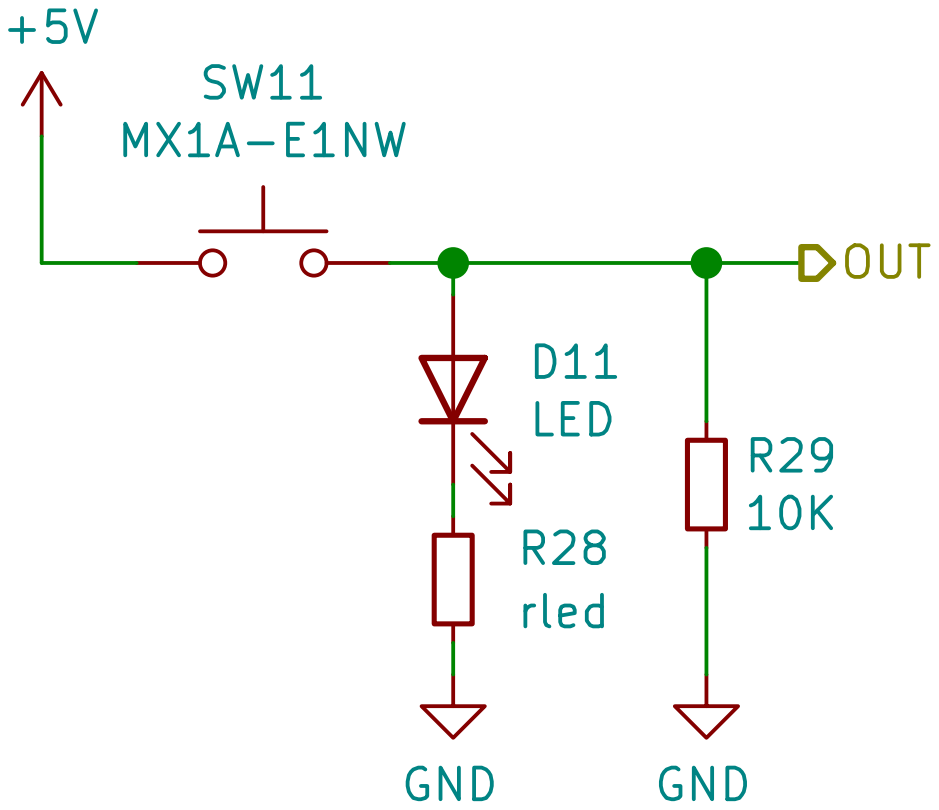
[picture p124: page 12]

Philipp Schilk
File: Btn.sch Sheet: /Btn_3/
Id: 12/13 Title: Numpad Periph

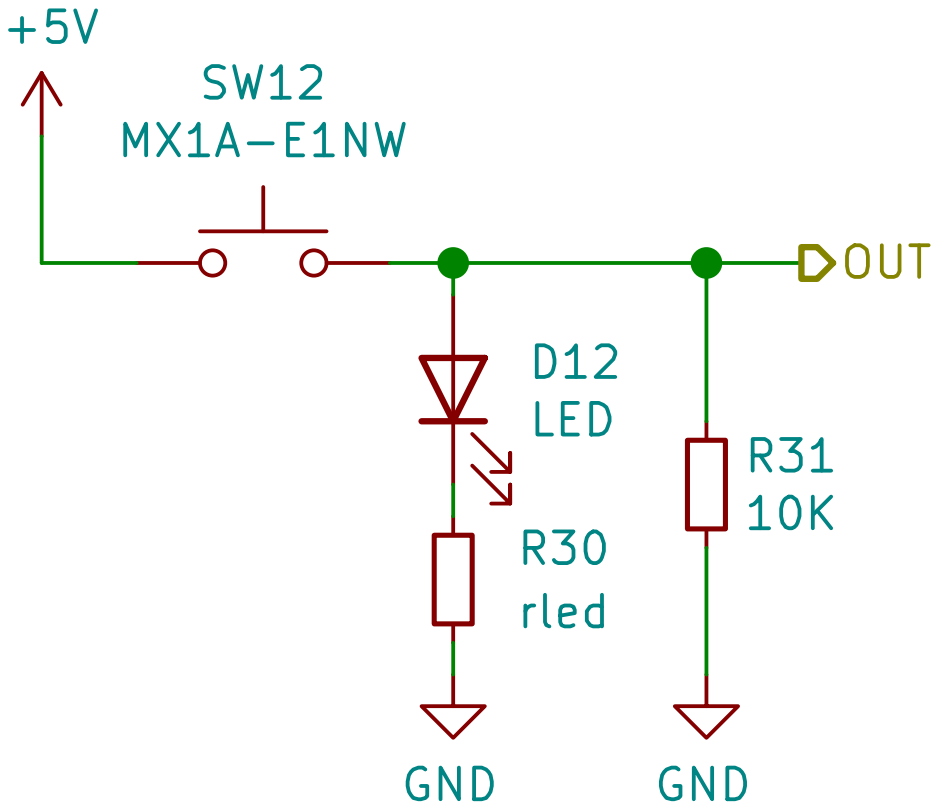
[picture p125: page 13]

Philipp Schilk
File: Btn.sch Sheet: /Btn_Enter/
Id: 13/13 Title: Numpad Periph
