TheSchilk/psMCU/ECAD/RemoteCtrl/schematic_RemoteCtrl.pdf

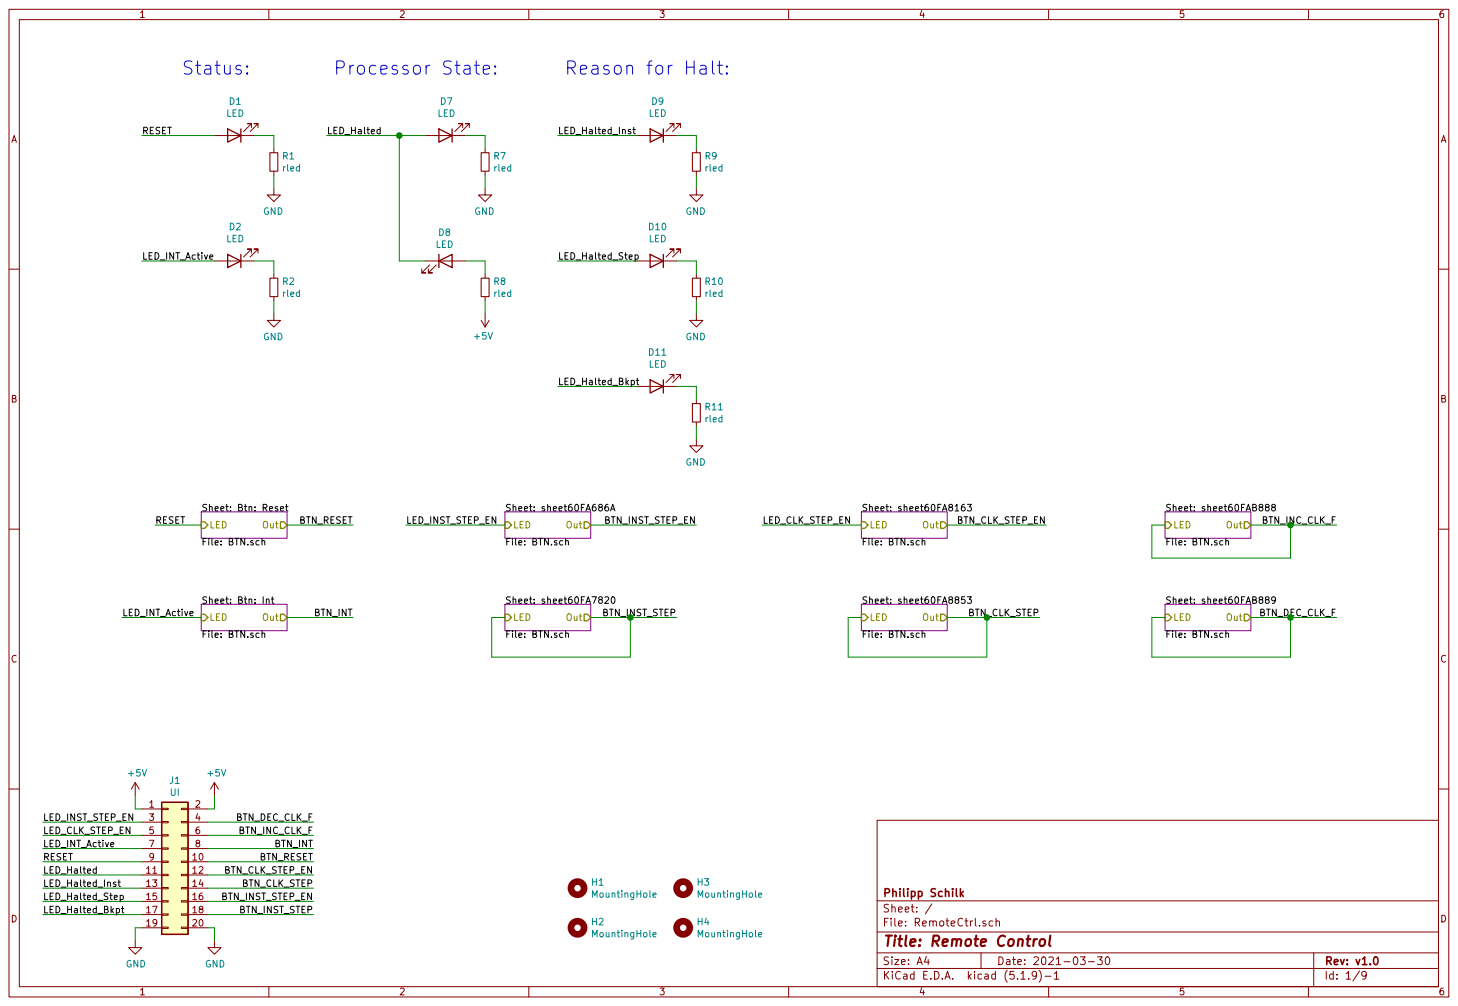
[picture p126: page 1]

Id: 1/9 Title: Remote Control File: RemoteCtrl.sch Sheet: / Philipp Schilk Sheet: sheet60FA8163 File: BTN.sch

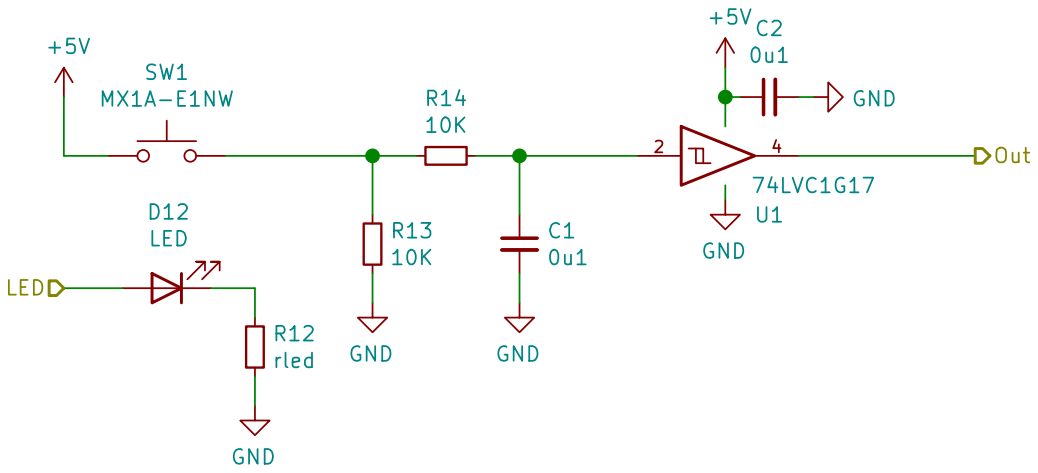
[picture p127: page 2]

Id: 2/9 Title: Remote Control File: BTN.sch Sheet: /Btn: Reset/ Philipp Schilk

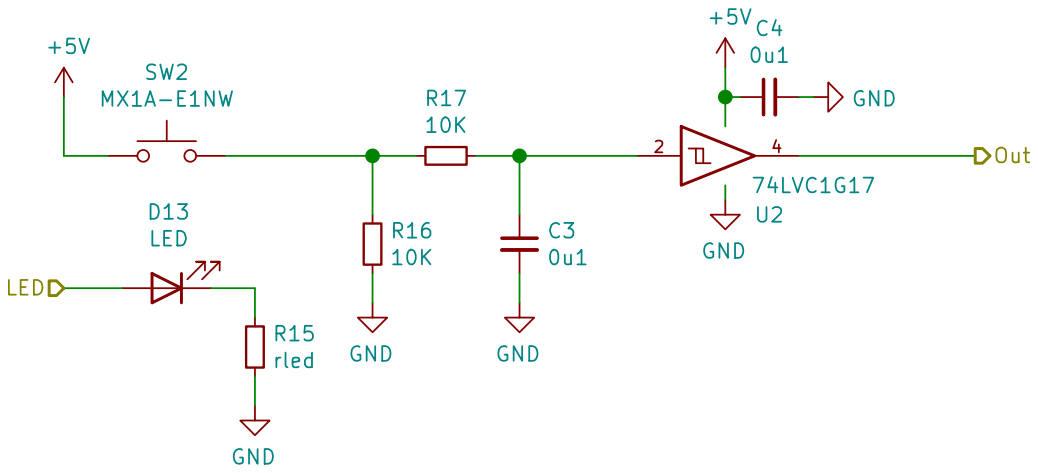
[picture p128: page 3]

Id: 3/9 Title: Remote Control File: BTN.sch Sheet: /Btn: Int/ Philipp Schilk

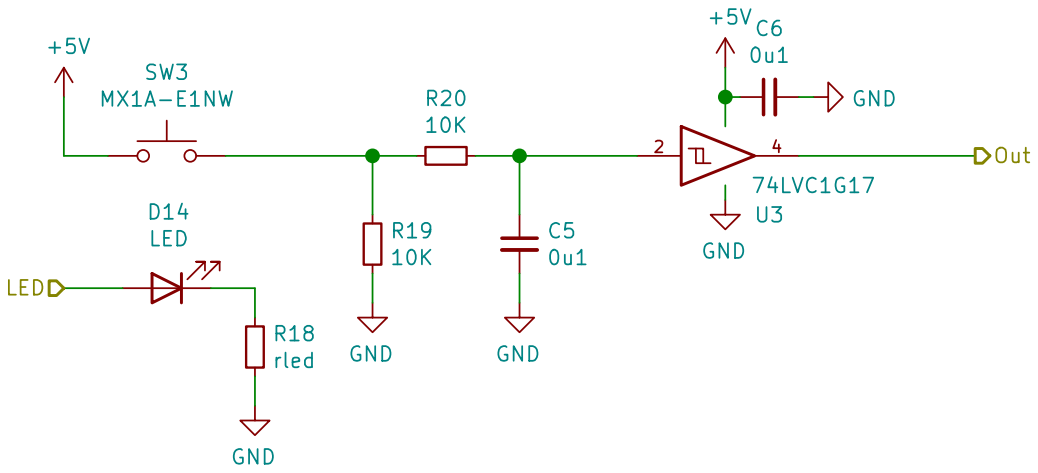
[picture p129: page 4]

Id: 4/9 Title: Remote Control File: BTN.sch Sheet: /sheet60FA686A/ Philipp Schilk

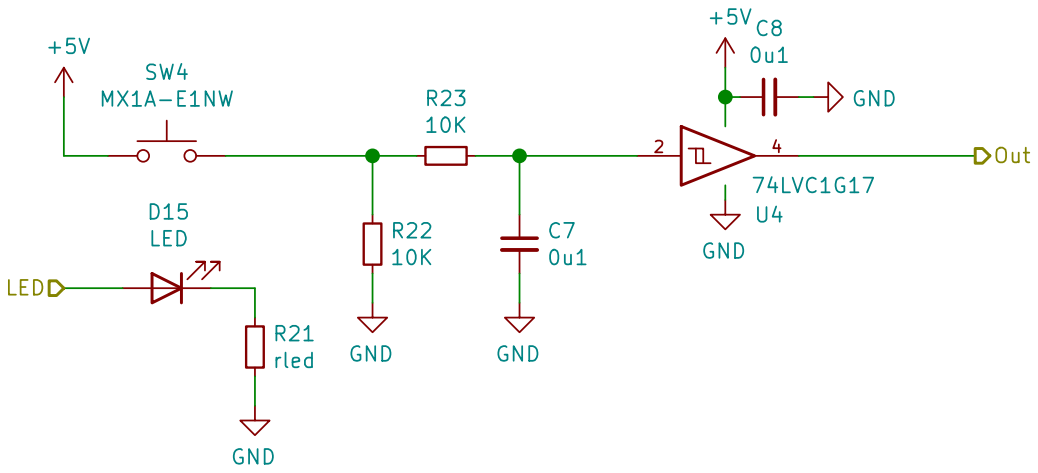
[picture p130: page 5]

Id: 5/9 Title: Remote Control File: BTN.sch Sheet: /sheet60FA7820/ Philipp Schilk

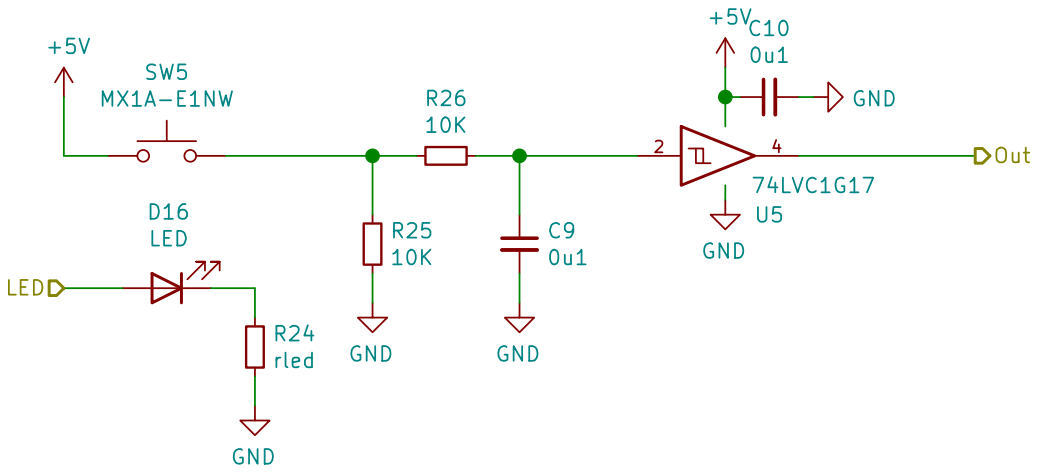
[picture p131: page 6]

Id: 6/9 Title: Remote Control File: BTN.sch Sheet: /sheet60FA8163/ Philipp Schilk

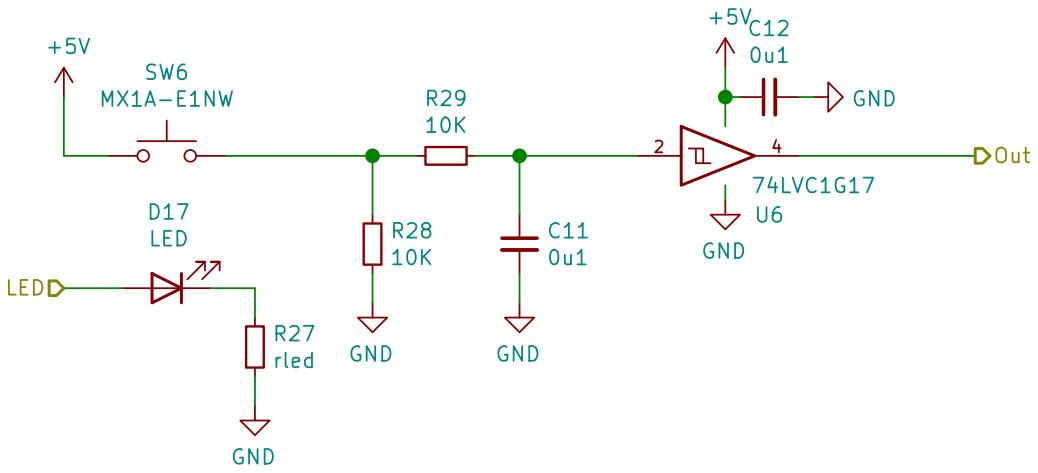
[picture p132: page 7]

Id: 7/9 Title: Remote Control File: BTN.sch Sheet: /sheet60FA8853/ Philipp Schilk

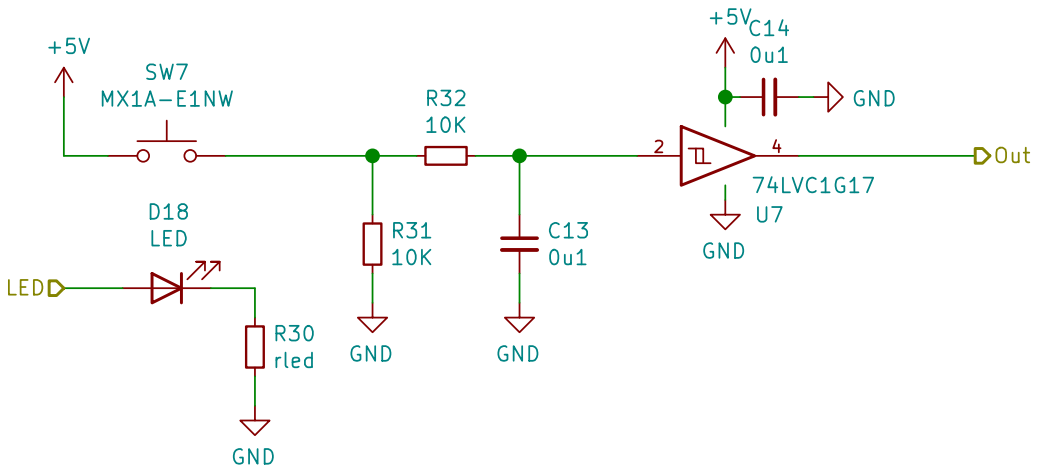
[picture p133: page 8]

Id: 8/9 Title: Remote Control File: BTN.sch Sheet: /sheet60FAB888/ Philipp Schilk

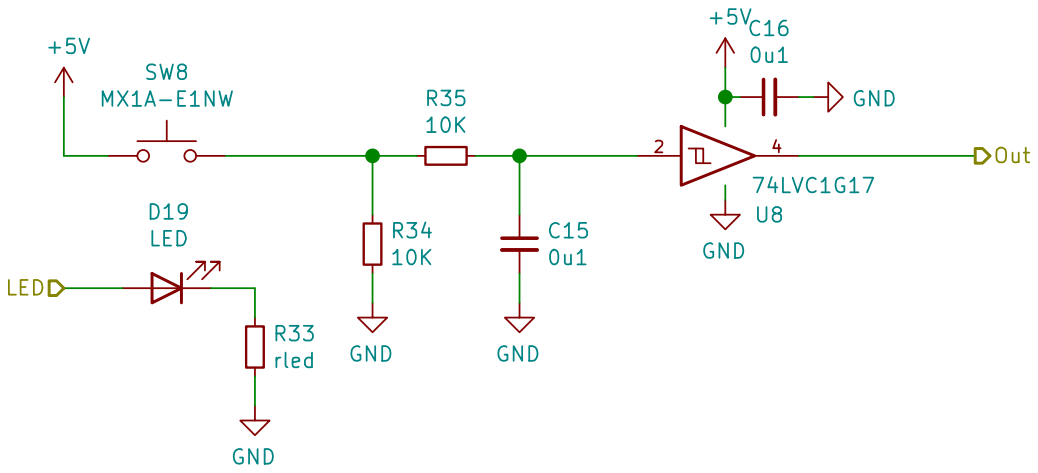
[picture p134: page 9]

Id: 9/9 Title: Remote Control File: BTN.sch Sheet: /sheet60FAB889/ Philipp Schilk
