TheSchilk/psMCU/(list of files, drawings)

Other design files:
Logisim/psMCU.circ
