TheSchilk/psMCU/(commit log)

2020-05-11 Basic Statemachine working
    [ControlRoms.xlsx, Encodings.xlsx, InstructionSet.xlsx, psMCU.circ]
2020-05-13 First Simulation Draft Working
    [ControlRoms.xlsx, Encodings.xlsx, InstructionSet.xlsx, MicroCodeRoms.xlsx, psMCU.circ]
2020-05-30 All Features implemented, psASM first working prototype done.
    [Encodings.xlsx, InstructionSet.xlsx, MicroCodeRoms.xlsx, psMCU.circ]
2020-06-13 Added Sync D-FF to write input of memory ICs
    Needed to rework microcode....
    should hopefully prevent any glitches on the ram/stack write line causing accidental writes.
    [MicroCodeRoms.xlsx, psMCU.circ]
2020-07-22 Fixed small ROM error
    [MicroCodeRoms.xlsx, psMCU.circ]
2020-07-25 Increase Size of Stack to match RAM
    [psMCU.circ]
2020-08-14 Interrupts working!
    [Encodings.xlsx, MicroCodeRoms.xlsx, psMCU.circ]
2020-08-15 Refactored psASM and added Interrupt support
2020-08-16 Imported KiCad Project/Started cleanup
    [1BitLED.sch, 8BitLED.sch, Breakpoint.sch, CTRL_UI.sch, ClockCtrl.sch, ClockCtrlUI.sch, Control.sch, Control_Rom.sch]
2020-08-16 Added Pallet to schematic.
    [1BitLED.sch, 8BitLED.sch, CTRL_UI.sch, ClockCtrl.sch, ClockCtrlUI.sch, Control.sch, Control_Rom.sch, CrossOver.sch]
2020-08-17 Started work on schematic
    [14BitLED.sch, 1BitLED.sch, 8BitLED.sch, 9BitLED.sch, BarrelShifter.sch, BarrelShifter_Line.sch, Breakpoint.sch, CTRL_UI.sch]
2020-08-17 Changed System Registers, Updated Doc
    [Encodings.xlsx, psMCU.circ]
2020-08-17 Added shadow register to System Reg 1
    [psMCU.circ]
2020-08-17 Added Scratch Registers
    [psMCU.circ]
2020-08-17 Cleaned up Programms, Updated some Documentation.
    [Encodings.xlsx]
2020-08-17 Renamed Conditional and DynamicMem Instructions
    [Encodings.xlsx, InstructionSet.xlsx, MicroCodeRoms.xlsx]
2020-09-02 small changes
    [psMCU.circ]
2020-12-04 Added new Instructions, not yet tested
    - Added PUSHA, PUSHB, PUSHM, POPA, POPB, POPM instead of PUSH/POP
    - Added ADDLA, ADDLB instead of ADDL
    [Encodings.xlsx, InstructionSet.xlsx, MicroCodeRoms.xlsx, psMCU.circ]
2020-12-04 Fixed POPM instruction not decrementing stackptr
    [MicroCodeRoms.xlsx, psMCU.circ]
2020-12-05 Added SUBL instruction
    [Encodings.xlsx, InstructionSet.xlsx, psMCU.circ]
2020-12-05 Fixed SYS3 Bitorder inconsistency
    [Encodings.xlsx, psMCU.circ]
2020-12-05 Added psMCU copy with 8snake peripherals
    [peripheral_8x8disp.circ, peripheral_IOLR.circ, psMCU_8snake.circ]
2020-12-05 Loaded snake code into psMCU
    [psMCU_8snake.circ]
2020-12-07 Fixed Interrupt
    [psMCU.circ, psMCU_8snake.circ]
2021-02-13 Started Schematic Capture...
    [0Detect.sch, 12BitLED.sch, 14BitLED.sch, 16BitLED.sch, 1BitLED.sch, 8BitLED.sch, 9BitLED.sch, ALU.sch]
2021-02-14 Pulled in from clock test, root layout first draft
    [0Detect.sch, 12BitLED.sch, 14BitLED.sch, 14Bit_7Seg.sch, 16BitLED.sch, 1BitLED.sch, 7SegLeds.sch, 8Bit_7Seg.sch]
2021-02-14 More small adjustments.
    [1BitLED.sch, 7SegLeds.sch, 8BitLED.sch, 8bit7seg.sch, AdrComparator.sch, Clock_Div.sch, Control.sch, Control_Rom.sch]
2021-02-14 First ERC pass
    All unconnects solved, need to inspect Tristate errors.
    [0Detect.sch, 12BitLED.sch, 14BitLED.sch, 14Bit_7Seg.sch, 16BitLED.sch, 1BitLED.sch, 7SegLeds.sch, 8BitLED.sch]
2021-02-14 Removed accidental anotation
    [0Detect.sch, 12BitLED.sch, 14BitLED.sch, 14Bit_7Seg.sch, 16BitLED.sch, 1BitLED.sch, 7SegLeds.sch, 8BitLED.sch]
2021-02-14 Added some footprints, small optimisations
    [0Detect.sch, 14Bit_7Seg.sch, ALU.sch, AdrComparator.sch, BTN_TOGGLE.sch, BTN_TRIG.sch, BarrelShifter.sch, BarrelShifter_Line.sch]
2021-02-14 Started some documentation work.
    [BTN_TOGGLE.sch, BTN_TRIG.sch, BitTest.sch, Breakpoint.sch, ClkPreset.sch, Clock.sch, Clock_Div.sch, Clock_Div_Ctrl.sch]
2021-02-14 Removed Single LED sheets
    [0Detect.sch, 12BitLED.sch, 14BitLED.sch, 14Bit_7Seg.sch, 16BitLED.sch, 1BitLED.sch, 7SegLeds.sch, 8BitLED.sch]
2021-02-17 First Schematic Draft done.
    [0Detect.sch, 12BitLED.sch, 14BitLED.sch, 14Bit_7Seg.sch, 16BitLED.sch, 16Bit_7Seg.sch, 1BitLED.sch, 7SegLeds.sch]
2021-02-17 Schematic outline for Programmer.
    [Programmer.kicad_pcb, Programmer.sch]
2021-02-17 Schematic outline for Remote Control
    [BTN.sch, RemoteCtrl.kicad_pcb, RemoteCtrl.sch]
2021-02-17 Small improvements.
    [0Detect.sch, 12BitLED.sch, 14BitLED.sch, 14Bit_7Seg.sch, 16BitLED.sch, 16Bit_7Seg.sch, 7SegLeds.sch, 8BitLED.sch]
2021-02-18 Rough layout of Remote finished.
    Did not do connector yet, in case that changes with
    psMCU layout.
    [RemoteCtrl.kicad_pcb, RemoteCtrl.sch]
2021-02-20 Cleanup, ready for specific component values.
    [0Detect.sch, 12BitLED.sch, 14BitLED.sch, 14Bit_7Seg.sch, 16BitLED.sch, 16Bit_7Seg.sch, 7SegLeds.sch, 8BitLED.sch]
2021-02-20 Updated values and footprints.
    [0Detect.sch, 14Bit_7Seg.sch, 16BitLED.sch, 16Bit_7Seg.sch, 8BitLED.sch, 8bit7seg.sch, ALU.sch, AdrComparator.sch]
2021-02-20 Reworked ref. location in schematic.
    [0Detect.sch, 12BitLED.sch, 14BitLED.sch, 14Bit_7Seg.sch, 16BitLED.sch, 16Bit_7Seg.sch, 7SegLeds.sch, 8BitLED.sch]
2021-02-20 ERC clean.
    [0Detect.sch, 14BitLED.sch, 16BitLED.sch, 7SegLeds.sch, 8BitLED.sch, AdrComparator.sch, BTN_TRIG.sch, BarrelShifter_Line.sch]
2021-02-20 Finished Schematic Validation/Documentation
    [0Detect.sch, 14BitLED.sch, 14Bit_7Seg.sch, 16BitLED.sch, 16Bit_7Seg.sch, 7SegLeds.sch, 8BitLED.sch, 8bit7seg.sch]
2021-02-21 Worked on side-pcbs
    [GPIO_PORT.sch, Programmer.kicad_pcb, Programmer.sch, RemoteCtrl.kicad_pcb, periph_gpio.kicad_pcb, periph_gpio.sch, periph_numpad.kicad_pcb, periph_numpad.sch]
2021-03-04 First layout parts
    [0Detect.sch, 12BitLED.sch, 14BitLED.sch, 14Bit_7Seg.sch, 16BitLED.sch, 16Bit_7Seg.sch, 7SegLeds.sch, 8BitLED.sch]
2021-03-04 Got rid of 7segs/CPLDs, KISS!
    [0Detect.sch, 12BitLED.sch, 14BitLED.sch, 16BitLED.sch, 8BitLED.sch, 9BitLED.sch, ALU.sch, AdrComparator.sch]
2021-03-21 Sub-Block Layout mostly finished
    [0Detect.sch, 12BitLED.sch, 14BitLED.sch, 16BitLED.sch, 8BitLED.sch, 9BitLED.sch, ALU.sch, AdrComparator.sch]
2021-03-21 Reduced SysReg3 Size
    [SysReg_3.sch]
2021-03-26 Block Layout done :)
    [AdrComparator.sch, Inst0..7_to_DBus.sch, Programmer.sch, ROM.sch, SysReg_3.sch]
2021-03-27 Finished most intra-block wiring
    ! Block connection start here!
    [ALU.sch, AdrComparator.sch, BTN_TOGGLE.sch, BTN_TRIG.sch, Clock_Div.sch, ROM.sch]
2021-03-29 Power Net Routing mostly done
2021-03-29 Most components connected to power grid.
2021-03-30 Programmer first draft layout
    [Programmer.kicad_pcb, Programmer.sch, ROM.sch]
2021-03-30 First draft Remote Control
    [RemoteCtrl.kicad_pcb, UI.sch]
2021-03-30 Restructured KiCad Folders
    [0Detect.sch, 12BitLED.sch, 14BitLED.sch, 14Bit_7Seg.sch, 16BitLED.sch, 16Bit_7Seg.sch, 7SegLeds.sch, 8BitLED.sch]
2021-03-30 Changed Programmer to differnet STM32
    [Programmer.kicad_pcb, Programmer.sch]
2021-03-30 Generated Production Files
    For:
    psMCU v0.1
    Programmer v0.1
    RemoteCtrl v0.1
    [0Detect.sch, 12BitLED.sch, 14BitLED.sch, 16BitLED.sch, 8BitLED.sch, 9BitLED.sch, ALU.sch, AdrComparator.sch]
2021-04-04 Got rid of last scratch register remains
    [psMCU.circ, psMCU_8snake.circ]
2021-04-11 Created test suit to flash pre-soldering
    Should the in-circuit programming not work,
    this will allow me to test most instructions.
2021-04-16 Small improvements to board bring-up tests
2021-05-09 Reduced SPI freq to improve bkpt EN stability
2021-05-09 psPROG: Hold reset in multi-pckg operation.
    [Package.py, ProgrammerInterface.py]
2021-05-21 Ignoring STM32 Drivers/Hal/usw from language stats
2021-05-23 Fixed linguist STM32 Driver ignore
2021-05-31 Logisim: New clocking + Instruction Stepping
    [peripheral_8x8disp.circ, peripheral_IOLR.circ, psMCU.circ, psMCU_8snake.circ]
2021-05-31 Logisim: Interrupts updated, now work with new clk
    [MicroCodeRoms.xlsx, psMCU.circ]
2021-05-31 Logisim: Added Button Interrupt flag
    Also updated StdLib/Documentation
    [Encodings.xlsx, psMCU.circ]
2021-05-31 Moved Rom Generation to OpenOffice
    [MicroCodeRoms.ods, MicroCodeRoms.xlsx]
2021-05-31 Moved Decode ROM to LibreOffice + Python Gen
    [DecodeROM.ods, Encodings.xlsx]
2021-05-31 Moved Instruction set to LibreOffice
    [InstructionSet.ods, InstructionSet.xlsx]
2021-05-31 Logisim: Re-organisied + expanded MicroCode ROMs
    [MicroCodeRoms.ods, psMCU.circ]
2021-05-31 Logisim: Added A/B switch
    Unused and untested
    [psMCU.circ]
2021-05-31 Logisim: Moved to 8-bit inst decode
    [DecodeROM.ods, psMCU.circ]
2021-05-31 Logisim: Change ALU flag handling
    [psMCU.circ]
2021-05-31 Redesigned Instruction Set
    [InstructionSet.ods]
2021-05-31 Logisim: Re-designed stack
    [MicroCodeRoms.ods, psMCU.circ]
2021-05-31 Updated Decode ROM
    [DecodeROM.ods]
2021-05-31 Logisim: Added 'Offset = 0' line to stack
    [psMCU.circ]
2021-05-31 Updated MicroCode
    [MicroCodeRoms.ods, psMCU.circ]
2021-05-31 Fixed small typo in Instruction Set table
    [InstructionSet.ods]
2021-05-31 Fixed microcode bug, changed sysreg adr.
    [MicroCodeRoms.ods, psMCU.circ]
2021-05-31 Logisim: Reworked ALU flags, added COMP flags
    [DecodeROM.ods, InstructionSet.ods, MicroCodeRoms.ods, psMCU.circ]
2021-05-31 Fixed small typo in MicroCode Table
    [MicroCodeRoms.ods]
2021-05-31 Logisim: Increased Stack+RAM size
    [psMCU.circ]
2021-05-31 First draft v1.0 schematic done, ready for verify
    [0Detect.sch, 12BitLED.sch, 14BitLED.sch, 15Bit_Reg.sch, 16BitLED.sch, 8BitLED.sch, 8Bit_Reg.sch, 9BitLED.sch]
2021-05-31 First ERC pass.
    [14BitLED.sch, 15Bit_Reg.sch, AdrComparator.sch, Breakpoint.sch, Clock.sch, Clock_Div.sch, Clock_Div_Ctrl.sch, Control.sch]
2021-05-31 Remote control work.
    [RemoteCtrl.kicad_pcb, RemoteCtrl.sch]
2021-05-31 Removed extra LEDs
    [14Bit_7Seg.sch, 15BitLed.sch, 15Bit_Reg.sch, 16Bit_7Seg.sch, 8Bit_7Seg.sch, 8bit7seg.sch, Control.sch, Control_Rom5.sch]
2021-05-31 Updated Page Descriptions
    [0Detect.sch, 8BitLED.sch, ALU.sch, BitTest.sch, Breakpoint.sch, Flag_Reg.sch, In0..7_RegB_to_RAMA.sch, LogicCOMP.sch]
2021-05-31 Simplified Barrel Shifter
    [0Detect.sch, 14BitLED.sch, 15BitLed.sch, 15Bit_Reg.sch, 8BitLED.sch, AdrComparator.sch, BarrelShifter.sch, BarrelShifter_Line.sch]
2021-05-31 Small Fixes + Schematic Layout
    [15Bit_Reg.sch, ALU.sch, BarrelShifter_Line.sch, Clock_Div_Ctrl.sch, Control.sch, Control_Rom.sch, In0..7_RegB_to_RAMA.sch, Inst0..7_to_DBus.sch]
2021-05-31 Simplified Power Input
    [PowerInput.sch]
2021-05-31 Small schematic fixes
    [8BitLED.sch, BarrelShifter_Line.sch, Control_Rom.sch, Control_Rom5.sch, LogicCOMP.sch, PowerInput.sch, ResetCtrl.sch, Sync_SR_FFsch.sch]
2021-05-31 Reduced Step Logic gate count
    [STEP_LOGIC.sch, SysReg_2.sch]
2021-05-31 Missing footprint (merge down)
    [STEP_LOGIC.sch]
2021-05-31 Have Bkpt reset with PWR_RESET not RESET
    [Breakpoint.sch, Sync_SR_FFsch.sch, UI.sch, psMCU.sch]
2021-05-31 Removed extra instruction LED
    [Breakpoint.sch, Clock_Div.sch, Clock_Osc.sch, Control_Rom.sch, Control_Rom5.sch, InstDisplay.sch, Sync_SR_FFsch.sch]
2021-05-31 Moved Interrupt address to different module.
    [0Detect.sch, 14BitLED.sch, 15BitLed.sch, 15Bit_Reg.sch, 16BitLED.sch, 8BitLED.sch, 8Bit_Reg.sch, 9BitLED.sch]
2021-05-31 Removed unnecessary ICs frpm SysReg_1
    [SysReg_1.sch]
2021-05-31 Fixed swapped ctrl signals to RegT
    [psMCU.sch]
2021-05-31 Fixed schematic comments
    [0Detect.sch, 14BitLED.sch, 15BitLed.sch, 15Bit_Reg.sch, 16BitLED.sch, 8BitLED.sch, 8Bit_Reg.sch, 9BitLED.sch]
2021-05-31 fixed incorrect part number
    [BarrelShifter_Line.sch, STEP_LOGIC.sch]
2021-05-31 Pulled in PCB without inter-block connections
2021-05-31 Power grid done
2021-05-31 Layout done + DRC pass
    [Stack.sch]
2021-05-31 Numpad: Schematic done + parts placed
    [Btn.sch, periph_numpad.kicad_pcb, periph_numpad.sch]
2021-05-31 Numpad: Layout done
    [periph_numpad.kicad_pcb]
2021-05-31 GPIO: Schematic done
    [ExtInterrupt.sch, Port.sch, periph_gpio.sch]
2021-05-31 GPIO: Layout done / ERC pass
    [ExtInterrupt.sch, Port.sch, RisingEdge_Detector.sch, periph_gpio.kicad_pcb, periph_gpio.sch]
2021-05-31 LEDs: Schematic + Layout done
    [Row.sch, periph_8x8leds.kicad_pcb, periph_8x8leds.sch]
2021-05-31 Fixed folder structure
    [Row.sch, periph_8x8leds.kicad_pcb, periph_8x8leds.sch]
2021-05-31 Generated psMCU v1.0 production files
    [0Detect.sch, 14BitLED.sch, 15BitLed.sch, 15Bit_Reg.sch, 16BitLED.sch, 8BitLED.sch, 8Bit_Reg.sch, 9BitLED.sch]
2021-05-31 Generated Programmer v1.0 production files
    [Programmer-B_Cu.gbr, Programmer-B_Mask.gbr, Programmer-B_Paste.gbr, Programmer-B_SilkS.gbr, Programmer-Edge_Cuts.gbr, Programmer-F_Cu.gbr, Programmer-F_Mask.gbr, Programmer-F_Paste.gbr]
2021-05-31 Finished RemoteCtrl pcb
    [RemoteCtrl.kicad_pcb, RemoteCtrl.sch]
2021-05-31 Generated RemoteCtrl v1.0 produciton files
    [RemoteCtrl-B_Cu.gbr, RemoteCtrl-B_Mask.gbr, RemoteCtrl-B_Paste.gbr, RemoteCtrl-B_SilkS.gbr, RemoteCtrl-Edge_Cuts.gbr, RemoteCtrl-F_Cu.gbr, RemoteCtrl-F_Mask.gbr, RemoteCtrl-F_Paste.gbr]
2021-05-31 Generated periph_numpad production files
    [Btn.sch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]
2021-05-31 Generated periph_8x8leds v1.0 production files
    [Row.sch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]
2021-05-31 Generated periph_gpio production files
    [ExtInterrupt.sch, Port.sch, RisingEdge_Detector.sch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]
2021-05-31 Added PCB Dimensions
    [RemoteCtrl.kicad_pcb]
2021-06-18 Recognise Assembly
2022-01-14 psASM: Changed @error printing
2022-02-13 Restored block layout
    [0Detect.sch, 14BitLED.sch, 15BitLed.sch, 15Bit_Reg.sch, 16BitLED.sch, 8BitLED.sch, 8Bit_Reg.sch, 9BitLED.sch]
2022-02-13 Sch: Fixed Stack Offset=1
    [Stack.sch]
2022-02-13 Sch: Fixed SYS1 Register
    [BTN_TOGGLE.sch, BTN_TRIG.sch, Sync_SR_FFsch.sch, SysReg_1.sch]
2022-02-13 Sch: Removed Regulator, Added extra spread bulk C
    [15Bit_Reg.sch, ALU.sch, BarrelShifter.sch, Control.sch, In0..13_to_ROMA.sch, Interrupts.sch, LogicAND.sch, LogicCOMP.sch]
2022-02-13 Sch: Changed LDD behaviour (now is literal+b)
    [BTN_TRIG.sch, Control.sch, In0..7_RegB_to_RAMA.sch, Interrupts.sch, RegI.sch, STEP_LOGIC.sch, Sync_SR_FFsch.sch, psMCU.sch]
2022-02-14 Updated Tables with new LDO/SVO instructions
    [DecodeROM.ods, InstructionSet.ods, MicroCodeRoms.ods]
2022-02-14 Logisim: Changed to new SVO/LDO instructions
    [psMCU.circ]
2022-02-15 Sch: Reworked Peripheral Interface (Buffers)
    [0Detect.sch, 14BitLED.sch, 15BitLed.sch, 15Bit_Reg.sch, 16BitLED.sch, 8BitLED.sch, 8Bit_Reg.sch, 9BitLED.sch]
2022-02-17 Logisim: Implemented new statemachine
    [MicroCodeRoms.ods, psMCU.circ]
2022-02-17 Logisim: Increased RAM page count, changed SYS registers
    [psMCU.circ]
2022-02-18 Sch: Increased RAM page count, changed SYS registers
    [15Bit_Reg.sch, PowerInput.sch, RAM.sch, Stack.sch, Sync_SR_FFsch.sch, SysReg_1.sch, SysReg_2.sch, psMCU.sch]
2022-02-18 Sch: Improved Clk/Reset distribution, moved to global labels
    [0Detect.sch, 14BitLED.sch, 15BitLed.sch, 15Bit_Reg.sch, 16BitLED.sch, 8BitLED.sch, 8Bit_Reg.sch, 9BitLED.sch]
2022-02-18 Logisim: Removed PC->DBus bridge, rely on IAdr for CALL/RTRN
    [MicroCodeRoms.ods, psMCU.circ]
2022-02-18 Sch: Implemented new Statemachine
    [0Detect.sch, 14BitLED.sch, 15BitLed.sch, 15Bit_Reg.sch, 16BitLED.sch, 8BitLED.sch, 8Bit_Reg.sch, 9BitLED.sch]
2022-02-18 Sch: Changed Clock Stepping to be simpler and more robust.
    [BTN_TOGGLE.sch, Clock.sch, Clock_Step.sch, UI.sch]
2022-02-19 Sch: Implemented much improved debugger interface
    [0Detect.sch, 14BitLED.sch, 15BitLed.sch, 15Bit_Reg.sch, 16BitLED.sch, 8BitLED.sch, 8Bit_Reg.sch, 9BitLED.sch]
2022-02-19 Sch: Addded Buffer for external interrupt assert
    [PeripheralInterface.sch, Reg.sch, RegI.sch, psMCU.sch]
2022-02-19 Fixed InstructionSet.ods to use LDO/SDO instructions
    [InstructionSet.ods]
2022-02-20 Logisim: Modified instruction set to add fast memory access functions.
    [DecodeROM.ods, InstructionSet.ods, MicroCodeRoms.ods, psMCU.circ]
2022-02-20 Sch: Modified instruction set to add fast memory access functions.
    [0Detect.sch, 14BitLED.sch, 15BitLed.sch, 16BitLED.sch, 8BitLED.sch, 8Bit_Reg.sch, 9BitLED.sch, ALU.sch]
2022-02-20 Sch: Cleanup + Small fixes
    [0Detect.sch, 14BitLED.sch, 15BitLed.sch, 16BitLED.sch, 8BitLED.sch, 8Bit_Reg.sch, 9BitLED.sch, ALU.sch]
2022-02-20 Sch: More cleanup, fixed page descriptions.
    [0Detect.sch, 14BitLED.sch, 15BitLed.sch, 16BitLED.sch, 8BitLED.sch, 8Bit_Reg.sch, 9BitLED.sch, ALU.sch]
2022-02-20 Sch: More cleanup
    [8BitLED.sch, AdrComparator.sch, BTN_TOGGLE.sch, BTN_TRIG.sch, Clock.sch, Control.sch, LogicOps.sch, SubInst_Step.sch]
